txoof/npec-camera-rig/README.md

# NPEC Camera Rig

Plant growth monitoring for an environmental chamber. Runs on a Raspberry Pi 5 with a top-down
Arducam 64MP camera and a Hailo AI accelerator, and serves a web interface directly from the Pi.

## What it does

- Captures the growth table on a schedule (10–60 frames/hour)
- Measures **canopy area** per growth tray
- Tracks **tray identity, position and rotation** via AprilTags
- Reports **how much to trust each measurement**, and refuses to guess when the rig has been moved
- Produces timelapses and CSV exports for experimenters

## Status

**M1 slice 1 (skeleton) done.** See [PLAN.md](PLAN.md) and [TODO.md](TODO.md).

## Setup

Dependencies are managed with [`uv`](https://docs.astral.sh/uv/). The venv must use the system
Python interpreter, not one `uv` downloads itself — `picamera2` is a system package, and
`--system-site-packages` only works if the venv's Python version matches the one it was installed
against.

```bash
uv venv --system-site-packages --python /usr/bin/python3 .venv
uv pip install -e ".[dev]"
```

Use `uv run` for everything after that — no need to activate the venv:

```bash
uv run pytest
uv run uvicorn npec_rig.app:app --reload --reload-dir src --timeout-graceful-shutdown 5 \
    --host 0.0.0.0 --port 8000
```

`--reload-dir src` keeps `WatchFiles` from watching the whole repo tree (it otherwise reloads on
unrelated activity elsewhere in the checkout). `--timeout-graceful-shutdown 5` bounds the
"Waiting for connections to close" reload hang — a browser continuously polling an endpoint (the
live preview, the focus aid) keeps a connection in-flight indefinitely, so the default unbounded
wait never resolves on its own; this caps it at 5 s instead of requiring a manual browser refresh.

Not yet installed as a systemd service — see `deploy/npec-rig.service`.

## Hardware

The rig's printed mounts and OpenSCAD models live in [`hardware/`](hardware/). See
[hardware/README.md](hardware/README.md) for printing the tray tags, the AprilTag corner mounts
(production's outer table edge) and how to export multi-color prints, and [hardware/Installation.md](hardware/Installation.md) for installing the
rig in the chamber.

## The one thing to read before contributing

This project has been attempted three times and collapsed into camera metrology each time — lens
models, distortion coefficients, uncertainty propagation — without ever producing a working
application.

The governing principle is in PLAN.md and it is short:

> **Certainty is measured, never derived.** If a number can't be demonstrated with a ruler, a
> printed target, or a repeated observation, it doesn't ship.

Techniques like intrinsic calibration and orthorectification aren't forbidden because they're
unsound. They're deferred behind **evidence gates** — each has a specific measurement that would
justify picking it up. Read that section before proposing one.

A worked example of why this matters, from the previous attempt's own calibration data:

| Error source | Magnitude in area |
|---|---|
| Believing the old rig's tags were the 30 mm printed on the box (they measured 29.31 mm) | **~4.7%** |
| Tag corner-finding precision | ~0.15% |
| Segmentation edge ambiguity | several % |

The largest geometric error in the system was solved with a pair of callipers. The lesson is
"measure each printed sheet", not "tags are 29.31 mm": the current sheets measure 30.0 mm.

## Testing

The fast tier is the default and the expensive tiers are opt-in, by construction:

```bash
pytest                 # unit only — no hardware, budget <10s
pytest -m hardware     # needs the camera
pytest -m hailo        # needs the accelerator
pytest -m integration  # full pipeline against fixture images
pytest -m slow         # soak
```

**Do not run tests for documentation changes.** The previous attempt spent 223 seconds of every
303-second run decoding 64MP frames. See the test-tier table in PLAN.md for what to run when.
