txoof/npec-camera-rig/docs/figures/16.8/tray6-miss-100253.jpg

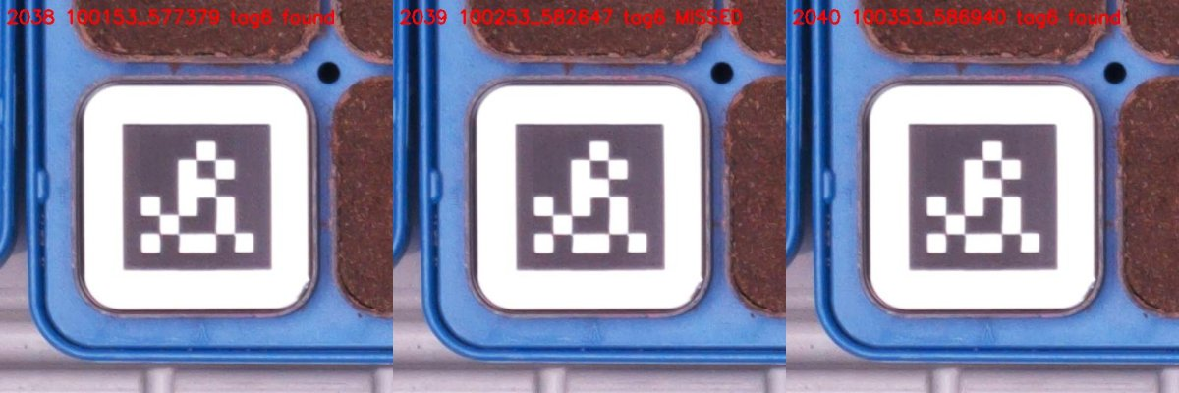
docs/figures/16.8/tray6-miss-100253.jpg
