txoof/npec-camera-rig/docs/figures/17.12/084953-tags.jpg

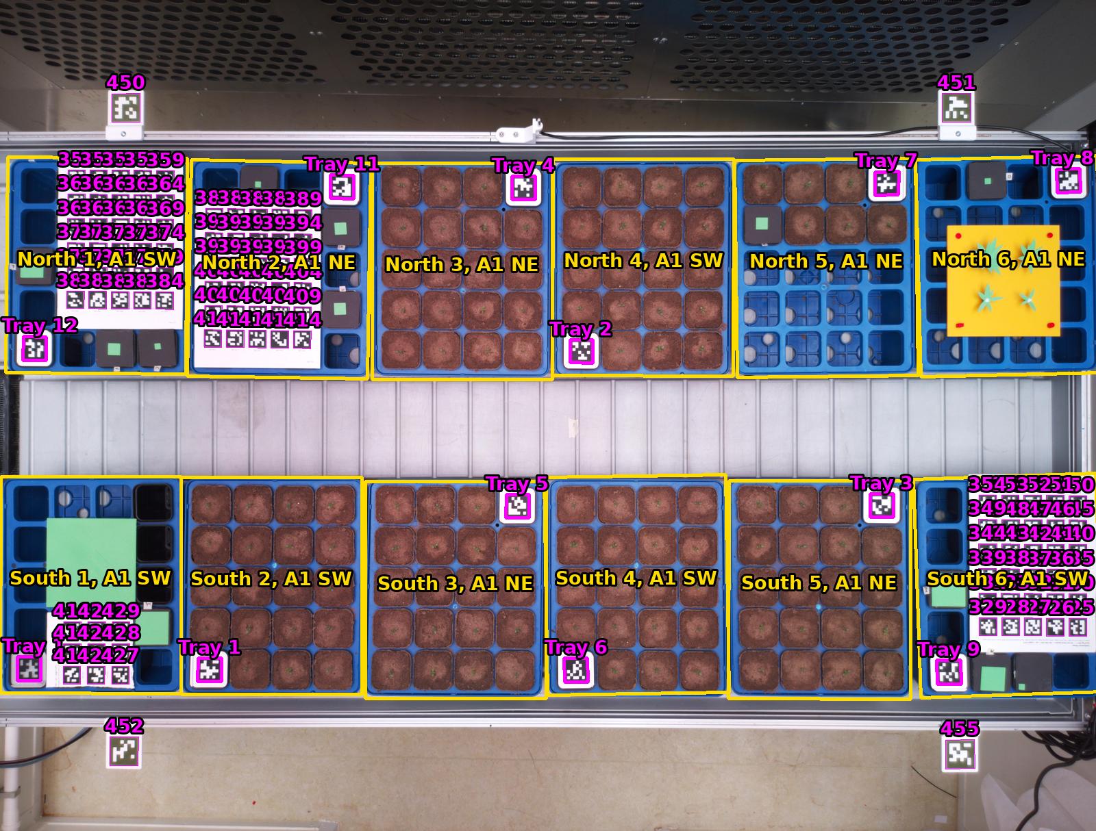
docs/figures/17.12/084953-tags.jpg
