txoof/npec-camera-rig/docs/figures/17.12/095753-tags.jpg

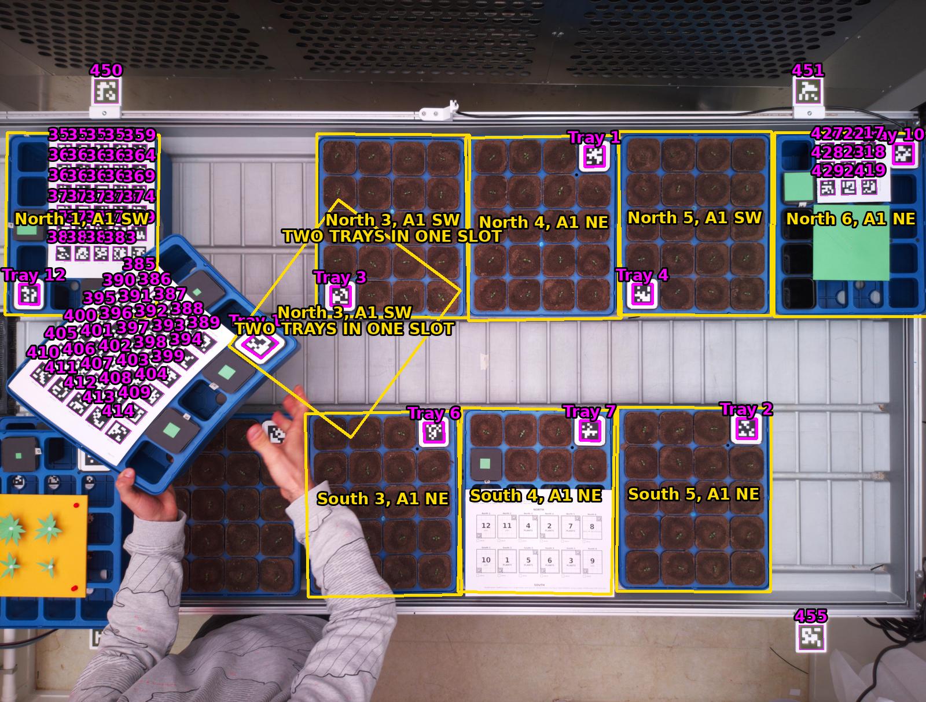
docs/figures/17.12/095753-tags.jpg
