txoof/npec-camera-rig/docs/figures/17.13/142a6558-corners-beads.jpg

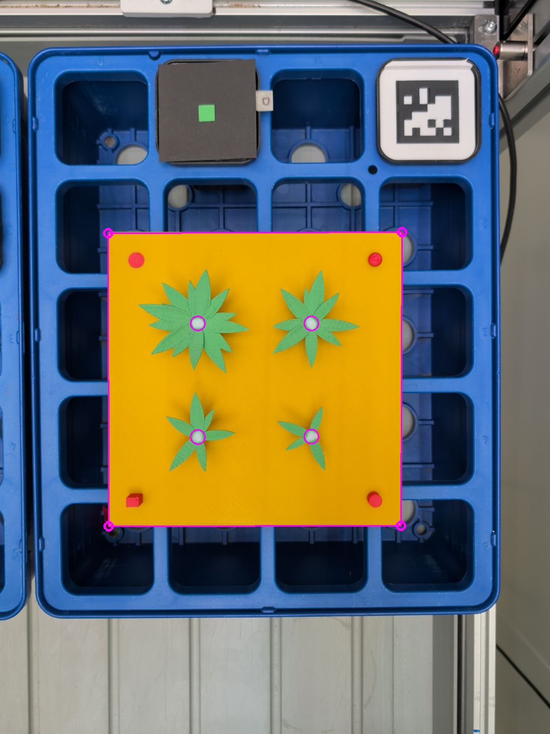
docs/figures/17.13/142a6558-corners-beads.jpg
