txoof/npec-camera-rig/docs/figures/17.13/baee65e4-corners-beads.jpg

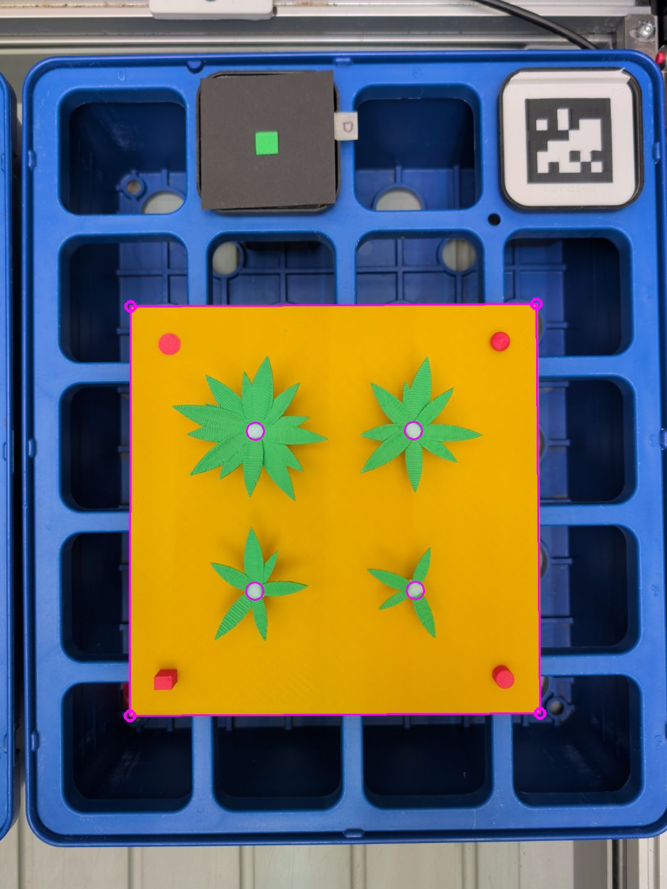
docs/figures/17.13/baee65e4-corners-beads.jpg
