txoof/npec-camera-rig/docs/figures/18/squares-open-crops.jpg

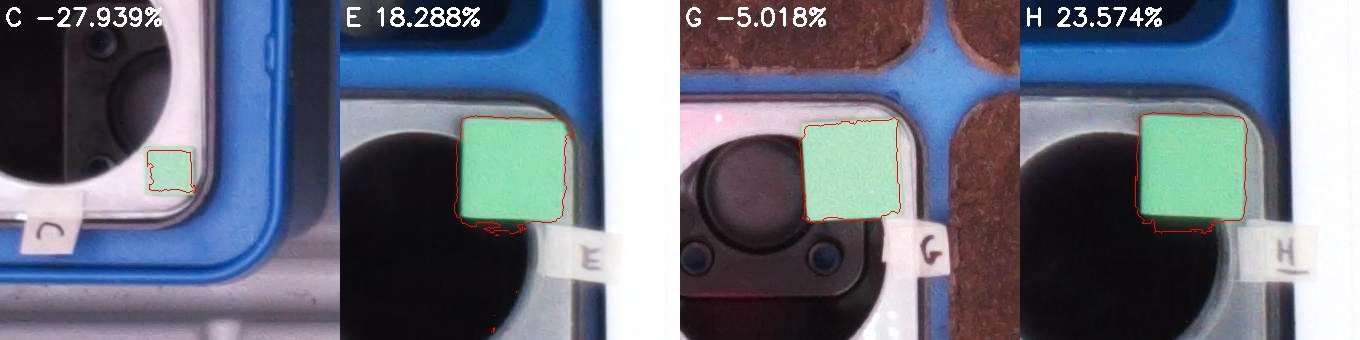
docs/figures/18/squares-open-crops.jpg
