txoof/npec-camera-rig/docs/figures/18/squares-paper-crops.jpg

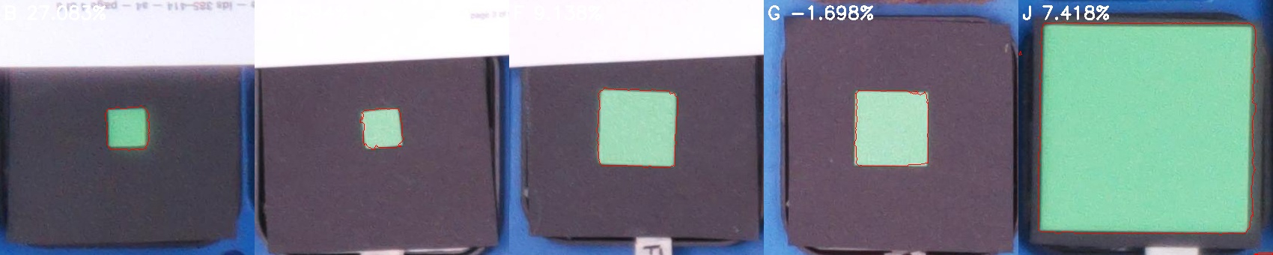
docs/figures/18/squares-paper-crops.jpg
