txoof/npec-camera-rig/docs/figures/18/tag-edges-against-spacing.png

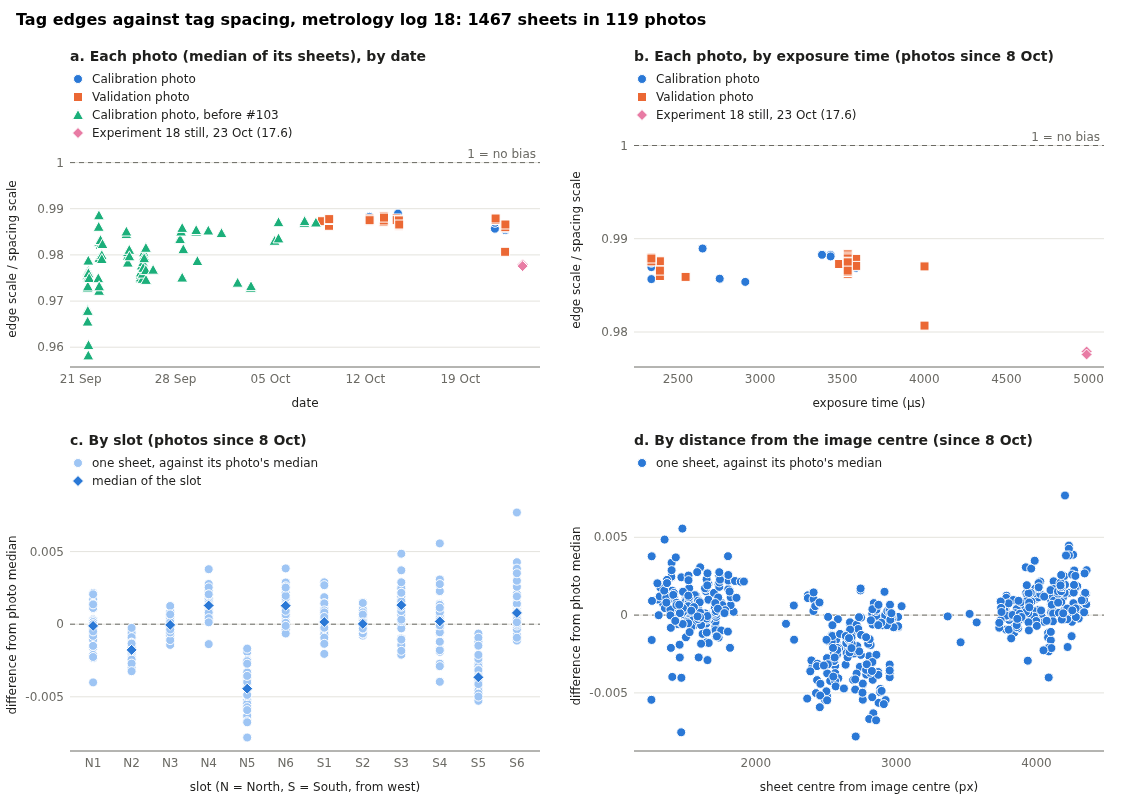
docs/figures/18/tag-edges-against-spacing.png
