txoof/npec-camera-rig/docs/figures/18/target-edges-2026-10-23.png

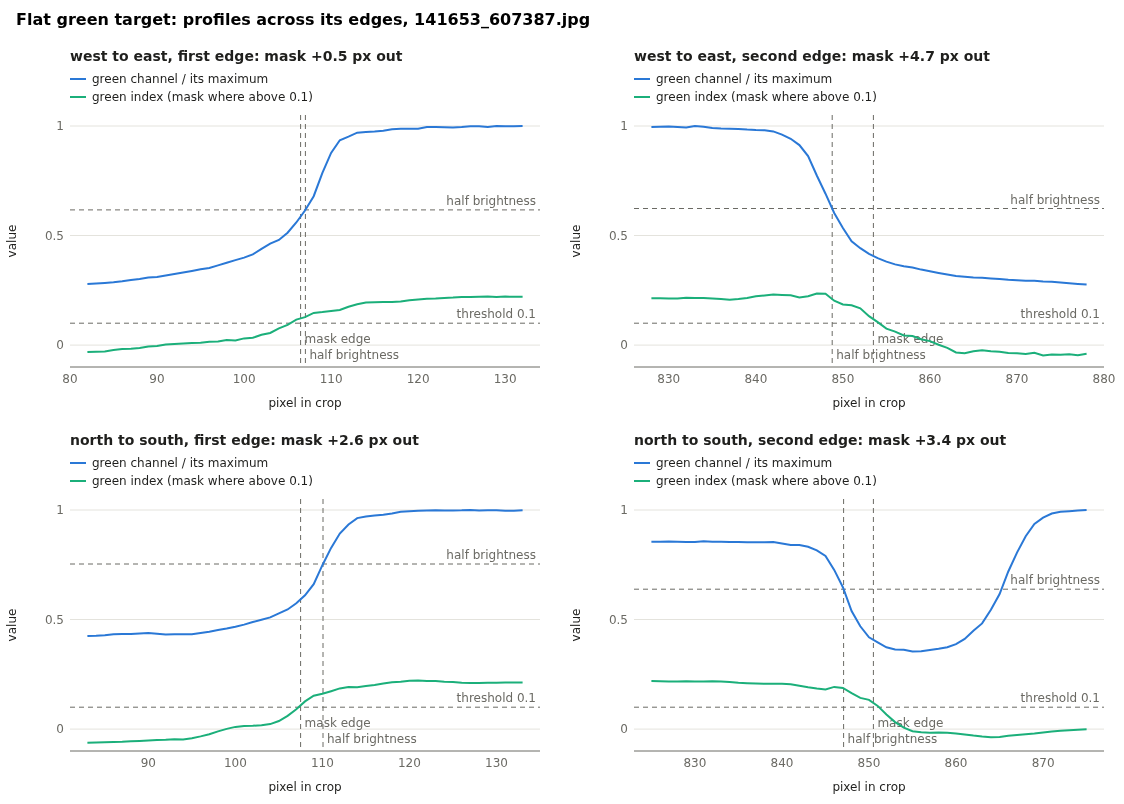
docs/figures/18/target-edges-2026-10-23.png
