txoof/npec-camera-rig/docs/figures/19.1/benchy-sam21.jpg

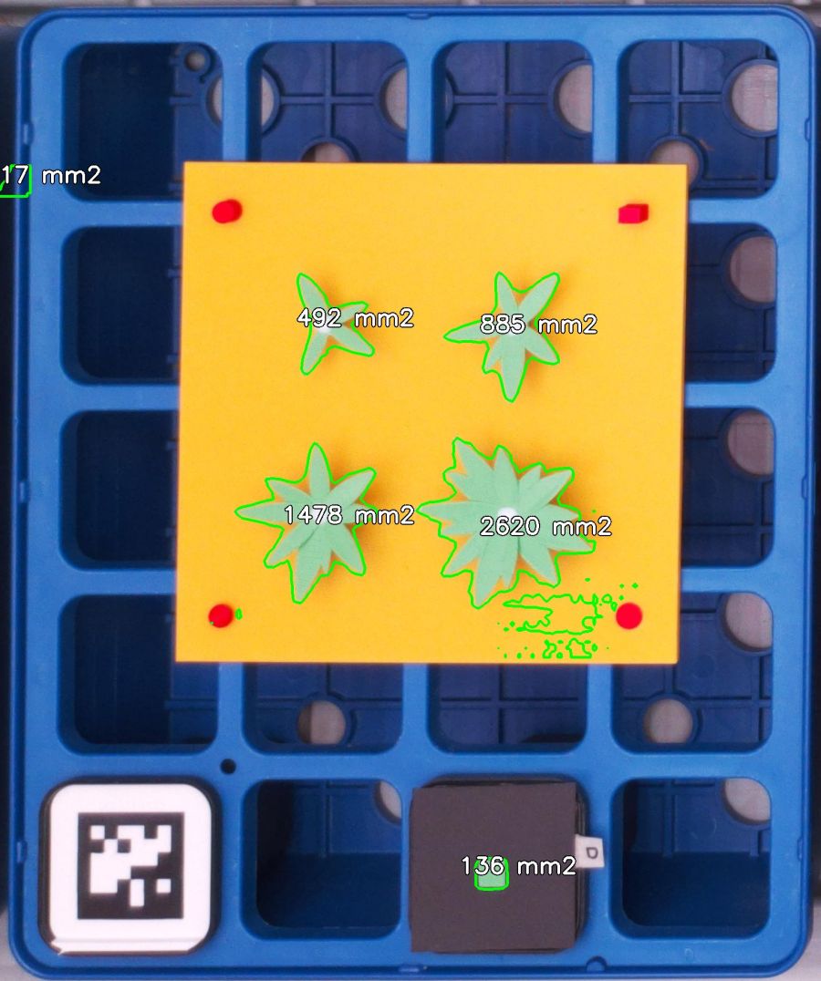
docs/figures/19.1/benchy-sam21.jpg
