txoof/npec-camera-rig/docs/figures/19.1/clip-leaves.jpg

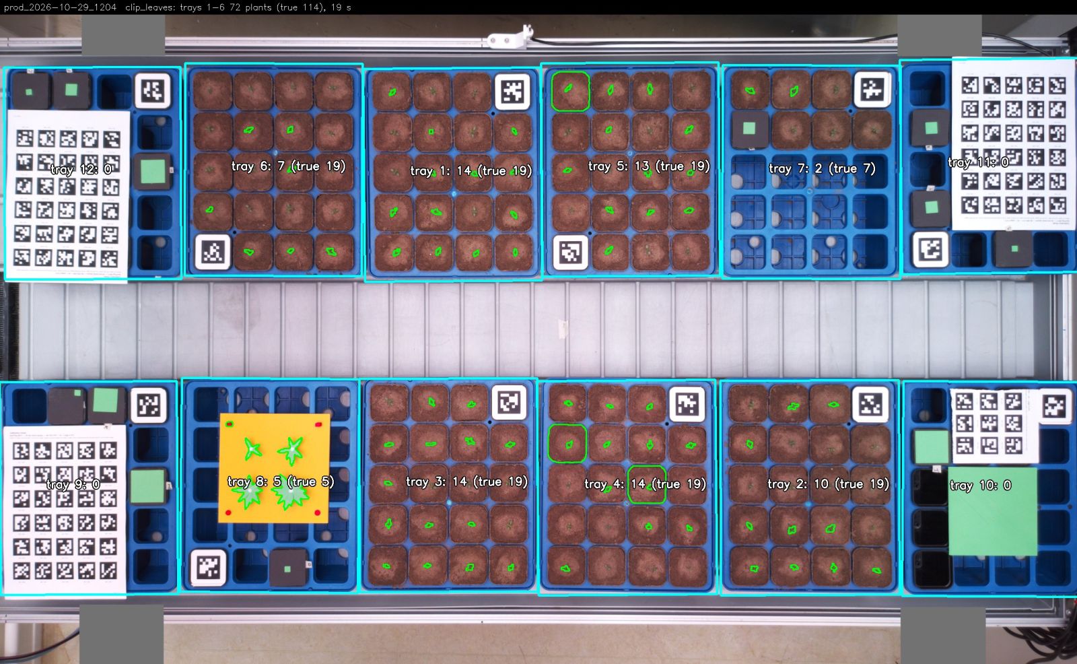
docs/figures/19.1/clip-leaves.jpg
