txoof/npec-camera-rig/docs/figures/19.3/dev-2x2-exg-join10.jpg

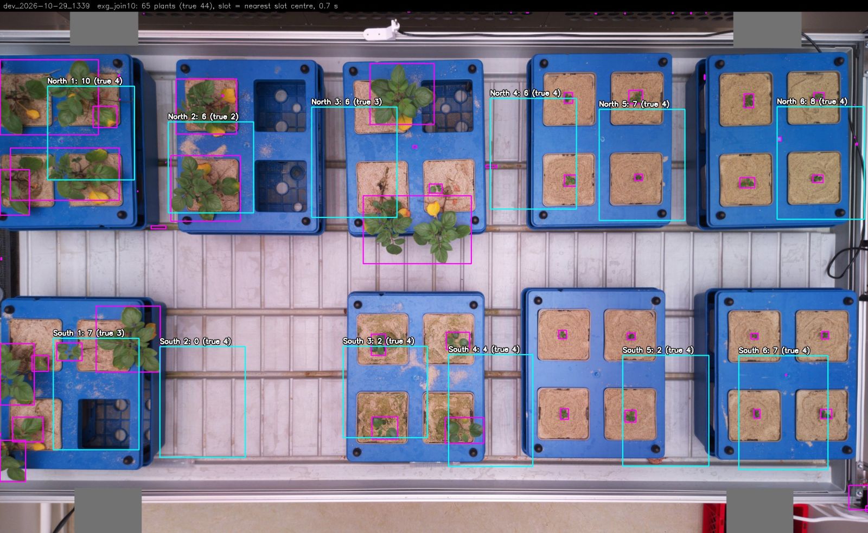
docs/figures/19.3/dev-2x2-exg-join10.jpg
