txoof/npec-camera-rig/docs/figures/20.1/held-09-prod_44a9e96e_20261015_120350_220119.jpg

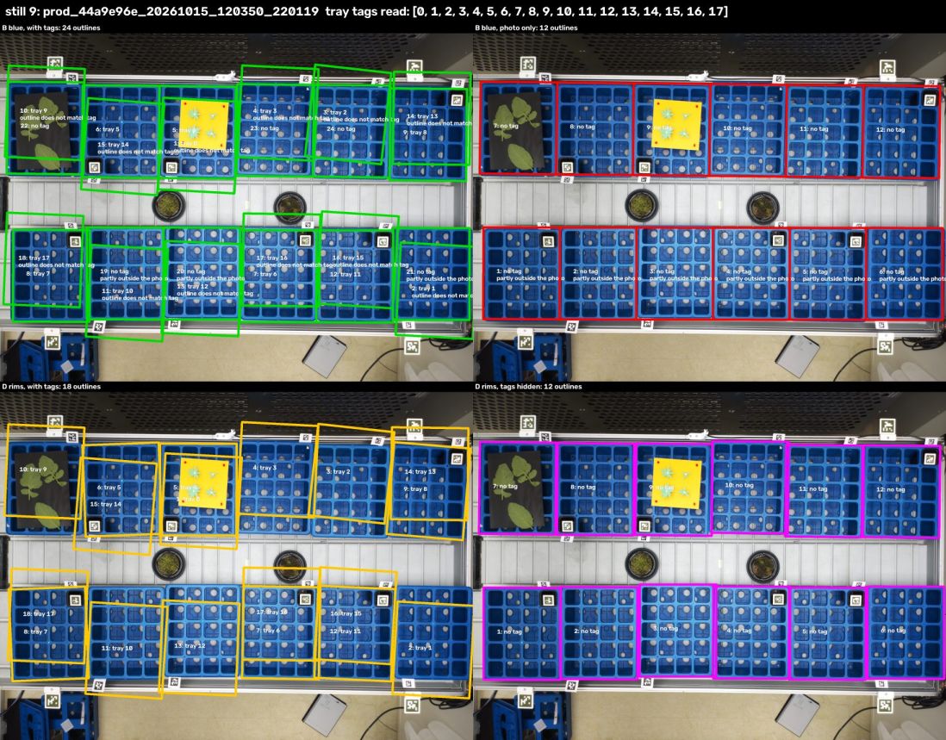
docs/figures/20.1/held-09-prod_44a9e96e_20261015_120350_220119.jpg
