txoof/npec-camera-rig/docs/figures/20.1/held-14-prod_631bb6b5_20261012_133117_986053.jpg

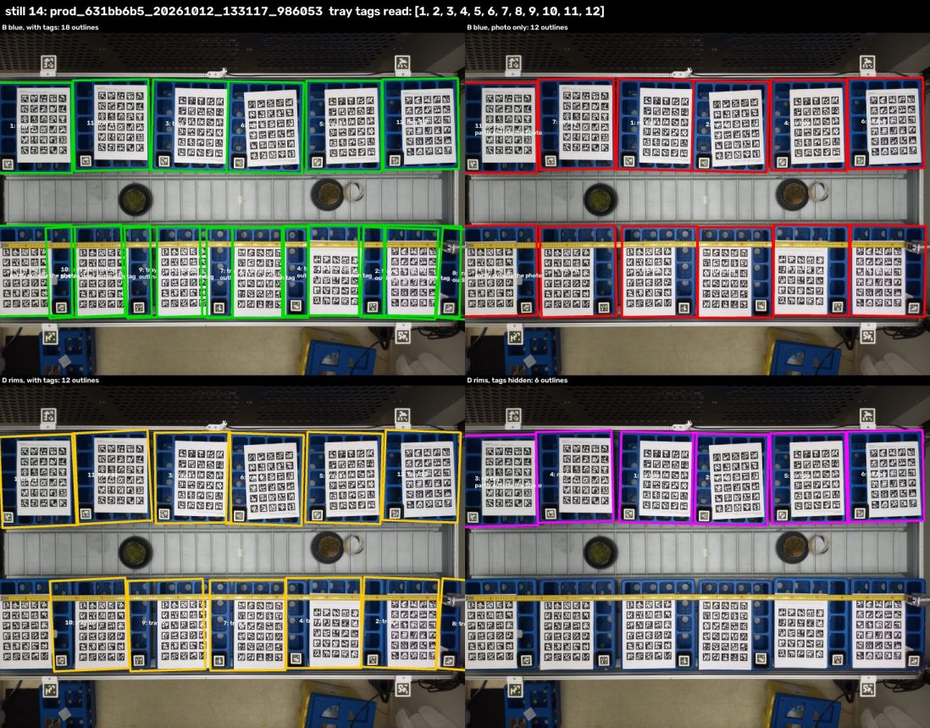
docs/figures/20.1/held-14-prod_631bb6b5_20261012_133117_986053.jpg
