txoof/npec-camera-rig/docs/figures/20/sheet-hard-121231_081714.jpg

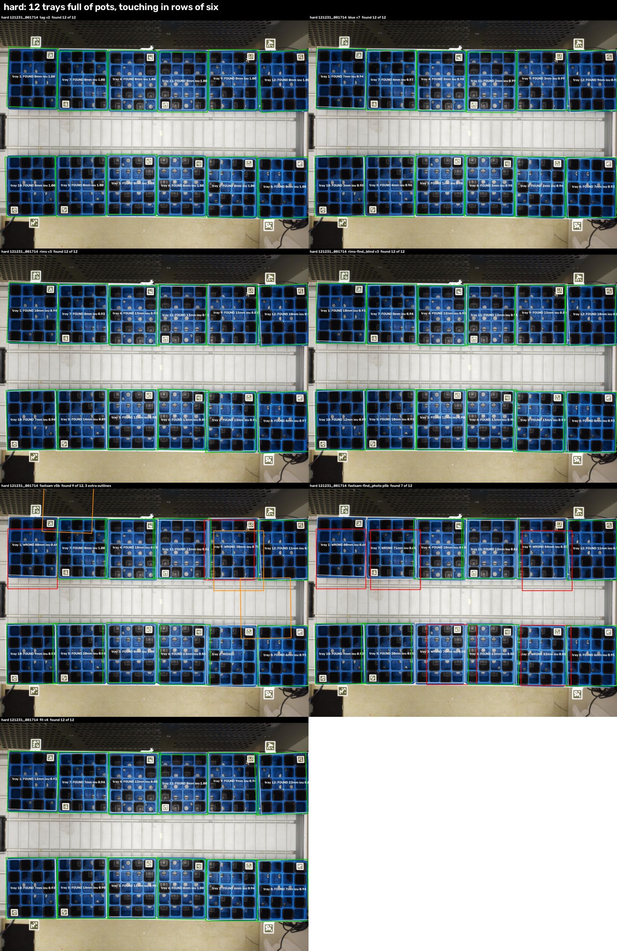
docs/figures/20/sheet-hard-121231_081714.jpg
