txoof/npec-camera-rig/docs/figures/21/dimming-false-outline.jpg

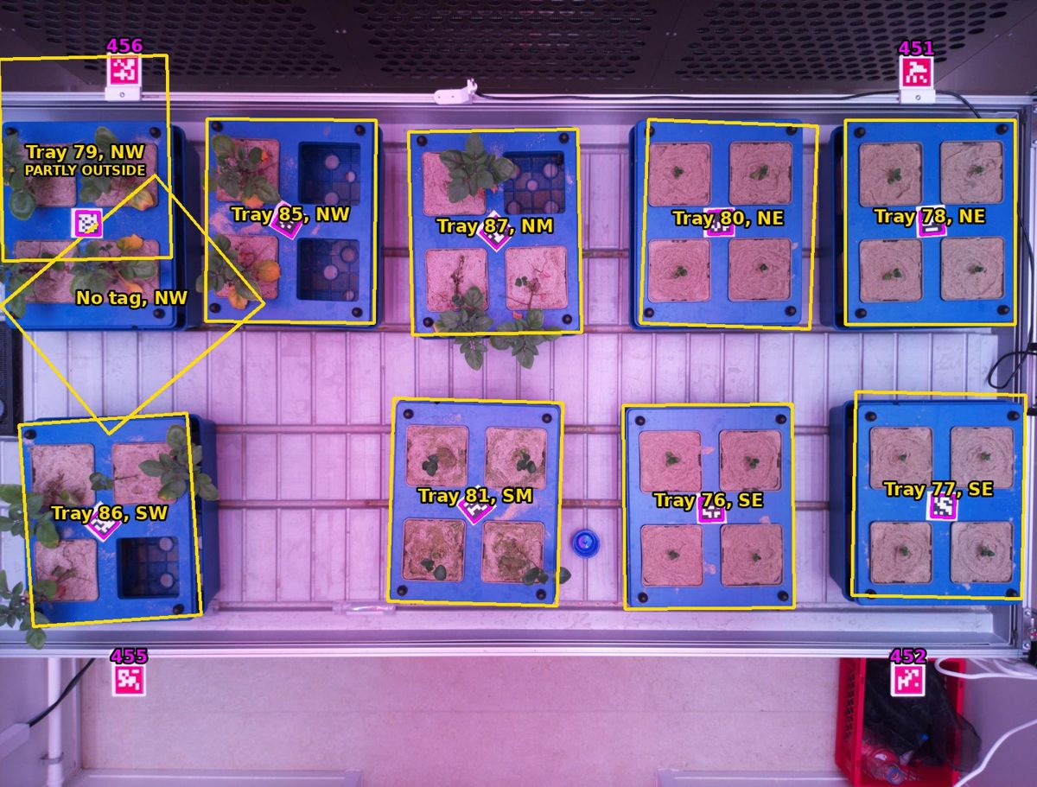
docs/figures/21/dimming-false-outline.jpg
