txoof/npec-camera-rig/docs/figures/21/edge-tags-seen.jpg

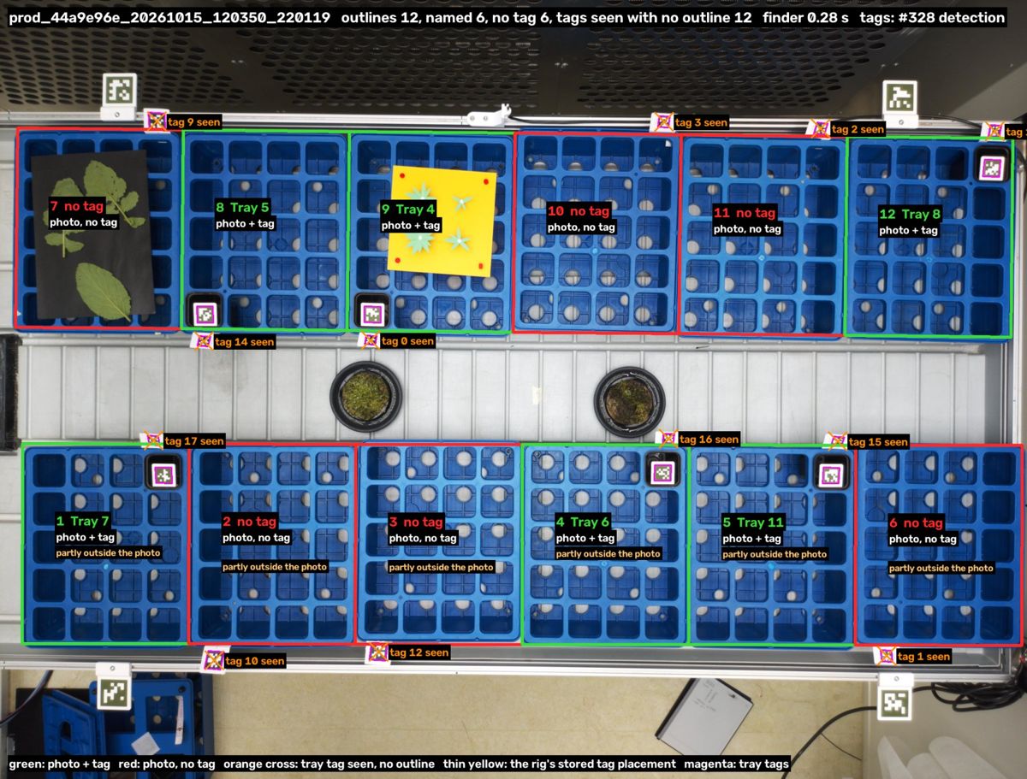
docs/figures/21/edge-tags-seen.jpg
