txoof/npec-camera-rig/docs/figures/21/false-outline-aisle.jpg

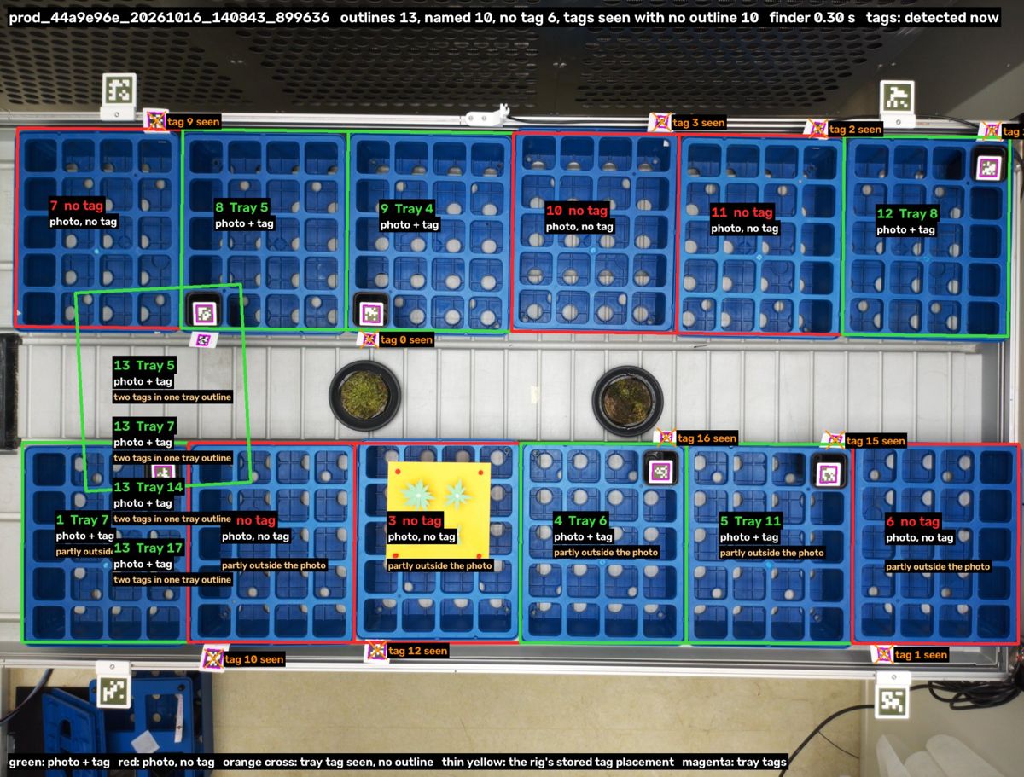
docs/figures/21/false-outline-aisle.jpg
