txoof/npec-camera-rig/docs/figures/21/live-person-over-tray-86.jpg

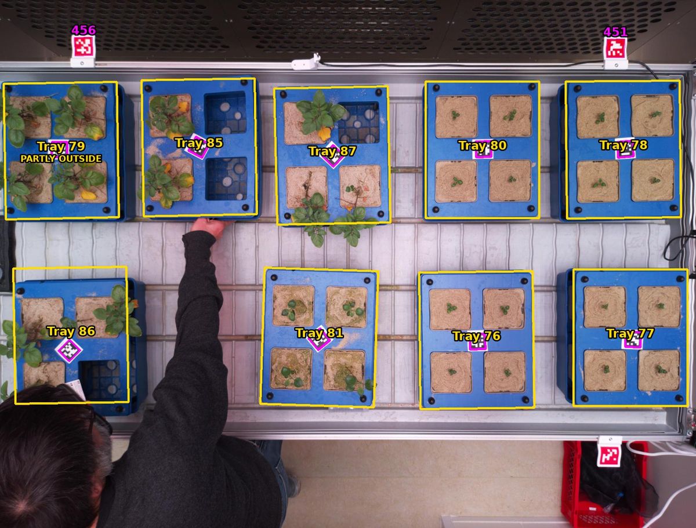
docs/figures/21/live-person-over-tray-86.jpg
