txoof/npec-camera-rig/docs/figures/21/prod-agrees.jpg

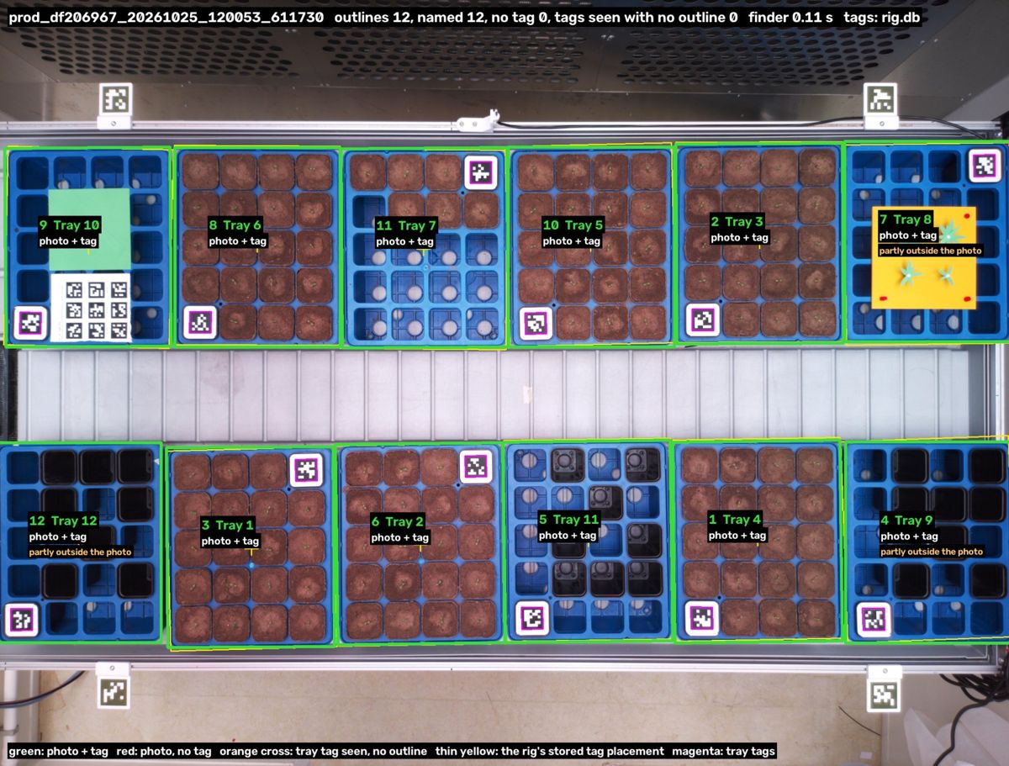
docs/figures/21/prod-agrees.jpg
