txoof/npec-camera-rig/docs/figures/22/areas_on_photo.png

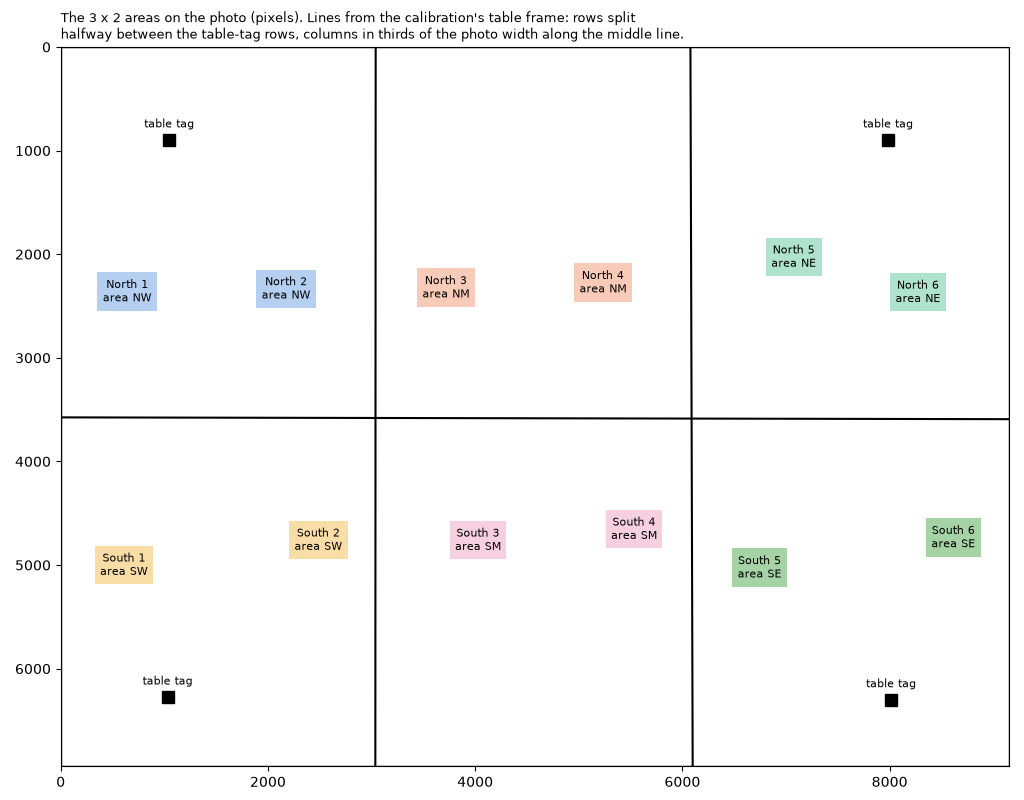
docs/figures/22/areas_on_photo.png
