txoof/npec-camera-rig/docs/figures/22/comparison.png

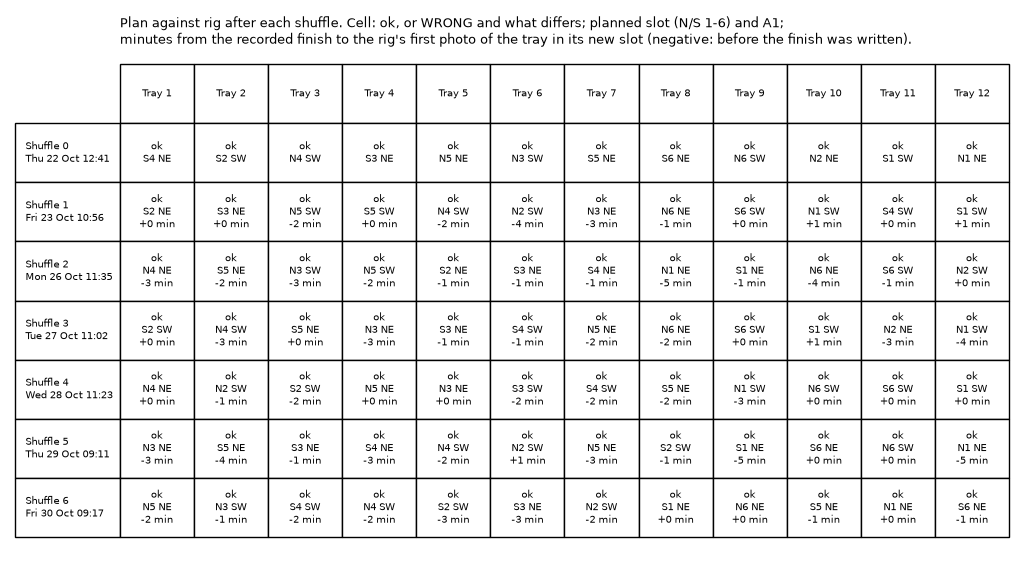
docs/figures/22/comparison.png
