txoof/npec-camera-rig/docs/figures/22/timelines_trays_1-6.png

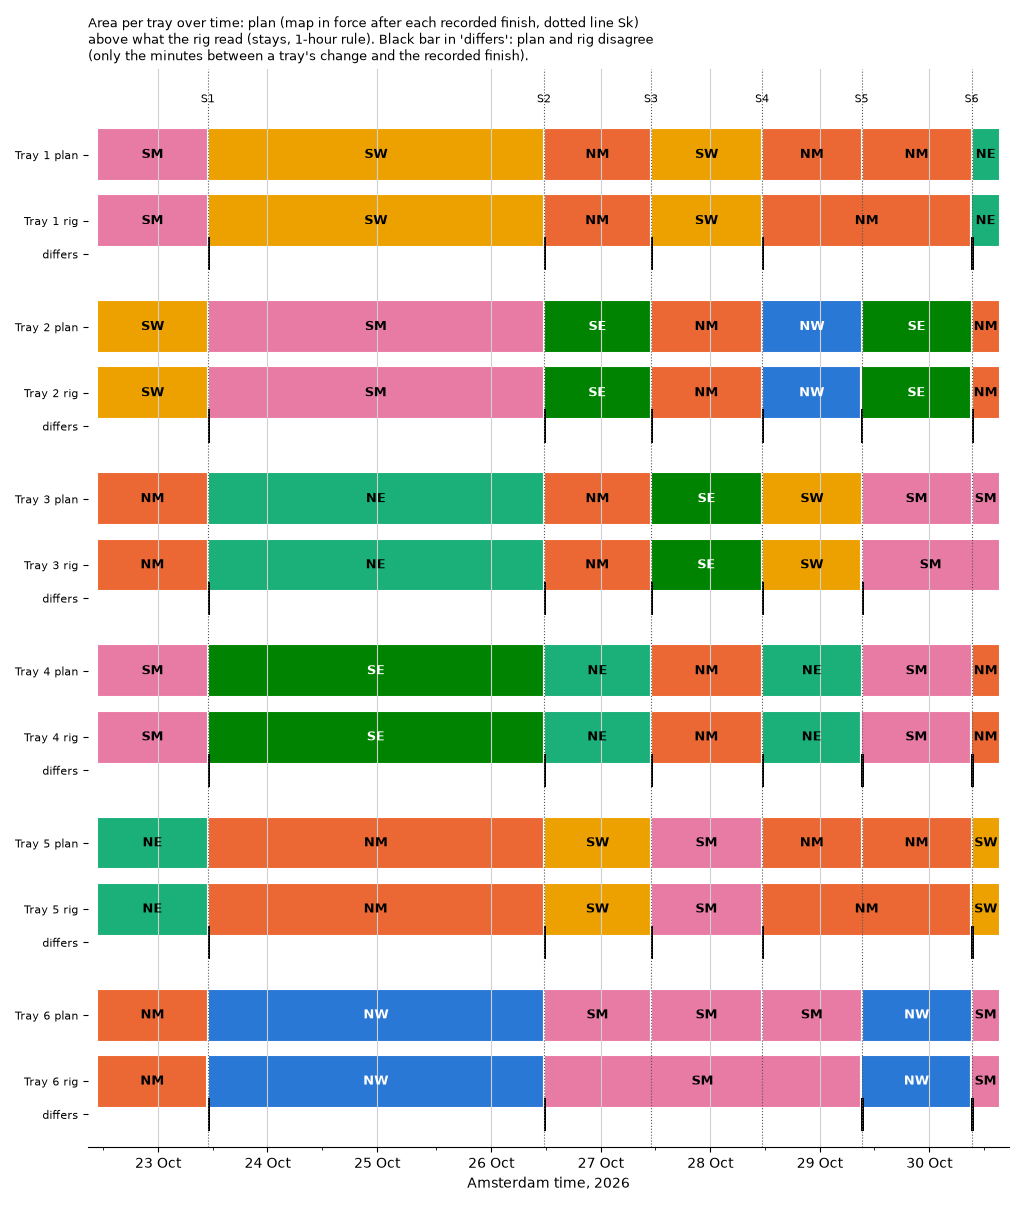
docs/figures/22/timelines_trays_1-6.png
