txoof/npec-camera-rig/docs/figures/22/timelines_trays_7-12.png

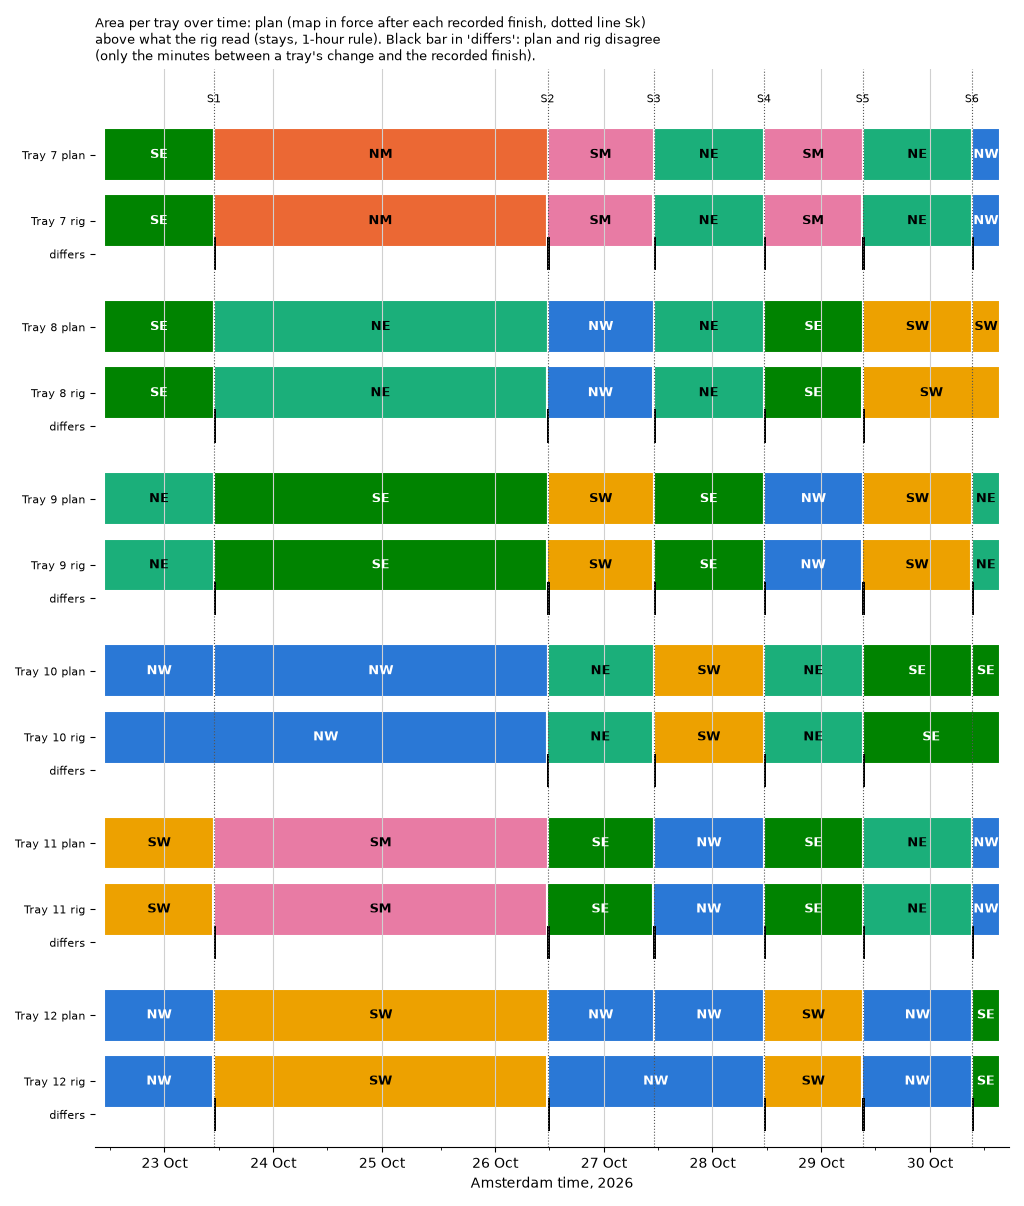
docs/figures/22/timelines_trays_7-12.png
