txoof/npec-camera-rig/docs/figures/24.1/fixed-low-cutoff-tray1.jpg

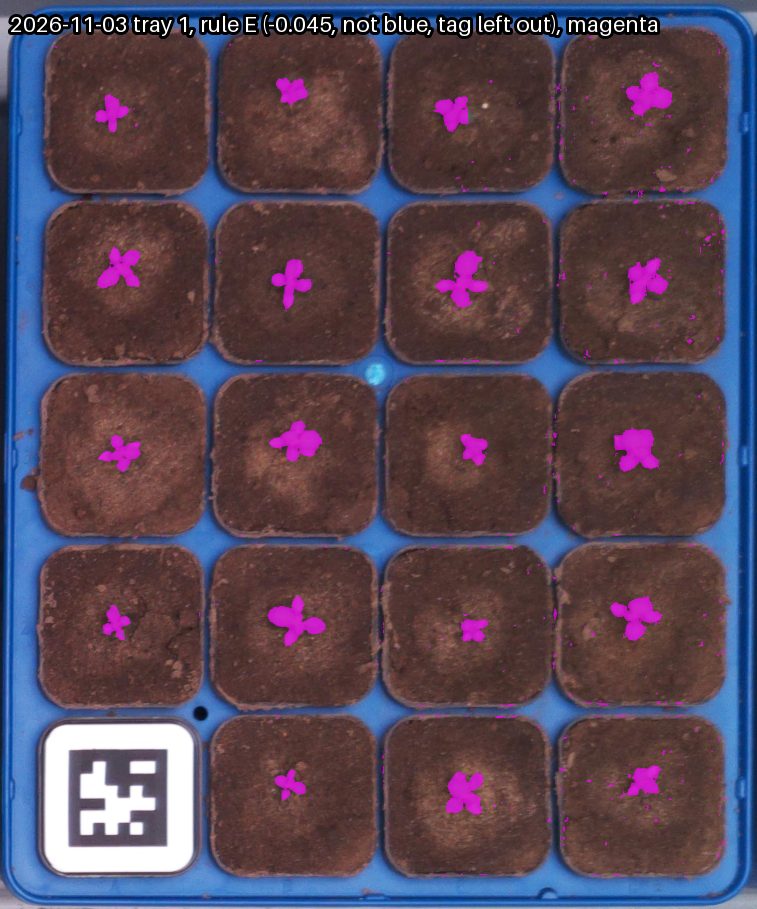
docs/figures/24.1/fixed-low-cutoff-tray1.jpg
