txoof/npec-camera-rig/docs/figures/24.2/grow-from-cores-tray3.jpg

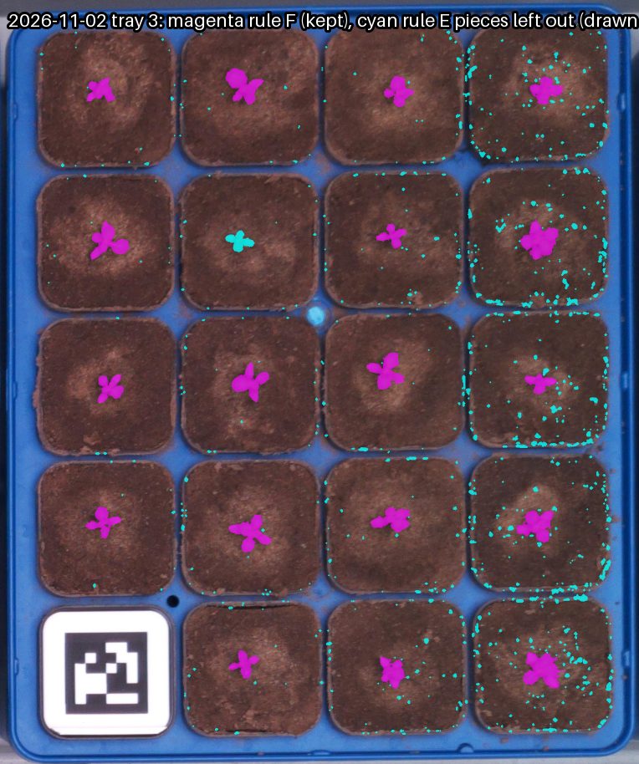
docs/figures/24.2/grow-from-cores-tray3.jpg
