txoof/npec-camera-rig/docs/figures/24.2/tray3-plants-numbered.jpg

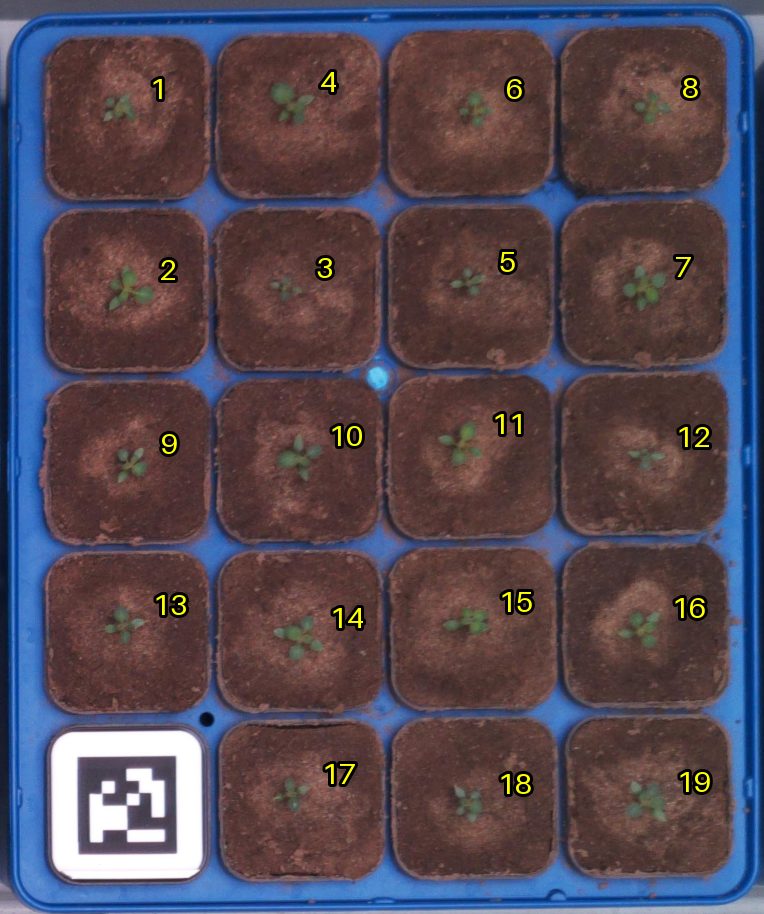
docs/figures/24.2/tray3-plants-numbered.jpg
