txoof/npec-camera-rig/docs/figures/24.3/lost-regions.jpg

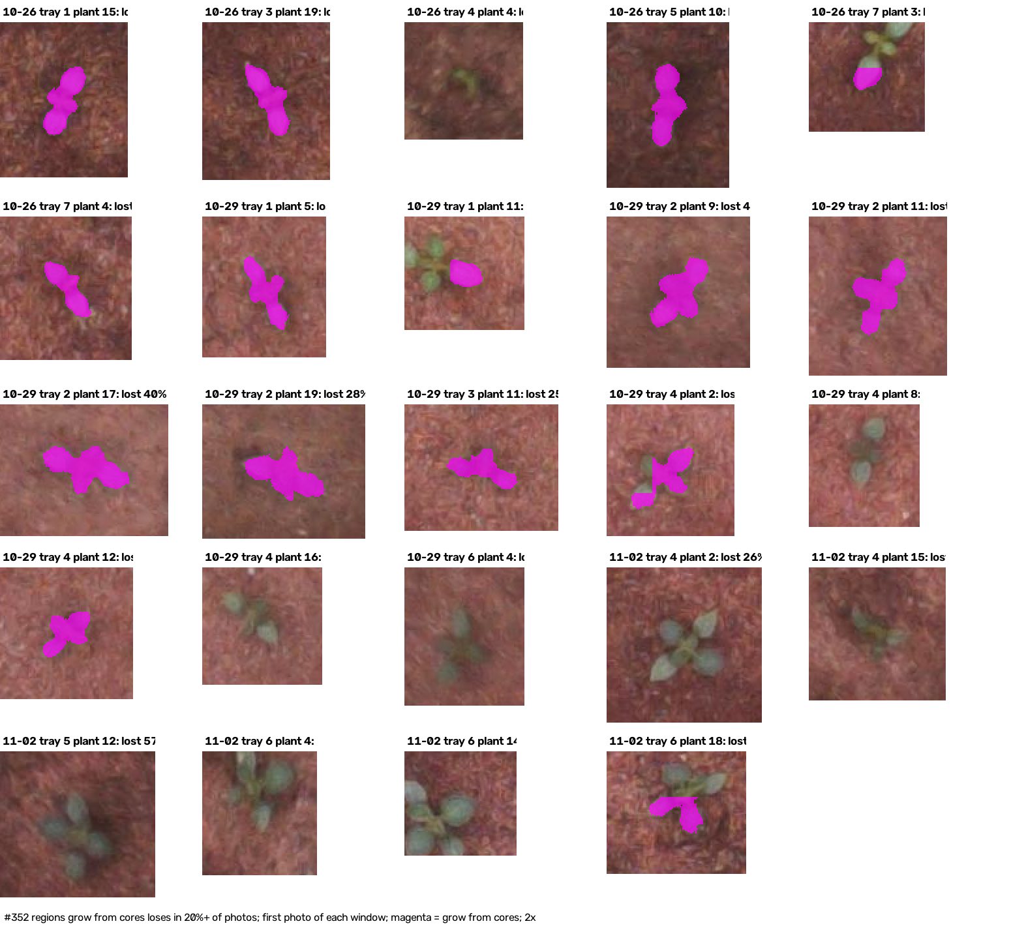
docs/figures/24.3/lost-regions.jpg
