txoof/npec-camera-rig/docs/figures/24.4/tray7-before-after.jpg

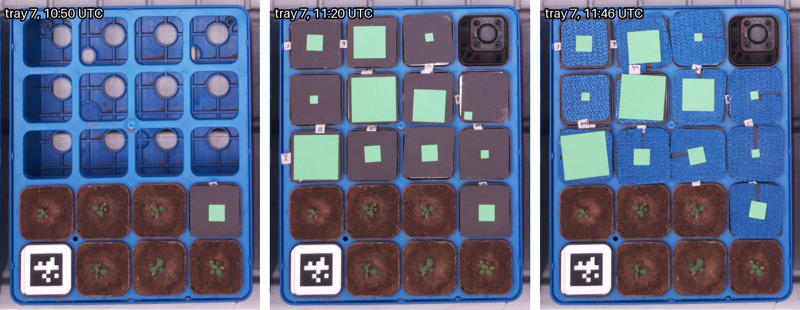
docs/figures/24.4/tray7-before-after.jpg
