txoof/npec-camera-rig/docs/figures/24.5/sam-vs-grow.jpg

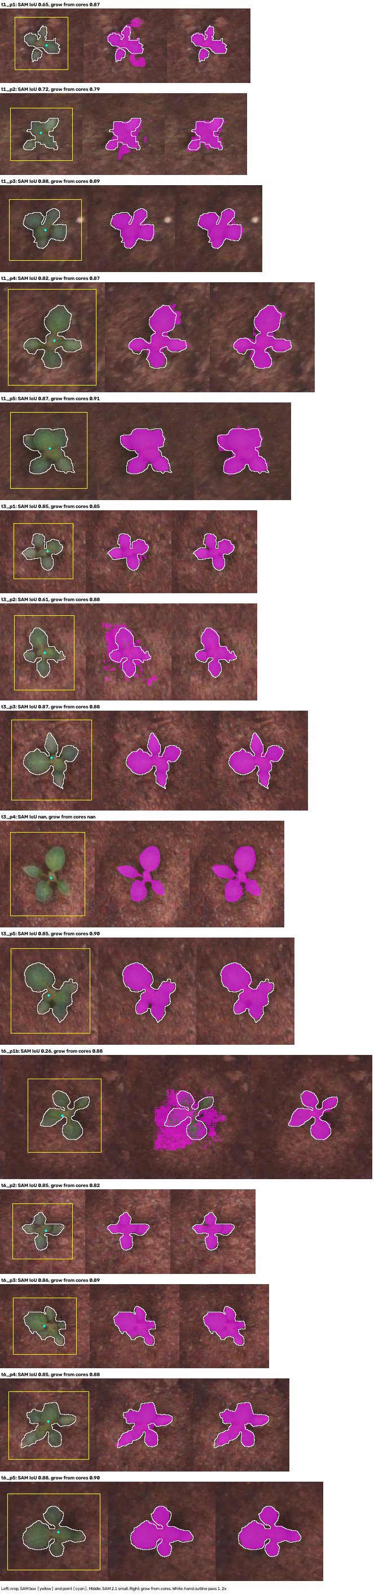
docs/figures/24.5/sam-vs-grow.jpg
