txoof/npec-camera-rig/docs/figures/24.6/tray87-grow-diff.jpg

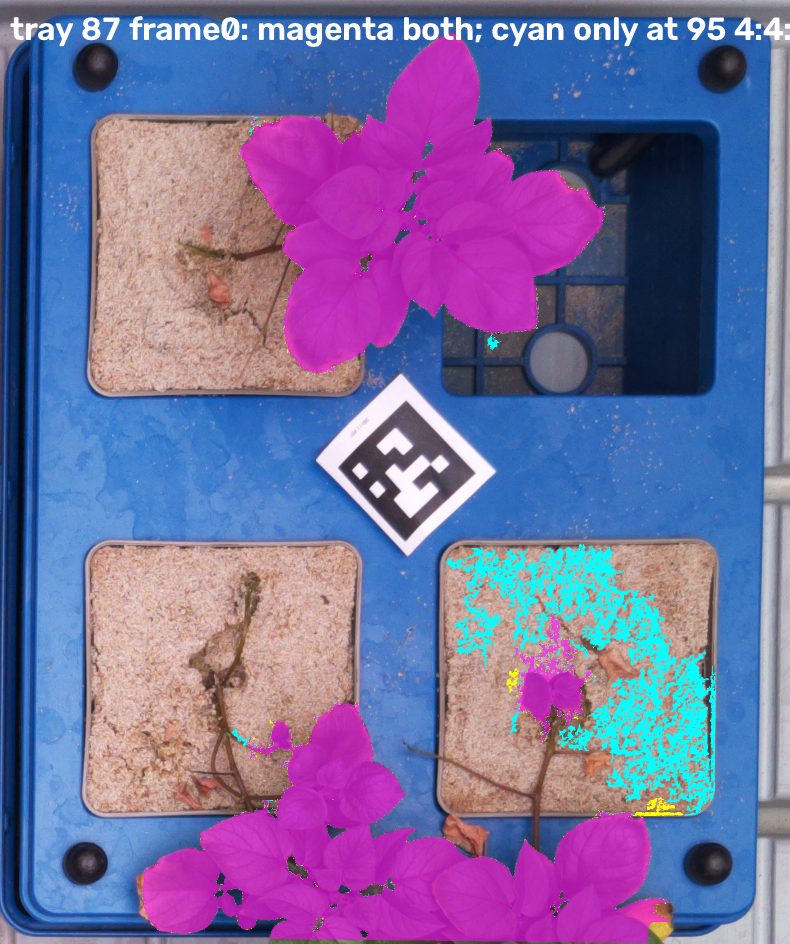
docs/figures/24.6/tray87-grow-diff.jpg
