txoof/npec-camera-rig/docs/figures/24.7/dev-grow-vs-rule-g.jpg

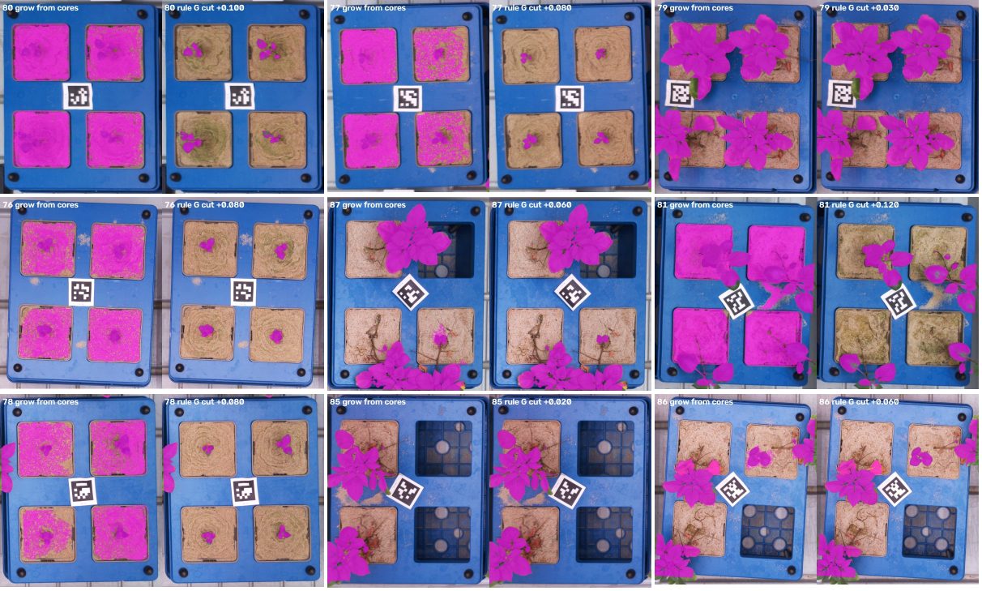
docs/figures/24.7/dev-grow-vs-rule-g.jpg
