txoof/npec-camera-rig/docs/figures/24/rules-sheet-1.jpg

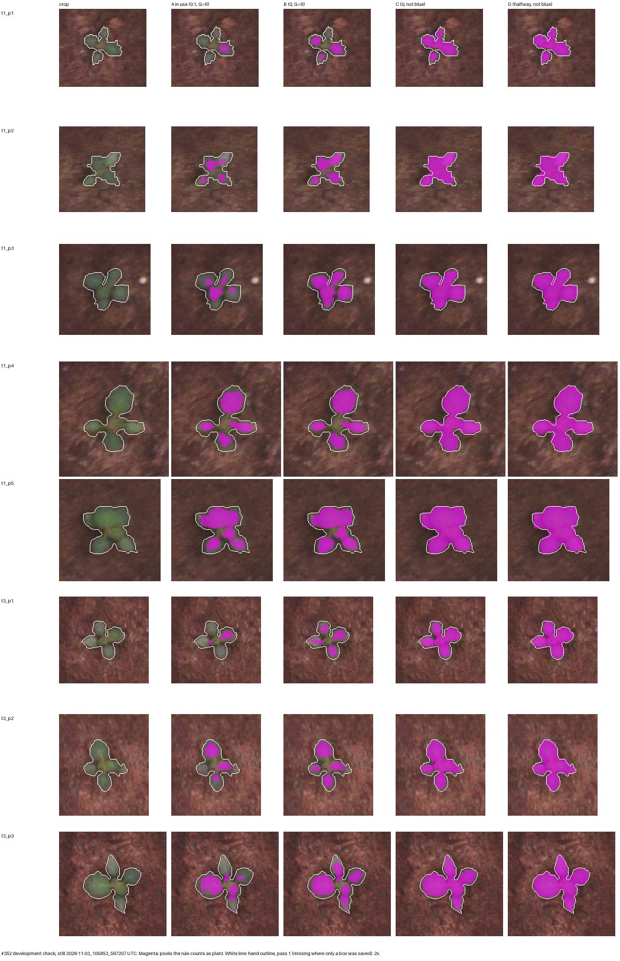
docs/figures/24/rules-sheet-1.jpg
