txoof/npec-camera-rig/docs/figures/24/rules-sheet-2.jpg

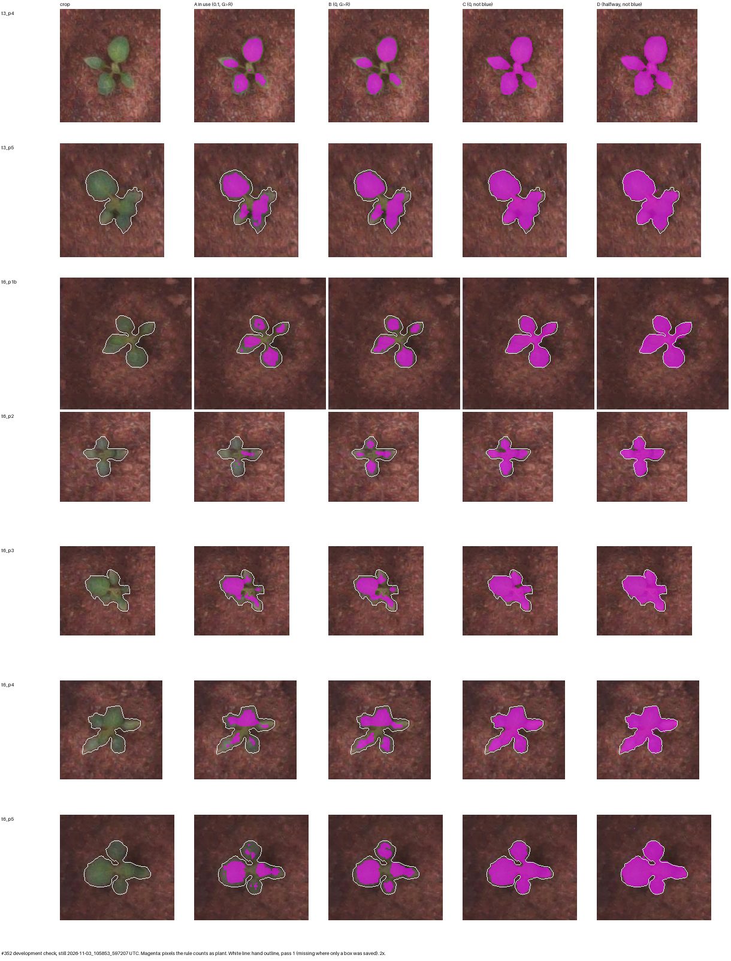
docs/figures/24/rules-sheet-2.jpg
