txoof/npec-camera-rig/docs/figures/26/crop-tray77.png

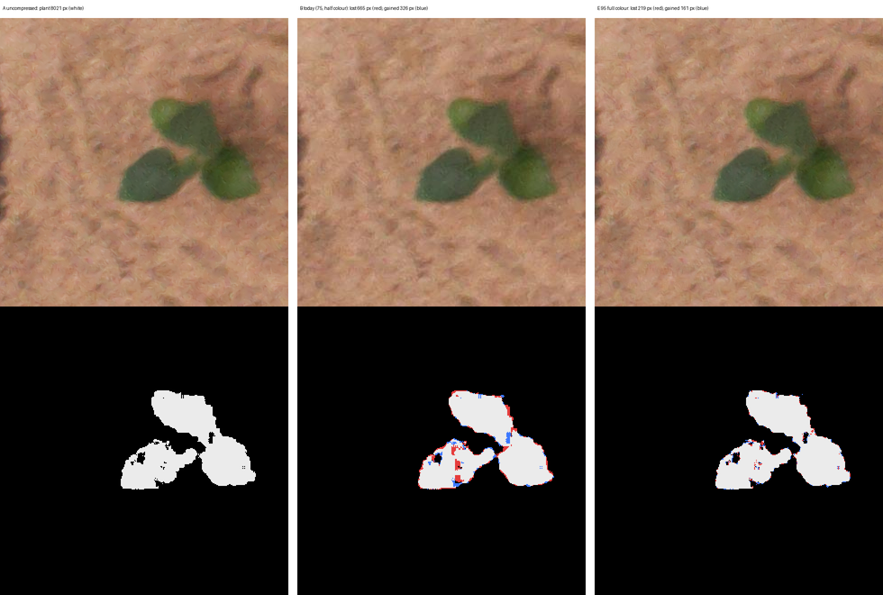
docs/figures/26/crop-tray77.png
