txoof/npec-camera-rig/docs/figures/27.4/dev-cells-placed.jpg

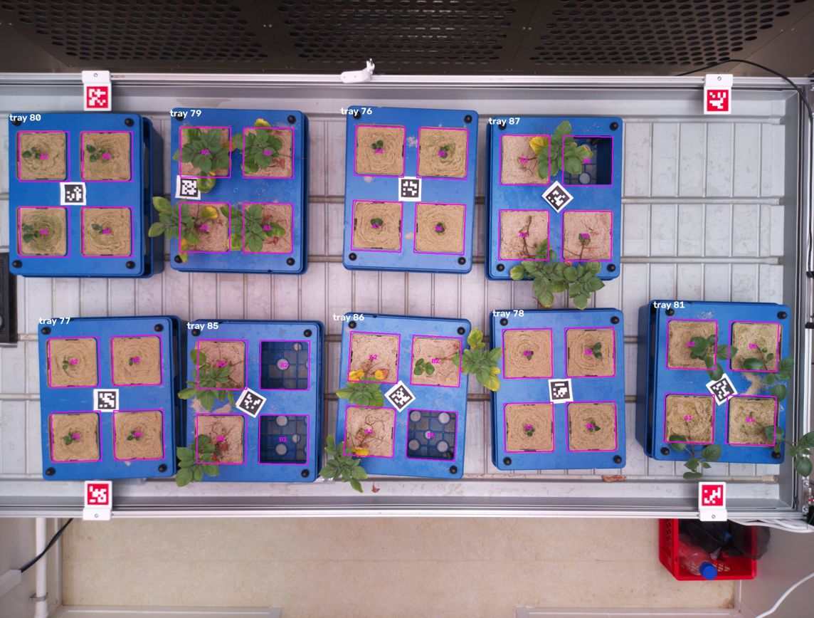
docs/figures/27.4/dev-cells-placed.jpg
