txoof/npec-camera-rig/docs/figures/27.4/prod-cells-placed.jpg

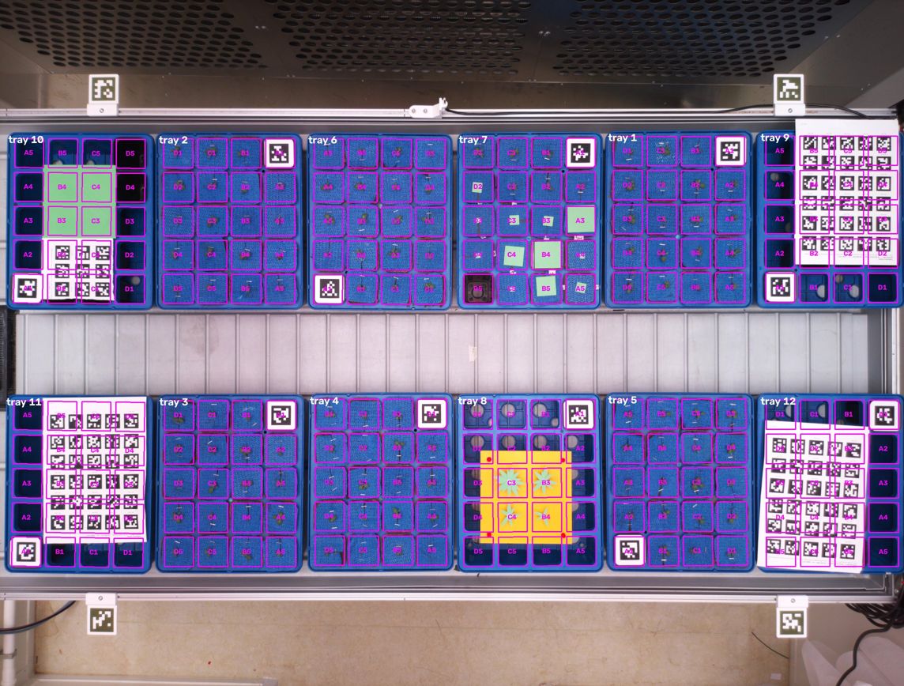
docs/figures/27.4/prod-cells-placed.jpg
