txoof/npec-camera-rig/docs/figures/28/empty-cell-fringe.png

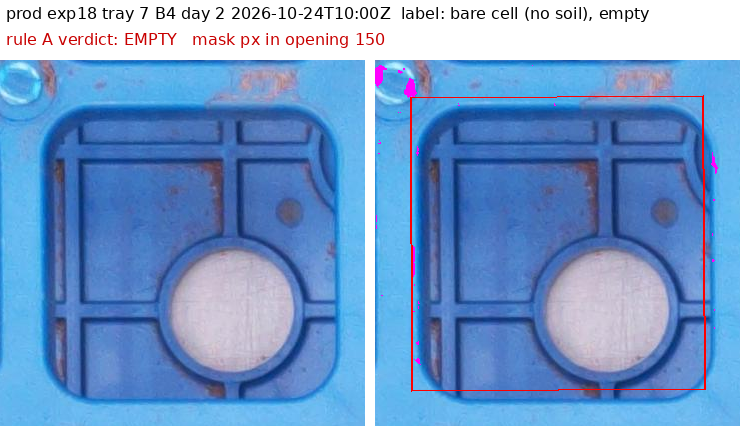
docs/figures/28/empty-cell-fringe.png
