txoof/npec-camera-rig/docs/figures/28/pieces-blue-green.png

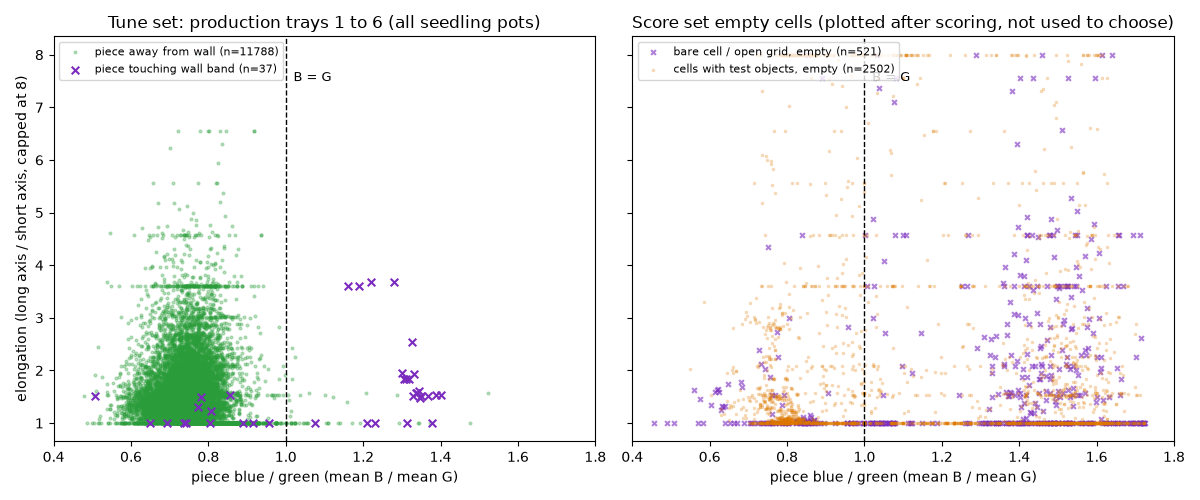
docs/figures/28/pieces-blue-green.png
