txoof/npec-camera-rig/docs/figures/29/29.2-corner-tags.png

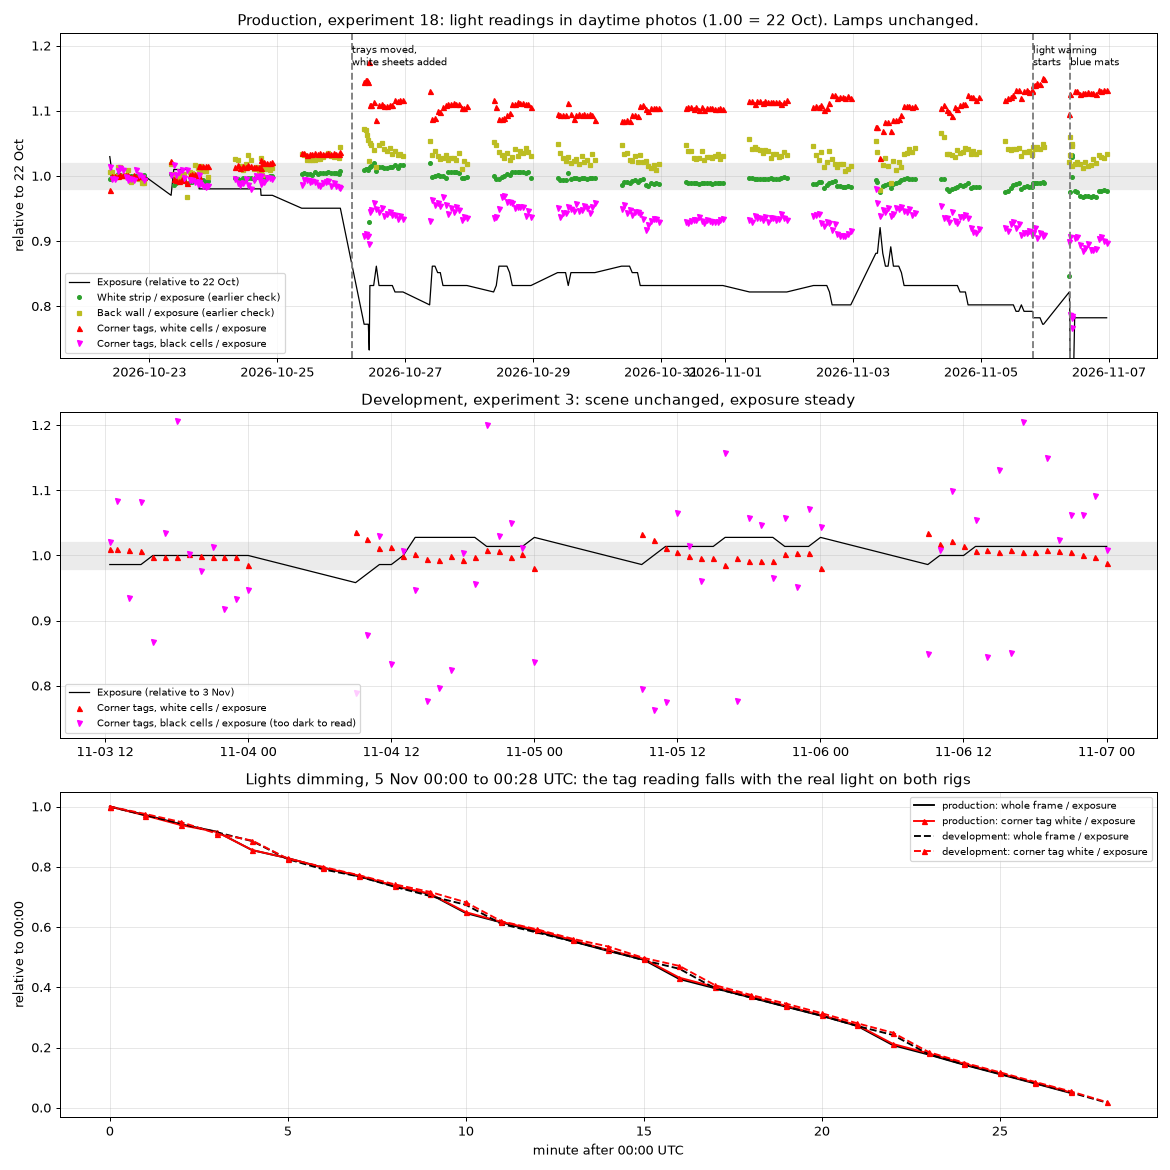
docs/figures/29/29.2-corner-tags.png
