txoof/npec-camera-rig/docs/figures/30/pot-names-trays-81-86.jpg

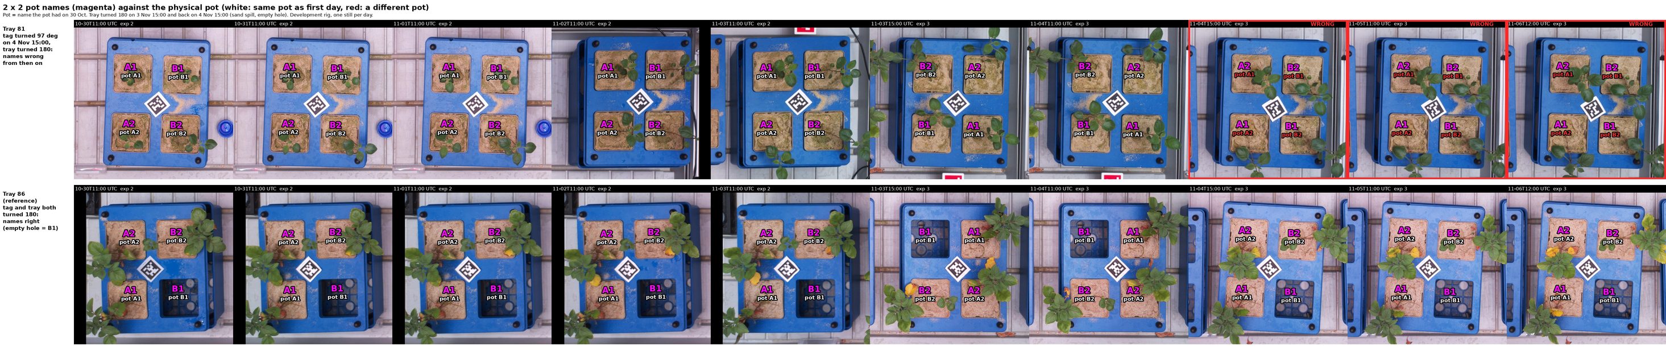
docs/figures/30/pot-names-trays-81-86.jpg
