txoof/npec-camera-rig/docs/figures/32/tray86-before-after.jpg

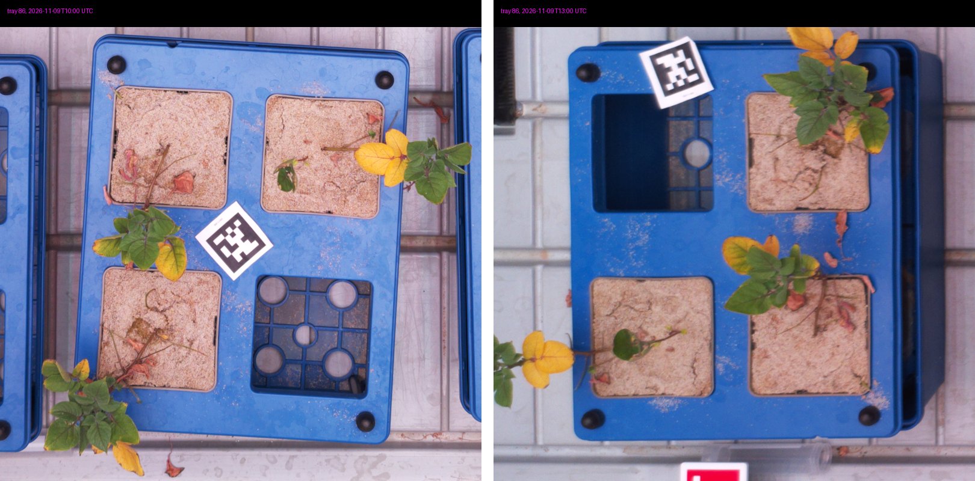
docs/figures/32/tray86-before-after.jpg
