txoof/npec-camera-rig/docs/figures/33.1/algae-and-soil-before-after.jpg

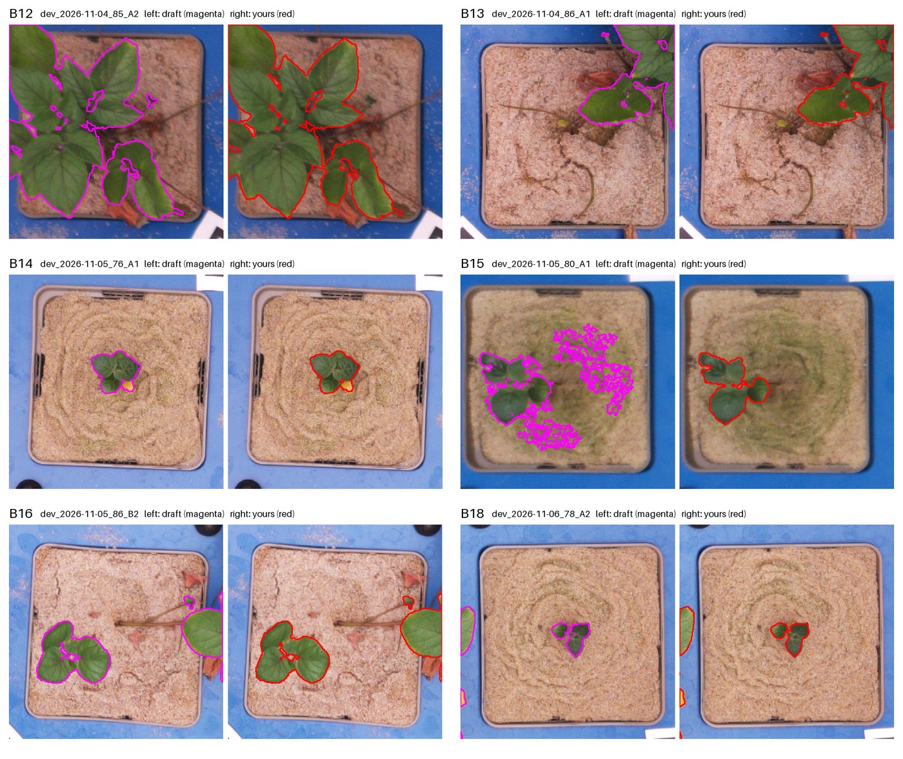
docs/figures/33.1/algae-and-soil-before-after.jpg
