txoof/npec-camera-rig/docs/figures/33.1/mat-cells-before-after.jpg

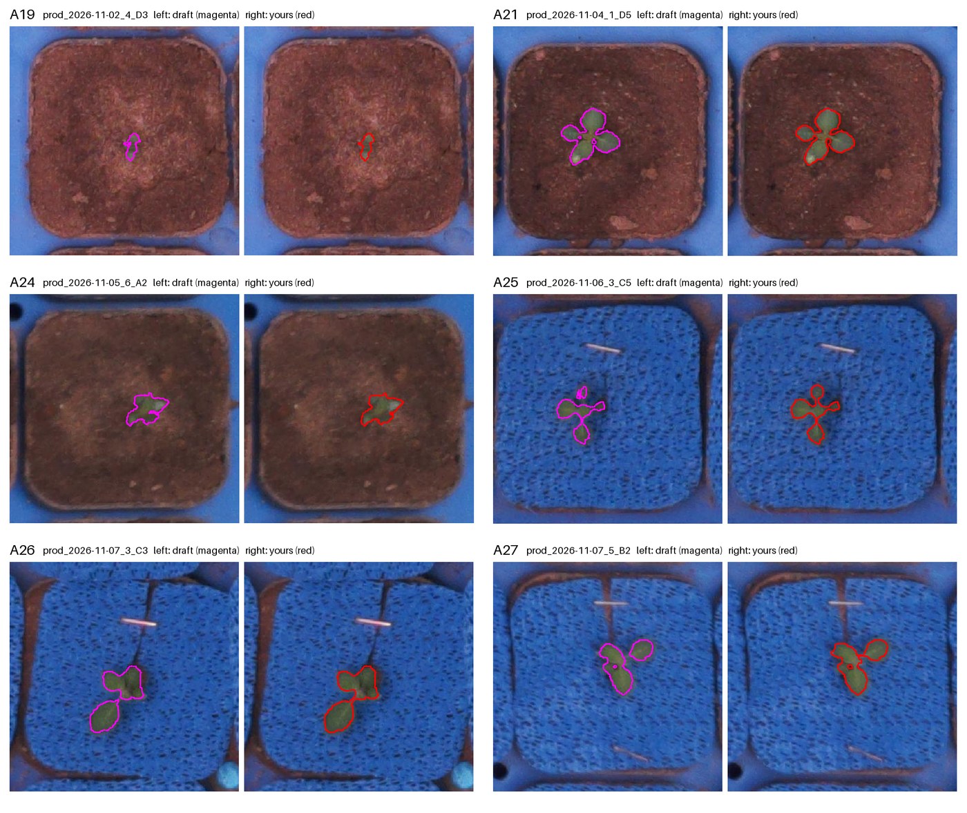
docs/figures/33.1/mat-cells-before-after.jpg
