txoof/npec-camera-rig/hardware/images/apriltag_tray_tag.png

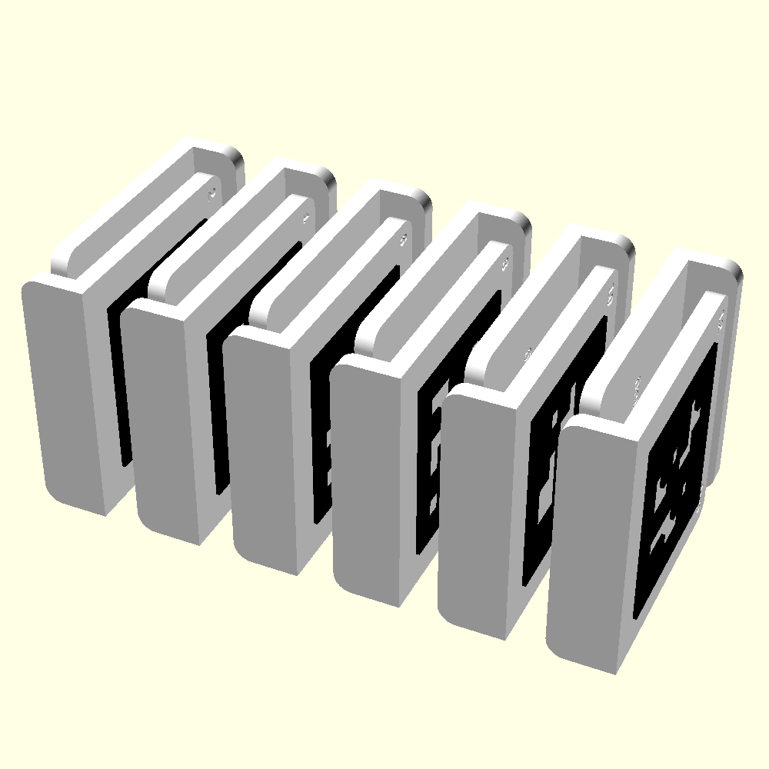
hardware/images/apriltag_tray_tag.png
