txoof/npec-camera-rig/hardware/images/auto-focus_bracket_2020.png

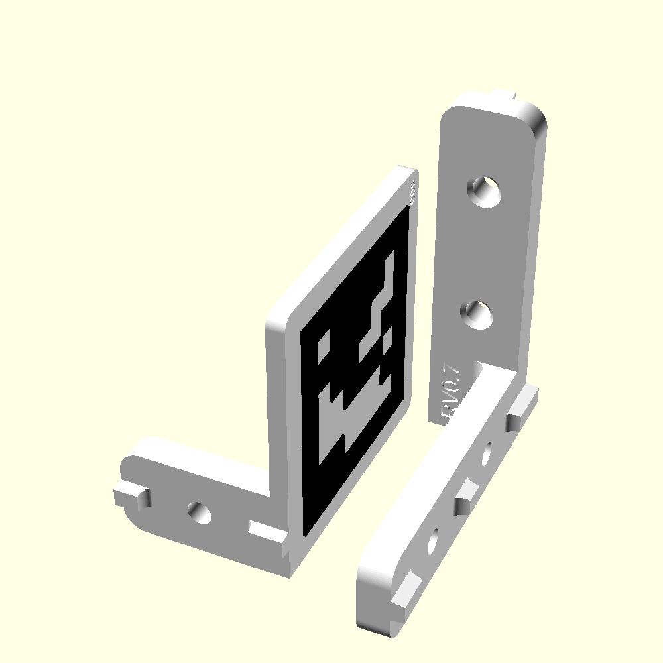
hardware/images/auto-focus_bracket_2020.png
