txoof/npec-camera-rig/hardware/images/cold_shoe_stud.png

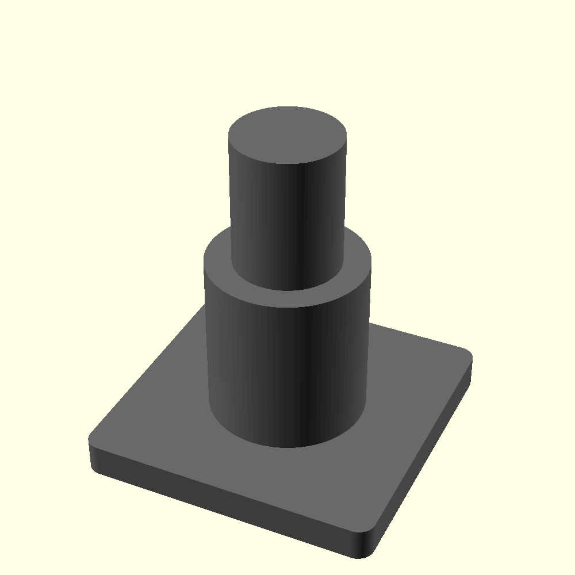
hardware/images/cold_shoe_stud.png
