txoof/npec-camera-rig/hardware/images/mini_ball_head.png

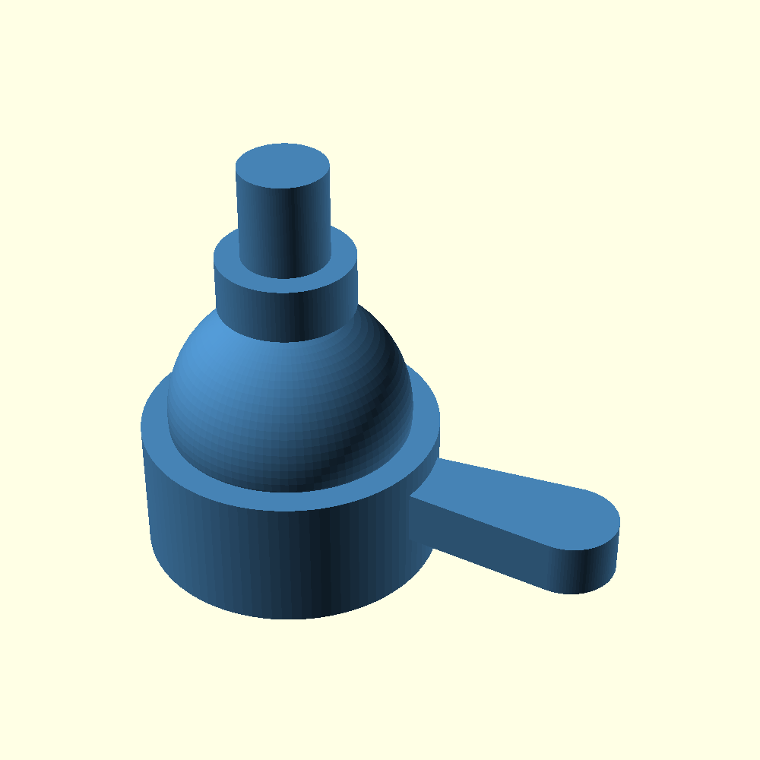
hardware/images/mini_ball_head.png
