txoof/npec-camera-rig/hardware/images/t_slot_20x20.png

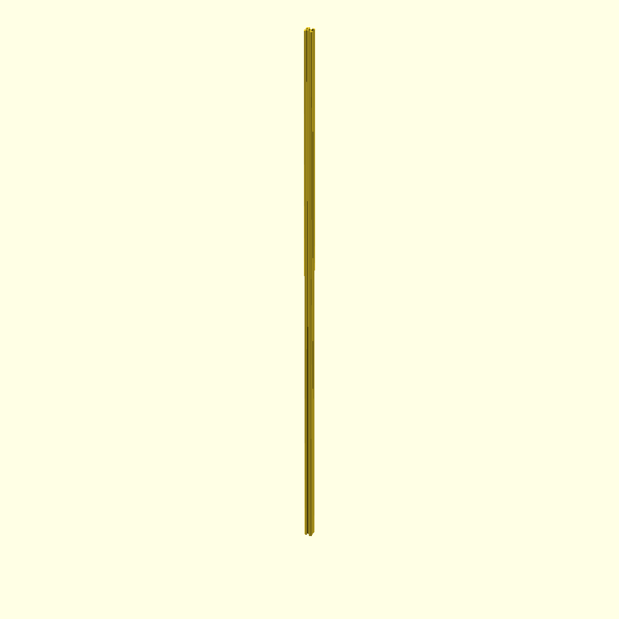
hardware/images/t_slot_20x20.png
