txoof/npec-camera-rig/hardware/images/t_slot_bolt.png

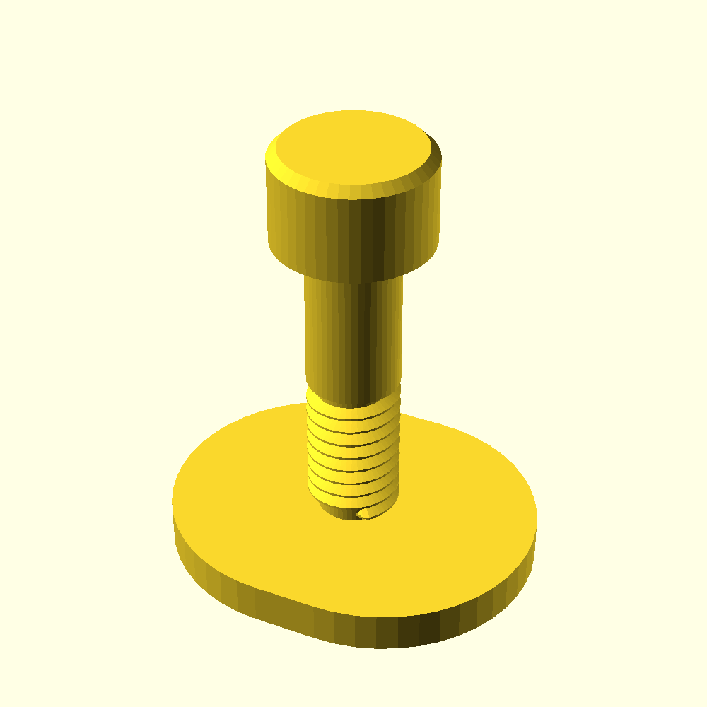
hardware/images/t_slot_bolt.png
