txoof/npec-camera-rig/hardware/Bill-of-Materials.md

# NPEC Daylight Growth Chamber Bill of Materials <!-- omit from toc -->

Required items per daylight growth chamber

## Camera Mount Hardware

| Qty Per Rig | Item | Notes |
| --- | --- | --- |
| 1 | [1.05m 40x40 t-channel profile aluminum](https://nl.rs-online.com/web/p/tubing-and-profile-struts/7613322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) rail | |
| 1 | [.65m 20x20 t-channel profile aluminum rail](https://www.conrad.nl/nl/p/tru-components-2020a-tc-10493168-vakwerkprofiel-aluminium-geeloxeerd-zilver-1000-mm-x-20-mm-x-20-mm-1-stuk-s-2623292.html) | |
| 2 | [40mm 90 degree brackets](https://www.conrad.nl/nl/p/tru-components-bracket-3030-tc-10493208-versteviging-90-aluminium-1-stuk-s-2623302.html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) | |
| 2 | [20x20 brackets](https://www.conrad.nl/nl/p/tru-components-bracket-2020-tc-10493184-versteviging-90-aluminium-1-stuk-s-2623296.html) | Alternative [3D printed Bracket:](./exports/camera_rig/l_bracket_4020.stl) |
| 6 | [M8x16 Bolts](https://www.conrad.nl/nl/p/839605-inbusschroeven-m8-16-mm-binnenzeskant-inbus-staal-verzinkt-100-stuk-s-839605.html) | |
| 4 | [M5x14 Bolts](https://www.conrad.nl/nl/p/toolcraft-1068370-cilinderkopschroeven-m5-14-mm-binnenzeskant-inbus-din-7984-rvs-a2-100-stuk-s-1068370.html) | |
| 9 | [M5x12 Bolts](https://www.conrad.nl/nl/p/toolcraft-116719-cilinderkopschroeven-m5-12-mm-binnenzeskant-inbus-din-912-staal-galvanisch-verzinkt-100-stuk-s-116719.html) | |
| 4 | [T-nut guided I-type slot 5mm  M5](https://www.conrad.nl/nl/p/fath-fa-096215-t-nut-for-profiles-width-of-the-groove-5mm-steel-zinc-t-slot-2-stuks-937497274.html) | |
| 4 | [T-nut guided I-type slot 8mm M8](https://www.conrad.nl/nl/p/fath-fa-096336-t-nut-for-profiles-width-of-the-groove-8mm-steel-zinc-t-slot-10-stuks-937494811.html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) | |
| 1 | [3D Printed Cold Shoe Holder](./exports/camera_rig/m5_slide_pocket.stl) | |
| 1 | [Cold Shoe with 3/4" & 1/4" stem](https://www.cameranu.nl/p2945885/smallrig-1631-cold-shoe-adapter-3-8-naar-1-4-2-stuks) | |
| 1 | [Tripod Ball Head Mount](https://www.kiwi-electronics.com/nl/ball-head-for-tripod-10756) (small) | |
| 1 | [ArduCam64 3d Printed Mount](./exports/camera_rig/arducam64_mount.stl) | Any Arducam Mount with a 1/4" screw boss can be substituted |
| 1 | [1/4 Inch Self Tapping 20 UNC Threaded Insert](https://www.google.com/search?client=firefox-b-d&q=1%2F4+Inch+Self+Tapping+20+UNC+Threaded+Insert) | |
| 4 | [4x Unique 50mm AprilTags](../hardware/exports/camera_rig/apriltag_corner_mount.3mf) | AprilTag IDs 450-499 are reserved for corner mounts. |

## Raspberry Pi & Camera Hardware

| Qty | Item | Notes |
| --- | --- | --- |
| 1 | [Raspberry Pi 5](https://www.conrad.nl/nl/p/raspberry-pi-5-b-8-gb-4-x-2-4-ghz-raspberry-pi-2980040.html) | |
| 1 | [Raspberry Pi 5 Power Supply](https://www.conrad.nl/nl/p/raspberry-pi-rpi-ps45w-stekkernetvoeding-vaste-spanning-geschikt-voor-serie-raspberry-pi-uitgangsstroom-max-5000-3404832.html) | |
| 1 | [128 or 256GB High Endurance SD Card](https://www.conrad.nl/nl/p/raspberry-pi-rpi-ps45w-stekkernetvoeding-vaste-spanning-geschikt-voor-serie-raspberry-pi-uitgangsstroom-max-5000-3404832.html) | High performance for read/write |
| 1 | [AruCam64](https://www.raspberrystore.nl/PrestaShop/nl/camera/460-arducam-64mp-autofocus-camera-module-incl-case.html) | |
| 1 | Halio AI Accelerator | |
| 1 | [Raspberry Pi5 Enclosure with space for Halio AI board](https://makerworld.com/en/models/2348762-raspberry-pi-ai-hat-case#profileId-2568477) | |
| 1 | [3 Gang Power Strip w/ 3 meter Cable](https://www.conrad.nl/nl/p/sygonix-sy-4890982-stekkerdoos-3-voudig-wit-randaarde-stekker-1-stuk-s-2445491.html) | |
| 1 | [Adafruit CSI/DSI Cable Adapter Thingy for Raspberry Pi](https://www.kiwi-electronics.com/nl/adafruit-csi-dsi-cable-adapter-thingy-voor-raspberry-pi-11498) | This is necessary to extend the ArduCam stock ribbon cable |
| 1 | [Raspberry Pi Camera Cable - Standaard-Mini - 200mm](https://www.kiwi-electronics.com/nl/raspberry-pi-camera-kabel-standaard-mini-200mm-11588) | Use with Adafruit CSI/DSI Thingy to extend the length of hte ArduCam ribbon cable adapter |
| | | |

Note: All 3D Printable files can be found in the [`hardware`](../hardware/) directory. Exported STL and 3MF files can be found in [`hardware/exports`](../hardware/exports) directory. Full instructions for re-generating the STL and 3MF files from the OpenSCAD files can be found in the [hardware README.md](../hardware/README.md).
