txoof/npec-camera-rig/experiments/round1-leaves/scan_areas.csv

scan | leaf_px | px_per_mm_x | px_per_mm_y | tags | tag_scale_spread_pct | leaf_mm2
L001 | 1007002 | 11.663 | 11.777 | 5 | 0.46 | 7331.3
L002 | 1023356 | 11.653 | 11.790 | 5 | 0.58 | 7448.4
L003 | 1085526 | 11.660 | 11.787 | 5 | 0.55 | 7898.5
L001_after | 930451 | 11.643 | 11.787 | 5 | 0.61 | 6779.9
L002_after | 972889 | 11.653 | 11.790 | 5 | 0.58 | 7081.0
L003_after | 1034372 | 11.650 | 11.787 | 5 | 0.55 | 7532.8
