txoof/npec-camera-rig/experiments/round1/session-2026-10-15.csv

step | title | experiment_uuid | experiment_dir | still
1 | Nothing moved | 44a9e96e-b8a0-440e-9f90-510d086baa67 | 2026-10-15_44a9e96e | 075756_789328
1 | Nothing moved | 44a9e96e-b8a0-440e-9f90-510d086baa67 | 2026-10-15_44a9e96e | 075800_817852
1 | Nothing moved | 44a9e96e-b8a0-440e-9f90-510d086baa67 | 2026-10-15_44a9e96e | 075804_644388
1 | Nothing moved | 44a9e96e-b8a0-440e-9f90-510d086baa67 | 2026-10-15_44a9e96e | 075810_273073
1 | Nothing moved | 44a9e96e-b8a0-440e-9f90-510d086baa67 | 2026-10-15_44a9e96e | 075814_073060
1 | Nothing moved | 44a9e96e-b8a0-440e-9f90-510d086baa67 | 2026-10-15_44a9e96e | 075819_398738
1 | Nothing moved | 44a9e96e-b8a0-440e-9f90-510d086baa67 | 2026-10-15_44a9e96e | 075823_658093
1 | Nothing moved | 44a9e96e-b8a0-440e-9f90-510d086baa67 | 2026-10-15_44a9e96e | 075827_613997
1 | Nothing moved | 44a9e96e-b8a0-440e-9f90-510d086baa67 | 2026-10-15_44a9e96e | 075833_527888
1 | Nothing moved | 44a9e96e-b8a0-440e-9f90-510d086baa67 | 2026-10-15_44a9e96e | 075838_992288
2 | Trays turned 180 degrees | 44a9e96e-b8a0-440e-9f90-510d086baa67 | 2026-10-15_44a9e96e | 080538_555279
2 | Trays turned 180 degrees | 44a9e96e-b8a0-440e-9f90-510d086baa67 | 2026-10-15_44a9e96e | 080544_566961
2 | Trays turned 180 degrees | 44a9e96e-b8a0-440e-9f90-510d086baa67 | 2026-10-15_44a9e96e | 080550_290539
2 | Trays turned 180 degrees | 44a9e96e-b8a0-440e-9f90-510d086baa67 | 2026-10-15_44a9e96e | 080555_122974
3 | North and South rows swapped | 44a9e96e-b8a0-440e-9f90-510d086baa67 | 2026-10-15_44a9e96e | 081000_488160
3 | North and South rows swapped | 44a9e96e-b8a0-440e-9f90-510d086baa67 | 2026-10-15_44a9e96e | 081038_314363
3 | North and South rows swapped | 44a9e96e-b8a0-440e-9f90-510d086baa67 | 2026-10-15_44a9e96e | 081043_612615
5 | Trays pushed together | 44a9e96e-b8a0-440e-9f90-510d086baa67 | 2026-10-15_44a9e96e | 081433_159359
5 | Trays pushed together | 44a9e96e-b8a0-440e-9f90-510d086baa67 | 2026-10-15_44a9e96e | 081449_740389
4 | Trays swapped within rows | 44a9e96e-b8a0-440e-9f90-510d086baa67 | 2026-10-15_44a9e96e | 082210_013542
4 | Trays swapped within rows | 44a9e96e-b8a0-440e-9f90-510d086baa67 | 2026-10-15_44a9e96e | 082222_791442
4 | Trays swapped within rows | 44a9e96e-b8a0-440e-9f90-510d086baa67 | 2026-10-15_44a9e96e | 082235_601435
6 | Benchmark on North 1 | 44a9e96e-b8a0-440e-9f90-510d086baa67 | 2026-10-15_44a9e96e | 082328_270773
6 | Benchmark on North 2 | 44a9e96e-b8a0-440e-9f90-510d086baa67 | 2026-10-15_44a9e96e | 082341_146344
6 | Benchmark on North 3 | 44a9e96e-b8a0-440e-9f90-510d086baa67 | 2026-10-15_44a9e96e | 082353_270788
6 | Benchmark on North 4 | 44a9e96e-b8a0-440e-9f90-510d086baa67 | 2026-10-15_44a9e96e | 082407_696532
6 | Benchmark on North 5 | 44a9e96e-b8a0-440e-9f90-510d086baa67 | 2026-10-15_44a9e96e | 082421_221058
6 | Benchmark on North 6 | 44a9e96e-b8a0-440e-9f90-510d086baa67 | 2026-10-15_44a9e96e | 082433_545889
6 | Benchmark on South 1 | 44a9e96e-b8a0-440e-9f90-510d086baa67 | 2026-10-15_44a9e96e | 082446_183501
6 | Benchmark on South 2 | 44a9e96e-b8a0-440e-9f90-510d086baa67 | 2026-10-15_44a9e96e | 082457_964839
6 | Benchmark on South 3 | 44a9e96e-b8a0-440e-9f90-510d086baa67 | 2026-10-15_44a9e96e | 082509_691980
6 | Benchmark on South 4 | 44a9e96e-b8a0-440e-9f90-510d086baa67 | 2026-10-15_44a9e96e | 082521_802329
6 | Benchmark on South 5 | 44a9e96e-b8a0-440e-9f90-510d086baa67 | 2026-10-15_44a9e96e | 082532_509438
6 | Benchmark on South 6 | 44a9e96e-b8a0-440e-9f90-510d086baa67 | 2026-10-15_44a9e96e | 082544_262355
R2-1 | Round 2: nothing moved | 44a9e96e-b8a0-440e-9f90-510d086baa67 | 2026-10-15_44a9e96e | 090602_165882
R2-1 | Round 2: nothing moved | 44a9e96e-b8a0-440e-9f90-510d086baa67 | 2026-10-15_44a9e96e | 090614_999637
R2-1 | Round 2: nothing moved | 44a9e96e-b8a0-440e-9f90-510d086baa67 | 2026-10-15_44a9e96e | 090627_815644
R2-1 | Round 2: nothing moved | 44a9e96e-b8a0-440e-9f90-510d086baa67 | 2026-10-15_44a9e96e | 090640_702608
R2-1 | Round 2: nothing moved | 44a9e96e-b8a0-440e-9f90-510d086baa67 | 2026-10-15_44a9e96e | 090653_544178
R2-1 | Round 2: nothing moved | 44a9e96e-b8a0-440e-9f90-510d086baa67 | 2026-10-15_44a9e96e | 090706_390271
R2-1 | Round 2: nothing moved | 44a9e96e-b8a0-440e-9f90-510d086baa67 | 2026-10-15_44a9e96e | 090719_232328
R2-1 | Round 2: nothing moved | 44a9e96e-b8a0-440e-9f90-510d086baa67 | 2026-10-15_44a9e96e | 090732_059616
R2-1 | Round 2: nothing moved | 44a9e96e-b8a0-440e-9f90-510d086baa67 | 2026-10-15_44a9e96e | 090744_872033
R2-1 | Round 2: nothing moved | 44a9e96e-b8a0-440e-9f90-510d086baa67 | 2026-10-15_44a9e96e | 090757_686309
R2-2 | Round 2: North and South rows swapped | 44a9e96e-b8a0-440e-9f90-510d086baa67 | 2026-10-15_44a9e96e | 091302_368814
R2-2 | Round 2: North and South rows swapped | 44a9e96e-b8a0-440e-9f90-510d086baa67 | 2026-10-15_44a9e96e | 091315_154632
R2-2 | Round 2: North and South rows swapped | 44a9e96e-b8a0-440e-9f90-510d086baa67 | 2026-10-15_44a9e96e | 091327_942019
R2-3 | Round 2: trays swapped within rows | 44a9e96e-b8a0-440e-9f90-510d086baa67 | 2026-10-15_44a9e96e | 091859_263710
R2-3 | Round 2: trays swapped within rows | 44a9e96e-b8a0-440e-9f90-510d086baa67 | 2026-10-15_44a9e96e | 091912_068172
R2-3 | Round 2: trays swapped within rows | 44a9e96e-b8a0-440e-9f90-510d086baa67 | 2026-10-15_44a9e96e | 091924_901812
R2-4 | Round 2: trays pushed together | 44a9e96e-b8a0-440e-9f90-510d086baa67 | 2026-10-15_44a9e96e | 092731_168752
R2-4 | Round 2: trays pushed together | 44a9e96e-b8a0-440e-9f90-510d086baa67 | 2026-10-15_44a9e96e | 092744_013230
R2-4 | Round 2: trays pushed together | 44a9e96e-b8a0-440e-9f90-510d086baa67 | 2026-10-15_44a9e96e | 092756_803315
R3 | One-hour run nothing moved | 44a9e96e-b8a0-440e-9f90-510d086baa67 | 2026-10-15_44a9e96e | 100149_752438
R3 | One-hour run nothing moved | 44a9e96e-b8a0-440e-9f90-510d086baa67 | 2026-10-15_44a9e96e | 100204_695134
R3 | One-hour run nothing moved | 44a9e96e-b8a0-440e-9f90-510d086baa67 | 2026-10-15_44a9e96e | 100219_739626
R3 | One-hour run nothing moved | 44a9e96e-b8a0-440e-9f90-510d086baa67 | 2026-10-15_44a9e96e | 100234_728748
R3 | One-hour run nothing moved | 44a9e96e-b8a0-440e-9f90-510d086baa67 | 2026-10-15_44a9e96e | 100249_740499
R3 | One-hour run nothing moved | 44a9e96e-b8a0-440e-9f90-510d086baa67 | 2026-10-15_44a9e96e | 100304_719978
R3 | One-hour run nothing moved | 44a9e96e-b8a0-440e-9f90-510d086baa67 | 2026-10-15_44a9e96e | 100319_743507
R3 | One-hour run nothing moved | 44a9e96e-b8a0-440e-9f90-510d086baa67 | 2026-10-15_44a9e96e | 100334_776445
R3 | One-hour run nothing moved | 44a9e96e-b8a0-440e-9f90-510d086baa67 | 2026-10-15_44a9e96e | 100349_729569
R3 | One-hour run nothing moved | 44a9e96e-b8a0-440e-9f90-510d086baa67 | 2026-10-15_44a9e96e | 100404_735871
R3 | One-hour run nothing moved | 44a9e96e-b8a0-440e-9f90-510d086baa67 | 2026-10-15_44a9e96e | 100419_723826
R3 | One-hour run nothing moved | 44a9e96e-b8a0-440e-9f90-510d086baa67 | 2026-10-15_44a9e96e | 100434_726893
R3 | One-hour run nothing moved | 44a9e96e-b8a0-440e-9f90-510d086baa67 | 2026-10-15_44a9e96e | 100449_733668
R3 | One-hour run nothing moved | 44a9e96e-b8a0-440e-9f90-510d086baa67 | 2026-10-15_44a9e96e | 100504_724168
R3 | One-hour run nothing moved | 44a9e96e-b8a0-440e-9f90-510d086baa67 | 2026-10-15_44a9e96e | 100519_739147
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
R3 | One-hour run nothing moved | 44a9e96e-b8a0-440e-9f90-510d086baa67 | 2026-10-15_44a9e96e | 102849_741632
R3 | One-hour run nothing moved | 44a9e96e-b8a0-440e-9f90-510d086baa67 | 2026-10-15_44a9e96e | 102904_742544
R3 | One-hour run nothing moved | 44a9e96e-b8a0-440e-9f90-510d086baa67 | 2026-10-15_44a9e96e | 102919_734818
R3 | One-hour run nothing moved | 44a9e96e-b8a0-440e-9f90-510d086baa67 | 2026-10-15_44a9e96e | 102934_735356
R3 | One-hour run nothing moved | 44a9e96e-b8a0-440e-9f90-510d086baa67 | 2026-10-15_44a9e96e | 102949_744924
R3 | One-hour run nothing moved | 44a9e96e-b8a0-440e-9f90-510d086baa67 | 2026-10-15_44a9e96e | 103004_768897
R3 | One-hour run nothing moved | 44a9e96e-b8a0-440e-9f90-510d086baa67 | 2026-10-15_44a9e96e | 103019_773728
R3 | One-hour run nothing moved | 44a9e96e-b8a0-440e-9f90-510d086baa67 | 2026-10-15_44a9e96e | 103034_748592
R3 | One-hour run nothing moved | 44a9e96e-b8a0-440e-9f90-510d086baa67 | 2026-10-15_44a9e96e | 103049_755235
R3 | One-hour run nothing moved | 44a9e96e-b8a0-440e-9f90-510d086baa67 | 2026-10-15_44a9e96e | 103104_730066
R3 | One-hour run nothing moved | 44a9e96e-b8a0-440e-9f90-510d086baa67 | 2026-10-15_44a9e96e | 103119_733796
R3 | One-hour run nothing moved | 44a9e96e-b8a0-440e-9f90-510d086baa67 | 2026-10-15_44a9e96e | 103134_760861
R3 | One-hour run nothing moved | 44a9e96e-b8a0-440e-9f90-510d086baa67 | 2026-10-15_44a9e96e | 103149_734160
R3 | One-hour run nothing moved | 44a9e96e-b8a0-440e-9f90-510d086baa67 | 2026-10-15_44a9e96e | 103204_770199
R3 | One-hour run nothing moved | 44a9e96e-b8a0-440e-9f90-510d086baa67 | 2026-10-15_44a9e96e | 103219_748846
