txoof/npec-camera-rig/hardware/exports/calibration_targets/calibration_squares.stl

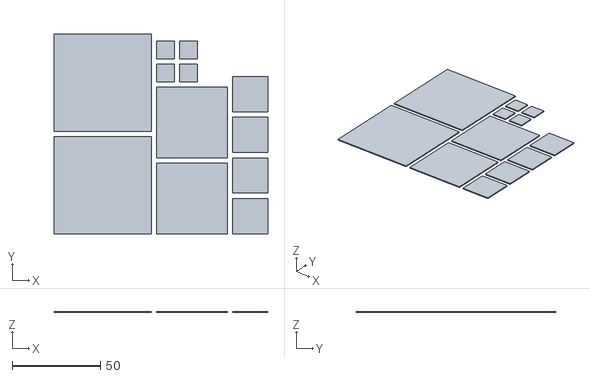
[picture p90: CAD file, 2026-10-26]
hardware/exports/calibration_targets/calibration_squares.stl
121.0 x 113.0 x 0.568
