txoof/npec-camera-rig/hardware/exports/camera_rig/pi5_case_calibration.stl

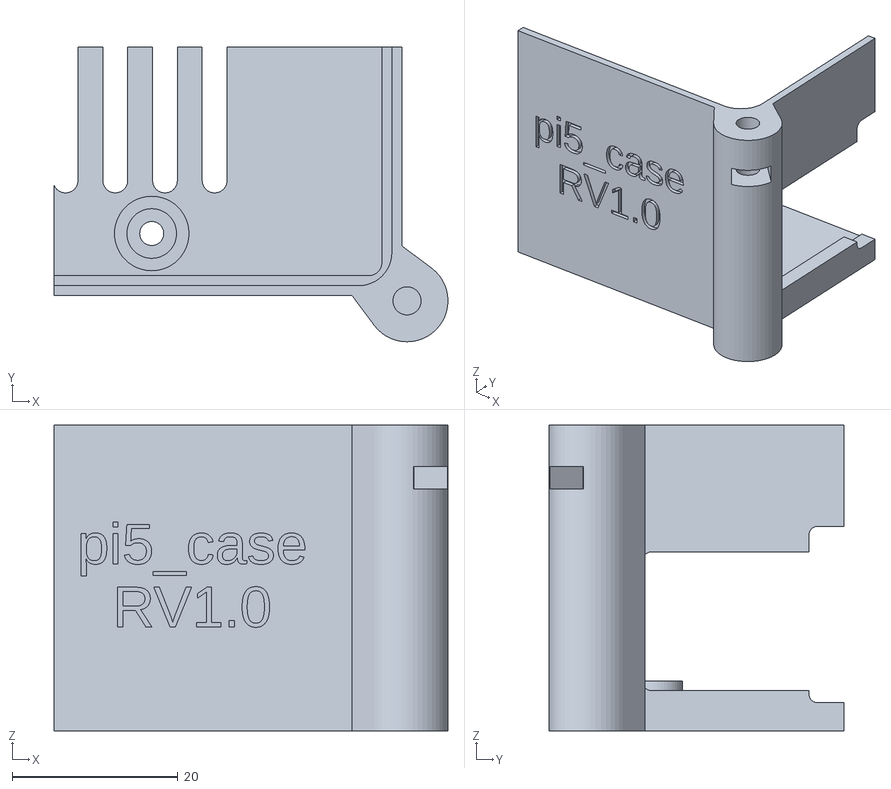
[picture p91: CAD file, 2026-11-03]
hardware/exports/camera_rig/pi5_case_calibration.stl
47.6 x 35.6 x 36.9
