txoof/npec-camera-rig/hardware/exports/tray_tags/2x2/apriltag_tray_tag_2x2_112-123_lip.3mf

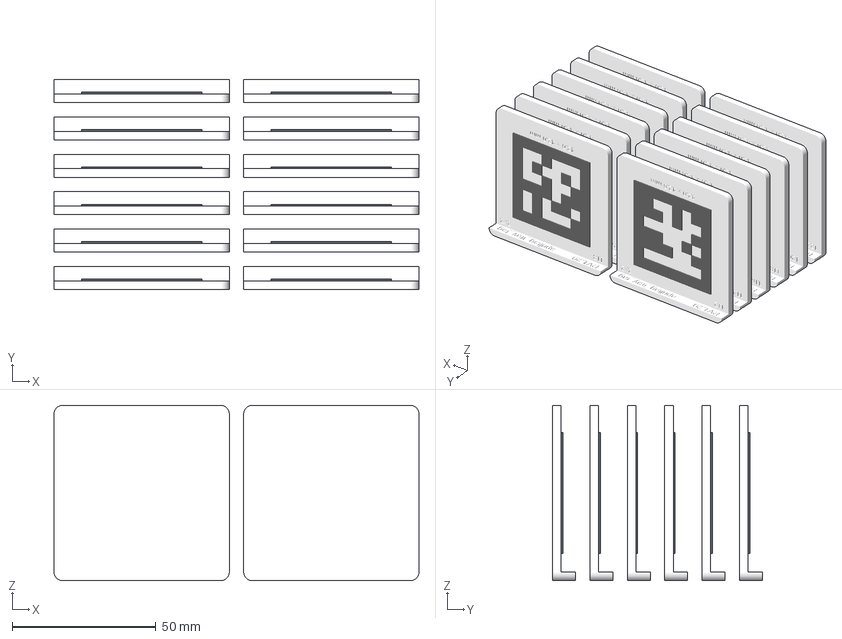
[picture p92: CAD file, 2026-11-02]
hardware/exports/tray_tags/2x2/apriltag_tray_tag_2x2_112-123_lip.3mf
127.0 x 73.0 x 61.0 mm
apriltag_tray_tag_2x2_112-123_lip 1
apriltag_tray_tag_2x2_112-123_lip 2
apriltag_tray_tag_2x2_112-123_lip 3
apriltag_tray_tag_2x2_112-123_lip 4
apriltag_tray_tag_2x2_112-123_lip 5
apriltag_tray_tag_2x2_112-123_lip 6
apriltag_tray_tag_2x2_112-123_lip 7
apriltag_tray_tag_2x2_112-123_lip 8
apriltag_tray_tag_2x2_112-123_lip 9
apriltag_tray_tag_2x2_112-123_lip 10
apriltag_tray_tag_2x2_112-123_lip 11
apriltag_tray_tag_2x2_112-123_lip 12
