txoof/npec-camera-rig/hardware/exports/tray_tags/black_tray/apriltag_tray_tag_black_tray_250_disc.3mf

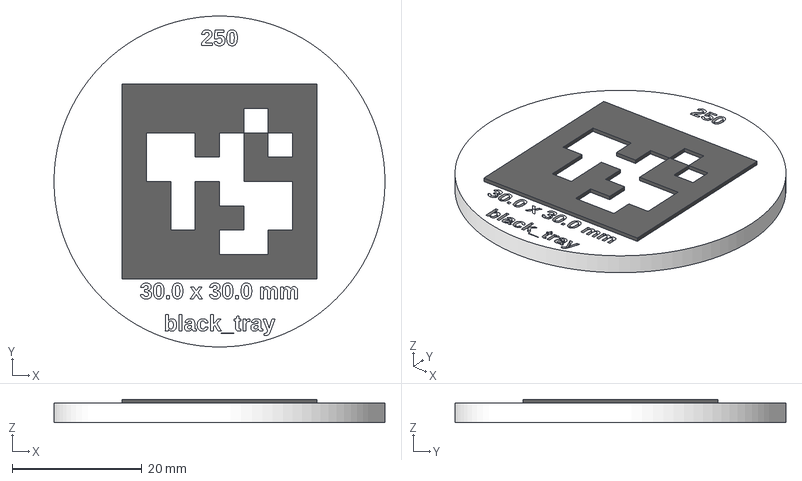
[picture p94: CAD file, 2026-10-16]
hardware/exports/tray_tags/black_tray/apriltag_tray_tag_black_tray_250_disc.3mf
51.0 x 51.0 x 3.60 mm
