txoof/npec-camera-rig/hardware/reference/40x40_profile/54.01.0100(00-00-0)(000)_right.dxf

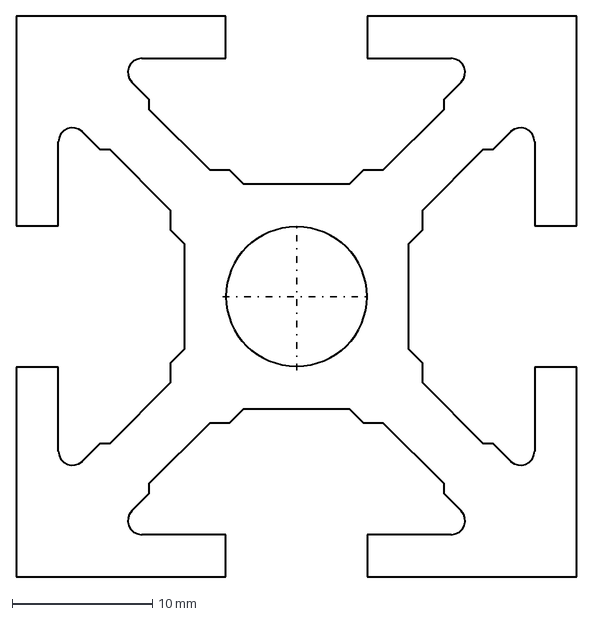
[picture p95: CAD file, 2026-09-25]
hardware/reference/40x40_profile/54.01.0100(00-00-0)(000)_right.dxf
40.0 x 40.0 mm
