txoof/npec-camera-rig/hardware/exports/camera_rig/pi5_case_tub.stl

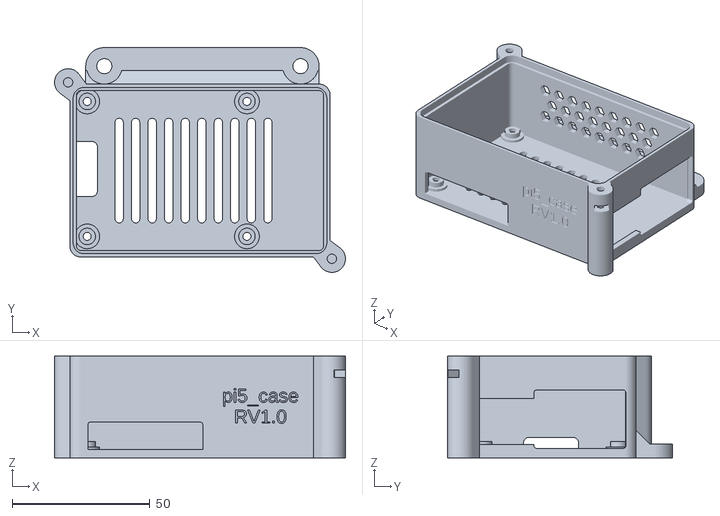
[picture p96: CAD file, 2026-11-03]
hardware/exports/camera_rig/pi5_case_tub.stl
105.7 x 81.6 x 36.9
