txoof/npec-camera-rig/hardware/exports/tray_tags/2x2/apriltag_tray_tag_2x2_148-150_lip.3mf

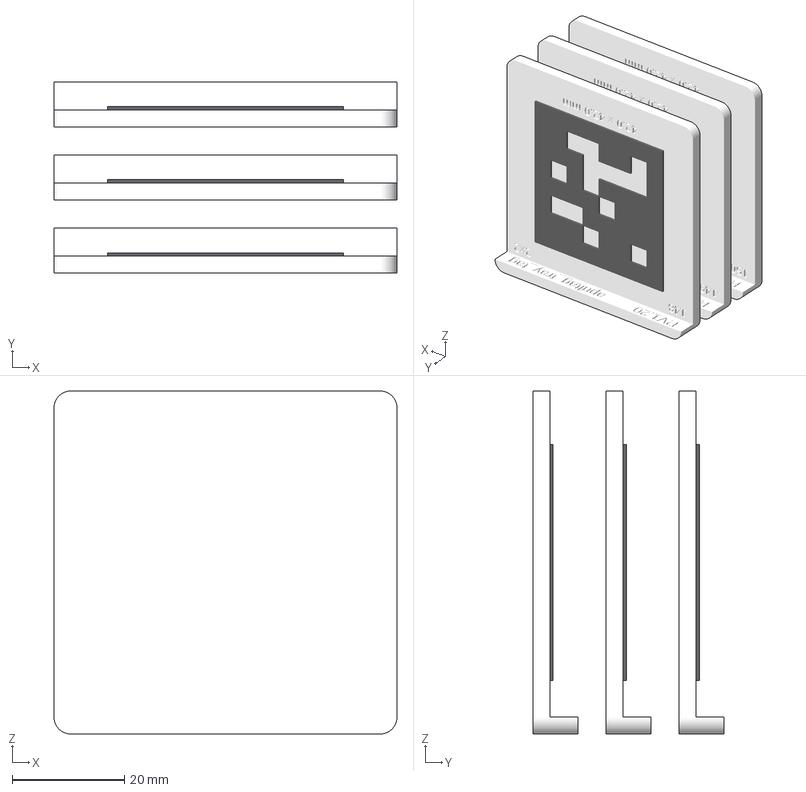
[picture p97: CAD file, 2026-11-02]
hardware/exports/tray_tags/2x2/apriltag_tray_tag_2x2_148-150_lip.3mf
61.0 x 34.0 x 61.0 mm
apriltag_tray_tag_2x2_148-150_lip 1
apriltag_tray_tag_2x2_148-150_lip 2
apriltag_tray_tag_2x2_148-150_lip 3
