txoof/npec-camera-rig/hardware/exports/tray_tags/4x5/apriltag_tray_tag_4x5_73-75_lip_round.3mf

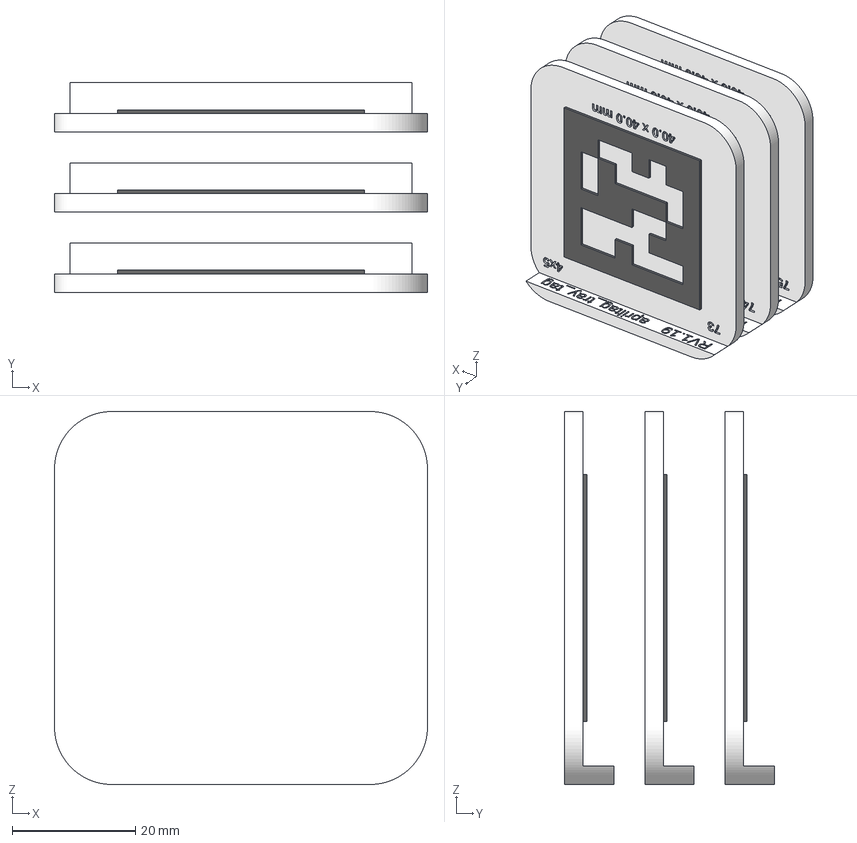
[picture p98: CAD file, 2026-10-21]
hardware/exports/tray_tags/4x5/apriltag_tray_tag_4x5_73-75_lip_round.3mf
60.5 x 34.0 x 60.5 mm
apriltag_tray_tag_4x5_73-75_lip_round 1
apriltag_tray_tag_4x5_73-75_lip_round 2
apriltag_tray_tag_4x5_73-75_lip_round 3
