txoof/npec-camera-rig/hardware/exports/camera_rig/pi5_case_tub_and_lid.stl

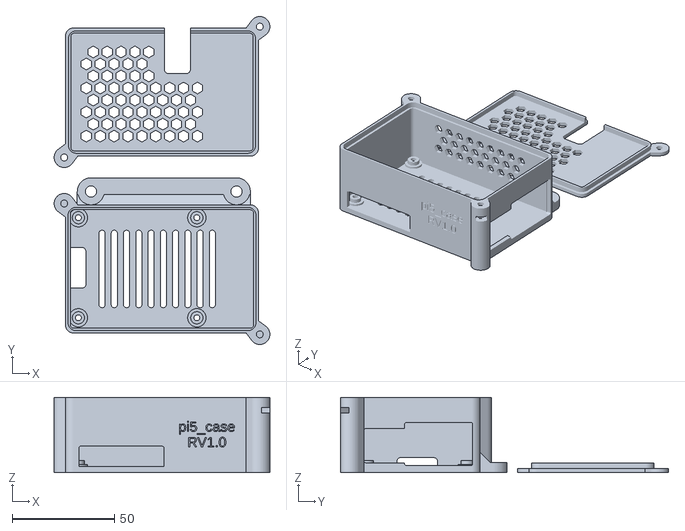
[picture p101: CAD file, 2026-11-03]
hardware/exports/camera_rig/pi5_case_tub_and_lid.stl
105.7 x 160.6 x 36.9
