txoof/npec-camera-rig/hardware/exports/tray_tags/4x5/apriltag_tray_tag_4x5_37-48_lip_round.3mf

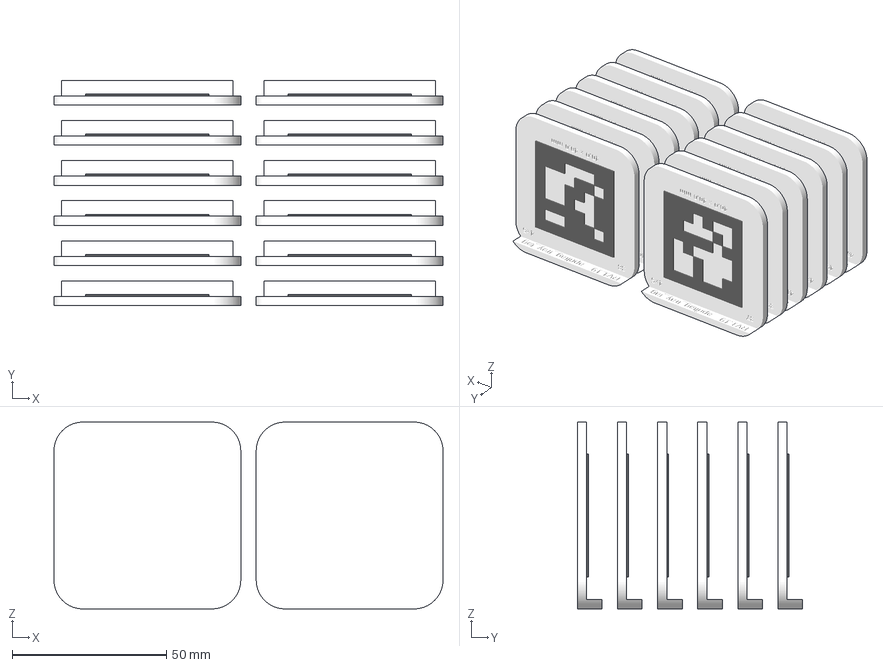
[picture p102: CAD file, 2026-10-21]
hardware/exports/tray_tags/4x5/apriltag_tray_tag_4x5_37-48_lip_round.3mf
126.0 x 73.0 x 60.5 mm
apriltag_tray_tag_4x5_37-48_lip_round 1
apriltag_tray_tag_4x5_37-48_lip_round 2
apriltag_tray_tag_4x5_37-48_lip_round 3
apriltag_tray_tag_4x5_37-48_lip_round 4
apriltag_tray_tag_4x5_37-48_lip_round 5
apriltag_tray_tag_4x5_37-48_lip_round 6
apriltag_tray_tag_4x5_37-48_lip_round 7
apriltag_tray_tag_4x5_37-48_lip_round 8
apriltag_tray_tag_4x5_37-48_lip_round 9
apriltag_tray_tag_4x5_37-48_lip_round 10
apriltag_tray_tag_4x5_37-48_lip_round 11
apriltag_tray_tag_4x5_37-48_lip_round 12
