txoof/npec-camera-rig/hardware/exports/tray_tags/black_tray/apriltag_tray_tag_black_tray_238-249_disc.3mf

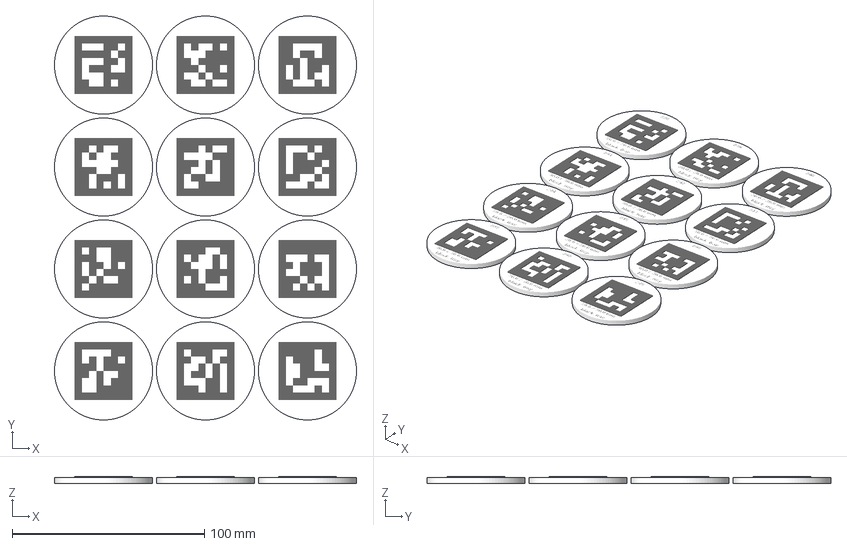
[picture p103: CAD file, 2026-10-16]
hardware/exports/tray_tags/black_tray/apriltag_tray_tag_black_tray_238-249_disc.3mf
157.0 x 210.0 x 3.60 mm
apriltag_tray_tag_black_tray_238-249_disc 1
apriltag_tray_tag_black_tray_238-249_disc 2
apriltag_tray_tag_black_tray_238-249_disc 3
apriltag_tray_tag_black_tray_238-249_disc 4
apriltag_tray_tag_black_tray_238-249_disc 5
apriltag_tray_tag_black_tray_238-249_disc 6
apriltag_tray_tag_black_tray_238-249_disc 7
apriltag_tray_tag_black_tray_238-249_disc 8
apriltag_tray_tag_black_tray_238-249_disc 9
apriltag_tray_tag_black_tray_238-249_disc 10
apriltag_tray_tag_black_tray_238-249_disc 11
apriltag_tray_tag_black_tray_238-249_disc 12
