txoof/npec-camera-rig/hardware/reference/40x40_profile/54.01.0100(00-00-0)(000)_top.dxf

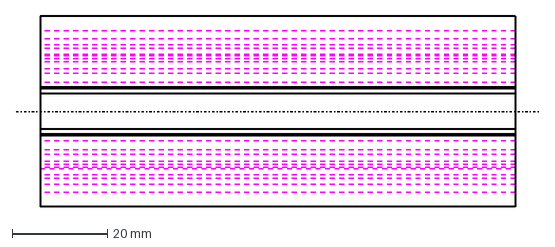
[picture p104: CAD file, 2026-09-25]
hardware/reference/40x40_profile/54.01.0100(00-00-0)(000)_top.dxf
109.9 x 40.0 mm
