txoof/npec-camera-rig/hardware/exports/camera_rig/pi5_case_lid.stl

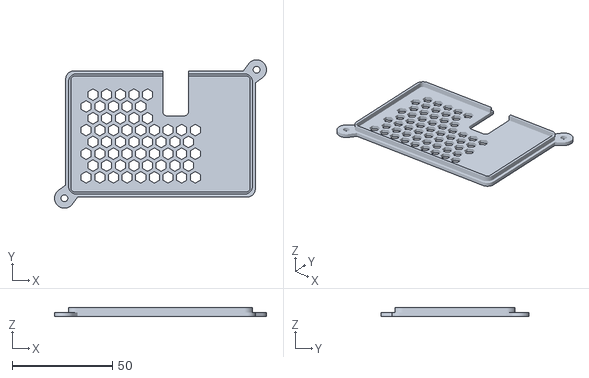
[picture p105: CAD file, 2026-10-23]
hardware/exports/camera_rig/pi5_case_lid.stl
105.7 x 74.0 x 4.70
