txoof/npec-camera-rig/hardware/exports/camera_rig/auto-focus_bracket_2020.3mf

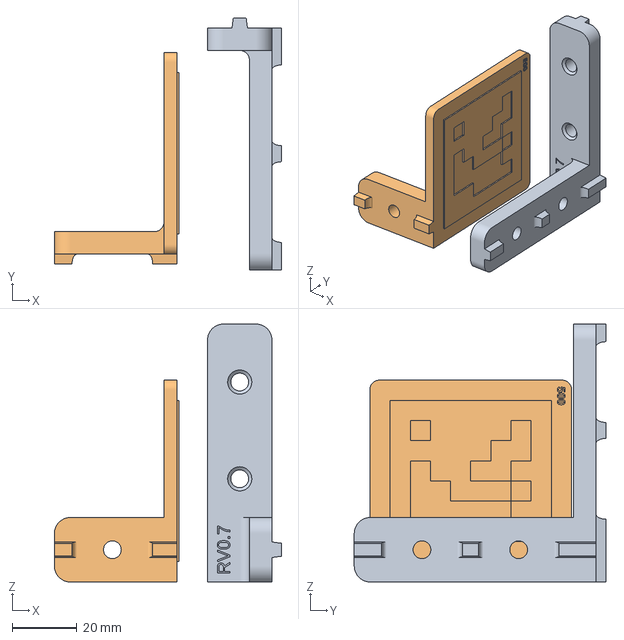
[picture p106: CAD file, 2026-10-06]
hardware/exports/camera_rig/auto-focus_bracket_2020.3mf
70.5 x 78.0 x 80.0 mm
auto-focus_bracket_2020 1
auto-focus_bracket_2020 2
