txoof/npec-camera-rig/hardware/exports/camera_rig/apriltag_corner_mount.3mf

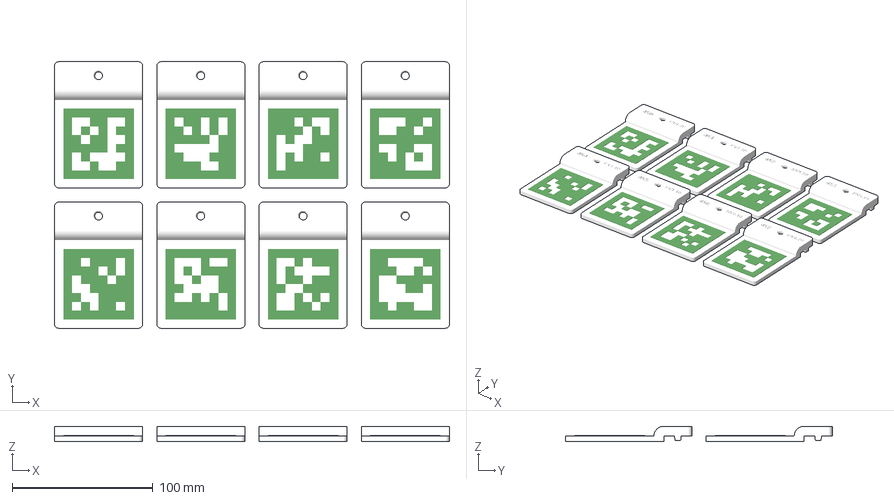
[picture p107: CAD file, 2026-09-30]
hardware/exports/camera_rig/apriltag_corner_mount.3mf
280.4 x 189.2 x 11.0 mm
apriltag_corner_mount 1
apriltag_corner_mount 2
apriltag_corner_mount 3
apriltag_corner_mount 4
apriltag_corner_mount 5
apriltag_corner_mount 6
apriltag_corner_mount 7
apriltag_corner_mount 8
