txoof/npec-camera-rig/hardware/exports/camera_rig/arducam64_mount.stl

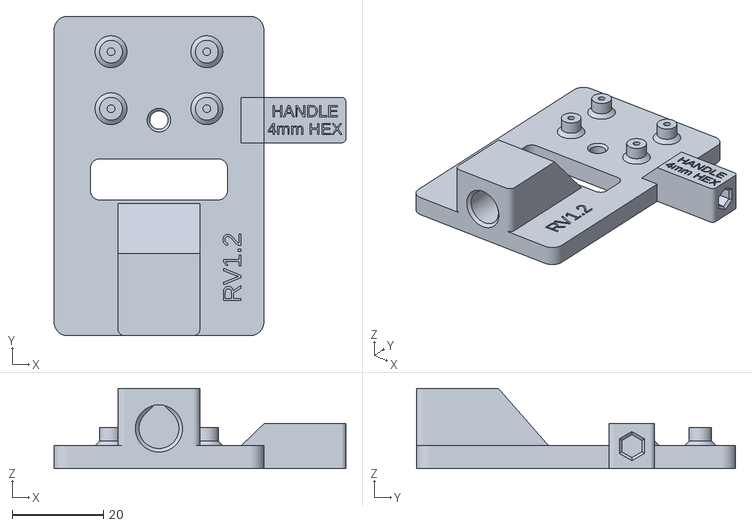
[picture p108: CAD file, 2026-09-29]
hardware/exports/camera_rig/arducam64_mount.stl
64.0 x 70.0 x 17.6
