txoof/npec-camera-rig/hardware/exports/camera_rig/l_bracket_4020.stl

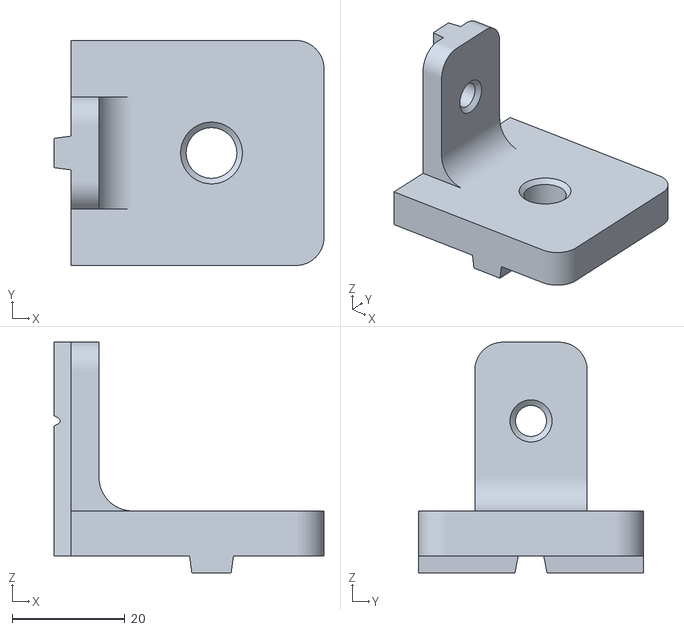
[picture p109: CAD file, 2026-09-25]
hardware/exports/camera_rig/l_bracket_4020.stl
48.0 x 40.0 x 41.0
