txoof/npec-camera-rig/hardware/exports/camera_rig/m5_slide_pocket.stl

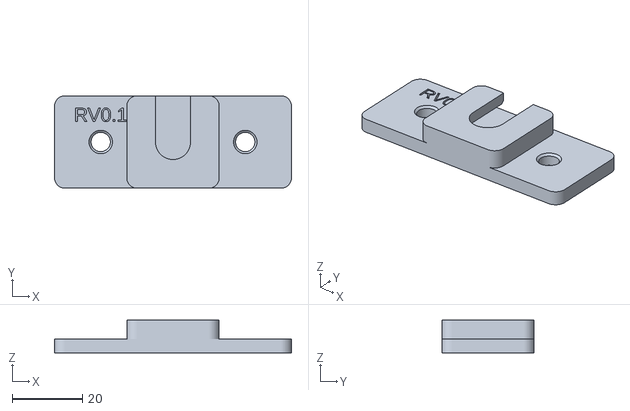
[picture p110: CAD file, 2026-09-25]
hardware/exports/camera_rig/m5_slide_pocket.stl
67.7 x 26.4 x 9.30
