txoof/npec-camera-rig/docs/figures/21/live-step4-two-tags.jpg

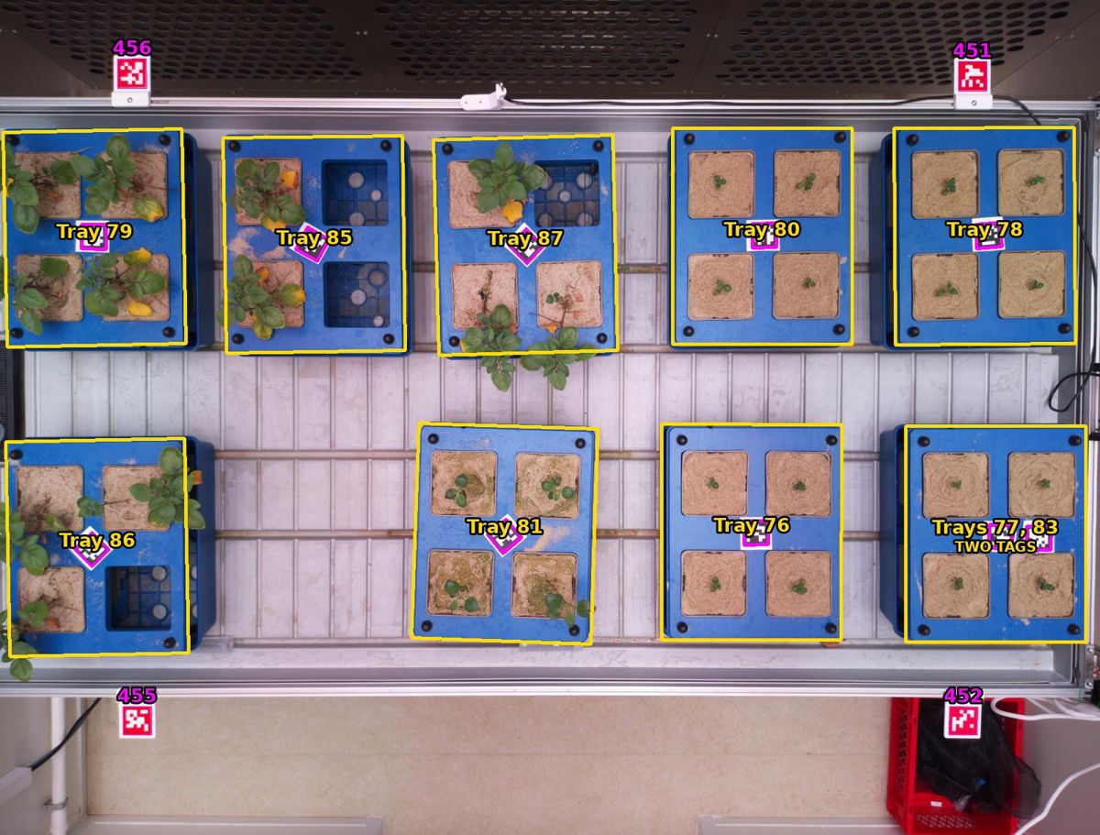
docs/figures/21/live-step4-two-tags.jpg
