txoof/npec-camera-rig/docs/figures/21/live-step8b-skewed.jpg

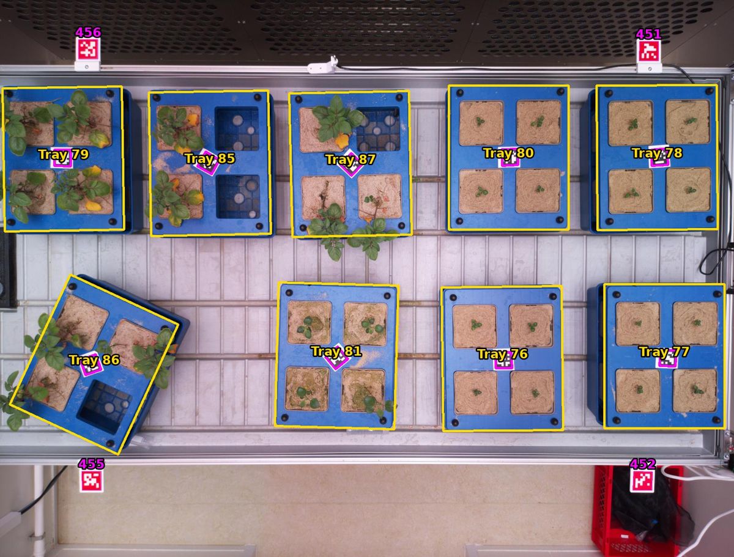
docs/figures/21/live-step8b-skewed.jpg
