txoof/npec-camera-rig/docs/figures/21/live-step8d-touching.jpg

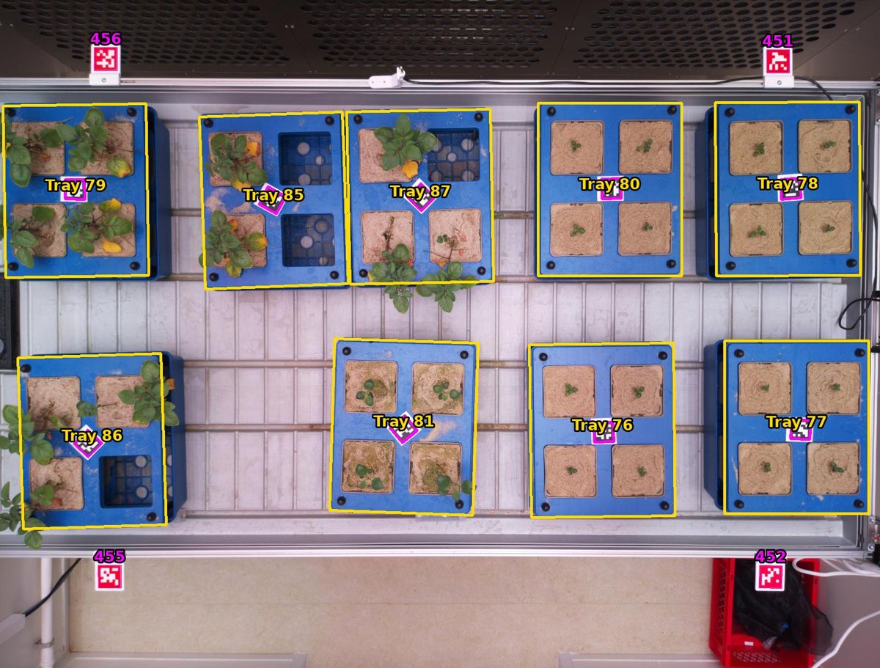
docs/figures/21/live-step8d-touching.jpg
