txoof/npec-camera-rig/experiments/round1-trays/NOTES.md

# Round 1: tray splitting and tray ID (issue #164)

Method, decision rule and results: `docs/metrology-log.md` section 15.5c. This file says how to run it.

## What was run

    PYTHONPATH=src python3 experiments/round1-trays/trays.py --set gaps        # 33 stills
    PYTHONPATH=src python3 experiments/round1-trays/trays.py --set touching    # 143 stills (not yet run)
    PYTHONPATH=src python3 experiments/round1-trays/trays.py --set gaps --limit 1   # quick check

Stills and `rig.db` are read only. Nothing is written into the experiment folder. Tag detections are
cached in `~/scratch/round1-trays/tags/` (delete to detect again); overlays go to
`~/scratch/round1-trays/<set>/<step>_<still>.jpg`. About 6 s per still the first time (full
resolution tag detection), under 1 s with the cache.

FastSAM on the Hailo-8 (needs the accelerator; the HEF in `~/scratch/round1-trays/hailo/`, from
`https://hailo-model-zoo.s3.eu-west-2.amazonaws.com/ModelZoo/Compiled/v2.17.0/hailo8/fast_sam_s.hef`):

    PYTHONPATH=src python3 experiments/round1-trays/fastsam.py --name NAME --margin 1.15 STILL [STILL ...]
    PYTHONPATH=src python3 experiments/round1-trays/fastsam.py --name NAME --tiles grid STILL [STILL ...]
    PYTHONPATH=src python3 experiments/round1-trays/diagnose.py fastsam-NAME.csv

- `--tiles tags` (default): 2-tray tiles placed from the A1 tags, reaching `--margin` trays past the
  outer tags. Use 1.15: at the old 0.75 the tiles cut trays off (27 of 54 missing trays).
- `--tiles grid`: 3000 px tiles every 1000 px over the table rows, no tag positions used.
- The fallback runs by default after the first pass (`--no-fallback` turns it off): around each
  tag whose tray was not found, 8 windows of 2600 px with the found trays painted grey.
- `summarise.py fastsam-NAME.csv` counts a run against the decision rule (15.5c) and writes
  `summary-NAME.csv`; rule 3 uses the provisional row and order slot reference.
- `diagnose.py` follows every tray without a mask through the stages (cut by the tile, low score,
  duplicate, never proposed, mask test) and writes `diagnose-NAME.csv`.

About 1.3 s per still with tag tiles and cached tags, 3.6 s with the grid; add about 4.5 s for the
first tag detection of a still. HailoRT writes `hailort.log` in the working directory (not tracked).

Overlays: `~/scratch/round1-trays/fastsam-stills-m<margin>[-fb]/` or `fastsam-stills-grid[-fb]/`, one per
still at 1/8 size (green OK, orange NO TAG, red MERGED; magenta line from each tag to its tray);
per tile `~/scratch/round1-trays/fastsam/<still>/<tile>.jpg` from the first version.

## Files

- `results-<set>.csv`: one row per still: calibration, validation, lens, tags found, method A and B
  counts, and `b_pass` (the decision rule in 15.5c).
- `fastsam-masks.csv`: first 2-still FastSAM test, one row per mask.
- `fastsam-NAME.csv`: one row per still: trays right, masks, no tag, merged, trays without mask,
  ambiguous tags, time per stage. `fastsam-NAME-masks.csv`: one row per tray mask kept.
- `diagnose-NAME.csv`: per tray without a mask, the furthest stage a candidate reached.
- `shapes-<set>.csv`: one row per blue shape: verdict (one tray, several trays, no tray), trays and
  tag IDs inside, slot by method A and B, fitted size east-west and north-south in mm, area in trays.

## Overlay key

Outline green: one tray. Red: several trays (MERGED). Orange: no tray tag (NO TAG). White: the
fitted rectangle. Magenta dot and number: a tray tag's centre and ID. Text: tray, slot by method B,
fitted size.

## Resume here (state on 2026-10-20)

20 October shuffles done and written up in 15.5l (issue #236): 40 mm tags in cell A1, offset
learned once from layout 1 (`learn_offset.py`, tray type `4x5 40 mm tag in A1` in `shuffle.py`),
then 19 counted layouts with scheduled stills every minute: 3181 of 3184 uncovered positions in the
slot and corner as laid out, 0 wrong after Aaron's check of layouts 3, 11 and 12. Script
`shuffle_day.py` (layouts found from the stills, matched to Aaron's leave times in
`shuffle-times-2026-10-20.csv`); pictures and missing-tag crops in `~/scratch/round2-shuffles/`.

Overnight (15.5l): layout 20b to the stop at 07:04 UTC on 21 October, `overnight.py` by window;
lights off 23:28 to 07:01 UTC, no tag found in the dark, every tag found in every lit still,
trays back within 0.65 mm in the morning.

    PYTHONPATH=<worktree>/src <venv python> shuffle_day.py --experiment "tray tracking 26.10.20" --until 2026-10-21T07:05:00
    PYTHONPATH=<worktree>/src <venv python> overnight.py shuffle-day-2026-10-20_57f74959.csv

## State on 2026-10-19

19 October sessions done and written up: 15.5f (pots, edge tags), 15.5g (footprint from the
tag), 15.5h (cell A1 tags), 15.5i (shuffling proof of concept). Result: trays placed from the
A1 cell tag with one common offset (`footprint.py --common`, `shuffle.py`, `TRAY_TYPES`) placed
264 of 264 in 15.5h and tracked 11 of 12 trays through five random shuffles (197 of 198
positions); tray 6 failed in every still because its tag lay turned 180 in its cell. FastSAM tray
splitting fails on touching trays with pots. Agreed with Aaron (2026-10-19): this is the proof of
concept; every cell tag must lie the same way round (arrow on each tag). Follow-ups in #224, among
them a tag anywhere inside the tray (long term) and detecting a tag lying the wrong way.

    PYTHONPATH=<worktree>/src <venv python> shuffle.py --experiment "simple segmentation test" --rounds 1 2 3 4 5 2

## Earlier state (2026-10-17)

Splitting: issue #164, merged (#172). Tracking: issue #171, merged (#212). **Next: the photo
session with pots in the wells on Monday 19 October, issue #213, branch `213-pots-session`.**
Method: `docs/metrology-log.md` 15.5f. The session checklist is a comment on #213. Splitting:
15.5c, tracking: 15.5d. Tray facts: `reference/trays.md`.

Sessions: each photo day has a file in `sessions/` (stills folder, record of still IDs per step,
step sets, steps where nothing moved, and each tray's tags, the first tag placing and naming the
tray). Every script takes `--session NAME`; the default is `2026-10-15`, which reproduces 15.5c
and 15.5d (checked 2026-10-18: tracking and summary outputs byte for byte, FastSAM masks of 2
stills). For 19 October, write `sessions/2026-10-19.json` from the confirmed tag table once the new
experiment's folder exists. `fastsam.py --fill-holes` is the second run of 15.5f.
Stills for 19 October: `capture_session.py --experiment pots-2026-10-19 --step N --title T --count C
[--every 15]`, under the `hardware` label only; it adds each still to `session-2026-10-19.csv` here.
Every step of a session must be in one of its sets (gaps, touching): `track.py` stops on a step
in neither. `track.py` writes its evidence pictures to `track/evidence-<run name>/`, drawn on the
overlays of `--overlays` (default `fastsam-stills-m1.15-fb`; pass `fastsam-stills-m1.15-fb-holes`
for a `--fill-holes` run).

Where the data is:
- HEF: `~/scratch/round1-trays/hailo/fast_sam_s.hef` (SHA-256 in 15.5c). Tag detections for all 176
  stills cached in `~/scratch/round1-trays/tags/`. Overlays in `~/scratch/round1-trays/`.
- Full run: `fastsam-full176.csv`, `fastsam-full176-masks.csv`, `summary-full176.csv` here.
- Tracking: `track-full176.csv`, `track-full176-moves.csv` here; timeline in
  `~/scratch/round1-trays/track/`, evidence overlays in `track/evidence/` (15 October, made before the per-run folders).

Commands (run from the worktree root, `<worktree>` being its full path; tests by explicit path,
pytest's default is `tests/` only):

    PYTHONPATH="$(pwd)/src" /home/pi/npec_camera_rig/.venv/bin/python3 -m pytest -q experiments/round1-trays -p no:xdist
    cd experiments/round1-trays
    PYTHONPATH=<worktree>/src /home/pi/npec_camera_rig/.venv/bin/python3 track.py fastsam-full176.csv
    PYTHONPATH=<worktree>/src /home/pi/npec_camera_rig/.venv/bin/python3 fastsam.py --session 2026-10-19 --name NAME --margin 1.15 STILL ...
    PYTHONPATH=<worktree>/src /usr/bin/python3 summarise.py fastsam-full176.csv

Done: raw tracking and patches 1 to 3 (15.5d), 2078 measured + 31 patched of 2112 trays, 173 of
176 stills. Evidence overlays in `~/scratch/round1-trays/track/evidence/`.

Open for Aaron:
- Success rate that is good enough: deferred until the tracking result (15.5d).
- Slot reference for rule 3: row and order is provisional.
- Later: the 2 x 2 and 1 x 1
  tray configurations (`reference/trays.md`, "Not yet known").
