txoof/npec-camera-rig/experiments/round1-benchy-mesh/results.txt

STL header: iPhonotype geometry only; source coordinates preserved; STL has no units
STL: 12500 vertices, 25000 triangles, surface 84672 mm2, watertight True, mean triangle 3.39 mm2
USDZ: metersPerUnit 1, upAxis Y, creator 'RealityKit Object Capture <11.3.2.> <3.9.4>'
USDZ config: 'detail level: .mobile, geometry: {nil}, isObjectMaskingEnabled: true, sampleOrdering: .sequential, featureSensitivity: .high, ignoreBoundingBox: true, isQuadmeshModelRequest: false'
USDZ mesh identical to STL: True
board seen from above: 35127 mm2, rectangle 188.3 x 188.3 mm
board plane: tilt -9.9 and 5.1 mm per m, spread of board cells about it 0.36 mm (SD)

objects more than 1.0 mm above the board plane:
  centre x     0.6 z  -107.1 mm: area    59.6 mm2, top  5.71 mm above board, widest span 11.81 mm, rectangle  7.20 x 11.41 mm
  centre x    -0.2 z   -50.5 mm: area  1343.7 mm2, top 23.62 mm above board, widest span 58.32 mm, rectangle 49.68 x 53.33 mm
  centre x   -49.2 z     0.5 mm: area  2009.9 mm2, top 28.57 mm above board, widest span 67.02 mm, rectangle 60.30 x 61.92 mm
  centre x    55.6 z   -19.1 mm: area    28.0 mm2, top  1.34 mm above board, widest span  6.51 mm, rectangle  5.20 x  6.40 mm
  centre x    48.0 z     1.7 mm: area   413.7 mm2, top 18.80 mm above board, widest span 41.00 mm, rectangle 28.24 x 37.67 mm
  centre x   107.6 z     0.3 mm: area    50.3 mm2, top  7.80 mm above board, widest span  8.35 mm, rectangle  7.80 x  8.00 mm
  centre x    -1.8 z    48.3 mm: area   753.4 mm2, top 20.80 mm above board, widest span 50.62 mm, rectangle 40.10 x 45.50 mm
  centre x    -0.2 z   107.3 mm: area    55.1 mm2, top 11.23 mm above board, widest span  9.56 mm, rectangle  6.65 x  9.33 mm

objects more than 2.0 mm above the board plane:
  centre x     0.6 z  -107.1 mm: area    45.4 mm2, top  5.71 mm above board, widest span  8.94 mm, rectangle  6.64 x  8.10 mm
  centre x    -0.2 z   -50.5 mm: area  1343.7 mm2, top 23.62 mm above board, widest span 58.32 mm, rectangle 49.68 x 53.33 mm
  centre x   -49.2 z     0.5 mm: area  2009.9 mm2, top 28.57 mm above board, widest span 67.02 mm, rectangle 60.30 x 61.92 mm
  centre x    48.0 z     1.7 mm: area   413.7 mm2, top 18.80 mm above board, widest span 41.00 mm, rectangle 28.24 x 37.67 mm
  centre x   107.6 z     0.3 mm: area    49.8 mm2, top  7.79 mm above board, widest span  8.34 mm, rectangle  7.80 x  7.80 mm
  centre x    -1.8 z    48.3 mm: area   753.4 mm2, top 20.80 mm above board, widest span 50.62 mm, rectangle 40.10 x 45.50 mm
  centre x    -0.2 z   107.3 mm: area    55.1 mm2, top 11.23 mm above board, widest span  9.56 mm, rectangle  6.65 x  9.33 mm

objects more than 3.0 mm above the board plane:
  centre x     0.4 z  -107.1 mm: area    38.6 mm2, top  5.69 mm above board, widest span  8.16 mm, rectangle  6.02 x  7.77 mm
  centre x    -0.2 z   -50.5 mm: area  1343.7 mm2, top 23.62 mm above board, widest span 58.32 mm, rectangle 49.68 x 53.33 mm
  centre x   -49.2 z     0.5 mm: area  2009.9 mm2, top 28.57 mm above board, widest span 67.02 mm, rectangle 60.30 x 61.92 mm
  centre x    48.0 z     1.7 mm: area   413.7 mm2, top 18.80 mm above board, widest span 41.00 mm, rectangle 28.24 x 37.67 mm
  centre x   107.6 z     0.3 mm: area    49.8 mm2, top  7.79 mm above board, widest span  8.34 mm, rectangle  7.80 x  7.80 mm
  centre x    -1.8 z    48.3 mm: area   753.4 mm2, top 20.80 mm above board, widest span 50.62 mm, rectangle 40.10 x 45.50 mm
  centre x    -0.2 z   107.3 mm: area    55.1 mm2, top 11.23 mm above board, widest span  9.56 mm, rectangle  6.65 x  9.33 mm

objects more than 5.0 mm above the board plane:
  centre x    -0.2 z   -50.5 mm: area  1343.7 mm2, top 23.62 mm above board, widest span 58.32 mm, rectangle 49.68 x 53.33 mm
  centre x   -49.2 z     0.5 mm: area  2009.9 mm2, top 28.57 mm above board, widest span 67.02 mm, rectangle 60.30 x 61.92 mm
  centre x    48.0 z     1.7 mm: area   413.7 mm2, top 18.80 mm above board, widest span 41.00 mm, rectangle 28.24 x 37.67 mm
  centre x   107.6 z     0.3 mm: area    49.6 mm2, top  7.79 mm above board, widest span  8.32 mm, rectangle  7.60 x  7.80 mm
  centre x    -1.8 z    48.3 mm: area   753.4 mm2, top 20.80 mm above board, widest span 50.62 mm, rectangle 40.10 x 45.50 mm
  centre x    -0.2 z   107.3 mm: area    55.1 mm2, top 11.23 mm above board, widest span  9.56 mm, rectangle  6.65 x  9.33 mm
