txoof/npec-camera-rig/experiments/round2-run/sessions/shuffle-maps-2026-10-22.pdf

# Shuffle map 0 of 12

Map 0 is the layout at the start, read by the rig at 11:11 on 22 October (09:11 UTC). Nothing to move.

Date ____________ Started ________ Finished ________

Put each tray in the slot shown. Its tag (the black square in the striped cell A1) goes in the corner
shown: lower left, or upper right (tray turned around). Tick each tray when it is in place.

## NORTH

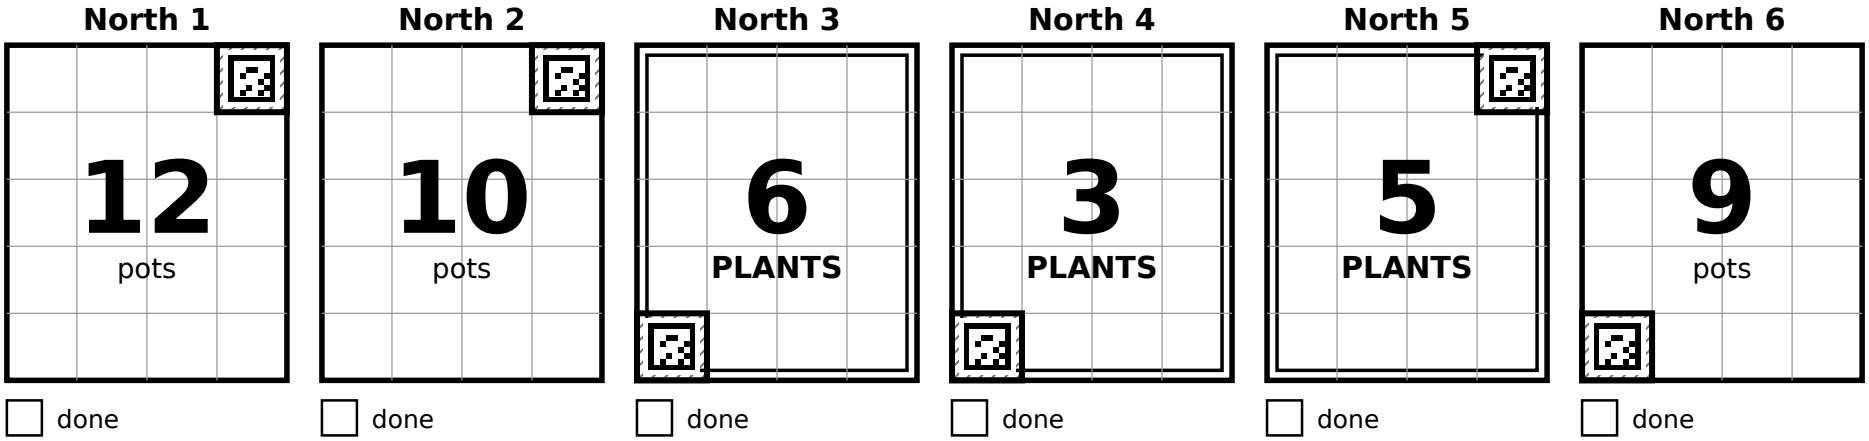
[picture p120: figure]
pots; North 1; done; North 2; PLANTS; North 3; North 4; North 5; North 6
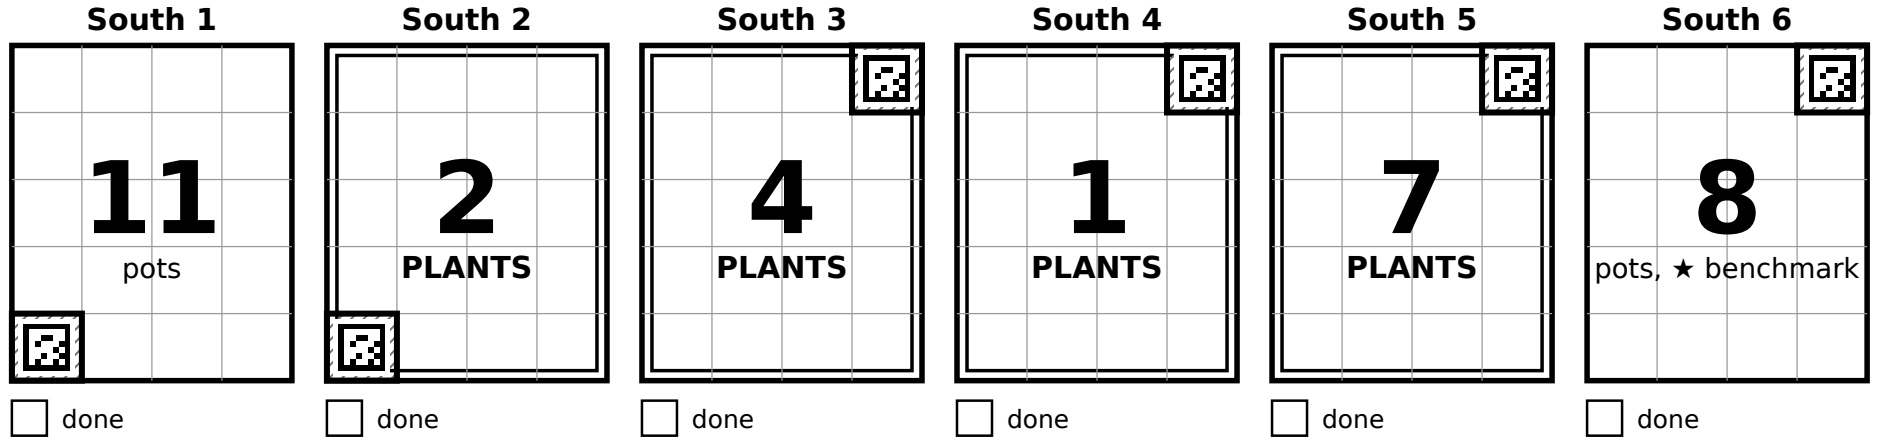
[picture p121: figure]
pots; South 1; done; PLANTS; South 2; South 3; South 4; South 5; pots, ★ benchmark; South 6

## SOUTH

Double border: PLANTS (trays 1 to 7). Single border: pots (8 to 12); the benchmark is on tray 8. Seed 20261022. Known answer: shuffle-maps-2026-10-22.json

Shuffle map 1 of 12 Date ____________ Started ________ Finished ________

Put each tray in the slot shown. Its tag (the black square in the striped cell A1) goes in the corner shown: lower left, or upper right (tray turned around). Tick each tray when it is in place.

## NORTH

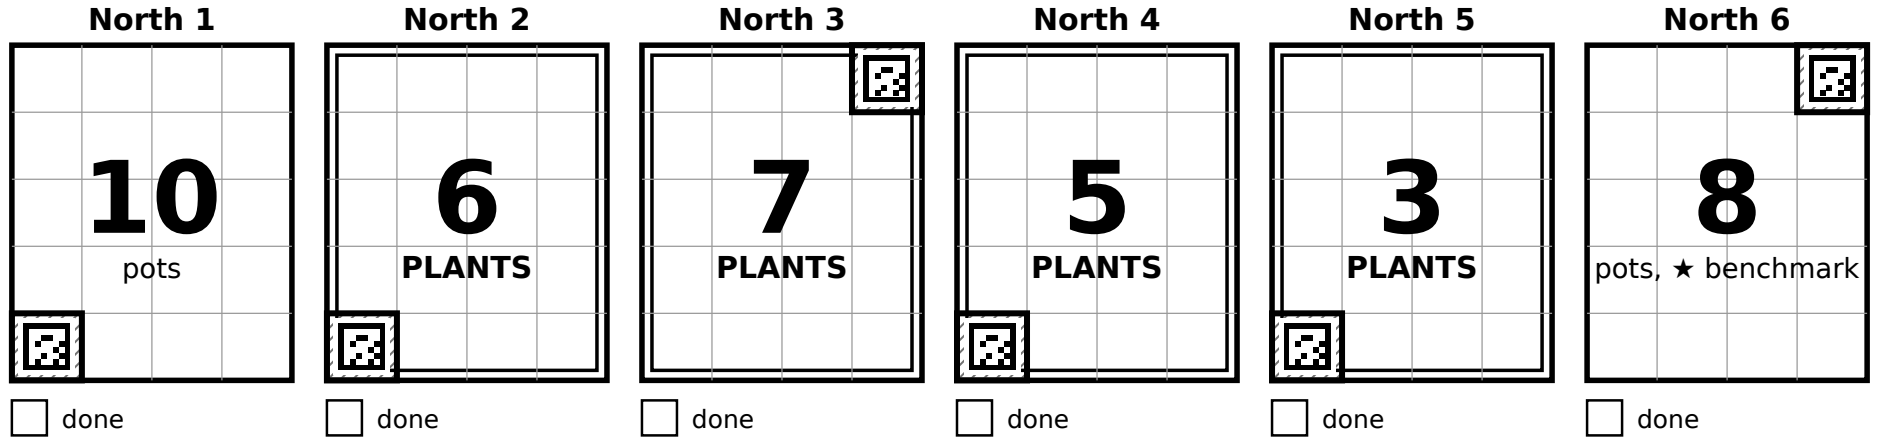
[picture p122: figure]
pots; North 1; done; PLANTS; North 2; North 3; North 4; North 5; pots, ★ benchmark; North 6
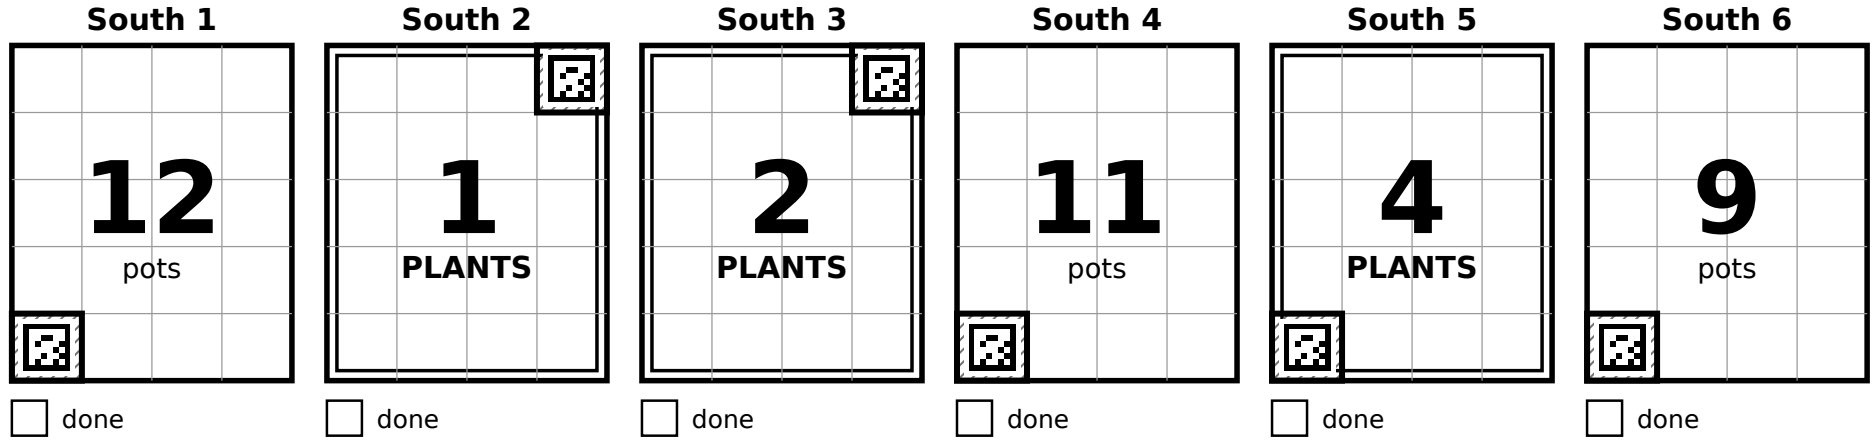
[picture p123: figure]
pots; South 1; done; PLANTS; South 2; South 3; South 4; South 5; South 6

## SOUTH

Shuffle map 2 of 12 Date ____________ Started ________ Finished ________

Put each tray in the slot shown. Its tag (the black square in the striped cell A1) goes in the corner shown: lower left, or upper right (tray turned around). Tick each tray when it is in place.

## NORTH

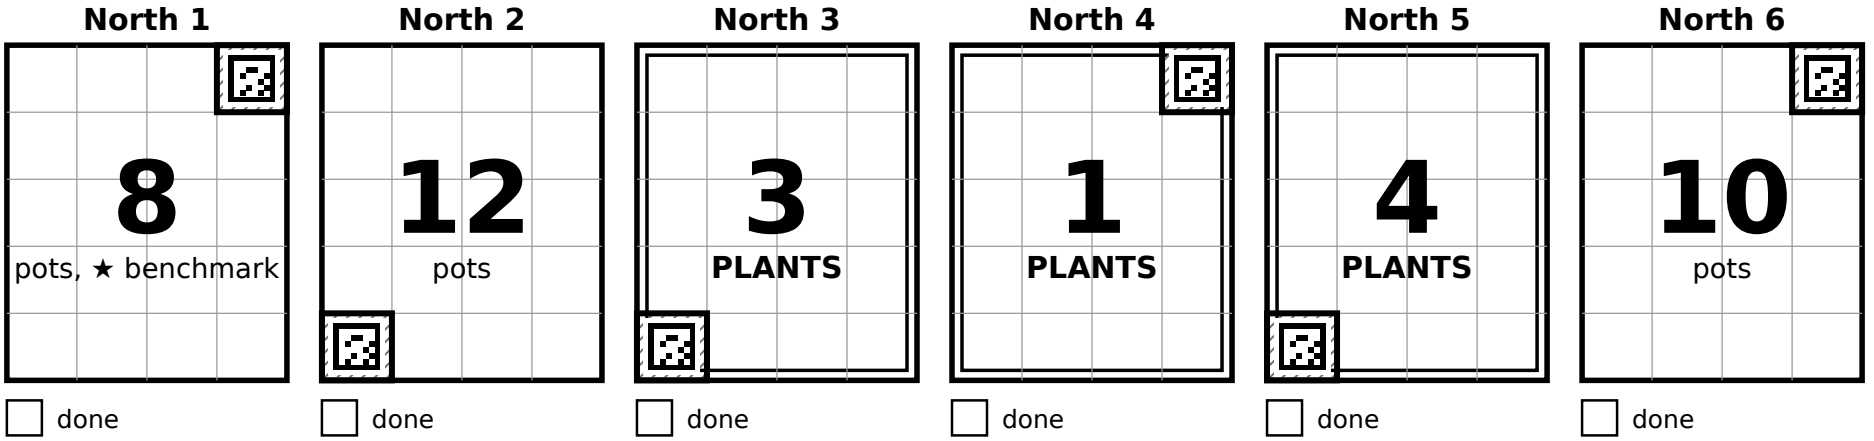
[picture p124: figure]
pots, ★ benchmark; North 1; done; pots; North 2; PLANTS; North 3; North 4; North 5; North 6
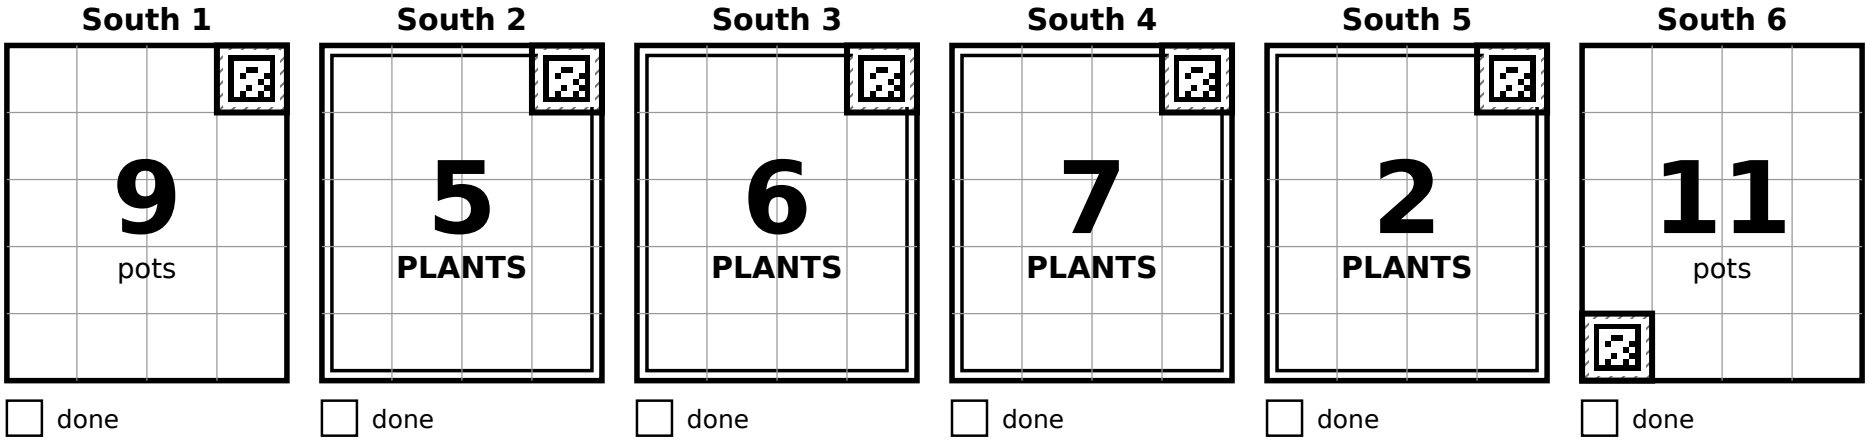
[picture p125: figure]
pots; South 1; done; PLANTS; South 2; South 3; South 4; South 5; South 6

## SOUTH

Shuffle map 3 of 12 Date ____________ Started ________ Finished ________

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

## NORTH

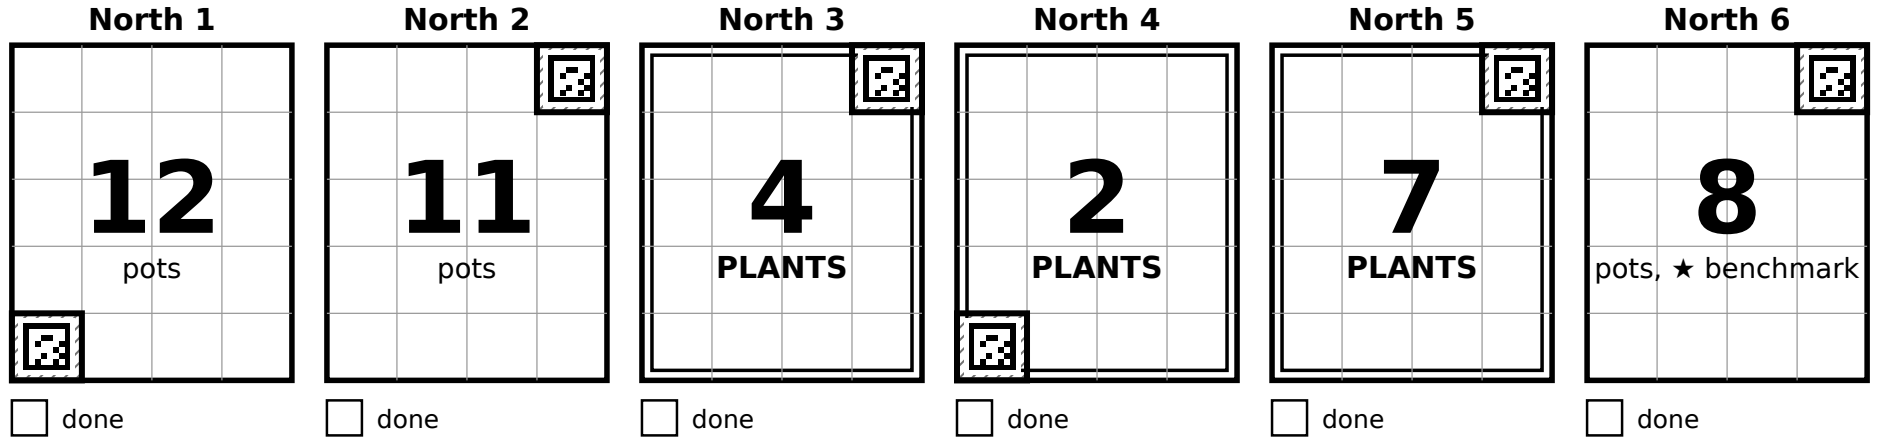
[picture p126: figure]
pots; North 1; done; North 2; PLANTS; North 3; North 4; North 5; pots, ★ benchmark; North 6
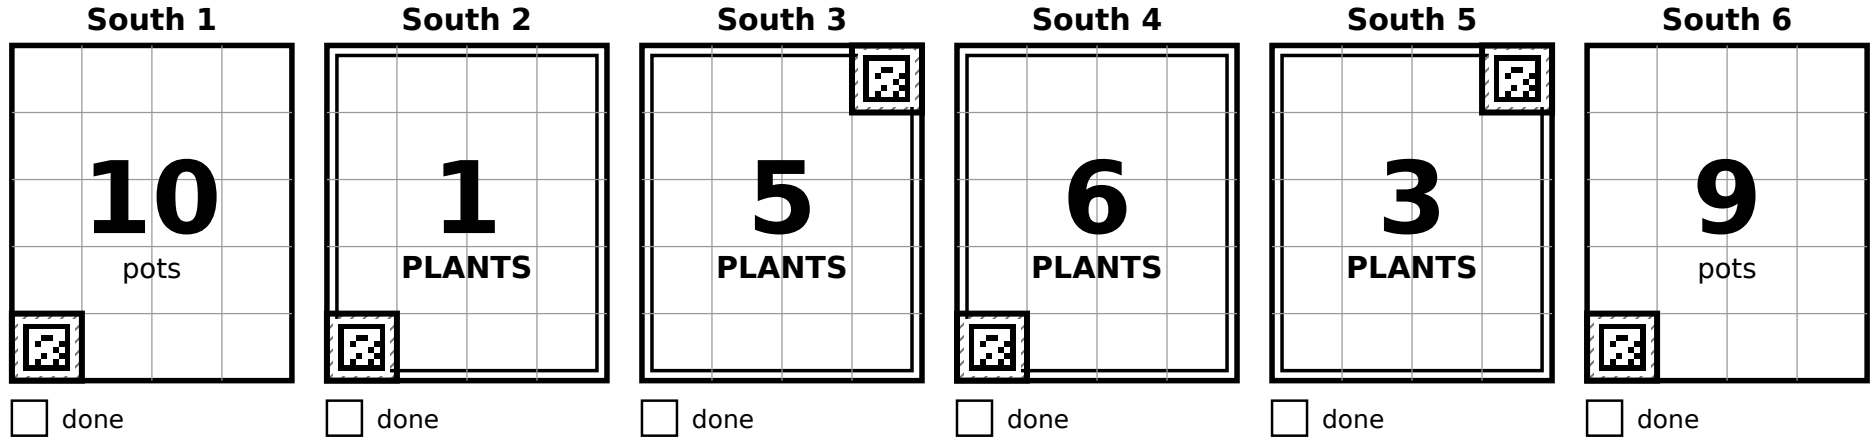
[picture p127: figure]
pots; South 1; done; PLANTS; South 2; South 3; South 4; South 5; South 6

## SOUTH

Shuffle map 4 of 12 Date ____________ Started ________ Finished ________

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

## NORTH

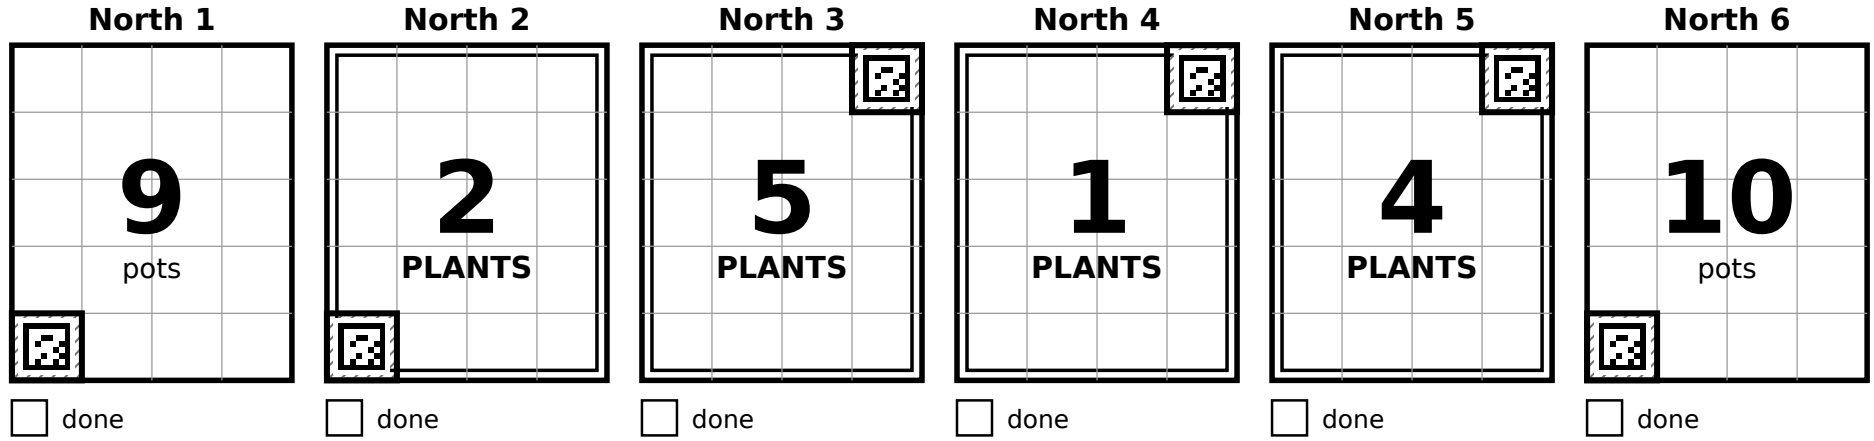
[picture p128: figure]
pots; North 1; done; PLANTS; North 2; North 3; North 4; North 5; North 6
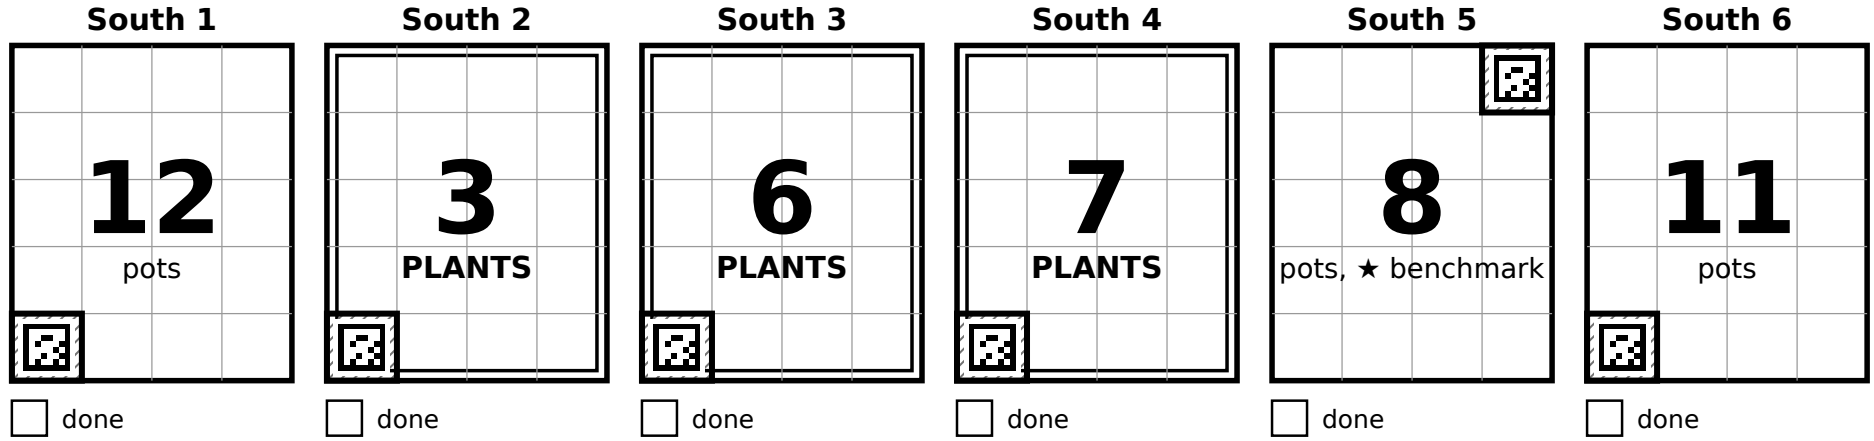
[picture p129: figure]
pots; South 1; done; PLANTS; South 2; South 3; South 4; pots, ★ benchmark; South 5; South 6

## SOUTH

Shuffle map 5 of 12 Date ____________ Started ________ Finished ________

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

## NORTH

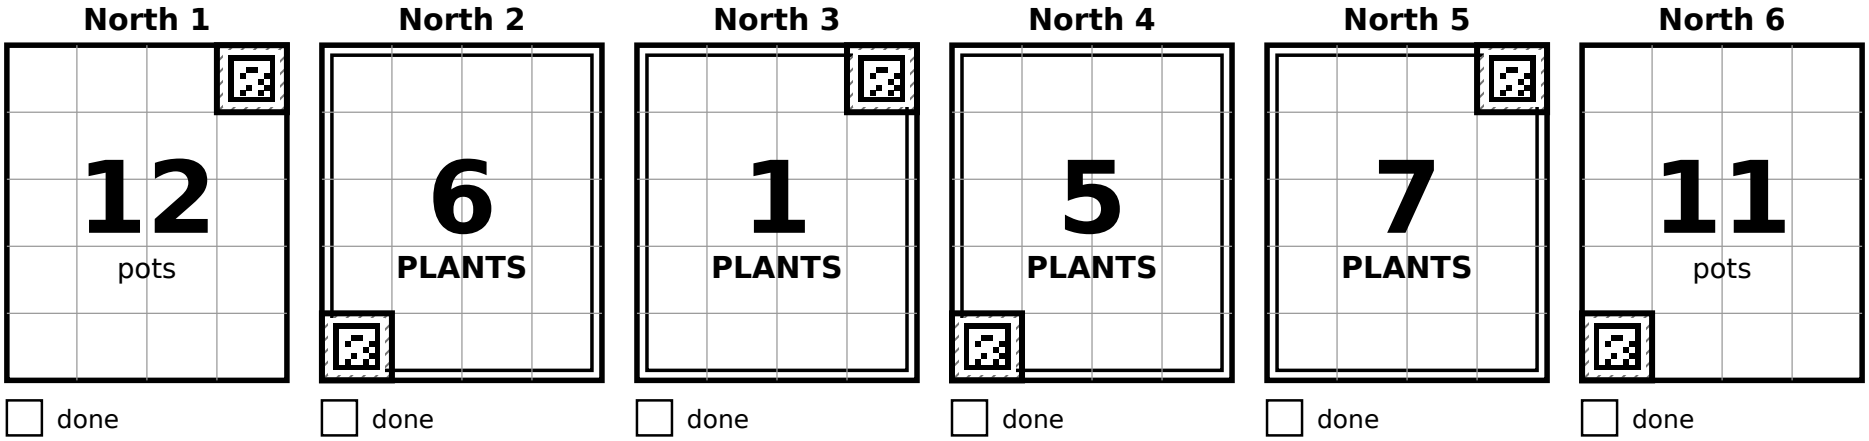
[picture p130: figure]
pots; North 1; done; PLANTS; North 2; North 3; North 4; North 5; North 6
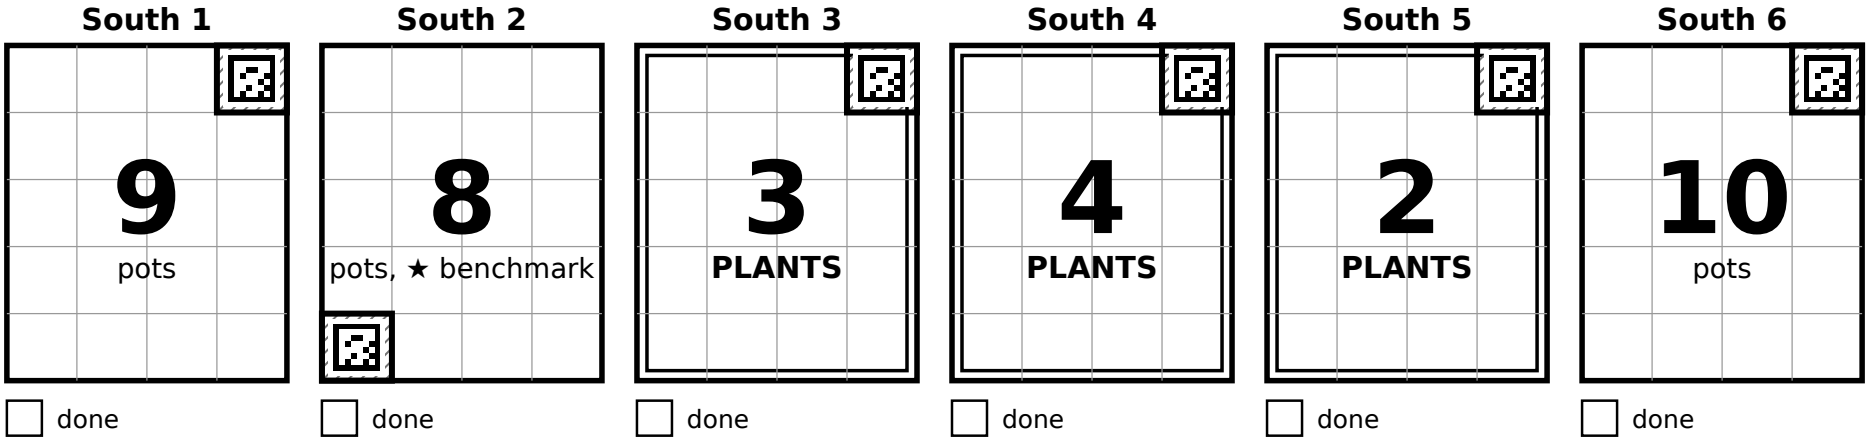
[picture p131: figure]
pots; South 1; done; pots, ★ benchmark; South 2; PLANTS; South 3; South 4; South 5; South 6

## SOUTH

Shuffle map 6 of 12 Date ____________ Started ________ Finished ________

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

## NORTH

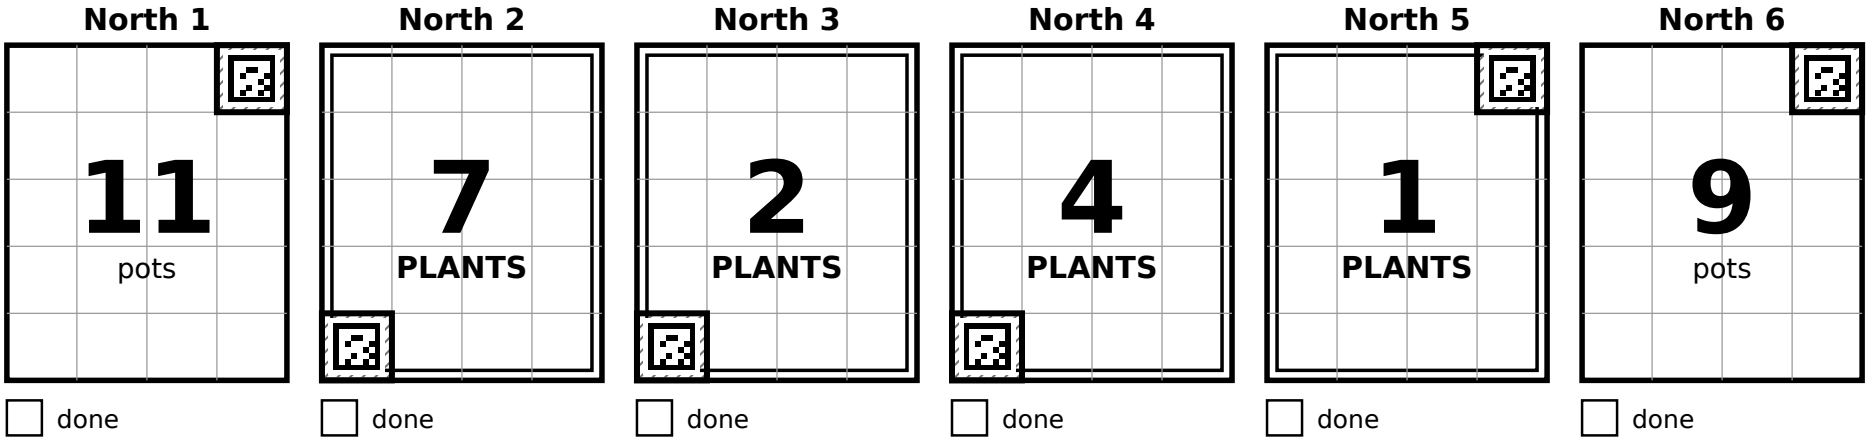
[picture p132: figure]
pots; North 1; done; PLANTS; North 2; North 3; North 4; North 5; North 6
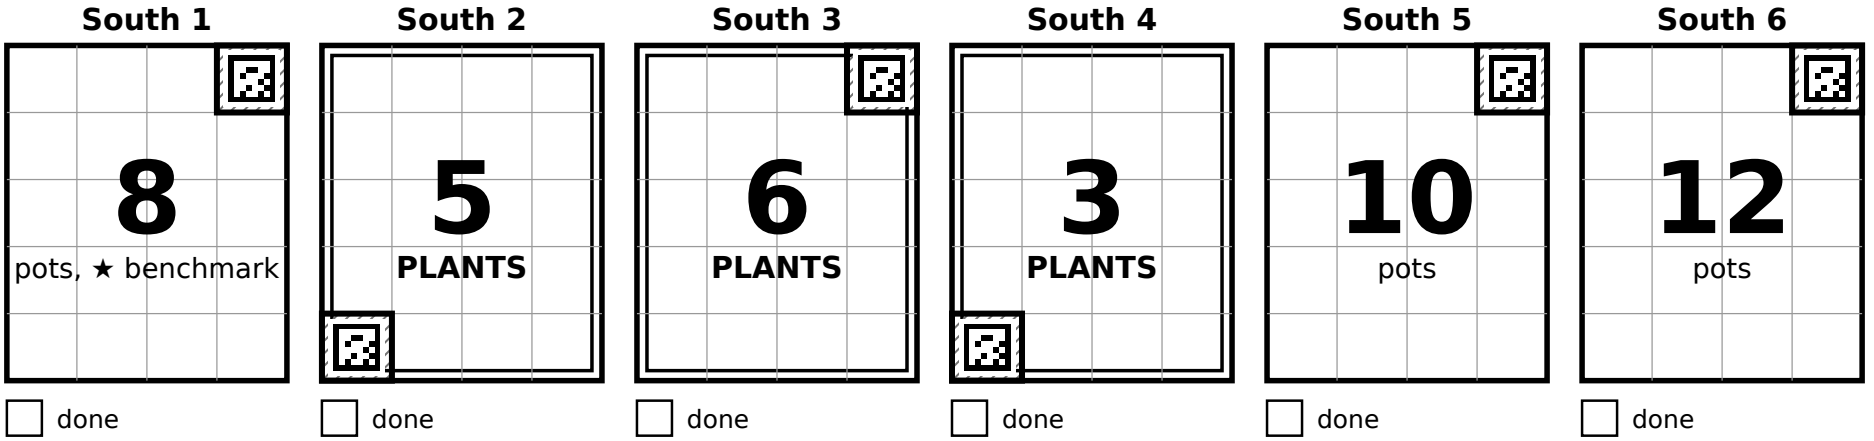
[picture p133: figure]
pots, ★ benchmark; South 1; done; PLANTS; South 2; South 3; South 4; pots; South 5; South 6

## SOUTH

Shuffle map 7 of 12 Date ____________ Started ________ Finished ________

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

## NORTH

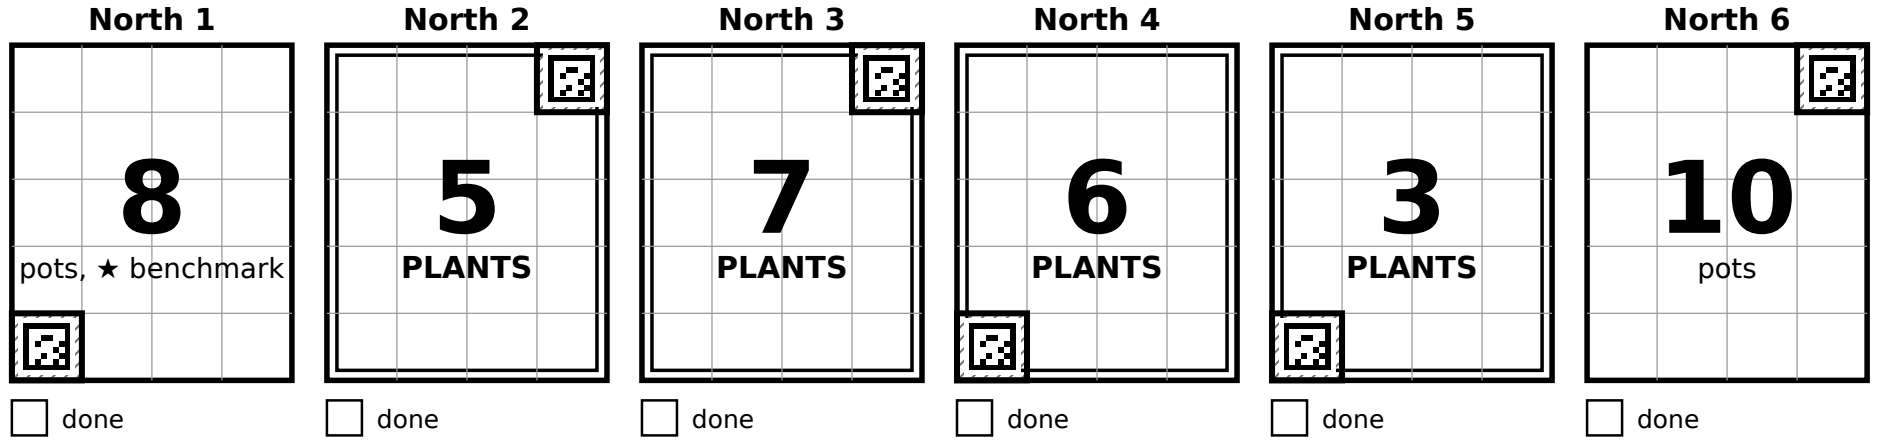
[picture p134: figure]
pots, ★ benchmark; North 1; done; PLANTS; North 2; North 3; North 4; North 5; pots; North 6
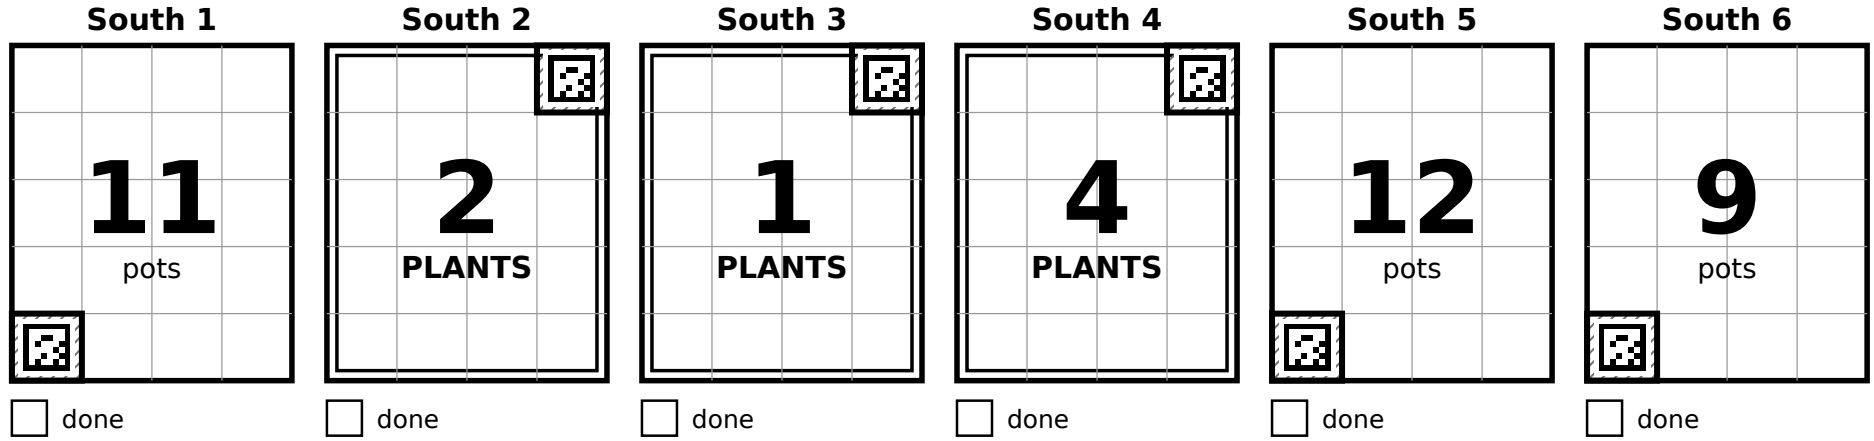
[picture p135: figure]
pots; South 1; done; PLANTS; South 2; South 3; South 4; South 5; South 6

## SOUTH

Shuffle map 8 of 12 Date ____________ Started ________ Finished ________

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

## NORTH

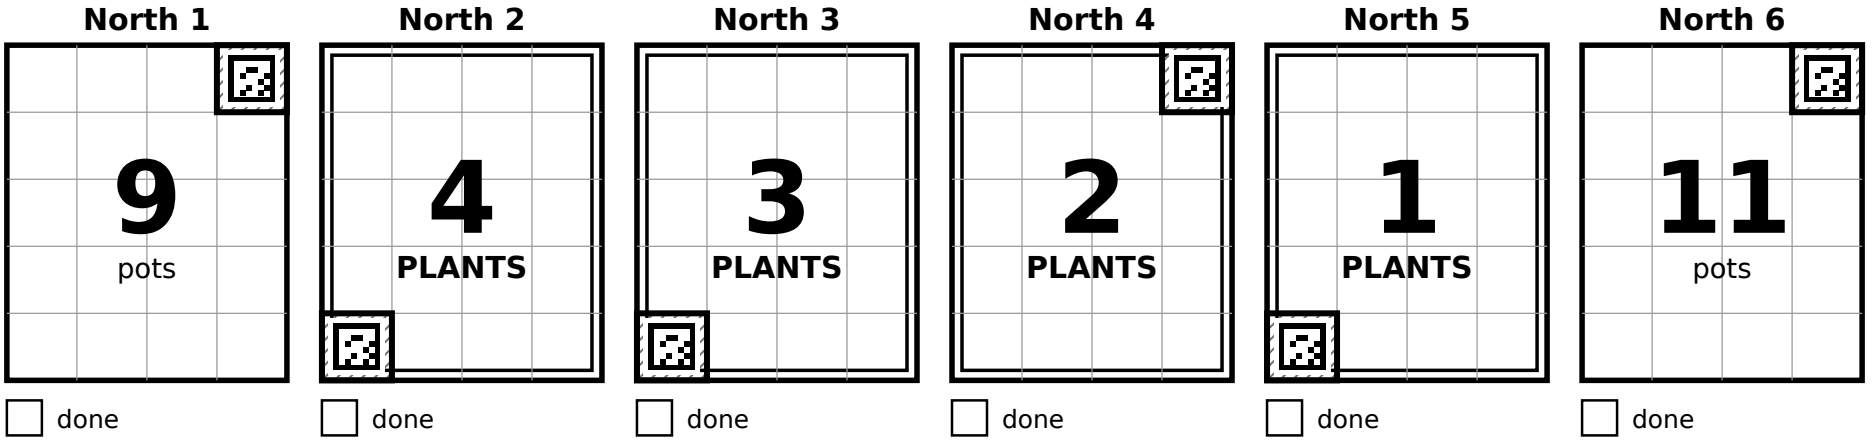
[picture p136: figure]
pots; North 1; done; PLANTS; North 2; North 3; North 4; North 5; North 6
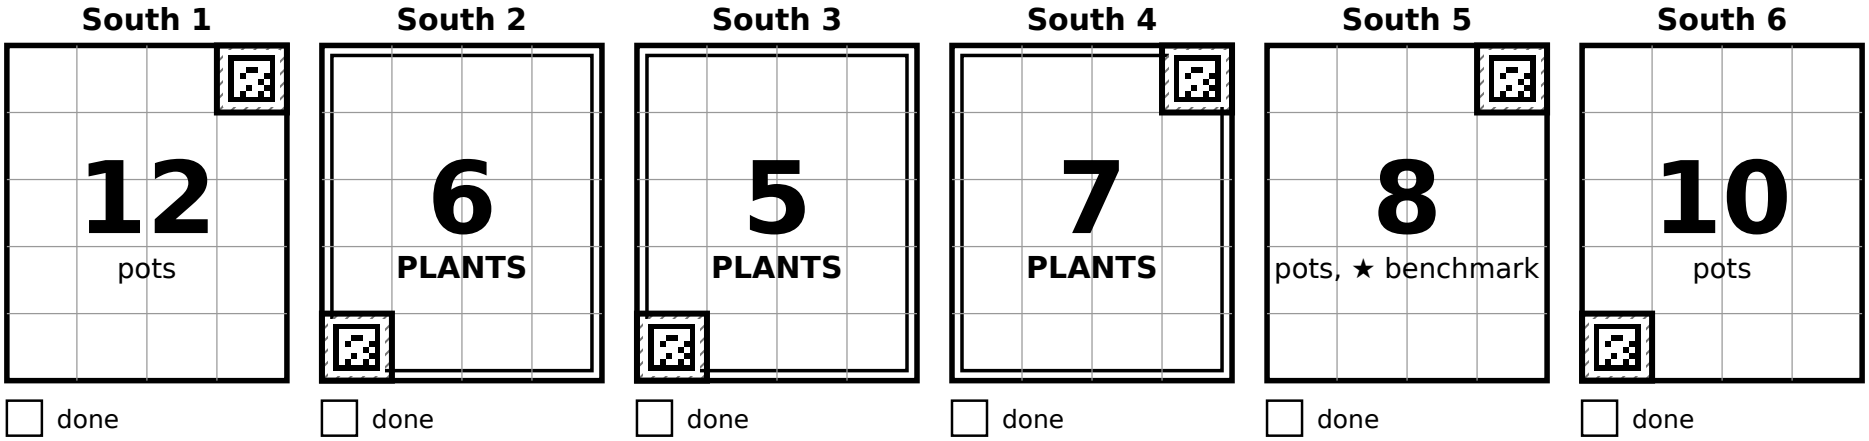
[picture p137: figure]
pots; South 1; done; PLANTS; South 2; South 3; South 4; pots, ★ benchmark; South 5; South 6

## SOUTH

Shuffle map 9 of 12 Date ____________ Started ________ Finished ________

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

## NORTH

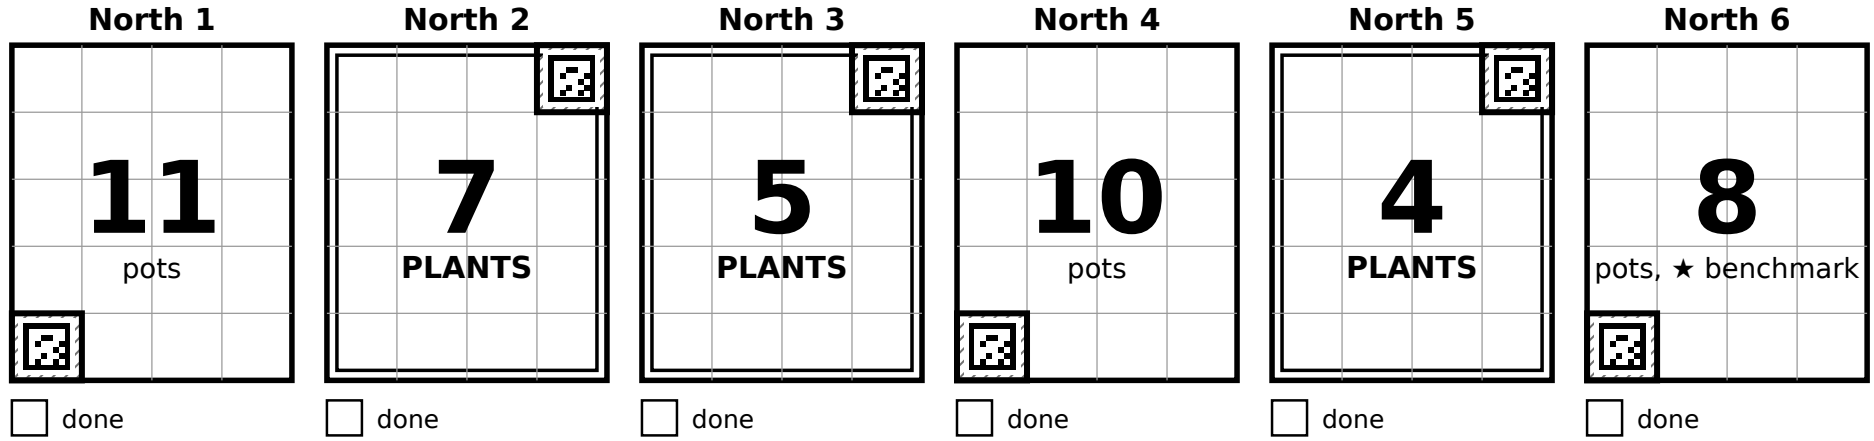
[picture p138: figure]
pots; North 1; done; PLANTS; North 2; North 3; North 4; North 5; pots, ★ benchmark; North 6
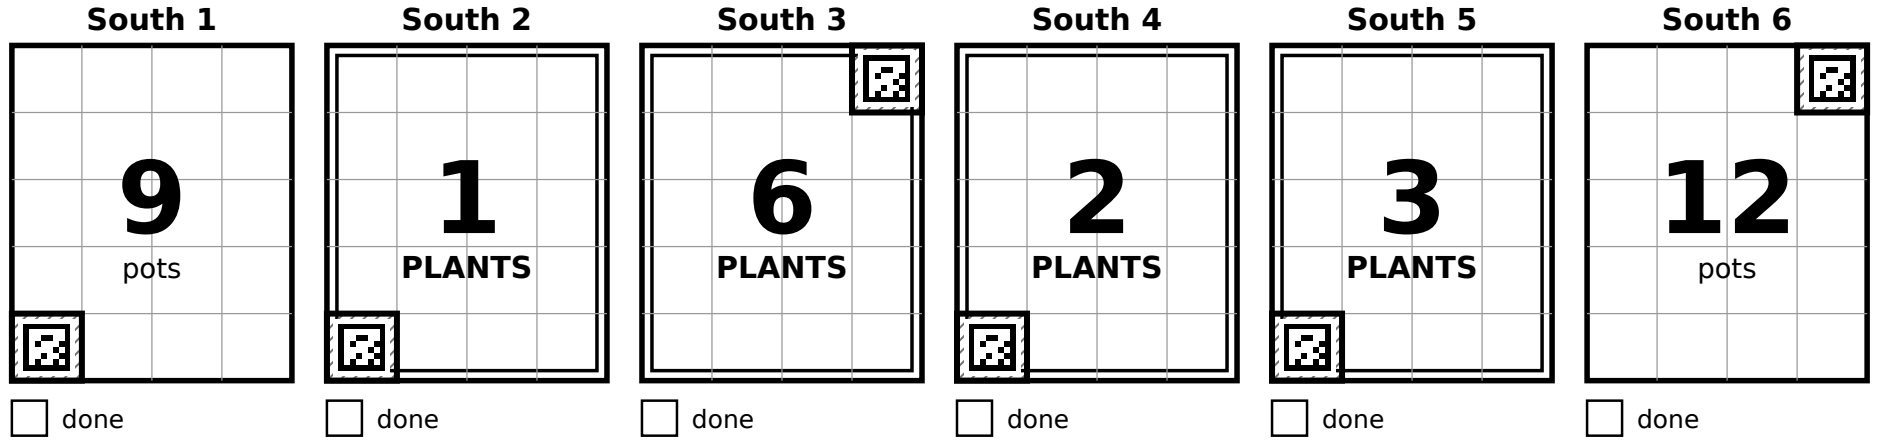
[picture p139: figure]
pots; South 1; done; PLANTS; South 2; South 3; South 4; South 5; South 6

## SOUTH

Shuffle map 10 of 12 Date ____________ Started ________ Finished ________

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

## NORTH

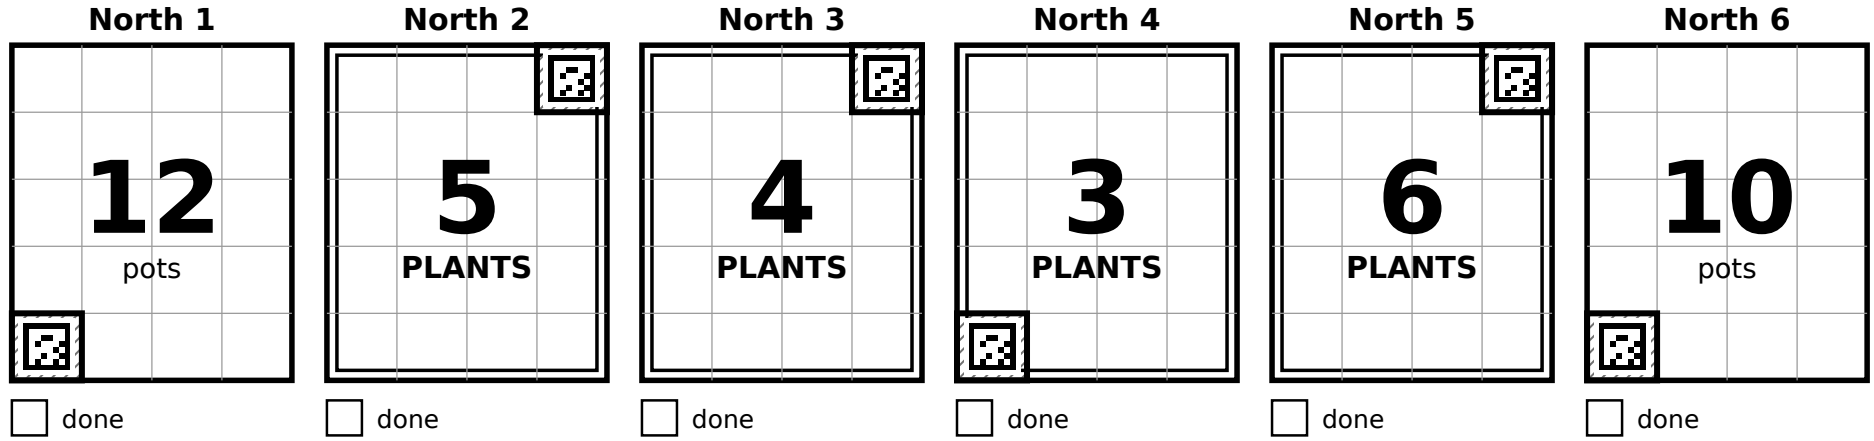
[picture p140: figure]
pots; North 1; done; PLANTS; North 2; North 3; North 4; North 5; North 6
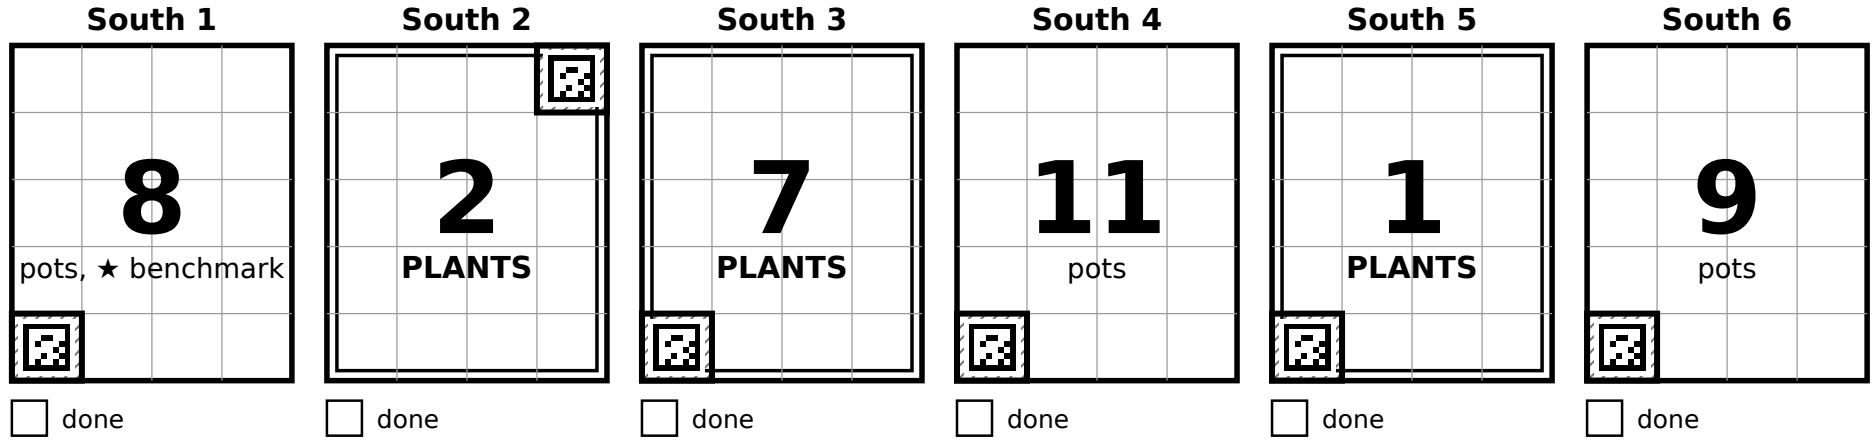
[picture p141: figure]
pots, ★ benchmark; South 1; done; PLANTS; South 2; South 3; pots; South 4; South 5; South 6

## SOUTH

Shuffle map 11 of 12 Date ____________ Started ________ Finished ________

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

## NORTH

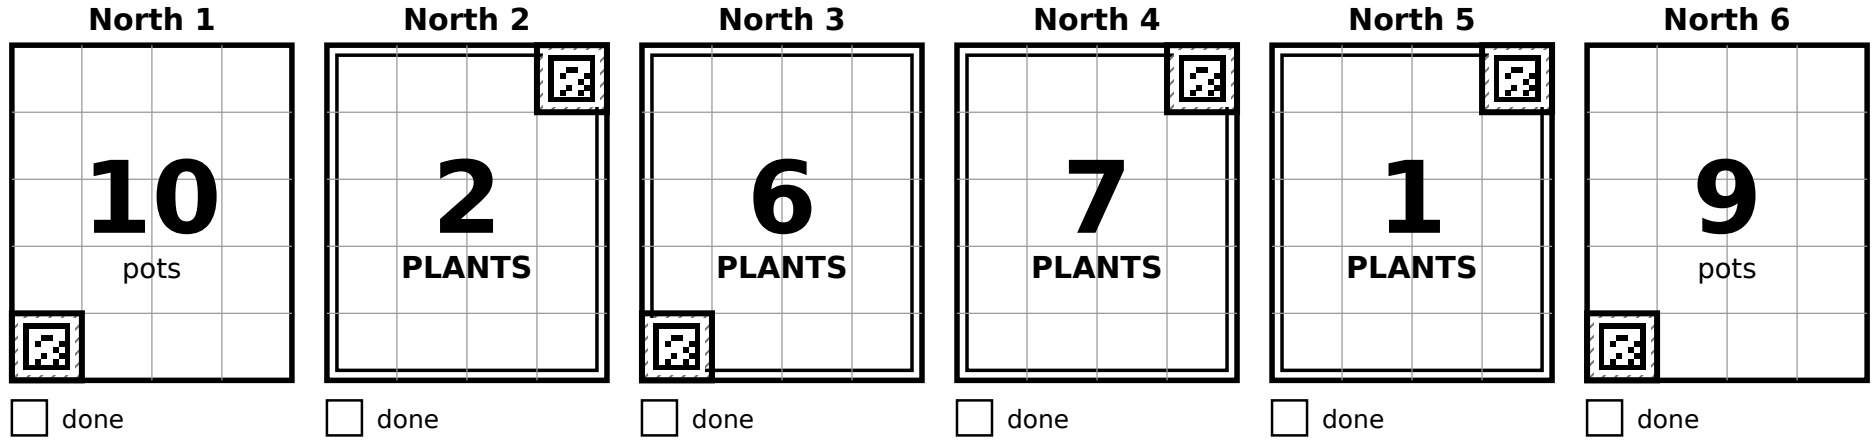
[picture p142: figure]
pots; North 1; done; PLANTS; North 2; North 3; North 4; North 5; North 6
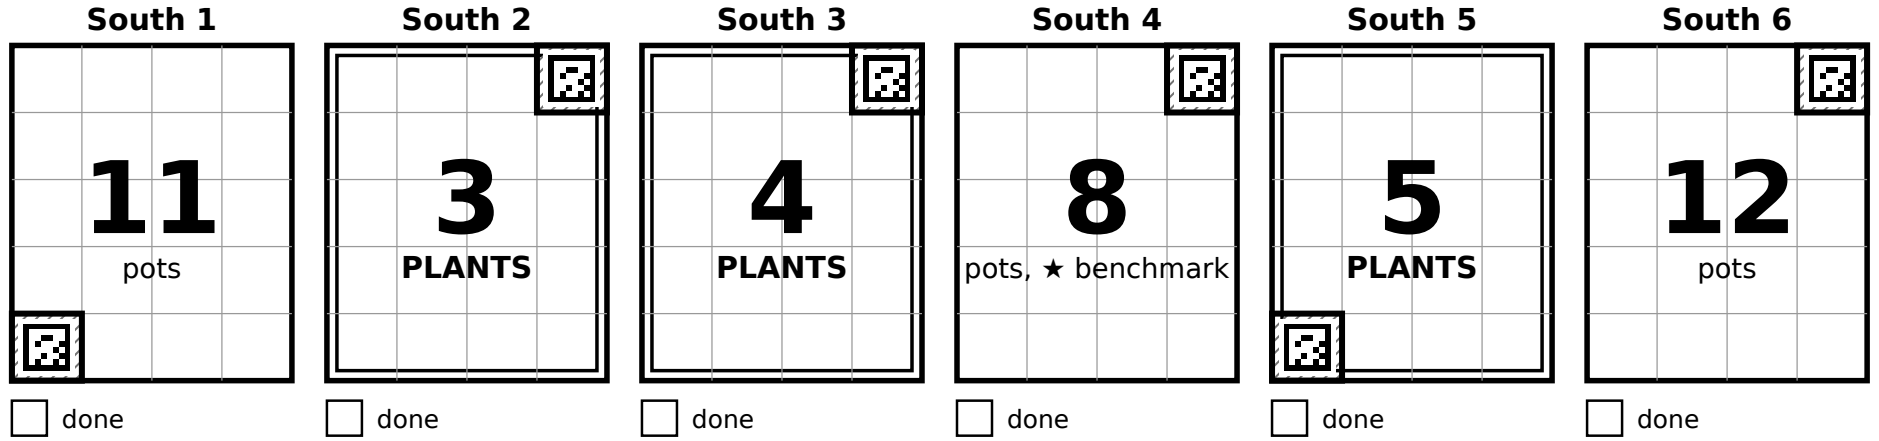
[picture p143: figure]
pots; South 1; done; PLANTS; South 2; South 3; pots, ★ benchmark; South 4; South 5; South 6

## SOUTH

Shuffle map 12 of 12 Date ____________ Started ________ Finished ________

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

## NORTH

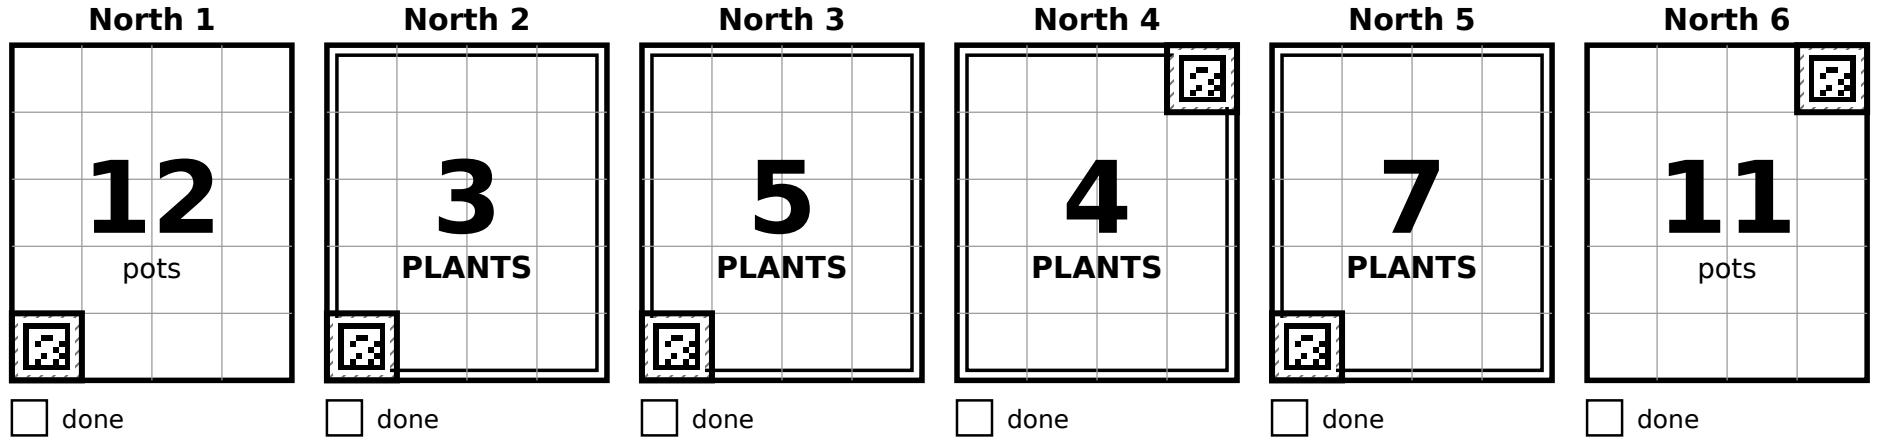
[picture p144: figure]
pots; North 1; done; PLANTS; North 2; North 3; North 4; North 5; North 6
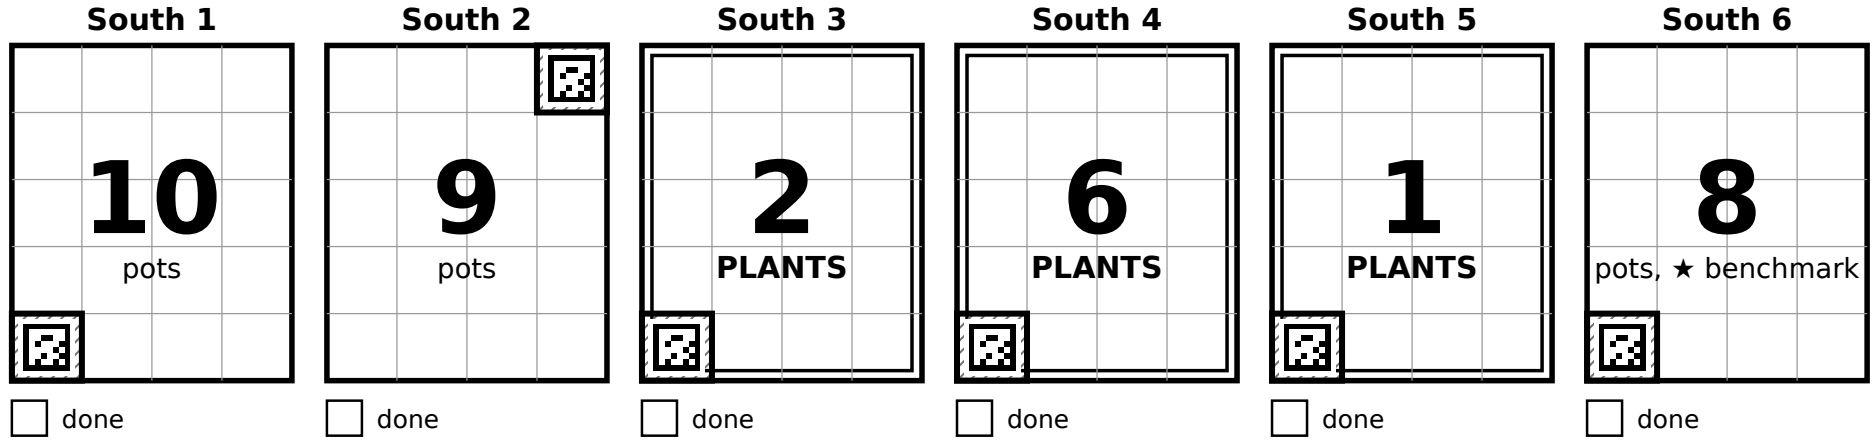
[picture p145: figure]
pots; South 1; done; South 2; PLANTS; South 3; South 4; South 5; pots, ★ benchmark; South 6

## SOUTH
