txoof/npec-camera-rig/experiments/round1/tag-detector-stills.csv

group | step | still | found_A | found_C | secs_A1 | secs_C1 | secs_A2 | secs_C2 | secs_A3 | secs_C3 | loadavg_1min
session1 | 1 | 075756_789328 | 1 2 3 4 6 7 8 9 10 11 12 450 451 452 455 | 1 2 3 4 6 7 8 9 10 11 12 450 451 452 455 | 4.4334 | 4.7038 |  |  |  |  | 3.24
session1 | 1 | 075800_817852 | 1 2 3 4 5 6 7 8 9 10 11 12 450 451 452 455 | 1 2 3 4 5 6 7 8 9 10 11 12 450 451 452 455 | 4.263 | 4.2201 |  |  |  |  | 3.5
session1 | 1 | 075804_644388 | 1 2 3 4 5 6 7 8 9 10 11 12 450 451 452 455 | 1 2 3 4 5 6 7 8 9 10 11 12 450 451 452 455 | 4.2038 | 4.0922 |  |  |  |  | 3.88
session1 | 1 | 075810_273073 | 1 2 3 4 5 6 7 8 9 10 11 12 450 451 452 455 | 1 2 3 4 5 6 7 8 9 10 11 12 450 451 452 455 | 4.4511 | 4.4462 |  |  |  |  | 4.35
session1 | 1 | 075814_073060 | 1 2 3 4 5 6 7 8 9 10 11 12 450 451 452 455 | 1 2 3 4 5 6 7 8 9 10 11 12 450 451 452 455 | 4.3002 | 4.1298 |  |  |  |  | 4.23
session1 | 1 | 075819_398738 | 1 2 3 4 5 6 7 8 9 10 11 12 450 451 452 455 | 1 2 3 4 5 6 7 8 9 10 11 12 450 451 452 455 | 4.271 | 4.2857 |  |  |  |  | 4.14
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
