txoof/npec-camera-rig/experiments/round1-leaves/results.csv

still_n | still | taken_at_utc | calibration | setup | side | leaf | leaf_by_shape | slot | x_px | y_px | rig_mm2 | scan_before_mm2 | scan_after_mm2 | known_at_photo_mm2 | err_pct | err_pct_vs_before | err_pct_vs_after | tags_in_crop | touches_benchmark | validation | band_p95_pct | band_median_pct | within_band | band_overlaps_scans
1 | 115420_747871 | 2026-10-15T11:54:20.747871+00:00 | 20261014T111147292361 | blue | top | L003 | L003 | South 3 | 3950 | 4820 | 7653.8 | 7898.5 | 7532.8 | 7826.8 | -2.21 | -3.1 | 1.61 |  | False | 20261014T111253582634 | 2.14 | -0.09 | False | True
1 | 115420_747871 | 2026-10-15T11:54:20.747871+00:00 | 20261014T111147292361 | blue | top | L001 | L001 | South 1 | 1058 | 4886 | 7084.2 | 7331.3 | 6779.9 | 7158.6 | -1.04 | -3.37 | 4.49 |  | False | 20261014T111253582634 | 1.81 | 0.42 | True | True
1 | 115420_747871 | 2026-10-15T11:54:20.747871+00:00 | 20261014T111147292361 | blue | top | L002 | L002 | South 2 | 2463 | 4859 | 7296.2 | 7448.4 | 7081.0 | 7367.2 | -0.96 | -2.04 | 3.04 |  | False | 20261014T111253582634 | 1.54 | 0.13 | True | True
2 | 115454_171003 | 2026-10-15T11:54:54.171003+00:00 | 20261014T111147292361 | blue | top | L003 | L003 | South 4 | 5486 | 4982 | 7514.3 | 7898.5 | 7532.8 | 7813.0 | -3.82 | -4.86 | -0.25 |  | False | 20261014T111253582634 | 2.55 | -0.55 | False | True
2 | 115454_171003 | 2026-10-15T11:54:54.171003+00:00 | 20261014T111147292361 | blue | top | L001 | L001 | South 2 | 2378 | 4827 | 6637.3 | 7331.3 | 6779.9 | 7139.3 | -7.03 | -9.47 | -2.1 |  | False | 20261014T111253582634 | 1.54 | 0.13 | False | False
2 | 115454_171003 | 2026-10-15T11:54:54.171003+00:00 | 20261014T111147292361 | blue | top | L002 | L002 | South 3 | 3922 | 4861 | 7129.6 | 7448.4 | 7081.0 | 7354.8 | -3.06 | -4.28 | 0.69 |  | False | 20261014T111253582634 | 2.14 | -0.09 | False | True
3 | 115512_039600 | 2026-10-15T11:55:12.039600+00:00 | 20261014T111147292361 | blue | top | L003 | L003 | South 5 | 6841 | 4945 | 7778.6 | 7898.5 | 7532.8 | 7805.6 | -0.35 | -1.52 | 3.26 |  | False | 20261014T111253582634 | 1.46 | -0.51 | True | True
3 | 115512_039600 | 2026-10-15T11:55:12.039600+00:00 | 20261014T111147292361 | blue | top | L001 | L001 | South 3 | 3954 | 4752 | 6784.2 | 7331.3 | 6779.9 | 7129.0 | -4.84 | -7.46 | 0.06 |  | False | 20261014T111253582634 | 2.14 | -0.09 | False | True
3 | 115512_039600 | 2026-10-15T11:55:12.039600+00:00 | 20261014T111147292361 | blue | top | L002 | L002 | South 4 | 5392 | 4827 | 7104.7 | 7448.4 | 7081.0 | 7348.2 | -3.31 | -4.61 | 0.33 |  | False | 20261014T111253582634 | 2.55 | -0.55 | False | True
4 | 115531_236461 | 2026-10-15T11:55:31.236461+00:00 | 20261014T111147292361 | blue | top | L003 | L003 | South 6 | 8316 | 4917 | 8064.9 | 7898.5 | 7532.8 | 7797.7 | 3.43 | 2.11 | 7.06 |  | False | 20261014T111253582634 | 2.23 | 0.9 | False | True
4 | 115531_236461 | 2026-10-15T11:55:31.236461+00:00 | 20261014T111147292361 | blue | top | L001 | L001 | South 4 | 5310 | 4827 | 6904.1 | 7331.3 | 6779.9 | 7118.0 | -3.0 | -5.83 | 1.83 |  | False | 20261014T111253582634 | 2.55 | -0.55 | False | True
4 | 115531_236461 | 2026-10-15T11:55:31.236461+00:00 | 20261014T111147292361 | blue | top | L002 | L002 | South 5 | 6876 | 4854 | 6917.4 | 7448.4 | 7081.0 | 7341.1 | -5.77 | -7.13 | -2.31 |  | False | 20261014T111253582634 | 1.46 | -0.51 | False | False
5 | 115551_522883 | 2026-10-15T11:55:51.522883+00:00 | 20261014T111147292361 | blue | top | L003 | L003 | North 6 | 8227 | 2151 | 8052.1 | 7898.5 | 7532.8 | 7789.3 | 3.37 | 1.95 | 6.89 |  | False | 20261014T111253582634 | 1.93 | 0.4 | False | False
5 | 115551_522883 | 2026-10-15T11:55:51.522883+00:00 | 20261014T111147292361 | blue | top | L001 | L001 | South 5 | 6896 | 4855 | 6961.1 | 7331.3 | 6779.9 | 7106.3 | -2.04 | -5.05 | 2.67 |  | False | 20261014T111253582634 | 1.46 | -0.51 | False | True
5 | 115551_522883 | 2026-10-15T11:55:51.522883+00:00 | 20261014T111147292361 | blue | top | L002 | L002 | South 6 | 8341 | 4888 | 7108.1 | 7448.4 | 7081.0 | 7333.5 | -3.07 | -4.57 | 0.38 |  | False | 20261014T111253582634 | 2.23 | 0.9 | False | True
6 | 115613_541308 | 2026-10-15T11:56:13.541308+00:00 | 20261014T111147292361 | blue | top | L003 | L003 | North 5 | 6785 | 2108 | 7826.5 | 7898.5 | 7532.8 | 7780.2 | 0.6 | -0.91 | 3.9 |  | False | 20261014T111253582634 | 1.26 | -0.04 | True | True
6 | 115613_541308 | 2026-10-15T11:56:13.541308+00:00 | 20261014T111147292361 | blue | top | L001 | L001 | South 6 | 8410 | 4811 | 6940.8 | 7331.3 | 6779.9 | 7093.6 | -2.15 | -5.33 | 2.37 |  | False | 20261014T111253582634 | 2.23 | 0.9 | True | True
6 | 115613_541308 | 2026-10-15T11:56:13.541308+00:00 | 20261014T111147292361 | blue | top | L002 | L002 | North 6 | 8369 | 2199 | 7084.8 | 7448.4 | 7081.0 | 7325.4 | -3.28 | -4.88 | 0.05 |  | False | 20261014T111253582634 | 1.93 | 0.4 | False | True
7 | 115632_446864 | 2026-10-15T11:56:32.446864+00:00 | 20261014T111147292361 | blue | top | L003 | L002 | North 4 | 5345 | 2034 | 7683.6 | 7898.5 | 7532.8 | 7772.4 | -1.14 | -2.72 | 2.0 |  | False | 20261014T111253582634 | 2.55 | -0.62 | True | True
7 | 115632_446864 | 2026-10-15T11:56:32.446864+00:00 | 20261014T111147292361 | blue | top | L001 | L001 | North 6 | 8273 | 2057 | 7124.4 | 7331.3 | 6779.9 | 7082.7 | 0.59 | -2.82 | 5.08 |  | False | 20261014T111253582634 | 1.93 | 0.4 | True | True
7 | 115632_446864 | 2026-10-15T11:56:32.446864+00:00 | 20261014T111147292361 | blue | top | L002 | L003 | North 5 | 6784 | 1985 | 7003.0 | 7448.4 | 7081.0 | 7318.3 | -4.31 | -5.98 | -1.1 |  | False | 20261014T111253582634 | 1.26 | -0.04 | False | True
8 | 115650_374775 | 2026-10-15T11:56:50.374775+00:00 | 20261014T111147292361 | blue | top | L001 | L003 | North 5 | 6753 | 2008 | 6856.5 | 7331.3 | 6779.9 | 7072.4 | -3.05 | -6.48 | 1.13 |  | False | 20261014T111253582634 | 1.26 | -0.04 | False | True
8 | 115650_374775 | 2026-10-15T11:56:50.374775+00:00 | 20261014T111147292361 | blue | top | L003 | L001 | North 3 | 3912 | 2637 | 7344.3 | 7898.5 | 7532.8 | 7765.0 | -5.42 | -7.02 | -2.5 | 4 | True | 20261014T111253582634 | 2.03 | -0.22 | False | False
8 | 115650_374775 | 2026-10-15T11:56:50.374775+00:00 | 20261014T111147292361 | blue | top | L002 | L002 | North 4 | 5266 | 2020 | 6703.2 | 7448.4 | 7081.0 | 7311.7 | -8.32 | -10.0 | -5.34 |  | False | 20261014T111253582634 | 2.55 | -0.62 | False | False
9 | 115707_801539 | 2026-10-15T11:57:07.801539+00:00 | 20261014T111147292361 | blue | top | L003 | L003 | North 2 | 2368 | 2036 | 7671.0 | 7898.5 | 7532.8 | 7757.8 | -1.12 | -2.88 | 1.84 |  | False | 20261014T111253582634 | 1.59 | 0.56 | True | True
9 | 115707_801539 | 2026-10-15T11:57:07.801539+00:00 | 20261014T111147292361 | blue | top | L001 | L001 | North 4 | 5328 | 2100 | 6707.1 | 7331.3 | 6779.9 | 7062.3 | -5.03 | -8.51 | -1.07 |  | False | 20261014T111253582634 | 2.55 | -0.62 | False | True
9 | 115707_801539 | 2026-10-15T11:57:07.801539+00:00 | 20261014T111147292361 | blue | top | L002 | L002 | North 3 | 3869 | 2631 | 6545.3 | 7448.4 | 7081.0 | 7305.2 | -10.4 | -12.12 | -7.57 | 4 | True | 20261014T111253582634 | 2.03 | -0.22 | False | False
10 | 115726_793130 | 2026-10-15T11:57:26.793130+00:00 | 20261014T111147292361 | blue | top | L003 | L003 | North 1 | 973 | 2054 | 7961.8 | 7898.5 | 7532.8 | 7750.0 | 2.73 | 0.8 | 5.7 |  | False | 20261014T111253582634 | 2.47 | 0.05 | False | True
10 | 115726_793130 | 2026-10-15T11:57:26.793130+00:00 | 20261014T111147292361 | blue | top | L002 | L002 | North 2 | 2360 | 2039 | 6634.2 | 7448.4 | 7081.0 | 7298.2 | -9.1 | -10.93 | -6.31 |  | False | 20261014T111253582634 | 1.59 | 0.56 | False | False
10 | 115726_793130 | 2026-10-15T11:57:26.793130+00:00 | 20261014T111147292361 | blue | top | L001 | L001 | North 3 | 3887 | 2619 | 5931.3 | 7331.3 | 6779.9 | 7051.4 | -15.88 | -19.1 | -12.52 | 4 | True | 20261014T111253582634 | 2.03 | -0.22 | False | False
11 | 115848_008605 | 2026-10-15T11:58:48.008605+00:00 | 20261014T111147292361 | black | top | all 3 | all 3 | South 1 | 749 | 5016 | 22342.4 | 22678.2 | 21393.7 | 21989.1 | 1.61 | -1.48 | 4.43 | 7 | False | 20261014T111253582634 | 1.81 | 0.42 | True | True
12 | 115902_068838 | 2026-10-15T11:59:02.068838+00:00 | 20261014T111147292361 | black | top | all 3 | all 3 | South 2 | 2421 | 4864 | 22226.9 | 22678.2 | 21393.7 | 21970.0 | 1.17 | -1.99 | 3.89 |  | False | 20261014T111253582634 | 1.54 | 0.13 | True | True
13 | 115913_634989 | 2026-10-15T11:59:13.634989+00:00 | 20261014T111147292361 | black | top | all 3 | all 3 | South 3 | 3844 | 4854 | 21949.1 | 22678.2 | 21393.7 | 21954.3 | -0.02 | -3.21 | 2.6 |  | False | 20261014T111253582634 | 2.14 | -0.09 | True | True
14 | 115925_456242 | 2026-10-15T11:59:25.456242+00:00 | 20261014T111147292361 | black | top | all 3 | all 3 | South 4 | 5198 | 4988 | 22337.9 | 22678.2 | 21393.7 | 21938.2 | 1.82 | -1.5 | 4.41 | 6 | False | 20261014T111253582634 | 2.55 | -0.55 | True | True
15 | 115939_745853 | 2026-10-15T11:59:39.745853+00:00 | 20261014T111147292361 | black | top | all 3 | all 3 | South 5 | 6735 | 4893 | 22930.0 | 22678.2 | 21393.7 | 21918.7 | 4.61 | 1.11 | 7.18 | 11 | False | 20261014T111253582634 | 1.46 | -0.51 | False | True
16 | 115953_428209 | 2026-10-15T11:59:53.428209+00:00 | 20261014T111147292361 | black | top | all 3 | all 3 | South 6 | 8411 | 4803 | 23394.2 | 22678.2 | 21393.7 | 21900.1 | 6.82 | 3.16 | 9.35 |  | False | 20261014T111253582634 | 2.23 | 0.9 | False | False
17 | 120008_229438 | 2026-10-15T12:00:08.229438+00:00 | 20261014T111147292361 | black | top | all 3 | all 3 | North 6 | 8153 | 2064 | 23388.6 | 22678.2 | 21393.7 | 21880.0 | 6.9 | 3.13 | 9.32 |  | False | 20261014T111253582634 | 1.93 | 0.4 | False | False
18 | 120019_983528 | 2026-10-15T12:00:19.983528+00:00 | 20261014T111147292361 | black | top | all 3 | all 3 | North 5 | 6799 | 2082 | 22590.5 | 22678.2 | 21393.7 | 21864.0 | 3.32 | -0.39 | 5.59 |  | False | 20261014T111253582634 | 1.26 | -0.04 | False | True
19 | 120031_779059 | 2026-10-15T12:00:31.779059+00:00 | 20261014T111147292361 | black | top | all 3 | all 3 | North 4 | 5323 | 2058 | 22225.2 | 22678.2 | 21393.7 | 21848.0 | 1.73 | -2.0 | 3.89 |  | False | 20261014T111253582634 | 2.55 | -0.62 | True | True
20 | 120045_900780 | 2026-10-15T12:00:45.900780+00:00 | 20261014T111147292361 | black | top | all 3 | all 3 | North 2 | 2573 | 2030 | 22237.8 | 22678.2 | 21393.7 | 21828.8 | 1.87 | -1.94 | 3.95 | 5 | False | 20261014T111253582634 | 1.59 | 0.56 | False | True
21 | 120058_387397 | 2026-10-15T12:00:58.387397+00:00 | 20261014T111147292361 | black | top | all 3 | all 3 | North 1 | 865 | 2020 | 22488.6 | 22678.2 | 21393.7 | 21811.8 | 3.1 | -0.84 | 5.12 |  | False | 20261014T111253582634 | 2.47 | 0.05 | False | True
22 | 120138_743631 | 2026-10-15T12:01:38.743631+00:00 | 20261014T111147292361 | black | under | all 3 | all 3 | South 1 | 860 | 4938 | 21847.6 | 22678.2 | 21393.7 | 21756.9 | 0.42 | -3.66 | 2.12 | 7 | False | 20261014T111253582634 | 1.81 | 0.42 | True | True
23 | 120151_661362 | 2026-10-15T12:01:51.661362+00:00 | 20261014T111147292361 | black | under | all 3 | all 3 | South 2 | 2423 | 4760 | 21481.4 | 22678.2 | 21393.7 | 21739.3 | -1.19 | -5.28 | 0.41 |  | False | 20261014T111253582634 | 1.54 | 0.13 | True | True
24 | 120203_069058 | 2026-10-15T12:02:03.069058+00:00 | 20261014T111147292361 | black | under | all 3 | all 3 | South 3 | 3924 | 4796 | 21649.7 | 22678.2 | 21393.7 | 21723.8 | -0.34 | -4.54 | 1.2 |  | False | 20261014T111253582634 | 2.14 | -0.09 | True | True
25 | 120214_232737 | 2026-10-15T12:02:14.232737+00:00 | 20261014T111147292361 | black | under | all 3 | all 3 | South 4 | 5276 | 4867 | 22036.5 | 22678.2 | 21393.7 | 21708.6 | 1.51 | -2.83 | 3.0 | 6 | False | 20261014T111253582634 | 2.55 | -0.55 | True | True
26 | 120227_457517 | 2026-10-15T12:02:27.457517+00:00 | 20261014T111147292361 | black | under | all 3 | all 3 | South 5 | 6766 | 4822 | 22375.9 | 22678.2 | 21393.7 | 21690.7 | 3.16 | -1.33 | 4.59 | 11 | False | 20261014T111253582634 | 1.46 | -0.51 | False | True
27 | 120240_955148 | 2026-10-15T12:02:40.955148+00:00 | 20261014T111147292361 | black | under | all 3 | all 3 | South 6 | 8401 | 4750 | 22793.6 | 22678.2 | 21393.7 | 21672.3 | 5.17 | 0.51 | 6.54 |  | False | 20261014T111253582634 | 2.23 | 0.9 | False | True
28 | 120255_340986 | 2026-10-15T12:02:55.340986+00:00 | 20261014T111147292361 | black | under | all 3 | all 3 | North 6 | 8155 | 2077 | 23178.9 | 22678.2 | 21393.7 | 21652.7 | 7.05 | 2.21 | 8.34 |  | False | 20261014T111253582634 | 1.93 | 0.4 | False | False
29 | 120307_402312 | 2026-10-15T12:03:07.402312+00:00 | 20261014T111147292361 | black | under | all 3 | all 3 | North 5 | 6785 | 2102 | 22198.3 | 22678.2 | 21393.7 | 21636.3 | 2.6 | -2.12 | 3.76 |  | False | 20261014T111253582634 | 1.26 | -0.04 | False | True
30 | 120319_214662 | 2026-10-15T12:03:19.214662+00:00 | 20261014T111147292361 | black | under | all 3 | all 3 | North 4 | 5292 | 2044 | 21894.5 | 22678.2 | 21393.7 | 21620.3 | 1.27 | -3.46 | 2.34 |  | False | 20261014T111253582634 | 2.55 | -0.62 | True | True
31 | 120337_756163 | 2026-10-15T12:03:37.756163+00:00 | 20261014T111147292361 | black | under | all 3 | all 3 | North 2 | 2512 | 2037 | 22200.3 | 22678.2 | 21393.7 | 21595.0 | 2.8 | -2.11 | 3.77 |  | False | 20261014T111253582634 | 1.59 | 0.56 | False | True
32 | 120350_220119 | 2026-10-15T12:03:50.220119+00:00 | 20261014T111147292361 | black | under | all 3 | all 3 | North 1 | 825 | 2088 | 22549.7 | 22678.2 | 21393.7 | 21578.1 | 4.5 | -0.57 | 5.4 |  | False | 20261014T111253582634 | 2.47 | 0.05 | False | True
