txoof/npec-camera-rig/experiments/round1/run-2026-10-15-tags.csv

still | exposure_us | gain | red_gain | blue_gain | lens | found_A | found_C | secs_A | secs_C
100149_752438 | 6651 | 1.0 | 1.9992 | 1.6293 | 6.05 | 0 1 2 3 4 5 6 7 8 9 10 11 12 13 14 15 16 17 450 451 452 455 | 0 1 2 3 4 5 6 7 8 9 10 11 12 13 14 15 16 17 450 451 452 455 | 4.42 | 4.08
100204_695134 | 6651 | 1.0 | 2.001 | 1.628 | 6.05 | 0 1 2 3 4 5 6 7 8 9 10 11 12 13 14 15 16 17 450 451 452 455 | 0 1 2 3 4 5 6 7 8 9 10 11 12 13 14 15 16 17 450 451 452 455 | 4.29 | 4.26
100219_739626 | 6651 | 1.0 | 1.9991 | 1.6293 | 6.05 | 0 1 2 3 4 5 6 7 8 9 10 11 12 13 15 16 17 450 451 452 455 | 0 1 2 3 4 5 6 7 8 9 10 11 12 13 14 15 16 17 450 451 452 455 | 4.27 | 4.03
100234_728748 | 6651 | 1.0 | 2.0018 | 1.6274 | 6.05 | 0 1 2 3 4 5 6 7 8 9 10 11 12 13 16 17 450 451 452 455 | 0 1 2 3 4 5 6 7 8 9 10 11 12 13 14 15 16 17 450 451 452 455 | 4.22 | 4.25
100249_740499 | 6651 | 1.0 | 2.0004 | 1.6284 | 6.05 | 0 1 2 3 4 5 6 7 8 9 10 11 12 13 15 16 17 450 451 452 455 | 0 1 2 3 4 5 6 7 8 9 10 11 12 13 14 15 16 17 450 451 452 455 | 4.14 | 4.06
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
