txoof/npec-camera-rig/experiments/round1-benchy/results.csv

still | experiment | step | taken_at_utc | calibration | calibration_lens | validation | lens_position | capture_flags | red_pieces | status | base_x_px | base_y_px | base_side_mm | turn_deg | slot | tags_in_crop | tag_px_masked | least_round_red_at | prism_pieces | prism_mm2 | prism_err_pct | prism_circularity | circle_pieces | circle_mm2 | circle_err_pct | circle_circularity | sphere_pieces | sphere_mm2 | sphere_err_pct | sphere_circularity | cylinder_pieces | cylinder_mm2 | cylinder_err_pct | cylinder_circularity | rosette_NW_pieces | rosette_NW_mm2 | rosette_NW_diam_mm | rosette_NW_limit_mm2 | rosette_NW_below_limit | rosette_NE_pieces | rosette_NE_mm2 | rosette_NE_diam_mm | rosette_NE_limit_mm2 | rosette_NE_below_limit | rosette_SE_pieces | rosette_SE_mm2 | rosette_SE_diam_mm | rosette_SE_limit_mm2 | rosette_SE_below_limit | rosette_SW_pieces | rosette_SW_mm2 | rosette_SW_diam_mm | rosette_SW_limit_mm2 | rosette_SW_below_limit | green_px_dropped_small | static_group
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
