txoof/npec-camera-rig/experiments/352-green-threshold/data/imagej/manifest.csv

file | capture_id | tray | plant | x0 | y0 | width | height | mm2_per_px | mm_per_px
2026-11-03_105853_597207_t1_p1.tif | 19380 | 1 | 1 | 6637 | 2824 | 148 | 132 | 0.04069295478309975 | 0.20172494834080326
2026-11-03_105853_597207_t1_p2.tif | 19380 | 1 | 2 | 7345 | 2804 | 146 | 145 | 0.04069295478309975 | 0.20172494834080326
2026-11-03_105853_597207_t1_p3.tif | 19380 | 1 | 3 | 6958 | 1466 | 155 | 154 | 0.04069295478309975 | 0.20172494834080326
2026-11-03_105853_597207_t1_p4.tif | 19380 | 1 | 4 | 6961 | 1777 | 186 | 195 | 0.04069295478309975 | 0.20172494834080326
2026-11-03_105853_597207_t1_p5.tif | 19380 | 1 | 5 | 7316 | 2130 | 172 | 173 | 0.04069295478309975 | 0.20172494834080326
2026-11-03_105853_597207_t3_p1.tif | 19380 | 3 | 1 | 3937 | 1830 | 152 | 147 | 0.041009665395267986 | 0.20250843289914616
2026-11-03_105853_597207_t3_p2.tif | 19380 | 3 | 2 | 3940 | 1469 | 152 | 172 | 0.041009665395267986 | 0.20250843289914616
2026-11-03_105853_597207_t3_p3.tif | 19380 | 3 | 3 | 3581 | 2159 | 182 | 177 | 0.041009665395267986 | 0.20250843289914616
2026-11-03_105853_597207_t3_p4.tif | 19380 | 3 | 4 | 3910 | 2129 | 168 | 189 | 0.041009665395267986 | 0.20250843289914616
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
