txoof/npec-camera-rig/experiments/352-green-threshold/data/imagej/pass_1_2026.11.04_Results.csv

 | Label | Area | Mean | Perim. | BX | BY | Width | Height | Circ. | Feret | FeretX | FeretY | FeretAngle | MinFeret | AR | Round | Solidity
1 | 2026-11-03_105853_597207_t1_p1.tif | 1942 | 84.480 | 319.223 | 42 | 30 | 66 | 66 | 0.239 | 68.437 | 43.797 | 48.514 | 153.723 | 56.043 | 1.190 | 0.840 | 0.709
2 | 2026-11-03_105853_597207_t1_p2.tif | 2186 | 88.368 | 292.002 | 40 | 43 | 65 | 59 | 0.322 | 82.335 | 40.822 | 97.767 | 40.513 | 57.758 | 1.287 | 0.777 | 0.692
3 | 2026-11-03_105853_597207_t1_p3.tif:0076-0079 | 3341 | 76.939 | 322.024 | 40 | 40 | 79 | 73 | 0.405 | 81.989 | 44.419 | 54.387 | 148.711 | 66.957 | 1.187 | 0.842 | 0.826
4 | 2026-11-03_105853_597207_t1_p4.tif | 5118 | 82.876 | 478.777 | 41 | 40 | 105 | 113 | 0.281 | 114.803 | 86.836 | 152.994 | 76.375 | 85.179 | 1.433 | 0.698 | 0.699
5 | 2026-11-03_105853_597207_t1_p5.tif | 5082 | 79.923 | 375.860 | 40 | 45 | 94 | 83 | 0.452 | 112.641 | 41.442 | 58.953 | 143.729 | 79.351 | 1.165 | 0.858 | 0.811
6 | 2026-11-03_105853_597207_t3_p1.tif | 2482 | 89.064 | 279.093 | 38 | 40 | 74 | 67 | 0.400 | 74.261 | 38.375 | 76.750 | 10.572 | 57.487 | 1.110 | 0.901 | 0.787
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
