txoof/npec-camera-rig/experiments/352-green-threshold/data/imagej/pass_2_2026.11.05_Results.csv

 | Label | Area | Mean | Perim. | BX | BY | Width | Height | Circ. | Feret | FeretX | FeretY | FeretAngle | MinFeret | AR | Round | Solidity
1 | 2026-11-03_105853_597207_t1_p1.tif:0061-0074 | 2185 | 82.797 | 270.428 | 41 | 28 | 67 | 67 | 0.375 | 70.241 | 41.794 | 49.917 | 156.591 | 57.565 | 1.197 | 0.835 | 0.771
2 | 2026-11-03_105853_597207_t1_p2.tif | 2474 | 86.201 | 283.275 | 40 | 42 | 66 | 62 | 0.387 | 83.276 | 41.363 | 100.240 | 42.340 | 54.517 | 1.479 | 0.676 | 0.773
3 | 2026-11-03_105853_597207_t1_p3.tif | 3574 | 75.904 | 293.434 | 39 | 40 | 81 | 74 | 0.522 | 82.720 | 41.613 | 61.000 | 157.435 | 67.653 | 1.163 | 0.860 | 0.855
4 | 2026-11-03_105853_597207_t1_p4.tif | 5213 | 82.348 | 464.894 | 43 | 39 | 103 | 113 | 0.303 | 115.260 | 85.355 | 151.516 | 75.808 | 85.496 | 1.440 | 0.695 | 0.718
5 | 2026-11-03_105853_597207_t1_p5.tif | 5294 | 78.869 | 361.469 | 39 | 45 | 94 | 84 | 0.509 | 109.377 | 41.826 | 57.535 | 144.135 | 81.298 | 1.147 | 0.872 | 0.822
6 | 2026-11-03_105853_597207_t3_p1.tif | 2564 | 88.434 | 281.417 | 37 | 40 | 76 | 68 | 0.407 | 75.767 | 37.250 | 75.625 | 9.400 | 58.909 | 1.108 | 0.903 | 0.797
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
