txoof/npec-camera-rig/experiments/352-green-threshold/data/results/24-iou_per_plant.csv

plant | self | A1 | A2 | B1 | B2 | C1 | C2 | D1 | D2
t1_p1 | 0.8699592206615315 | 0.08753861997940268 | 0.07780320366132723 | 0.26210092687950565 | 0.23295194508009154 | 0.6490507952796306 | 0.5821510297482837 | 0.7798678190137265 | 0.7135011441647597
t1_p2 | 0.8389897395422258 | 0.2561756633119854 | 0.22635408245755861 | 0.4807868252516011 | 0.4248181083265966 | 0.8642634623943035 | 0.8001608363490149 | 0.8545603944124898 | 0.8447944679216289
t1_p3 | 0.9213670464017782 | 0.20729883338318875 | 0.1944599888080582 | 0.5613825983313468 | 0.5313374370453273 | 0.790863245327796 | 0.7538461538461538 | 0.8513238289205702 | 0.8256296706338223
t1_p4 | 0.9064403026388632 | 0.4280969128565846 | 0.4202954153078841 | 0.5 | 0.4908881642048724 | 0.8253418062776815 | 0.8225775747192081 | 0.8665162624553487 | 0.8661329361385217
t1_p5 | 0.9325758986775936 | 0.5285320739866194 | 0.5073668303740083 | 0.6316410861865407 | 0.6063468077068379 | 0.8843603744149766 | 0.858298833270606 | 0.9167307692307692 | 0.8955307262569833
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
