txoof/npec-camera-rig/experiments/352-green-threshold/data/results/24-per_plant.csv

file | tray | half_cut | hand1_px | hand2_px | pass2_over_pass1 | A_px | A_ratio1 | A_missed1 | A_extra1 | A_ratio2 | A_missed2 | A_extra2 | B_px | B_ratio1 | B_missed1 | B_extra1 | B_ratio2 | B_missed2 | B_extra2 | C_px | C_ratio1 | C_missed1 | C_extra1 | C_ratio2 | C_missed2 | C_extra2 | D_px | D_ratio1 | D_missed1 | D_extra1 | D_ratio2 | D_missed2 | D_extra2
2026-11-03_105853_597207_t1_p1.tif | 1 | -0.02 | 1942 | 2185 | 1.1251 | 170 | 0.0875 | 0.9125 | 0.0 | 0.0778 | 0.9222 | 0.0 | 509 | 0.2621 | 0.7379 | 0.0 | 0.233 | 0.767 | 0.0 | 1272 | 0.655 | 0.3486 | 0.0036 | 0.5822 | 0.4178 | 0.0 | 1559 | 0.8028 | 0.2101 | 0.0129 | 0.7135 | 0.2865 | 0.0
2026-11-03_105853_597207_t1_p2.tif | 1 | -0.02 | 2186 | 2474 | 1.1317 | 560 | 0.2562 | 0.7438 | 0.0 | 0.2264 | 0.7736 | 0.0 | 1051 | 0.4808 | 0.5192 | 0.0 | 0.4248 | 0.5752 | 0.0 | 2003 | 0.9163 | 0.1116 | 0.0279 | 0.8096 | 0.1956 | 0.0053 | 2328 | 1.065 | 0.0485 | 0.1134 | 0.941 | 0.1112 | 0.0521
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
