txoof/npec-camera-rig/experiments/352-green-threshold/data/results/24.1-per_tray_day.csv

stem | tray | app_mm2 | C_mm2 | E_mm2 | E_over_C | E_specks | C_specks
2026-10-23_105853_603395 | 1 | 45.1 | 274.5 | 383.9 | 1.399 | 0.0402 | 0.0088
2026-10-23_105853_603395 | 2 | 97.7 | 189.4 | 257.8 | 1.361 | 0.0589 | 0.0015
2026-10-23_105853_603395 | 3 | 98.8 | 324.9 | 666.8 | 2.052 | 0.236 | 0.0094
2026-10-23_105853_603395 | 4 | 48.9 | 277.7 | 447.9 | 1.613 | 0.1078 | 0.0055
2026-10-23_105853_603395 | 5 | 37.3 | 224.3 | 299.6 | 1.336 | 0.0427 | 0.0
2026-10-23_105853_603395 | 6 | 15.1 | 226.5 | 329.1 | 1.453 | 0.077 | 0.0142
2026-10-23_105853_603395 | 7 | 35.2 | 96.5 | 126.3 | 1.309 | 0.027 | 0.0
2026-10-26_105853_826298 | 1 | 158.9 | 508.7 | 688.7 | 1.354 | 0.0606 | 0.0032
2026-10-26_105853_826298 | 2 | 225.5 | 724.5 | 1228.3 | 1.695 | 0.1419 | 0.0067
2026-10-26_105853_826298 | 3 | 167.6 | 527.9 | 683.4 | 1.295 | 0.0438 | 0.0043
2026-10-26_105853_826298 | 4 | 144.7 | 617.3 | 1155.4 | 1.872 | 0.1434 | 0.0109
2026-10-26_105853_826298 | 5 | 107.1 | 645.7 | 983.7 | 1.523 | 0.0893 | 0.0123
2026-10-26_105853_826298 | 6 | 156.6 | 486.1 | 643.2 | 1.323 | 0.0596 | 0.0011
2026-10-26_105853_826298 | 7 | 437.5 | 154.7 | 192.7 | 1.246 | 0.0221 | 0.0115
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
