txoof/npec-camera-rig/experiments/352-green-threshold/data/imagej/2026-11-03_105853_597207_t1_p4.tif

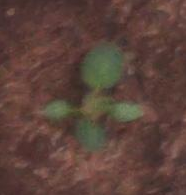
experiments/352-green-threshold/data/imagej/2026-11-03_105853_597207_t1_p4.tif
