txoof/npec-camera-rig/experiments/round1-leaves/scans/L001.jpg

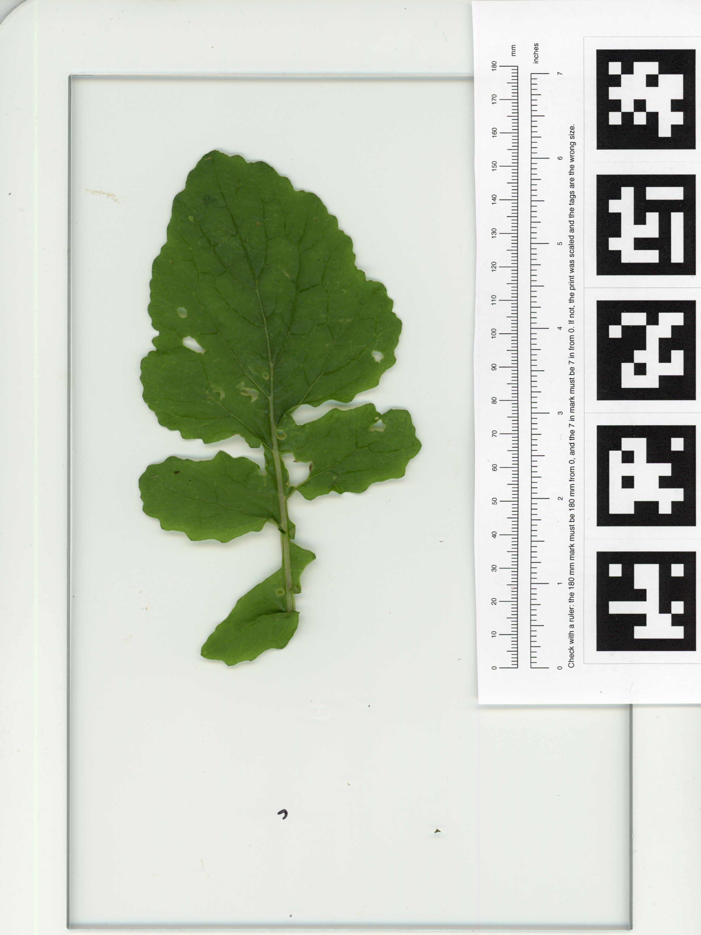
experiments/round1-leaves/scans/L001.jpg
