txoof/npec-camera-rig/experiments/round1-leaves/scans/L001_after.jpg

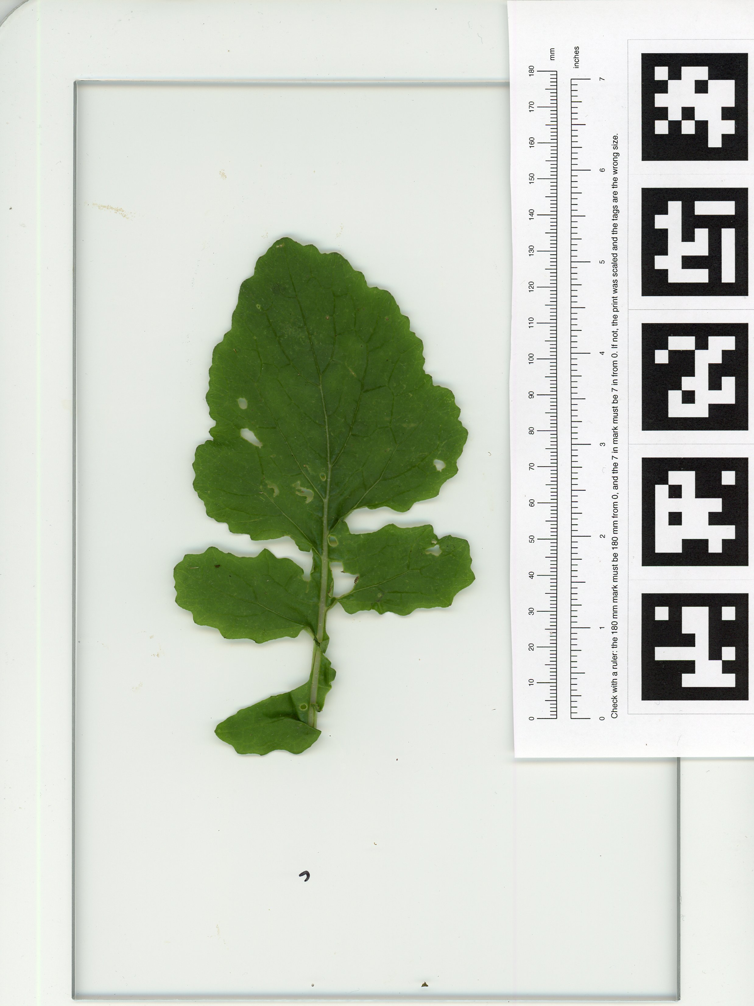
experiments/round1-leaves/scans/L001_after.jpg
