txoof/npec-camera-rig/experiments/round1-leaves/scans/L002.jpg

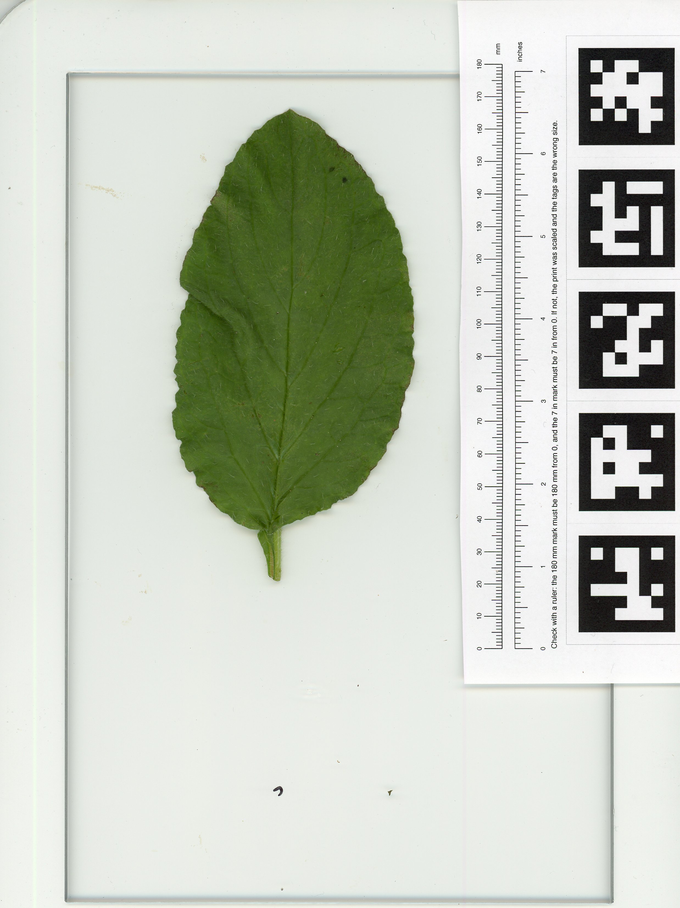
experiments/round1-leaves/scans/L002.jpg
