txoof/npec-camera-rig/experiments/round1-leaves/scans/L002_after.jpg

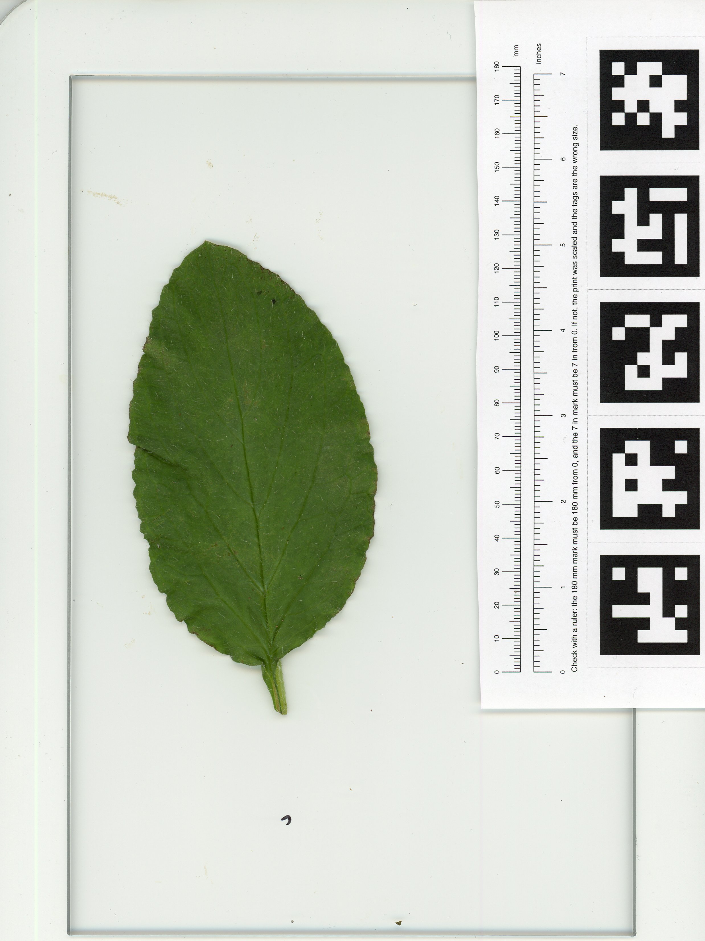
experiments/round1-leaves/scans/L002_after.jpg
