txoof/npec-camera-rig/experiments/round1-leaves/scans/L003.jpg

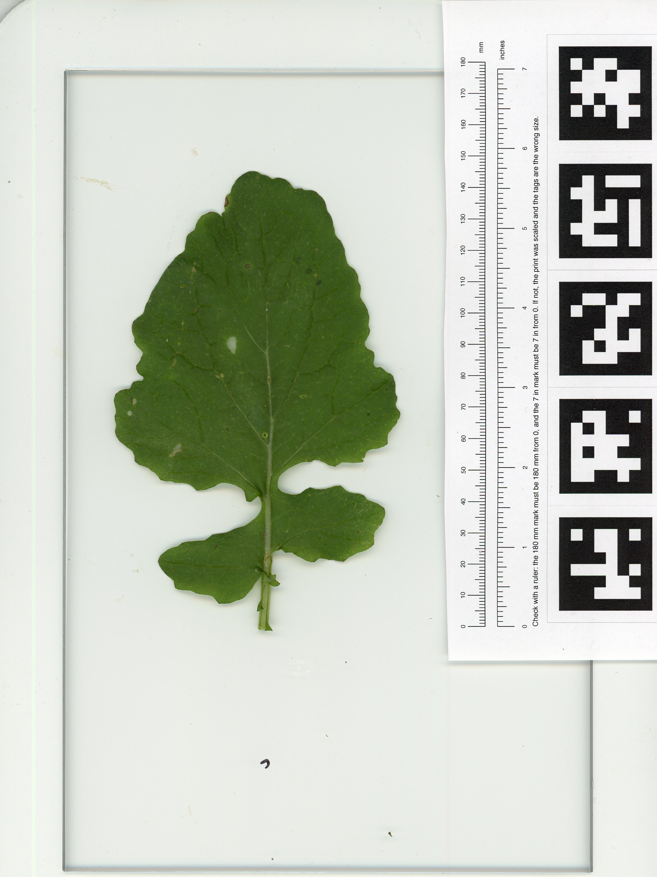
experiments/round1-leaves/scans/L003.jpg
