txoof/npec-camera-rig/experiments/round1-leaves/scans/L003_after.jpg

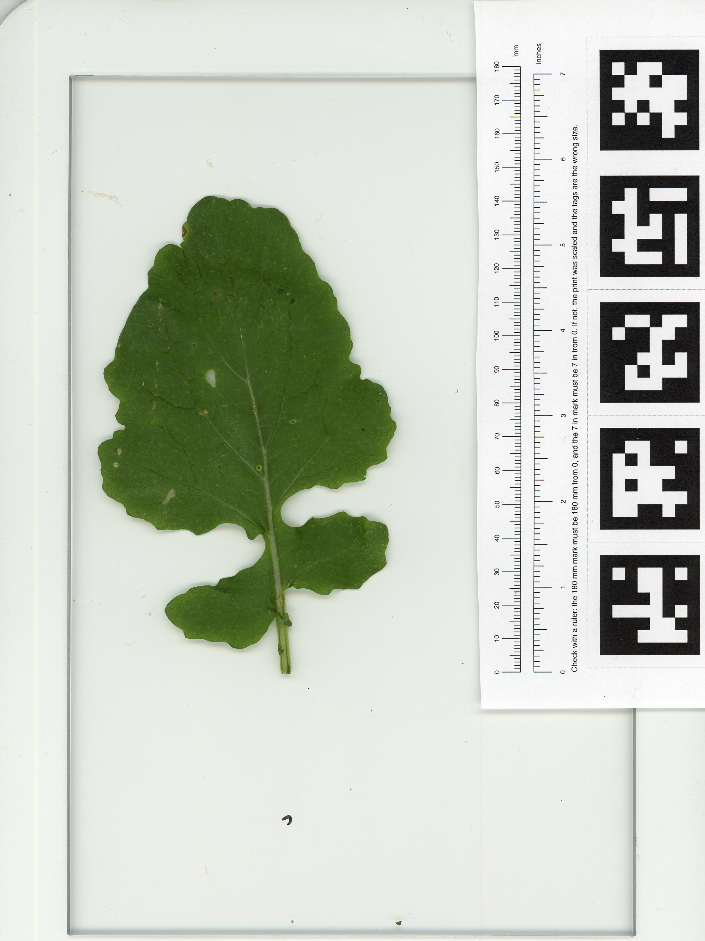
experiments/round1-leaves/scans/L003_after.jpg
