txoof/npec-camera-rig/tests/fixtures/tags/real_tag_crop.jpg

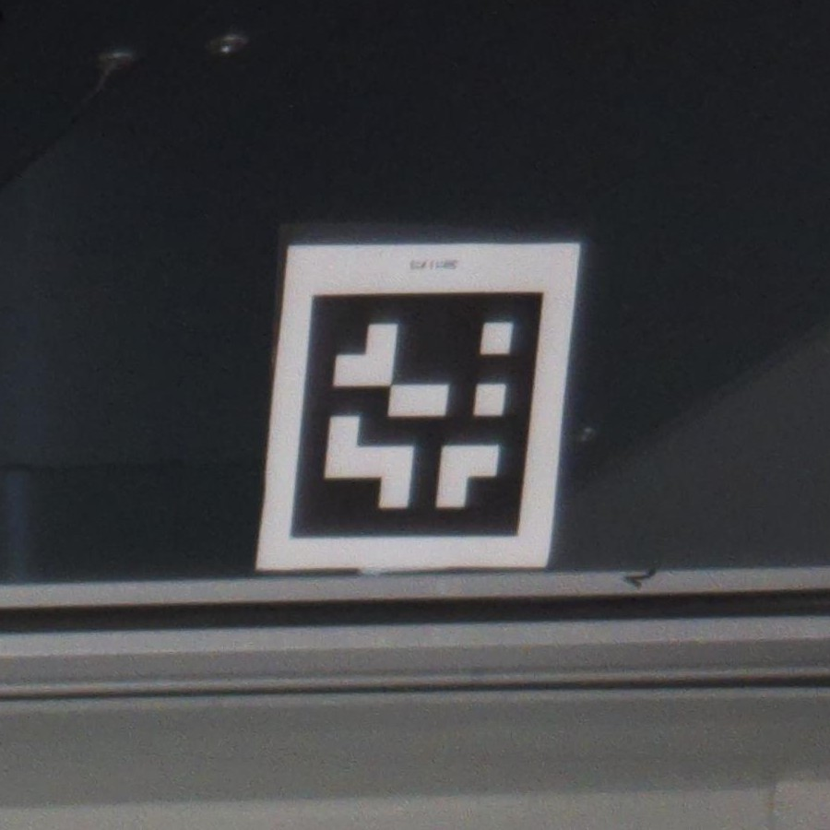
tests/fixtures/tags/real_tag_crop.jpg
