txoof/npec-camera-rig/tests/fixtures/trays/blue-finder/a1-tags-sheet-on-tray.jpg

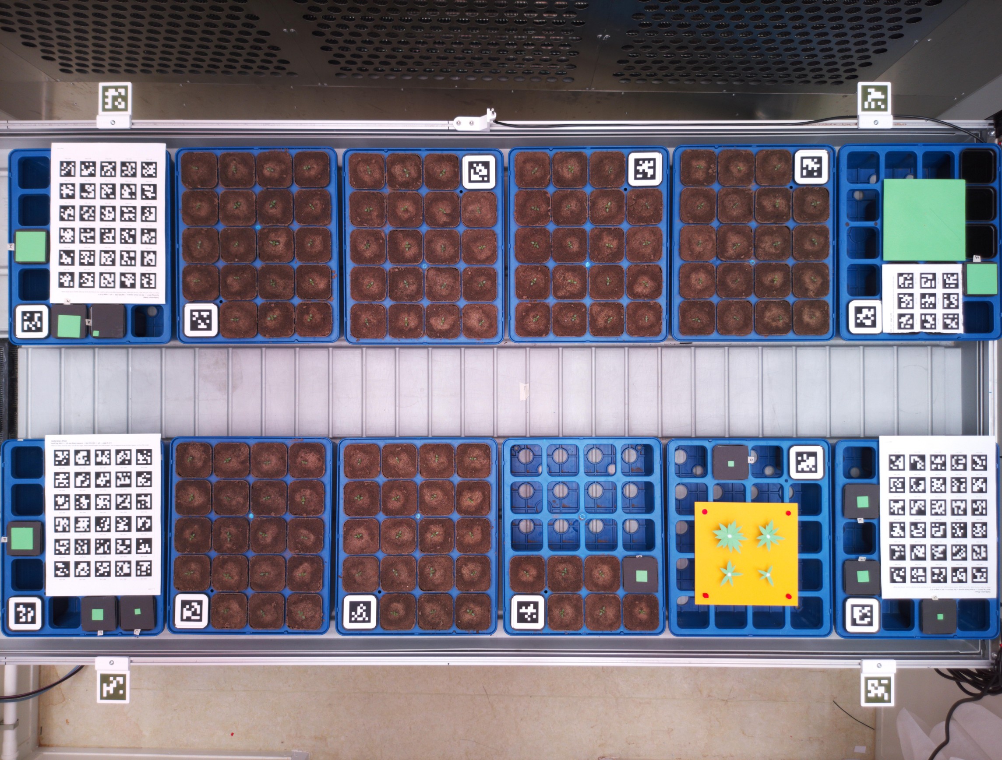
tests/fixtures/trays/blue-finder/a1-tags-sheet-on-tray.jpg
