txoof/npec-camera-rig/tests/fixtures/trays/blue-finder/dev-2x2-untagged.jpg

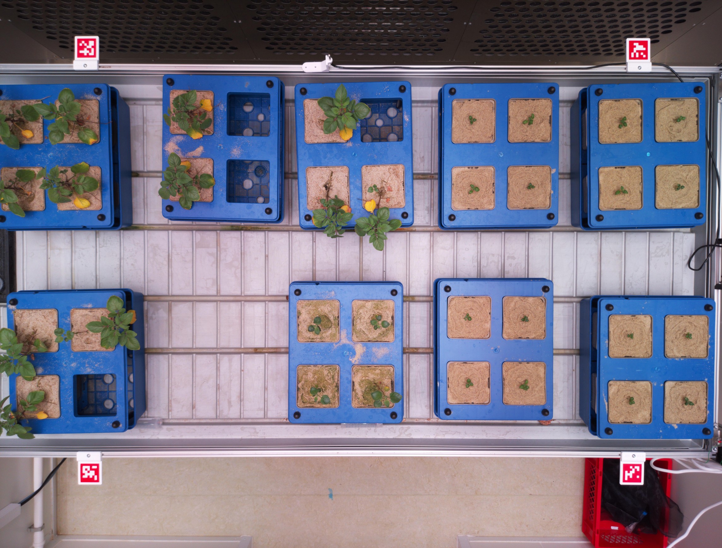
tests/fixtures/trays/blue-finder/dev-2x2-untagged.jpg
