txoof/npec-camera-rig/tests/fixtures/trays/blue-finder/pots-touching.jpg

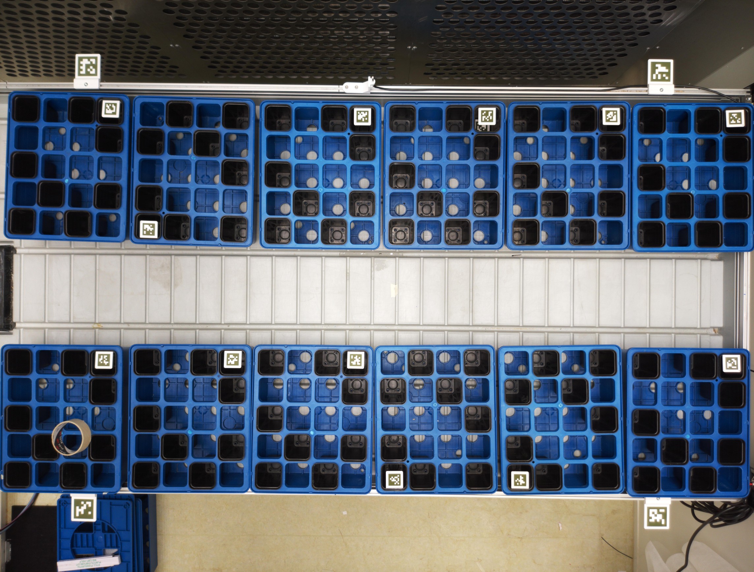
tests/fixtures/trays/blue-finder/pots-touching.jpg
