txoof/npec-camera-rig/tests/fixtures/trays/blue-finder/sheets-every-tray.jpg

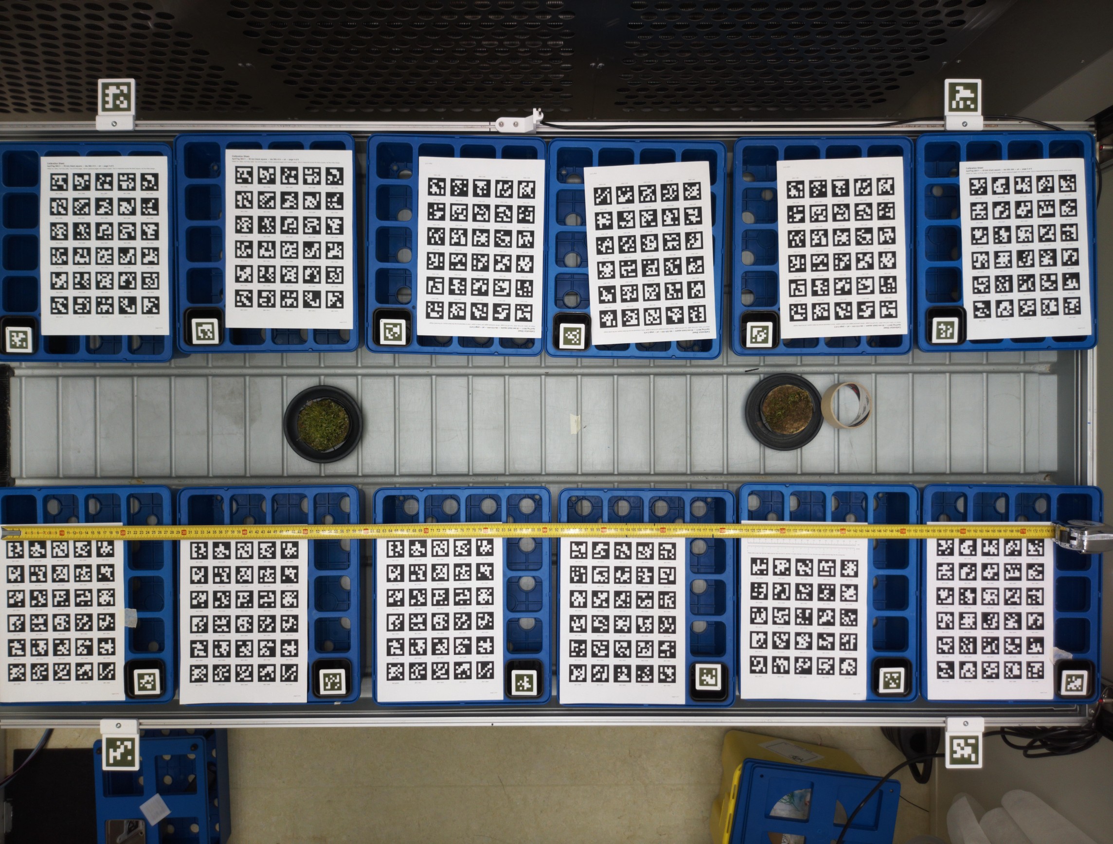
tests/fixtures/trays/blue-finder/sheets-every-tray.jpg
