txoof/npec-camera-rig/hardware/tray_tags_alternative/tag_outline_61.pdf

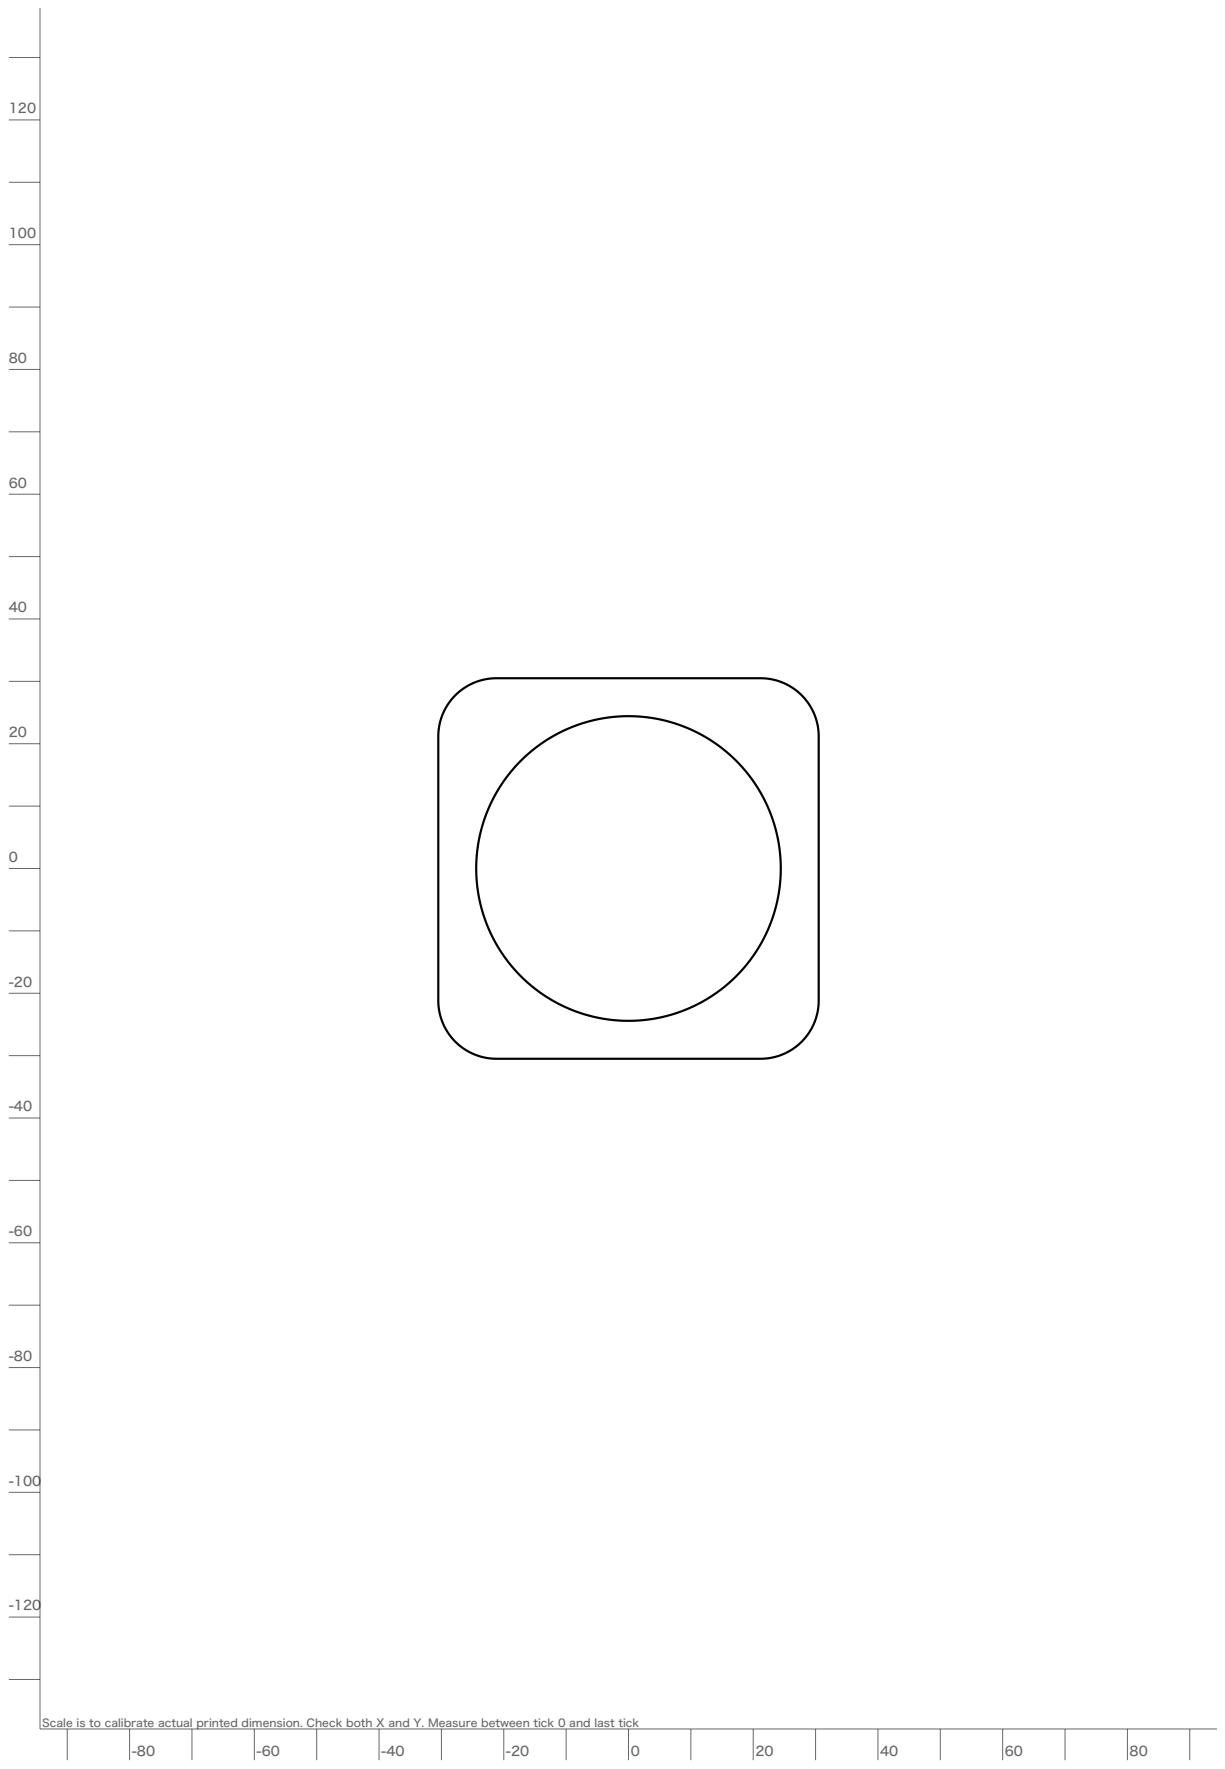
[picture p172: page 1]

Scale is to calibrate actual printed dimension. Check both X and Y. Measure between tick 0 and last tick
