txoof/npec-camera-rig/src/npec_rig/calibration_viz.py

"""Visual renderings of calibration data: the radial residual plot (the evidence gate for lens
distortion modelling, CLAUDE.md), the tag map with its histogram (where tags read far from the
run's norm, a setup aid), and the corner level overlay. Pure
rendering: every number drawn here already exists in `calibration.py`; nothing here measures or
derives anything new.
"""

from __future__ import annotations

import cv2
import numpy as np

from npec_rig.calibration import TableFrame
from npec_rig.text_render import draw_text, text_layer, text_width
from npec_rig.tripwire import CornerLevelReading

# A diagnostic image is for a human to glance at in a browser, not a measurement -- there is
# no reason to carry a real 64MP frame (and its ~190MB-plus of uint8 copies) through a resize,
# colour-map and blend just to shrink it back down for display. Capped well below the display's
# own resolution.
HEATMAP_MAX_WIDTH = 1600


# RGB. Amber (not a pure yellow) reads clearly against both a light table and a dark tray in
# the "drift" band.
LEVEL_OK_COLOUR = (0, 150, 0)
LEVEL_DRIFT_COLOUR = (210, 150, 0)
LEVEL_FAIL_COLOUR = (210, 30, 30)
_LEVEL_STATUS_COLOUR = {"ok": LEVEL_OK_COLOUR, "drift": LEVEL_DRIFT_COLOUR, "fail": LEVEL_FAIL_COLOUR}


def render_level_overlay(
    frame: np.ndarray,
    readings: list[CornerLevelReading],
    *,
    max_width: int = HEATMAP_MAX_WIDTH,
) -> np.ndarray:
    """`frame` (RGB) with each corner tag ringed green/amber/red by `CornerLevelReading.status`
    (see `tripwire.corner_level_readings`) -- for an installer levelling the rig by hand, reading
    the real photo rather than a rotation-in-degrees number. Downscaled first, then drawn on.

    `readings` may be empty (fewer than 2 corner tags currently detected) -- drawn as a plain
    frame with a caption saying so, not an error, since "can't judge yet" is itself useful
    feedback while an installer is still getting tags into frame.
    """
    full_height, full_width = frame.shape[0], frame.shape[1]
    scale = min(1.0, max_width / full_width)
    if scale < 1.0:
        img = cv2.resize(
            np.ascontiguousarray(frame[..., :3]),
            (int(round(full_width * scale)), int(round(full_height * scale))),
            interpolation=cv2.INTER_AREA,
        )
    else:
        img = np.ascontiguousarray(frame[..., :3]).copy()

    # Sized to the image, so the marks stay readable where the page shows it about a third of
    # its width (Aaron, 2026-10-13: "nearly invisible at 1024 scale").
    width = img.shape[1]
    radius = max(16, int(round(0.04 * width)))
    thickness = max(4, int(round(0.008 * width)))
    font = max(0.8, 0.0014 * width)
    if not readings:
        draw_text(
            img, "need at least 2 corner tags in frame to judge levelling",
            (20, int(45 * font)), font, (0, 0, 0), stroke_width=2,
        )
        return img

    labels = []
    for reading in readings:
        colour = _LEVEL_STATUS_COLOUR[reading.status]
        cx, cy = int(round(reading.centre[0] * scale)), int(round(reading.centre[1] * scale))
        _draw_level_mark(img, (cx, cy), radius, colour, thickness, reading.status)
        # The label goes on the side of the mark facing the image's middle, so it stays on it.
        text = f"{reading.deviation_pct:+.1f}%"
        gap = radius + thickness + 8
        x = cx + gap if cx < width / 2 else cx - gap - text_width(text, font)
        labels.append((text, (x, cy + int(12 * font)), colour))

    worst = max(readings, key=lambda r: abs(r.deviation_pct))
    if worst.status == "ok":
        caption = "co-planar within tolerance"
    else:
        direction = "closer" if worst.deviation_pct > 0 else "farther"
        caption = f"tag {worst.tag_id} reads {abs(worst.deviation_pct):.0f}% {direction} than the others"

    with text_layer(img) as t:
        for text, org, colour in labels:
            t.text(text, org, font, colour, stroke_width=3)
        # The caption in the middle at the top, between the two upper marks, and smaller than them.
        caption_font = 0.75 * font
        t.text(caption, ((width - text_width(caption, caption_font)) // 2, int(45 * caption_font)),
               caption_font, (0, 0, 0), stroke_width=2)

    return img


def _draw_level_mark(img, centre, radius, colour, thickness, status) -> None:
    """A shape as well as a color for each status, as the page's legend shows them (never color
    alone): a circle for ok, a triangle for drift, a circle with a cross for fail."""
    cx, cy = centre
    if status == "drift":
        points = np.array([
            (cx, cy - radius), (cx + int(radius * 0.87), cy + radius // 2), (cx - int(radius * 0.87), cy + radius // 2),
        ], dtype=np.int32)
        cv2.polylines(img, [points], True, colour, thickness, cv2.LINE_AA)
        return
    cv2.circle(img, (cx, cy), radius, colour, thickness, cv2.LINE_AA)
    if status == "fail":
        d = int(radius * 0.7)
        cv2.line(img, (cx - d, cy - d), (cx + d, cy + d), colour, thickness, cv2.LINE_AA)
        cv2.line(img, (cx - d, cy + d), (cx + d, cy - d), colour, thickness, cv2.LINE_AA)


RADIAL_PLOT_SIZE = 900
RADIAL_PLOT_MARGIN = 90
RADIAL_PLOT_TOP_MARGIN = 110


def radial_fit(points: list[tuple[float, float, int]]) -> tuple[float, float, float]:
    """The radial plot's straight line: `(slope, intercept, r_squared)` of an unweighted
    least-squares fit of each point's signed value (%) to its radius (px), `points` as for
    `render_radial_residual_plot`. The plot and the diagnostics readout both use it, so the two
    always show the same numbers. R**2 is 0 when every value is the same."""
    if len(points) < 2:
        raise ValueError(f"need at least 2 points for a radial fit, got {len(points)}")
    radii = np.array([p[0] for p in points])
    values = np.array([p[1] for p in points])
    slope, intercept = np.polyfit(radii, values, 1)
    ss_res = float(np.sum((values - (slope * radii + intercept)) ** 2))
    ss_tot = float(np.sum((values - values.mean()) ** 2))
    r_squared = 1.0 - ss_res / ss_tot if ss_tot > 0 else 0.0
    return float(slope), float(intercept), r_squared
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
