txoof/npec-camera-rig/src/npec_rig/calibration.py

"""Scale field across the measurement plane, built from tag spacing on the tag sheets.

PLAN.md's M2 section A: the scale field is the local scale (px/mm) as a function of position in
the frame. It is fitted to tag spacing: the distance between the centres of two tags of one tag
sheet over their distance as printed (the print layout files in `reference/calibration-sheets/`),
scaled by the calliper-measured tag size. Not to tag edges: in the rig's photos they read 1 to
2.5% short of tag spacing, by an amount that changes between photos, so areas read 1 to 5% high
(metrology log 18, #286).

The fit is a single tilted plane (relative depth linear in image x, y) -- validated on a real
capture where a plane explained the observed scale ramp to ~1.8% residual against a ~12% signal.
`residual_std_pct` is a *global* figure: how much scatter is left after removing that plane, as a
percentage of the mean scale. How far a measurement can be trusted at a position is not claimed
here: validation measures it per slot (issue #52).

`holdout_coverage_test` is PLAN.md's coverage check: fit on half the tags, predict the other
half, measure the error -- turns "is there enough coverage" into a number instead of a guess.
`regional_coverage_test` answers *where*: fit on three quadrants, predict the fourth, so a report
can say "add coverage in the top-left" instead of just a single global percentage.
"""

from __future__ import annotations

import json
from dataclasses import dataclass
from functools import cache
from itertools import combinations
from pathlib import Path

import numpy as np

from npec_rig.tags import ASSUMED_CALIBRATION_TAG_SIZE_MM, TagDetection, tag_area_px, tag_side_px
from npec_rig.tripwire import CornerBaseline
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
