txoof/npec-camera-rig/(commit log)

2026-09-19 Initial plan for NPEC camera rig
    Plant growth monitoring application for a Raspberry Pi 5 with an Arducam
    64MP camera and Hailo accelerator, serving a web UI from the Pi.
    Three previous attempts collapsed into camera metrology without shipping a
    working application. This plan is structured to prevent that:
    - The measurement plane is the in-focus slab at tray-top height, not the
    table. Since one experiment uses one tray height, this removes camera
    height estimation, parallax correction and the canopy height bias
    entirely rather than modelling them.
    - Calibration runs at two speeds: rare paper AprilTag sheets establish
    distortion and edge coverage; 12 fixed 30mm tray tags re-solve sc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
2026-09-19 Rescue measured calibration records from /var/lib before cleanup
    The only surviving record of the 2026-09-15/16 bench measurements lived
    outside version control in /var/lib/npec-camera and was about to be
    deleted. Copied byte-identical, with the measured values extracted into a
    README.
    The important ones: AprilTag size measures 29.3106 mm against a 30 mm
    nominal (~4.7% in area, the largest geometric error in the system), camera
    distance 1526.40 mm +/- 1.93, table tilt 2.76 deg, lens position 6.3
    dioptres.
    The records also carry an unresolved 2.1% area bias between table markers
    and tray-rim markers, recorded as a known defect that did not shrink with
    more frames. That bias exists because t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
2026-09-19 Mark old project frozen; separate stale rig geometry from valid constants
    The rig has been physically rebuilt into a new setup, which splits the
    rescued calibration values in two. Tag size (29.3106 mm) and tray height
    are properties of objects and survive the move; camera distance, table
    tilt, lens position and intrinsics describe a rig that no longer exists
    and must be re-measured. Only the former become pre-filled defaults.
    The 362 MB of bench frames stay where they are. They are from the previous
    rig iteration, so their geometry no longer matches the chamber. Recorded
    as available at their path for detector tuning or regression fixtures, but
    not copied in. New fixtures get captured from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
2026-09-19 Build M1 skeleton through slice 5 focus aid, with autofocus
    Slice 1: FastAPI+uvicorn skeleton, pytest marker infrastructure
    (addopts = -m unit), systemd unit (not installed/enabled yet, manual
    start only). uv used for venv/deps (pinned to system Python so
    --system-site-packages sees picamera2).
    Slice 2: CameraManager singleton, synthetic backend, snapshot endpoint.
    Slice 3: dual-stream live preview (MJPEG), lens-position control.
    Slice 5 (built ahead of slice 4 at Aaron's request): ROI selection,
    Laplacian-variance sharpness score, magnified 1:1 focus crop stream,
    lock/unlock, full-res capture-to-disk with JSON sidecar, recent-captures
    gallery. Added one-shot hardware autofocus (AfMode=Au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
2026-09-19 Fix black-and-white preview with garbled bottom third
    The lores stream was left format-unspecified and negotiated YUV420
    planar (a leftover encode="lores" hint implied a hardware-encoder
    pipeline we never actually use — we PIL-encode arrays ourselves).
    Treating that planar Y+U+V buffer as interleaved RGB produced a
    grayscale image with the packed chroma planes showing up as a
    garbled band in the bottom third of the frame (a YUV420 buffer's
    total height is 1.5x nominal, and that extra half is exactly a third
    of the whole).
    Fix: drop the unused encode hint and pin format: "RGB888" explicitly
    on both `main` and `lores` (video config) and `main` (still config),
    instead of trusting picamera2's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
    [camera.py]
2026-09-19 Revert wrong BGR888 change; add focus peaking
    Investigated Aaron's report of a known-yellow object rendering blue.
    Checked directly against picamera2 instead of assuming: a channel-swap
    test confirms "RGB888" genuinely returns R,G,B order (the "picamera2
    swaps RGB888" claim in the previous commit was wrong, not verified
    before writing it down — reverting the BGR888 change that followed
    from it, which would have made this worse). A neutral white reference
    in the same frame also reads back neutral, ruling out a white-balance
    cast. Conclusion recorded in TODO.md: most likely the chamber's grow
    lighting spectrum, not a software bug — flagged as a M5 concern
    (ExGSegmenter needs roughly correc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
    [app.py, camera.py]
2026-09-19 Note lighting-cycle hypothesis for the color discrepancy
    Aaron confirms earlier captures this session showed correct color and
    later ones didn't, with no relevant code change in between — points
    at the chamber's lighting changing (schedule/cycle/spectrum), not a
    software regression. Added a concrete TODO to check the lighting
    conditions directly.
2026-09-19 M1 slice 4: camera controls generated from probed ranges, SQLite persistence
    Control list (ExposureTime, AnalogueGain, AwbEnable, AeEnable, plus
    LensPosition's range) is probed from picamera2's camera_controls at
    runtime, not hardcoded. Justified by what the probes actually showed:
    LensPosition's max read 15.0, then 32.0, then 15.0 again; ExposureTime's
    max varied by two orders of magnitude; AnalogueGain's max read both 16
    and 64 — all across the same session, no code changes in between.
    These ranges are config/mode-dependent facts, not fixed hardware specs.
    Frontend renders whatever /controls reports generically (checkbox for
    booleans, slider for numerics), so a different camera or firmw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
    [app.py, camera.py, settings.py]
2026-09-19 Camera settings UI polish: collapse, reorder, pair AWB/AE, format exposure
    Moved the Camera settings section below Focus aid and wrapped it in a
    native <details>/<summary> (collapsed by default) rather than a custom
    toggle widget. AWB and AE checkboxes now render on one line together
    since they're both "auto X" toggles. Exposure time displays as a
    fraction of a second (e.g. "1/147 s") instead of raw microseconds —
    display-only, the API and slider still operate in microseconds.
    Reset the live rig to the stated default policy: auto exposure on,
    auto white balance on, analogue gain 1.0. Logged the "minimal gain at
    all times" requirement as a Needs Aaron item — default already
    satisfies it,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
2026-09-19 M1 slice 5 wrap-up: hardware autofocus, focus peaking, capture storage
    Persists the remaining M1 slice 5 changes: one-shot hardware autofocus via
    AfMode/AfTrigger (always returns to manual afterward), focus peaking overlay
    reusing the existing Laplacian machinery, coarse/fine lens position controls,
    and capture-storage/test additions. Also folds in small accuracy fixes to
    CLAUDE.md/reference/hardware-probe.md noting that LensPosition's range is
    sensor-mode-dependent, not a fixed hardware fact.
    See TODO.md's M1 slice 5 section for the itemized, already-verified detail.
    [app.py, camera.py, captures.py, settings.py]
2026-09-24 M2: Calibration and rig health (#1)
    * M2 slice 1: AprilTag detection with tuned cv2.aruco parameters
    Adds src/npec_rig/tags.py: DICT_APRILTAG_36h11 detection using the previous
    rig's tuned DetectorParameters (CORNER_REFINE_SUBPIX, minMarkerPerimeterRate,
    adaptive threshold window), reused rather than re-derived per PLAN.md.
    detect_tags() returns sorted TagDetection records; draw_overlay() marks them
    for a visual check.
    Unit tests use cv2.aruco.generateImageMarker for known-ID, multi-tag, and
    rotation cases -- deterministic and hardware-free, testing our wrapper code
    rather than the detector's own algorithm -- plus one narrow real-photo smoke
    test against a small crop containing exactly one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
2026-09-25 Fix auto exposure/AWB getting stuck until untick/retick (#3)
    * Fix auto exposure/AWB getting stuck until untick/retick
    Two independently confirmed causes: capture_full_res()'s reconfigure
    cycle silently drops AeEnable/AwbEnable state without updating the
    app's own cache (explains AE and AWB sticking together), and a stale
    persisted manual ExposureTime/AnalogueGain gets replayed on top of
    AeEnable=True on every restart, re-arming picamera2's manual-exposure
    latch (ExposureTimeMode/AnalogueGainMode) that AeEnable alone doesn't
    clear. Also disables the exposure/gain sliders while AE is ticked so a
    live slider nudge can't re-arm the same latch.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
    [camera.py]
2026-09-25 Move 3D-model CAD files into hardware/ (#5)
    Brings in the parametric OpenSCAD models for printed mounting hardware
    (brackets, camera mount, cold shoe, slide pocket) and T-slot extrusion/bolt
    standins, previously developed standalone in ../3d-models. Includes vendored
    BOSL2 (screw geometry), STL exports, rendered preview images, and vendor DXF/DWG
    reference profiles for the 40x40 extrusion.
    Not tied to a PLAN.md milestone number, so this is a standalone PR rather than
    an m<N>-branch per CONTRIBUTING.md's milestone convention.
    [54.01.0100(00-00-0)(000)_front.dwg, 54.01.0100(00-00-0)(000)_front.dxf, 54.01.0100(00-00-0)(000)_right.dwg, 54.01.0100(00-00-0)(000)_right.dxf, 54.01.0100(00-00-0)(000)_top.dwg, 54.01.0100(00-00-0)(000)_top.dxf, BOSL2logo.scad, affine.scad]
2026-09-25 Fix live reorientation aid: read main stream, not lores, for corner-tag detection (#8)
    The lores preview stream (320x240) was too low-resolution for detect_tags to
    find the 50mm corner tags at all, so /calibration/orientation/zero always
    refused with "no corner tags detected." Confirmed on real hardware before
    changing anything: main stream (1536x1152) finds all 4 corner tags reliably.
    Switched both orientation endpoints to CameraManager.capture_array() (mirrors
    the existing capture_preview_array()); no pipeline reconfigure, so no full-res
    capture-then-autofocus hang risk. Verified end-to-end against real hardware
    after the fix.
    Also logs the two-baseline acceptance test (run remotely today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
    [app.py, camera.py]
2026-09-25 Add mini ball head model, clean up rig_assembly, add BOM/install docs (#9)
    * add images
    * update drawings
    * remove old stl
    * add stl
    * update BOM and instructions
    [cold_shoe_stud.scad, l_bracket_4020.stl, l_bracket_4020_bin.stl, mini_ball_head.scad, rig_assembly.scad]
2026-09-26 M2: leveling/certainty diagnostics, Setup-page redesign, calibration wizard rework (#10)
    * Add live leveling overlay; make DejaVu Sans Bold the default annotation font
    New tool for physically leveling the rig: tripwire.corner_level_readings()
    compares the currently-detected corner tags' apparent sizes to each other
    (no zero/baseline step, valid regardless of how each tag is mounted, since
    apparent size under a pinhole projection depends only on distance from the
    camera). calibration_viz.render_level_overlay() draws green/amber/red rings
    directly on the live camera image at each tag's real position, and
    GET /calibration/orientation/level.jpg serves it. Verified against real
    hardware.
    Also r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
    [app.py, calibration_store.py, calibration_viz.py, tags.py, text_render.py]
2026-09-26 M2: calibration history browser (#11)
    * Calibration history: cheap per-entry stats, promote, and delete endpoints
    Slice 1 of the calibration-history browser (reference/plans/calibration-history-browser.md):
    /calibration/list now carries stem, created_at, residual_std_pct, calibration_tag_size_mm,
    corner_tag_count, and is_current for each saved run -- all already on the artifact, no
    re-detection. Coplanarity/holdout/area-scale error need re-detecting tags from the saved frame
    and are deliberately left for a later per-entry drill-down slice, per the plan doc's "real gaps"
    section and Aaron's answer to skip the unmeasured-timing question for now.
    New POST /calibration/{stem}/promote and DELET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
    [app.py, calibration_store.py]
2026-09-26 TODO.md: log three wizard UX items from live review (2026-09-26)
    Honesty plot purpose (user-facing vs. metrology-only), Step 3 Back/Next button style mismatch,
    and the wizard's overall wordiness -- all raised by Aaron looking at the live wizard, not yet
    actioned.
2026-09-27 M2: view diagnostics for a past calibration, not just whatever's active (#12)
    * Add stem-scoped diagnostics endpoints for the calibration-history drill-down
    Slice 1 of the past-run diagnostics view (TODO.md's "let the two heatmaps and
    the best-vs-worst-tag rank plots be viewed for a past calibration"): new
    /calibration/{stem}/rank-plot, best-worst-photo, radial-plot, and
    certainty-dome-plot routes, alongside the existing /calibration/current/*
    ones. Each pair now shares one implementation function that takes an
    artifact directly, so the "current" routes are thin wrappers rather than
    duplicated logic. No frontend yet.
    * Add per-stem d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
2026-09-28 M2: calibration wizard step order, Lock-focus gate, and UI fixes (#14)
    * M2: reorder calibration wizard steps for focus-target and lock validity
    New order: place sheets, confirm focus, check squareness, confirm
    coplanarity, run calibration, read report, remove sheets. Focus needs a
    real tray and tag at working height in frame, and the squareness/
    coplanarity visual checks need a sharp image to judge by eye, so both
    constraints put sheet placement first and focus right after it.
    _focus_controls.html's live-stream/score gating took a hardcoded step
    number (1); parameterized to a `step` argument so the shared partial
    still works correctly now that focus is wizard step 2, and unchanged on
    setu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
    [app.py, camera.py]
2026-09-29 M2: MJPEG streams notice disconnect, bound the camera lock wait (#15)
    * M2: MJPEG streams notice disconnect, bound the camera lock wait
    _mjpeg_frames was a sync generator, so Starlette ran it through anyio's
    threadpool with cancellation shielded per frame: a client disconnect could
    only stop the loop between frames, never mid-call, and if the frame call
    blocked on CameraManager._call_lock (contended by a slow autofocus or
    reconfigure), it never got to "between frames" at all, pinning a worker
    thread forever. Confirmed by reading the installed Starlette/anyio source
    directly. Each reload added another pinned thread; once anyio's 40-thread
    pool was exhausted, every other route hung too, match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
2026-09-29 Hardware: AprilTag corner mounts and multi-color 3MF export (#16)
    * Add AprilTag corner mount and 36h11 tag geometry (450-499)
    OpenSCAD design for mounting a 36h11 AprilTag to a table's 20x20
    T-slot rail with M4 hardware, plus the corresponding tag geometry
    range for the physical print.
    * Add april_tag() render module and full-family 36h11 bits data
    apriltag_36h11.scad exposes april_tag_base()/april_tag_pattern() as two
    separate, never-unioned solids (base plate, raised black layer) so a
    multi-material print can carry real per-object color through to 3MF export.
    apriltags-36h11-1-499.scad replaces the old per-id-named-variable forma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
    [3mf_test.scad, apriltag_36h11.scad, apriltag_corner_mount.scad, apriltag_corner_mount_450-453.3mf, apriltags-36h11-1-499.scad, apriltags-36h11-450-499.scad]
2026-09-29 Hardware: hex-key wrench handle on the Arducam mount (#17)
    Adds a hex-key wrench handle to the Arducam 64MP mount so the camera can be aimed from outside the frame. The key's long arm slides into the handle and works as a lever, which also makes small adjustments easier.
    ## Changes (`hardware/arducam64_mount.scad`, REV 1.1 and 1.2, stamp RV1.2)
    - **Handle** on the +X edge, centered on the plumb hole's Y (47.25), so it lines up with the optical axis. The block is 10 wide x 9.8 tall and sticks out 18 mm.
    - **Hex socket**, blind, for a 4 mm key: 16 mm deep (the key goes in at least 15 mm), 4.35 mm across flats (0.35 mm clearance), with a 0.6 mm lead-in chamfer. A vertex points up, so it print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
    [arducam64_mount.scad, arducam64_mount.stl]
2026-09-29 M2: default calibration tag size to the measured 30.0 mm (#18)
    ASSUMED_CALIBRATION_TAG_SIZE_MM was 29.3106, the previous rig's printed
    tags. Current sheets measure 30.0 +/- 0.1 mm (callipers, 2026-09-29), so
    any run without a calliper entry was reading areas ~4.7% wrong. Docs,
    help page and the calibration template now describe 29.31 mm as the old
    rig's print and keep the lesson: measure every print.
    [tags.py]
2026-09-30 M2: per-tray-slot area certainty map (#19)
    * M2: per-tray-slot area certainty map (engine and routes)
    certainty_map.py turns calibration tags into the supervisor's per-zone
    answer: each tag's area error vs the calliper-measured size, sheets
    grouped by proximity, 12 tray slots (North 1-6, South 1-6) fixed by the
    calibration frame, and per-slot p95 |error| pooled over validation
    captures taken after sheets and trays were moved. Touching sheets and a
    calibration frame without 12 sheets are refused with a clear message.
    GET /calibration/{current,<stem>}/certainty-map?captures=... renders it.
    Validation captures cache detections plus a 2000 px preview only, not
    full 64MP frames. Slot layout is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
    [app.py, certainty_map.py]
2026-09-30 CLAUDE.md: current tags measure 30.0 mm; uv.lock: add jinja2 (#20)
    CLAUDE.md: the 29.3106 mm figure belongs to the previous rig's printed
    tags. Current sheets measure 30.0 +/- 0.1 mm (callipers, 2026-09-29);
    the lesson is to measure each print.
    uv.lock: pyproject.toml has required jinja2 since #13, but the lock
    never listed it (or markupsafe).
2026-09-30 M2: validation page with sessions, rounds and history (#21)
    * M2: validation page with sessions, rounds and history
    /setup/validation runs a validation of the active calibration on demand,
    independent of the wizard: move each sheet on its tray, shuffle the
    trays, capture a round, repeat. 3 counted rounds complete it and stamp
    the date; more rounds only add tags. The per-slot certainty map refreshes
    after each round, drawn on the latest counted capture.
    A round is held back, with its reason, when focus isn't locked at the
    calibration's lens position or fewer than half its tags moved more than
    5 mm from the calibration frame and every earlier counted round; both
    can be counted anyway. A roun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
2026-09-30 M2: validation readout: per-round table, visible map (#23)
    * M2: validation readout: per-round table, visible map, clear selected session
    The page's map never displayed: .diagnostic-image is display:none by
    default and the page toggled the hidden attribute instead, so the only
    image visible was the history thumbnail, whose unchanging URL the browser
    cached. Now shown via style.display, thumbnails cache-bust per round.
    Under the map, a table gives every slot's +/-% and median for each
    counted round, the pooled figure, and how far the median moved across
    rounds, highlighting slots whose median moved more than 1.5 points: the
    question validation answers is whether a slot reads the same after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
2026-09-30 M2: validation page fits 1024x768, Start/End validation; focus and layout TODO items (#24)
    * TODO.md: locked focus lost on restart; validation round should check focus first
    * TODO.md: focus lock wording and a visible focus status line
    * TODO.md: validation page layout needs too much scrolling at 1024x768
    * M2: validation page fits 1024x768; Start/End validation
    Start validation and Capture round at the top; the button becomes End
    validation while a validation is open. Map and per-round table side by
    side, status and da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
    [app.py, validation_store.py]
2026-09-30 M2: validation controls on one line; Capture only while a validation is open (#26)
    Capture round sits beside Start/End validation and is greyed out until
    a validation has been started; it always captures into the open
    validation. Sessions saved before End validation existed read as ended,
    so the page no longer loads in the End validation state.
    [validation_store.py]
2026-09-30 Hardware: AprilTag mount quiet zone clears the chamfer, ridge clearance (RV1.10) (#22)
    * Hardware: AprilTag mount quiet zone clears the transition chamfer (RV1.10)
    The chamfer rises off the tag plate over Y in [-tr,0], so the rail-side
    quiet zone was tag_border - tr (negative at 6.3 vs 7 mm: the chamfer
    overlapped the tag). The plate is now tr deeper and the tag sits tr further
    out, giving tag_border of flat surface on all four sides.
    Also carries Aaron's RV1.10 tuning: tag_border 6.3, bolt_dia 5.5,
    ridge_w 5.1, ridge_relief 22.
    * Hardware: AprilTag mount ridge_clearance, 0.15 mm per side
    ridge_w is now the measured 5.10 mm slot mo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
    [apriltag_corner_mount.scad]
2026-09-30 Hardware: remove unused 3mf_test.scad and apriltags-36h11-450-499.scad (#25)
    Neither file is included by any design. apriltag_36h11.scad takes its bit
    data from apriltags-36h11-1-499.scad, which stays. Stale references in
    hardware/README.md and the corner mount header removed.
    [3mf_test.scad, apriltag_corner_mount.scad, apriltags-36h11-450-499.scad]
2026-09-30 M2 validation wording (#28)
    * M2: validation page wording: what validation shows; no contractions
    Help text now explains why calibration alone cannot show per-slot
    accuracy (Aaron's wording, 2026-09-30). No contractions on the page or
    in the server messages it and the history page show. TODO for the
    remaining pages.
    * TODO.md: next slice, validation drift and suspect-sheet flags with a fault test
    ---------
    [app.py]
2026-09-30 Hardware: AprilTag mount RV1.10 export, black tag layer (#27)
    Tag layer color DarkGreen -> Black. Adds the RV1.10 export under the name
    scad_to_3mf.py and hardware/README.md use (exports/apriltag_corner_mount.3mf),
    the file the passing test print came from, and removes the pre-RV1.10
    apriltag_corner_mount_450-453.3mf it supersedes.
    [apriltag_corner_mount.3mf, apriltag_corner_mount.scad, apriltag_corner_mount_450-453.3mf]
2026-10-01 Hardware: AprilTag tray tag (clip and bolt styles), 3MF grouping fix (#30)
    - apriltag_tray_tag.scad (RV1.10): 30 mm 36h11 tray tag, two-color
    multi-material print. Clip style (90 deg tab over the tray edge) or bolt
    style (in-plane 25 mm tab, M8 clearance hole, optional flush with +X).
    Flat or on-side layout; clip tags on the side nest in flipped, raised
    pairs.
    - scad_to_3mf.py: group each tag layer with the nearest overlapping body
    in build order; same-color bodies are never merged, so nested parts
    stay separate objects.
    - .gitignore: hardware/*.json (Customizer presets).
    - exports: tray tag 3MFs, ids 1-12 clip and 13-24 bolt.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
    [apriltag_tray_tag.scad, apriltag_tray_tag_1-12-tab.3mf, apriltag_tray_tag_13-24-bolt.3mf]
2026-10-02 Hardware: tray type labels, tab/bolt per tray type, batch tag exports (#31)
    * Hardware: tray type label on tray tags, batch 3MF export
    apriltag_tray_tag.scad REV 1.11: engraves the tray type (4x5, 4x4,
    1x1, OTHER) in the quiet zone's top-right corner, chosen from the id
    (1-100, 101-200, 201-300, 301-399). Ids are limited to 1-399.
    scad_to_3mf.py: -n/--name sets the output file name.
    tray_tags.py: exports id groups (e.g. 1-12 13-24 101-113), one 3MF per
    group, refusing groups that cross a tray type boundary.
    * Hardware: tag style "clip" renamed "tab", per-type default styles, tray tag exports
    apriltag_tray_tag.scad REV 1.12: tag_st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
    [apriltag_corner_mount.scad, apriltag_tray_tag.scad, apriltag_tray_tag_1-12-tab.3mf, apriltag_tray_tag_13-24-bolt.3mf, apriltag_tray_tag_1x1_151-162_bolt.3mf, apriltag_tray_tag_1x1_163-174_bolt.3mf, apriltag_tray_tag_1x1_175-186_bolt.3mf, apriltag_tray_tag_1x1_187-198_bolt.3mf]
2026-10-02 M2: validation drift and problem flags, consistent lens drive, image system, central-error docs (#29)
    * M2: validation status: Not consistent when a slot median moves more than 2.5 points
    Validated only while complete and no slot's median moved more than
    MEDIAN_DISAGREEMENT_PCT across counted rounds, judged live so a later
    drifting round takes the status away. Threshold 1.5 -> 2.5: a real
    no-fault validation moved North 4 by 1.96 points.
    * M2: map caption: all slots when every slot drifts; Ended before completion
    * M2: validation names the round and slot behind each inconsiste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
    [app.py, camera.py, certainty_map.py, images.py]
2026-10-02 Hardware: reorganise into camera_rig/, tray_tags/, libraries/ (#32)
    * Hardware: reorganise into camera_rig/, tray_tags/, libraries/
    Folders:
    - camera_rig/: printable rig parts, the AprilTag corner mount, rig_assembly mockup
    - tray_tags/: apriltag_tray_tag.scad
    - libraries/: BOSL2, T-slot and bolt stand-ins, purchased-part stand-ins
    (cold_shoe_stud, mini_ball_head), AprilTag geometry and bit data
    - exports/camera_rig/: the four loose rig exports
    - cold_shoe.scad removed (created in error, nothing used it)
    use/include paths are relative (../libraries/...); OpenSCAD resolves them
    from the including file, nested includes too. Scripts resolve their .scad
    files and default output folders from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
    [apriltag_corner_mount.3mf, apriltag_corner_mount.scad, apriltag_tray_tag.scad, arducam64_mount.scad, arducam64_mount.stl, cold_shoe.scad, l_bracket_4020.scad, l_bracket_4020.stl]
2026-10-02 M2: validation status on Setup and Calibration, wizard leads on to validation (#33)
    * Validation status on the Setup and Calibration pages; not-counted message matches the page
    One status for the active calibration at the current focus lock (GET /validation/status),
    shared by the map caption. Status only, nothing is blocked by it.
    * Calibration wizard ends by leading on to validation, with a way back to Setup
    Step 6 was Remove sheets, but validation needs the sheets on the trays: they now come off after
    validation.
    * TODO: validation status slice built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
2026-10-02 M2: no contractions on the Setup calibration, focus, history and health check pages (#34)
    * No contractions on the Setup calibration, focus, history and health check pages
    Expands every contraction in setup_calibration.html, _focus_controls.html,
    setup_calibration_history_diagnostics.html and setup_health_check.html
    (code comments included, one verbatim quote kept), and the page-facing
    focus-gate message in app.py. Text only. TODO updated, plus a new low
    priority Step 2 preview item.
    * No em or en dashes on the Setup calibration, focus, history and health check pages
    Replaces all 85 (83 characters, 2 &ndash; entities) with commas, c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
    [app.py]
2026-10-03 M2: focus status shows the active calibration's lens position (#35)
    * TODO: validation focus-before-sheets was built in #29
    * Focus status shows the active calibration's lens position, red when it differs
    * Focus status refreshes after a calibration run
    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
2026-10-05 TODO: Lock focus gate is built; close two checked items (#36)
    * TODO: Lock focus gate is built, sits before Run calibration
    * TODO: close no-contractions and focus status items, checked by Aaron
    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
2026-10-05 Reference: lens-return test, run 1 (autofocus moved, re-locked at 6.15) (#38)
    * Reference: lens-return test run 1, measurement comes back after re-locking
    Autofocus moved the lens 4 times, re-locked at 6.15: 355 tags matched
    the baseline within noise (median -0.03, SD 0.28 points); over 60 min the
    largest slot median moved +0.35 points, under a fifth of the narrowest
    validation band. Restart and power-cut runs planned.
    * TODO: high priority formal write-up of the rig's metrology and confidence numbers
    * Lens-return report: the size of the autofocus moves is not known
    Co-Autho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
2026-10-05 M2: autofocus waits at most 60 s instead of hanging the camera (#37)
    * TODO: track the focus-drift check, note the background-dependent sharpness score
    * Autofocus waits at most 60 s, then cancels and leaves the lens in manual
    picamera2's autofocus_cycle(wait=True) has no limit; when the scan never
    starts after a pipeline reconfigure it held _call_lock and every camera
    call hung until a restart. Bound the cycle and the metadata read, cancel
    the stuck job on timeout, restore manual focus at the previous position,
    clear the lock and report timed_out to the page. Cycle duration logged.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
    [app.py, camera.py]
2026-10-05 Metrology: why the measurements can be trusted, the log, and run 2 (app restart) (#39)
    * docs/metrology.md: the repeat-photograph stability test, its procedure and runs; method written before a test runs
    * Lens-return run 2: an app restart adds nothing detectable; restore the Limits heading
    Two attempts (first disturbed after +0): right after the restart median
    +0.09 and +0.08 points; over 60 min inside the control range, largest
    slot -0.29 points. Report and docs/metrology.md updated.
    * docs: measurement-trust.md makes the case for trusting the measurements; metrology.md rena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
2026-10-05 Docs: M2 chamber acceptance results (2026-10-05) (#40)
    * docs: measurement-trust.md makes the case for trusting the measurements; metrology.md renamed metrology-log.md
    The trust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
2026-10-06 Hardware: auto-focus bracket and AprilTag 500, full 36h11 tag data (#41)
    New camera_rig/auto-focus_bracket_2020.scad, two parts printed together
    under one revision (RV0.7):
    - 90-degree 20x20-to-20x20 bracket: 80 mm flat leg, 75 mm upright on
    its -Y edge at the X=0 end, two bolts per leg, keyed ridges with bolt
    reliefs (corner-mount ridge values), configurable bolt size.
    - 50 mm 36h11 tag, id 500, quiet zone only, with a one-bolt leg at the
    +X/-Y corner. Id engraved in the quiet zone like the tray tags.
    - on_side print orientation: both parts stand on an edge.
    AprilTag libraries: apriltags-36h11-1-499.scad replaced by
    apriltags-36h11-0-586.scad (full 36h11 family, regenerated with
    apri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
    [auto-focus_bracket_2020.3mf, auto-focus_bracket_2020.scad]
2026-10-06 Hardware: part names on every printed part; tag id 500 provisional (#42)
    * Docs: tag id 500 provisionally the auto-focus target
    PLAN.md's tag id table gets a provisional row for 500 (auto-focus
    target, plan not fully implemented). The id-0 note now points at the
    full 0-586 bit data. tags.py's RESERVED_ID_RANGE comment and the
    hardware README's range sentence mention 500; the README file table
    names apriltags-36h11-0-586.scad. Comments and docs only.
    * Hardware: part names engraved on every printed part
    Each printed part now carries its file name (without .scad) beside its
    revision, on an XY face where one fits ([Label] group, `part_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
    [apriltag_corner_mount.scad, apriltag_tray_tag.scad, arducam64_mount.scad, l_bracket_4020.scad, l_bracket_4040.scad, m5_slide_pocket.scad]
2026-10-07 M2: lens follows commands or says so; photos never move the lens; focus lock enforced (#43)
    ## What shipped
    - **Stuck lens after a photo, handled.** Measured 2026-10-06: after any full-res photo the camera accepts lens writes and moves on none, but the lens stays where it was. Photos now leave the lens alone (no reopen, no drive back, 2.7 s instead of 4.3 s); the camera is reopened only before the first lens command after a photo (`Picamera2Backend.prepare_lens`).
    - **Every lens command is confirmed.** Manual moves, Lock focus and the drive at start-up wait up to 5 s for the camera to report the new position. Lock focus must see the approach position (target - 0.3) reported first, so a stal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
    [app.py, camera.py, validation_store.py]
2026-10-08 M2: camera swap comparison, recalibration after packing foam, chamber cycle evidence (#44)
    * metrology-log: camera swap comparison method (8.2), before it runs; 2026-10-07 validation as baseline
    * metrology-log: run 3j against the chamber record, method before the comparison
    * metrology-log: the 19-minute cycle follows the chamber's temperature and humidity cycle
    Run 3j against the chamber's 1-minute log: air temperature 19.8 to 20.3 C and
    humidity 57 to 62% both repeat every 19 minutes; temperature correlates +0.84
    with the all-tag median (chamber 1 min ahead), humidity -0.76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
2026-10-08 TODO: M2 triage, 2026-10-08 (#45)
    * TODO: M2 triage, 2026-10-08 (close, defer or must-fix every open M2 item)
    Every open M2 item now carries a "Triage 2026-10-08" note with its decision
    and reason, agreed row by row with Aaron.
    - New "M2 close-out: must fix before M3" list at the top of M2: test camera
    frames, lens plan slices 2 and 4, manual exposure restore, camera-call
    time limits (compare watchdog vs separate camera process first), exposure
    slider, one copy of the camera settings panel, remove the claimed
    uncertainty, and the formal write-up gaps.
    - 22 items closed in place, with commit or metrology-log evidence.
    - Deferred items moved, full text kept: M3 (plot review first, pr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
2026-10-08 Parallel agent work: board, claiming, areas, worktrees (#46)
    Adds the rules for several agent sessions working at once, taken from
    the PaperPi setup: issues with an in-progress claim label, an area map,
    board 5, worktrees in ~/wt, and a hardware label as the lock on the
    camera and the port 8000 server. CONTRIBUTING.md moves from one PR per
    milestone to one PR per task. Adds the Task issue template and
    CODEOWNERS.
2026-10-08 TODO.md frozen: open items moved to issues #47 to #97 (#98)
    Every open TODO.md item (88 not started, 6 needs Aaron, 1 open
    follow-up inside a done item) is now a GitHub issue on board 5, grouped
    into 51 task-sized issues. Each open item is replaced by its first line
    and its issue number. Done items stay as they were, because about 50
    code comments and documents point to them. CLAUDE.md now calls TODO.md
    a frozen record and says agents work only on issues in the milestone
    Aaron names.
2026-10-08 CLAUDE.md: pick issues by board Priority and milestone order (#99)
    Agents read the milestone description (the triage and Aaron's order)
    and take the highest Priority unclaimed issue whose Area does not
    overlap a claimed one. Adds the Priority field and option ids.
2026-10-08 Formal write-up: raw-data sources, repeat counts, SN001 coverage (#47) (#101)
    * docs: raw-data sources, repeat counts and SN001 coverage (#47)
    metrology-log: calliper readings with dates and method (2026-09-21, not 09-29;
    scale bars are 3 readings per sheet), NEIKO callipers, camera height source,
    the height test written up (0.145%/mm is the model slope; the test gives 0.149
    to 0.160), calibration residual spread per camera, validation file paths,
    central-error rings and raw data, the old noise figure's real statistic,
    lens-run raw paths, section 11 items 2, 3 and 5 resolved, new section 13
    listing which results cover SN001.
    measurement-trust: status, validation evidence and central-error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
2026-10-08 docs: tray heights by callipers, camera height a tape-measure estimate (#47 follow-up) (#102)
2026-10-08 M2: synthetic 4-channel frames; photos record lens check and cold-start window (#48, #49) (#104)
    * Synthetic camera: 4-channel video frames, 3-channel still, like the real camera
    Part of #48.
    * Photos record a lens check against the focus lock; gallery shows the flag
    Each sidecar gets lens_check: the photo's own reported LensPosition, the lock, and a flag
    with a reason when focus is not locked, no position was reported, or the two differ by more
    than 0.005. Both photo paths (Capture, validation rounds) share one sidecar helper.
    Part of #49.
    * Photos record Pi and app uptime;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
2026-10-08 M2: exposure and gain in DSLR 1/3-stop steps, typed values, help panel (#50) (#105)
    * Camera settings: exposure and gain in DSLR 1/3-stop steps, typed box with units, help panel
    Exposure slider steps through 1/6400 s to 1 s as a DSLR shows them, each label set exactly
    (1/125 s is 8000 us); a box takes any value in ms. Gain steps 1, 1.25, 1.6 ... 64, box in x.
    The last slider position is always sent. A 'How to use the camera settings' panel explains
    each control.
    Part of #50.
    * Camera settings: with auto exposure on, show what the camera uses, marked (auto)
    The greyed-out exposure and gain re-read the camera every 2 s while auto exp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
2026-10-09 M2: one function takes every still and saves it in rig/ (#103, PR 1) (#107)
    captures.take_photo(purpose) takes the still, builds the sidecar (purpose,
    focus, lens check, uptime, flags) and writes JPEG plus sidecar atomically
    under /var/lib/npec-rig/rig/<day>/. Capture and validation rounds use it.
    Calibration and tripwire move to it in PR 2. Photos are served at /photos;
    the old captures/ folder is no longer read. Env var NPEC_RIG_PHOTOS_DIR
    replaces NPEC_RIG_CAPTURES_DIR.
    [app.py, calibration_store.py, captures.py]
2026-10-09 Hardware: park version 2 tray tags in tray_tags_alternative (#109)
    Version 2 of the tray tag (RV2.1), developed 2026-10-08: four designs
    chosen from the tag id (4x5 lip, 4x4 lip, 1x1 lip with bolt tab,
    black_tray 51 mm disc), with the 61 mm outline used for the paper check.
    Not in use: tray_tags/apriltag_tray_tag.scad (version 1) and
    tray_tags.py are unchanged. README.md describes how version 2 works and
    what adopting it would take.
    [apriltag_tray_tag.scad, tag_outline_61.scad]
2026-10-09 M2: calibration and tripwire photos through take_photo (#103, PR 2 of 2) (#108)
    * M2: one function takes every still and saves it in rig/ (#103, PR 1)
    * M2: calibration and tripwire photos through take_photo (#103, PR 2)
    Calibration and t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
    [app.py, calibration_store.py, camera.py, captures.py]
2026-10-09 M2: camera in its own program, time limit on every call, camera-fault flag (#51, #49) (#110)
    * M2: camera in its own program, time limit on every call, camera-fault flag (#51, #49)
    The camera code runs in a separate process (camera_process.py). ProcessBackend
    stands in for it with the same CameraBackend interface. Every call has a time
    limit. When one runs out, the program is ended, a new one opens the camera, and
    CameraManager restores the settings and the lock the way an app start does.
    A camera that does not open is reported (failed_to_reopen, reboot_needed), never
    replaced by synthetic frames; only missing camera software falls back.
    health.py holds the camera state for the status line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
    [app.py, camera.py, camera_process.py, captures.py, health.py]
2026-10-09 M2: remove the calibration's claimed uncertainty from the operator's view (#52) (#112)
    The claim (UncertaintyField) was smaller than the measured validation error
    in 7 of 12 slots. Only validation's per-slot band is reported now.
    Removed from the pages: confidence heatmap, accuracy-shape heatmap,
    scale-residual table view, Dome of certainty, and the Honesty plot panel on
    Health check. Removed routes: /calibration/current/uncertainty,
    /calibration/honesty-plot, the certainty-dome-plot routes. New runs no longer
    build the field, render its images or save it in the calibration JSON. The
    URL fields and has_uncertainty_field are gone from /calibration/current,
    /calibration/list and the run resul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
    [app.py, calibration.py, calibration_viz.py]
2026-10-09 M3: capture table in rig.db, one row per photo, with its calibration and validation (#54) (#113)
    * M3: capture table in rig.db, one row per photo (#54, slice 1)
    database.py holds the experiment's tables as numbered migrations, applied
    in order on first use and tracked by the file's user_version, each in one
    transaction. Migration 1 creates capture. take_photo adds a row for every
    photo: time, path, purpose, active calibration, lens, focus lock, exposure,
    gain, flags. A database failure is logged; the photo and sidecar are kept.
    The rig's housekeeping tables are not touched.
    * M3: each Capture photo records the validation whose bands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
    [app.py, captures.py, database.py]
2026-10-09 Replace the honesty plot in PLAN.md and the evidence gate (#114) (#115)
    The calibration's claimed uncertainty was removed (#52), so the honesty plot
    (claimed against actual error) has nothing to plot. Decided with Aaron,
    2026-10-09:
    - M2 acceptance: validation in every slot, plus a repeat validation on
    another day checked against the first session's bands.
    - M5 acceptance and Verification strategy: known-area targets in all 12
    slots through the canopy-area pipeline, 2 or 3 runs, at least 11 of 12
    inside their band per run, no slot outside in 2 runs.
    - Intrinsic-calibration evidence gate (PLAN.md, CLAUDE.md): the radial plot
    shows error growing toward the frame corners, beyond the kn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
2026-10-09 M2 acceptance on camera SN001: method (#116) (#117)
    * Metrology log: M2 acceptance method for camera SN001, draft (#116)
    Section 14 written before any test runs: repeat validation, tape measure,
    two calibrations in a row, two heights, roll and knock, closing
    calibration. Section 9 methods unchanged so results compare with SN000.
    Three decisions pending Aaron: the repeat validation's first session and
    pass rule, and the substitute for PLAN.md's power cycle.
    * Metrology log: section 14 decisions from Aaron (#116)
    First session for the repeat validation, its pass rule, and a cold start
    between the two calibrations with settling-hour ph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
2026-10-10 M3: export an experiment as one zip with a checksum manifest (#119, first version) (#122)
    * M3: export a stopped experiment as one zip with a checksum manifest (#119)
    First version, agreed with Aaron 2026-10-09. The Export button on the
    experiments page builds, in the background, a zip with the photos and
    sidecars, experiment.json, captures.csv, copies of the calibration and
    validation records used, a README and MANIFEST.sha256 (sha256sum -c).
    Kept in the experiment's exports/ folder and recorded in a new export
    table (migration 3) with the manifest's own checksum, for purge to check.
    An export cut off by a restart is marked failed at the next start.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
    [app.py, database.py, exports.py]
2026-10-12 update bom (#123)
2026-10-12 CLAUDE.md: web page rules for the chamber touch screens (#125) (#126)
    Adds a Web pages section: large targets and wide gaps, no hover, drag
    or sliders, a control-free scroll gutter, finishing controls on screen
    at 1024x600, never color alone, the hidden attribute, minimal typing,
    and no restyling outside the redesign issues. Size numbers are starting
    points, not limits. style.css and base.html become shared files.
2026-10-12 UI shell: tokens, rail, work area, components, /ui page and page smoke test (#128) (#130)
    * reference: approved UI mockup 3, the spec for the UI shell (#128)
    The redesign mockup approved by Aaron on 2026-10-12: shell, Setup,
    calibration wizard, Validation and Experiments, with the on-page
    keypad, keyboard, dropdown and confirmation panels. Example data only.
    Standalone HTML; open it in a browser.
    * UI shell: tokens, rail, work area, components, /ui page and page smoke test (#128)
    Every page now opens inside the shell from the approved mockup: a section rail (a bottom bar
    under 700px wide), a work-area head, one scrolling area with a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
    [app.py]
2026-10-12 CLAUDE.md: allow large drag handles where moving is the task (#131)
    The squareness guides need dragging: nudge buttons did not do the job
    (Aaron, 2026-10-12). The rule now allows drag with large handles where
    moving something is the task itself, always with a keyboard
    alternative. Hover-only controls and range sliders stay out.
2026-10-12 reference: UI mockup 7, the spec for the page redesigns (#125) (#133)
    Replaces mockup 3. Adds what Aaron approved after the UI shell spec:
    - calibration wizard: Back, steps and Next in one bar at the top; an
    About this step button in the header
    - focus step on one screen: live view with Autofocus, Lock, Exposure
    and Gain under it; magnified view with Coarse, Fine and Peaking
    under it; exposure changes show at once
    - squareness step: large drag handles on the guides, keyboard
    alternative (1 2 3, W A S D or arrows, Shift)
    - calibration diagnostics page with four tabs
    - Validation round controls at the top; condensed experiment cards;
    dropdown list; physical keyboard alongside the on-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
2026-10-12 M3: calibration plots through images.py; tag map replaces the best/worst photo (#57) (#127)
    * M3: calibration plots through images.py; tag map replaces best/worst photo (#57)
    Applies the plot review decisions (#53):
    - Removed: scale-residual and area-shape heatmaps, table view, rank plot, best-and-worst
    tag photo, certainty dome, and the area-shape copy of the radial plot, with their
    drawing code, UncertaintyField and AreaScaleField.
    - Kept: the scale-residual radial plot, now an images.py recipe.
    - New: the tag map. The table straightened on the corner tags, each calibration tag
    filled by how far it reads from the run's median, tags past 1.5% outlined, with a
    histogram in the same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
    [app.py, calibration.py, calibration_store.py, calibration_viz.py, images.py, tags.py]
2026-10-12 CLAUDE.md: look a board card up before adding it (#137)
    The board now adds new issues on its own, and item-add on a card that
    is already there fails with "Content already exists" (seen on the
    calibration wizard issue, #136). The old text said it returns the id.
    Look the card up by its URL first and add it only when missing. The
    look-up was checked on an issue, a PR and a card not on the board.
2026-10-12 reference: mockup defers calibration plots to the built panel (#125) (#135)
    The calibration plots PR (#127) replaced the four diagnostics views
    and the table-size fields with one shared two-plot panel,
    _calibration_diagnostics.html, already built on the shell components
    and checked by Aaron. The mockup no longer designs diagnostics: step 5
    shows a note pointing to that panel, the old four-tab page is unlinked
    and says it is superseded, and the step 5 help text names Load the
    plots. Nothing else changes.
2026-10-13 Focus controls on the new shell: steppers, About page, Camera settings (#136) (#138)
    * Focus controls on the new shell: steppers, keypad, About page, Camera settings panel (#136)
    The live view with Autofocus, Lock focus, Exposure and Gain under it; the
    magnified view with Coarse, Fine and Peaking under it. Lock status and
    sharpness sit on the images. Shared: tight stepper, stepping through stops,
    setDisabled, toggle button, infoPanel, About page and button, shown on /ui.
    * Focus controls: fixes from Aaron's browser check
    Larger views (300px), readable lock label in the sharpness label's style,
    Auto exposure on its own row hiding Exp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
2026-10-13 Calibration wizard frame to main: steps bar, About pages, steps 1, 4, 5, 6 (#136) (#142)
    Auto exposure on its own row hiding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
2026-10-13 Squareness panel for Step 3 and Square mode: numbered handles, keys, readable corner rings (#136) (#143)
    * Squareness panel: one copy for Step 3 and Square mode, large handles, keyboard, ring legend (#136)
    _squareness.html and squareness-guides.js hold the live image, the three
    magenta lines, four large handles just outside the image, keyboard moves
    (1 2 3 pick a line, W A S D or arrows, Shift further), the Corner rings
    switch (off by default) and the ring legend in words and shapes. Wizard
    Step 3 and the Focus and Square page include it. The Focus page's mode
    switch sits in its head; Square mode shows only the squareness panel and
    Focus mode only the focus controls (#89). One copy of the A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
2026-10-13 update bom (#144)
2026-10-13 Server restart does not wait for open browser tabs (#139) (#145)
    * Server restart does not wait for open browser tabs (#139)
    Launch with --timeout-graceful-shutdown 5. The app's shutdown closes the camera
    only after any in-flight camera call ends, so a stream cut off mid frame grab is
    not read as a camera fault. Live view images ask again every 2 s after an error,
    so open tabs pick the server up again.
    * Live views restart after the server comes back (#139)
    Chrome fires no error event on an MJPEG image when the server drops the stream,
    so the error retry never ran. The focus score poll, and a small HEAD request in
    the squareness pan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
    [app.py]
2026-10-13 Metrology: p95 band against a normal (2 x RMS) estimate on 7 validation sessions (#146) (#147)
    * Metrology log 6.1: method for comparing the p95 band with 2 x RMS (#146)
    Written before any number was computed.
    * Metrology log 6.1: results of p95 band against 2 x RMS on 7 sessions (#146)
    * Metrology log 6.1 sources, measurement-trust: why a percentile band (#146)
    * Metrology log 6.1: per-session central distances corrected; trust case gives both directions (#146)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
2026-10-13 Calibration diagnostics page from mockup 7: Tag map and Lens check (#134, part 1) (#148)
    * Calibration diagnostics page from mockup 7: Tag map and Lens check tabs (#134)
    One page for a saved run (from the history) and the active calibration (Step 5's
    new Open diagnostics button), each plot with its numbers beside it, from a new
    /calibration/{stem|current}/diagnostics readout that uses the plots' own tags
    and fit. New shared components ui.tabs, ui.figure and ui.readout on /ui. The
    old plots panel and drill-down page are removed. The radial plot caption gives
    the slope in % per 1000 px, as the readout does (recipe version 2).
    * Diagnos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
2026-10-14 M2 acceptance on camera SN001: results (#116) (#152)
    * Metrology log: M2 acceptance first validation on SN001 (#116)
    * Metrology log: tape-measure procedure as run, written before the run (#116)
    * Metrology log: M2 tape-measure result on SN001, pass (#116)
    * Metrology log: M2 repeat validation on SN001, pass with a deviation (#116)
    * Metrology log: correct the restart list in 14.1 (#116)
    * Metrology log: ch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
2026-10-15 Round 1: green and red area on the Benchy benchmark stills (#154) (#155)
    * Round 1: red and green area on the Benchy benchmark stills (#154)
    Fixed thresholds (red in HSV, excess green), areas through the calibration
    scale field, one overlay per still, results.csv and NOTES.md for 92 stills.
    * NOTES: turn definition, base angle, threshold cause marked as likely (#154)
    * Round 1 benchy: overlays out of the repo, Aaron's visual check recorded (#154)
    ---------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
    [results.csv]
2026-10-15 Round 1: tray tag tests and Benchy results in the metrology log (#153) (#159)
    * Metrology log: CRISP-DM round 1 method, benchmark dimensions (#153)
    Method for round 1 written before the 15 October photo session: the
    Benchy Yellow-4 benchmark dimensions (calliper), the photo session
    steps, and what is measured.
    * Metrology log: round 1 step b at 180 degrees, step a as taken (#153)
    * Round 1: record of the 15 October photo session, steps 1 to 6 (#153)
    One row per still: step, title, experiment UUID, folder and still name.
    Step 6 slots follow the capture order (North 1 to 6, the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
    [run-2026-10-15-tags.csv, session-2026-10-15.csv]
2026-10-15 Round 1: real leaves of known area on the trays (#162) (#163)
    * Round 1: real leaves of known area on the trays (#162)
    Scan areas from flatbed scans scaled by their tags, rig areas from 32 stills
    with the round 1 green test, results in NOTES.md and metrology log 15.5b.
    * Round 1 leaves: scans kept in the repo and the rig data folder, scan times in a CSV (#162)
    * Round 1 leaves: each reading against its slot's validation band (#162)
    * Metrology log 15.5b: black sheet lift, method decisions, per slot results, identity che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
    [results.csv, scan_areas.csv, scan_times.csv]
2026-10-15 Unit tests in about 12 s: parallel on 4 cores, shorter camera waits, faster tag geometry (#169) (#170)
    * Faster unit tests: shorter camera time limits in tests, tag side and area in plain arithmetic (#169)
    * Bare pytest runs the unit tier on 4 cores; budget 15 s; a fresh camera manager per test (#169)
    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
    [tags.py]
2026-10-16 Round 1: tray splitting and tray ID, FastSAM on the Hailo-8, 98.7% of trays on 176 stills (#164) (#172)
    * Metrology log 15.5c: tray splitting and tray ID method, tray measurements (#164)
    Method and proposed decision rule written before the analysis: methods A to E,
    gap set (33 stills) then touching set (143 stills), tray size by tape measure
    and grid by callipers.
    * Round 1 trays: methods A and B on the 33 gap stills (#164)
    Tag-only nearest slot (A) is ambiguous: each tray on its own slot in 6 of 33
    stills. Blue threshold (B) passes 0 of 33: 84 of 396 trays are their own
    shape, since trays touch in places even in the gap set. Single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
    [diagnose-fastsam-small20.csv, fastsam-full176-masks.csv, fastsam-full176.csv, fastsam-masks.csv, fastsam-small20-grid-masks.csv, fastsam-small20-grid.csv, fastsam-small20-m1.15-fb-masks.csv, fastsam-small20-m1.15-fb.csv]
2026-10-16 Metrology log: label every result, add the ImageJ area check (#176, #179) (#180)
    * Metrology log: label every result, add the ImageJ area check (#176, #179)
    Each result now carries one label: validation, reference comparison or
    development check, with the key in section 12. Every label was proposed
    to Aaron and confirmed on 2026-10-16. Calliper and tape readings, decisions,
    method text and summary tables carry no label.
    New section 5.1 writes up Aaron's ImageJ area check of 2026-09-29 (old
    camera SN000) from the #179 handoff, with the sw1 perimeter correction.
    Section 13 gains its row.
    * Review fixes; measurement-trust: validation i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
2026-10-16 Split app.py into one route file per feature (#181) (#189)
    * Split app.py into one route file per feature (#181)
    app.py (1795 lines) held every route, so every page task edited it and
    tests/test_app.py. Each feature's routes now live in their own file under
    src/npec_rig/routes/: shell, focus, experiments, gallery, calibration and
    validation, plus shared.py for the page templates and the derived-image
    response. app.py keeps the data folders, startup and shutdown, the camera
    fault handler and the static mounts, and includes the six routers.
    A pure move. Every line comes unchanged from app.py except the imports, a
    docstring per file, and the templates path (one folder deeper). Each image
    reci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
2026-10-16 CLAUDE.md: pick issues from the current round on board 5 (#175) (#178)
    Board 5 has a Round iteration field (rounds 1 to 4). Agents work on the
    round Aaron names, else the current one; milestones group by feature.
    Adds the current-round gh command and the Round field and iteration ids.
2026-10-16 Metrology log 15.3e: 20 mm tray tags with finer bit sampling, timing and calibration check (#156) (#191)
    * Metrology log 15.3e: method for the tray tag detector check, before the analysis (#156)
    * Metrology log 15.3e: results of the tray tag detector check (#156)
    * Tray tags read with their own detector settings, calibration keeps the frozen pass (#156)
    * Corner raw data one line per still (#156)
    * Metrology log 15.3e: name the commit the script ran from (#156)
    C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
    [tag-detector-stills.csv]
2026-10-16 CLAUDE.md: one web area per route file (#181) (#193)
    * CLAUDE.md: one web area per route file (#181)
    After the app.py split (#189), page work no longer has to share one web
    area. The area map now gives each route file its own area with its pages
    and scripts: web (shell, shared, menu, /ui and the shared components),
    web-focus, web-gallery, web-experiments, web-calibration and
    web-validation. The focus and squareness panels belong to web-focus,
    including where the Calibration page uses them.
    Also points the calibration history plan at routes/calibration.py.
    * Review: shared scripts in web, full paths, overlaps written down (#181)
    squ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
2026-10-16 Tray tags read with their own detector settings; 20 mm edge tag check in the log (#192) (#195)
    * Tray tags read with their own detector settings; older stored tags kept when the photo is gone (#192)
    Two detector passes: the frozen settings for calibration and corner tags, finer bit
    sampling (metrology log 15.3e) for tray tags 0 to 299. TAG_DETECTOR_VERSION 2, and
    stored tags of an older version are used when the photograph is no longer in the
    photos folder (776 of 804 stored searches on 2026-10-16).
    * Metrology log: 20 mm edge tags against their 30 mm partner, and the detector change done (#192)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
    [edge-tags.csv]
2026-10-16 Validation rules in their own module; one rule for which validation applies (#182, #183) (#198)
    * Photo tag lookup and saved calibrations out of the route files (#182, part 1)
    routes/validation.py imported five private helpers from
    routes/calibration.py, so each had two bindings and a test patch could
    miss silently. They now have one home each, outside the route files:
    - photo_tags.py: a capture's path, tags and reduced preview, and a
    calibration photo's tags. Every tag search web code starts goes through
    photo_tags.detect_tags, so tests replace the detector in one place.
    - calibration_store.py: saved_calibration_path and load_saved_calibration.
    They raise their own errors instead of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
    [app.py, calibration.py, calibration_store.py, captures.py, database.py, photo_tags.py]
2026-10-16 Calibration run rules in their own module (#182) (#202)
    * Calibration run rules in their own module (#182)
    The readiness gate, the run, and the comparison with the previous
    calibration move from routes/calibration.py into calibration_run.py.
    The two routes now only call it. Responses are unchanged: a refused
    run or a failed fit still answers 200 with an `error` field.
    Tests patch calibration_run.readiness, the one binding run() calls.
    New unit tests cover the gate's answer and the comparison.
    * Review fixes: run() arguments by name; drop stale CLAUDE.md overlap note
    routes/validation.py no longer imports from routes/calibration.py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
    [calibration.py, calibration_run.py]
2026-10-16 Tray tags: 20 mm 4x5 tags in 26 mm depth; 4x4, 1x1 and black_tray designs from version 2 (#209)
    * Tray tags: 20 mm tag size, RV1.15; re-export 4x5 ids 1-75
    * Tray tags: black_tray disc style (ids 226-250), 26 mm plate depth, RV1.17
    Disc style from tray_tags_alternative; OTHER is now 251-299. Plate depth
    set by plate_depth (26 mm, tray side clearance 27.39 mm), labels moved to
    the side borders. Re-export 4x5 1-75 and black_tray 226-250.
    * Tray tags: lip (4x4), lip_bolt (1x1) and 30 mm disc from version 2, RV1.18
    Each style has its own tag size. Re-export ids 1-250; old 4x4 and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
    [apriltag_tray_tag.scad, apriltag_tray_tag_1x1_151-162_bolt.3mf, apriltag_tray_tag_1x1_151-162_lip_bolt.3mf, apriltag_tray_tag_1x1_163-174_bolt.3mf, apriltag_tray_tag_1x1_163-174_lip_bolt.3mf, apriltag_tray_tag_1x1_175-186_bolt.3mf, apriltag_tray_tag_1x1_175-186_lip_bolt.3mf, apriltag_tray_tag_1x1_187-198_bolt.3mf]
2026-10-16 Round 1 record brought up to date; experiments kept out of the app (#158) (#211)
    * Metrology log 15: status lines after the session, still counts, taken steps beside the plan (#158)
    * Metrology log 15.1: reading count of the Benchy calliper figures (#158)
    * experiments/ in the area map; guards keep it out of the app and of release archives (#158)
    * Metrology log 15.3a: calibration, validation and lens of every tag still (#158)
    * experiments/round1: scripts find sr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
2026-10-16 Round 1: tray tracking on the 15 October stills, 2078 measured + 31 patched of 2112 trays (#171) (#212)
    * Tray tracking, first slice: raw positions, patches 1 and 2, moves against the tags (#171)
    track.py follows each tray through the 176 stills of 15 October in time order from the saved
    FastSAM results and the tag cache. Method amendments, written before the run, and results in
    metrology-log 15.5d. Patch 3 is not in this slice.
    * Tray tracking: off positions at the local scale, patch 2 cross-check, 15.5c pointer (#171)
    * Tray tracking: patch 3 (filled from neighbours), eviden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
    [track-full176-moves.csv, track-full176-stills.csv, track-full176.csv]
2026-10-19 Pots session 19 October: method and checklist (#213) (#219)
    * Metrology log 15.5f: method for the pots session on 19 October (#213)
    Pot cells proposed (A2, A4, B1, B5, C4, D1, D3, D5), new 20 mm tags IDs 40 to 51,
    steps and known moves, the mask area and fill risk from pots declared before the
    session, and the limits. NOTES.md points to it and lists the code still to do.
    * 15.5f: all tags on the edge, IDs 13 to 24, pot cells confirmed (#213)
    * trays.md: 4 x 5 tags outside the tray, never in a cell; others inside (#213)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
2026-10-19 Pots session 19 October: results 15.5f to 15.5i, tray placement from the cell tag (#213) (#225)
    Session record and stills record; both FastSAM runs, tracking and the trace (15.5f); footprint
    from the tag (15.5g); cell A1 tags against edge tags (15.5h); shuffling proof of concept with
    shuffle.py (15.5i). track.py evidence pictures per run. Rebuilt on main after #219 was merged.
    [diagnose-fastsam-pots19.csv, fastsam-cell19-masks.csv, fastsam-cell19.csv, fastsam-pots19-holes-masks.csv, fastsam-pots19-holes.csv, fastsam-pots19-masks.csv, fastsam-pots19.csv, footprint-cell19-common.csv]
2026-10-19 Scheduled capture: a photo every interval while an experiment runs (#60) (#227)
    * Scheduled capture: a photo every interval while an experiment runs (#60)
    Interval stored per experiment period in seconds; photo slots counted from the
    period start in UTC, so any interval works and a restart resumes. Every slot is
    recorded taken or missed in scheduled_photo. Experiments page: minutes stepper
    (0 to 6) on Start and Resume, schedule line in the running banner.
    * Scheduler: stop check before each photo, minimum interval, steadier slow-photo test (#60)
    * Scheduled photos: interval se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
    [app.py, captures.py, database.py, scheduler.py]
2026-10-19 Round 1 review: trays, tags and tracking, Limits of the evidence, Round 2 plan (#217) (#231)
    * Metrology log 15.6b: round 1 review, trays, tags and tracking (#217)
    * Metrology log 15.5j: method, trays placed from the cell tag in any rotation (#217)
    * Metrology log 15.5j: trays placed from the cell tag in any rotation, 215 of 216 on the 15.5i stills (#217)
    * Metrology log 15.5j results and 15.6b updated (#217)
    * Metrology log 15.5k: method, tags in four rotations (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
    [shuffle-2026-10-19_ad4876e5-any.csv, shuffle-2026-10-19_ad4876e5-rotations.csv]
2026-10-19 Gallery: show one experiment's photos (#230) (#234)
    * Gallery: show one experiment's photos, from the gallery or the Experiments page (#230)
    * Experiments: action buttons in three lines, Photos in the middle (#230)
    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
2026-10-21 Shuffles 20 October: trays placed from 40 mm cell tags, results in 15.5l (#236) (#240)
    * 15.5l: decisions of 20 October before the shuffles (#236)
    * 15.5l: 40 mm offset learned from layout 1 (#236)
    * 15.5l: wording (#236)
    * 15.5l: shuffle times 1 to 14 from Aaron (#236)
    * 15.5l: calliper reading of the 40 mm tags, shuffle record (#236)
    * 15.5l: settled rule and layout boundaries as run (#236)
    Co-Authored-B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
    [fastsam-oct20-learn-masks.csv, fastsam-oct20-learn.csv, overnight-2026-10-20_57f74959.csv, session-2026-10-20.csv, shuffle-day-2026-10-20_57f74959.csv, shuffle-times-2026-10-20.csv, track-oct20-learn-moves.csv, track-oct20-learn-stills.csv]
2026-10-21 Gallery: Show tags, every tag in a photo marked with its ID (#194) (#238)
    * Gallery: Show tags, every tag in a photo marked with its ID (#194)
    Each gallery photo gets a Show tags button. It lists the tags found in the
    full-size photo by role (tray, calibration, corner) and opens the photo full
    screen with every tag outlined and labelled. The search runs once per photo
    and is stored by images.py; rig photos share their search with the
    calibration and validation pages. Slice 1 of #194: no tray outlines, nothing
    stored about trays.
    * Gallery Show tags: review fixes (#194)
    The marked image's key holds the tags it draws, so it is drawn a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
2026-10-21 Tray tags: version 2's 4x5 design (lip_round) as the 4x5 default, RV1.19 (#243)
    Each style has its own tag size. Re-export ids 1-250; old 4x4 and 1x1
    bolt export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
    [apriltag_tray_tag.scad, apriltag_tray_tag_4x5_1-12_lip_round.3mf, apriltag_tray_tag_4x5_1-12_tab.3mf, apriltag_tray_tag_4x5_13-24_lip_round.3mf, apriltag_tray_tag_4x5_13-24_tab.3mf, apriltag_tray_tag_4x5_25-36_lip_round.3mf, apriltag_tray_tag_4x5_25-36_tab.3mf, apriltag_tray_tag_4x5_37-48_lip_round.3mf]
2026-10-21 Tray placement: trays placed from the cell A1 tag, drawn in the gallery (#220, #194) (#247)
    * Tray placement: trays placed from the cell A1 tag, drawn in the gallery (#220, #194)
    New module tray_placement.py places each tray tag in a slot of the photo's
    calibration slot layout, with its A1 corner, tilt and outline, by the method of
    metrology log 15.5h to 15.5l and the 40 mm offset learned on 20 October.
    Statuses: placed, close call (candidates within 50 mm, a decision), two trays
    in one slot. Tested against the real tags of four 20 October stills and the
    layouts Aaron recorded.
    The gallery's tag lookup for any photo moves from routes/gallery.py into
    photo_tags.photo_tags_for, so placement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
2026-10-21 Tests: no thread left from a test reaches the live rig.db, derived folder or camera (#253) (#254)
    conftest set NPEC_RIG_DB_PATH, NPEC_RIG_DERIVED_DIR and NPEC_RIG_SYNTHETIC_CAMERA per test only;
    monkeypatch removes them when the test ends, so an app thread stopped without waiting (scheduler,
    tray reader) fell back to /var/lib/npec-rig and the real camera. On 2026-10-21 one migrated the
    live rig.db to version 7 (reverted). They are now set for the whole run at module load, like the
    photo folders; a hardware test removes the synthetic camera for itself only.
2026-10-22 Tray readings per photo: tray, slot, tag found, read in the background (#222) (#256)
    * Tray readings per photo: tray, slot, tag found, read in the background (#222)
    Every photo taken as a capture is read for its trays after it is saved, by a background thread
    (tray_readings.TrayReader), and saved in two new tables (migration 7): tray_read, one row per photo
    read with its status, and tray_reading, one row per tray found. A tray not found is worked out when
    shown: found earlier in the experiment, missing since a time, for how many photos. Photos with no
    tag at all (lights off, metrology log 15.5l) are not counted as trays missing. The gallery shows
    each photo's trays found, not found and move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
    [app.py, database.py, tray_readings.py]
2026-10-22 Hardware README: tray tag printing step by step, part pictures and print settings (#246) (#260)
    * Hardware README: step-by-step tray tag printing and print settings (#246)
    Instructions a newcomer or a new agent can follow to print a complete,
    checked set of tray tags: OpenSCAD nightly and other tools, ready-made
    exports, Orca, filament colours, and checks on every printed tag.
    Pictures of every tag style and the 4x5 build plate in
    hardware/images/tray_tags/. A print settings table gives infill,
    supports and L bracket orientation. reference/trays.md records where
    the tag sits on each tray type.
    * Hardware README: tray tags need no sup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
2026-10-22 Round 2 run: method for the potato experiment, printable shuffle maps (#221) (#261)
    * Round 2 multi-day run: method draft, parts A and B (#221)
    * Round 2 run: printable shuffle maps and their known answer, plants weighted to the middle slots (#221)
    * Round 2 shuffle maps: drawn for a black and white printer; benchmark on tray 8 (#221)
    Same seed and layouts; the known answer gains the benchmark's tray.
    * Round 2 run method: the potato experiment, still scene on the pot trays, shuffles from printed maps (#221)
    Replaces t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
2026-10-22 Metrology log: cause of the capture record with no image (#241) (#262)
    A leaked test thread wrote it into the live rig.db (#253, fixed by #254).
    Six such records are bogus and left in place, to be ignored.
2026-10-22 Experiments: New experiment form closed behind a button while an experiment runs (#267) (#269)
2026-10-22 Gallery Show tags: calibration tags as a count and ID range (#258) (#270)
    * Gallery Show tags: calibration tags as a count and ID range (#258)
    * Gallery Show tags: one line of trays found on the card, the rest under Tag details (#258)
    * Gallery: Tags and Info side by side on each card (#258)
    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
2026-10-23 Round 2 run analysis: steadiness, tag detection and tray tracking from the rig's own readings, checked on 20 October (#223) (#265)
    * Round 2 run analysis: undisturbed pairs, steadiness, detection, tracking; check on 20 October (#223)
    * Metrology log 16.7: say what the early check covered (#223)
    * Metrology log 16.8: tray tags missed with nothing in the way (#223)
    * Metrology log 16.8: state only what was printed (#223)
    * Metrology log 16.8: why the missed tray tag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
    [chamber-times-2026-10-22.csv, events-2026-10-22.csv, shuffles-2026-10-22.csv]
2026-10-23 Pi 5 + AI HAT case: bolted board, screwed lid, T-slot mount, print-ready (#276)
    * Hardware: Pi 5 ghost from the official STEP, fit check against the raspberry.tips tub
    fetch_pi5_model.py downloads the official Pi 5 STEP and writes an STL mesh
    plus box sets (all 2678 parts, and a 136-box simple set) into
    reference/pi5_step/, which is gitignored: the model belongs to Raspberry Pi
    Ltd. libraries/pi5_ghost.scad places them in the case frame (board corner
    at the origin, PCB top at z = 0, USB-C on y = 0). pi5_case_fit_check.scad
    shows the board in the raspberry.tips v2.0 tub (CC BY 4.0) and draws the
    overlaps in red. The simple board previews in about 0.3 s.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
    [pi5_case.scad, pi5_case_calibration.stl, pi5_case_fit_check.scad, pi5_case_lid.stl, pi5_case_tub.stl, pi5_case_tub_and_lid.stl, rpi5_case.scad]
2026-10-23 Validation: name an off-slot sheet by slot, distance and tray, not pixel position (#257) (#278)
    * Validation: name an off-slot sheet by its nearest slot and distance in mm (#257)
    * Validation: an off-slot sheet names the nearest tray when tray tags are in the photo (#257)
    * Validation: two sheets on one slot are named by their tag ranges (#257)
    * Review: place trays only when a sheet is off its slot, group sheets once per round (#257)
    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
2026-10-23 Segmentation: green threshold behind a Segmenter interface, Green button in the gallery (#74) (#280)
    * Segmentation: Segmenter interface, green threshold, Hailo stub, Green overlay in the gallery (#74)
    * Gallery: 24 px gap above Green (#74)
    * Review of #280: CLAUDE.md segmentation fact, one photo check for both gallery image routes, 422 test
    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
2026-10-23 Tray readings: plant area per tray from the full-size mask, segmenter recorded, areas in gallery Info (#75) (#281)
    * Tray readings: plant area per tray from the full-size mask, segmenter recorded, masks saved; areas in gallery Info (#75)
    * Gallery Info: plant areas as a table, tray, slot and area (#75)
    * Review of #281: unique temporary mask name, purge removes the experiment's masks, one photo copy
    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
2026-10-23 Test bench: a replay camera that takes saved photos as new stills (#279) (#284)
    * Camera: a replay camera takes saved photos as new stills, in name order (#279)
    * Camera: the replay camera's live view shows the photo the next still will be (#279)
    * Camera: a replay camera with no photos, or set with the synthetic camera, is unavailable (#279)
    * Deploy: systemd drop-in that sets the test bench Pi to replay saved photos (#279)
    * Review: replay skips hidden files, re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
    [camera.py, captures.py, validation.py]
2026-10-23 Deploy: the service restarts after any exit, so an experiment survives a reboot (#62, slice 1) (#285)
    * Deploy: service restarts after any exit and never gives up; install steps (#62)
    * Review: stop timeout covers the camera wait; install checks, cold start and branch tries in the README (#62)
    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
2026-10-25 Reprocess areas per experiment, raw pixel count and centre stored with each area, metrology log 17 (#75) (#287)
    * Reprocess: plant pixel count, centre and calibration stored with each area; Reprocess areas per experiment from saved masks and stored tags (#75)
    * Metrology log 17: plant area per tray on the potato run, observations so far and the review method (#75)
    * Metrology log 16.5, 17.2: benchmark put on tray 8 at 09:33 UTC on 22 October, review starts 09:34:53
    * Round 2 area review script (metrology log 17.2)
    Co-Au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
2026-10-26 Metrology log 18: tag edges read short against spacing, areas 1.1 to 4.1% high by slot; the green target reads 6.1% high (#286, step 1) (#290)
    * Metrology log 18: method for tag edges against tag spacing in the stored photos (#286)
    * Metrology log 18: tag edges against spacing in the stored photos, the green target over two days; measurement-trust note (#286, step 1)
    * Metrology log 18: final table and chart from the clean run (1,467 sheets in 119 photos)
    * Metrology log 18: area error per slot from the fitted scale fiel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
    [sheets-2026-10-25.csv, sheets-2026-10-26.csv, sheets.csv]
2026-10-26 Calibration squares: flat green targets of known area (#291) (#292)
    * Calibration squares: green flat squares of known size on one plate
    Four 10x10, four 20x20, two 40x40 and two 55x55 mm, 0.568 mm thick.
    Print in green filament.
    * Export calibration squares plate STL
    * Calibration squares: preview render, export path and measurement note in the docs
    render_images.sh now covers calibration_targets/. The hardware README table
    shows the render, the folder README names the STL in exports/ and says to
    write calliper readings up in docs/metrology-log.md, and hardware/CLAUDE.md
    lis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
    [calibration_squares.scad, calibration_squares.stl]
2026-10-26 Tray areas: lights-off photos marked, areas under the floor read "under 100" (#288, part 1) (#295)
    * Tray areas: dark photos marked from exposure and gain, the floor with each area (#288, part 1)
    A photo whose exposure times gain is at least 200,000 is marked "dark, no
    data" in its tray readings and the gallery; each tray's area carries the
    segmenter's floor, 100 mm2 for the green threshold. Both worked out when
    shown, so older photos are covered. Both values are decisions, checked in
    #293; metrology log 17.7.
    * Gallery Info: short text for lights-off photos, under 100 for areas at or below the floor (#288)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
    [tray_readings.py]
2026-10-26 Gallery Info: warning that plant areas read high, until #286 is closed (#289)
    * Gallery Info: warning that plant areas read high until #286 is closed (#286, step 2)
    A flat green square of 150 mm reads 6% high (metrology log 17.6); small plants may read
    higher. Shown as a banner above the plant area table.
    * Gallery warning: no direction claimed for small plants (edge error not measured on plants; red shapes read small, metrology log 15.5)
    * Gallery warning: the scale reads 1 to 5% high, the mask edge is not measured for plants, green test squares -27% to +41% at 10 mm (#286; w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
2026-10-26 Calibration and validation: the scale from tag spacing, with rebuilt twins for older calibrations (#286, step 4) (#294)
    * Calibration and validation take the scale from tag spacing, not tag edges (#286)
    Tag edges read 1 to 2.5% short of tag spacing (metrology log 18), so the
    scale came out low and areas read 1 to 5% high, and validation, checking
    the same edges, could not see it. The scale field is now fitted to pairs
    of tags of one tag sheet 30 to 90 mm apart as printed (the print layout
    files), each partner found where the layout puts it as seen from both
    tags, so copies of one page are not paired across. Validation scores
    each tag by its spacing scale against the calibration's. The cover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
    [squares-darklayer.csv, squares-open.csv, squares-paper.csv]
2026-10-27 Metrology log 18.7 to 18.9: the green mask edge on test squares, and the gallery warning after the scale fix (#286) (#298)
    * Metrology log 18.7: the squares split into scale and mask edge; the scale part agrees with validation, the mask edge is 6 to 30 times larger and follows the slot (#286)
    * Metrology log 18.7: the brightness comparison as measured, square by square (#286)
    * Metrology log 18.8: four published green thresholds on the squares; none removes the edge strip of about 0.6 to 1.0 mm, and areas below 10 mm squares are not measured (#286)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
    [edges.csv, methods.csv, squares-paper-long.csv]
2026-10-27 Light exclusions, stored and shown in Info: light changing, briefly changed, off its usual level (#288, part 2 PR 1) (#299)
    * Glossary: exclusion, the stored reason a photo's plant areas are left out (#288)
    * Metrology log 17.8: method for the light exclusions, before the data is read (#288)
    * Metrology log 17.8: results and the light exclusion decisions, review script and per-photo data (#288, #296)
    * Light exclusions, stored: norm and limit from the first day, light changing, briefly changed, off its usual level (#288,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
    [light-e16.csv, light-e18.csv]
2026-10-27 Visits: chamber activity marks the photo, a tray's area more than 250 mm2 and 2 times off its usual level; "not counted" for every exclusion (#288, part 2 PR 3) (#301)
    * Metrology log 17.9: method for visits, before the data is read (#288)
    * Metrology log 17.9: visits results and decisions, review script and per-photo data (#288)
    * Visits: a tray's area more than 250 mm2 and 2 times off its usual level marks the photo; chamber activity on the page, "not counted" for every exclusion (#288, part 2 PR 3)
    * Visits: only phot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
    [visits-e18.csv]
2026-10-27 Sheet-flat instructions on the validation and calibration pages and in the operator guide; the door tick also confirms the sheets are pressed flat (#149) (#305)
2026-10-27 Validation page: a round that is not counted shows a heading line, one sentence per reason, and a full-size Count it anyway button (#151, item 1) (#306)
2026-10-27 CLAUDE.md: issues not needed for the thesis get the Future development label, no Round (#309) (#310)
    Rounds hold only work that can cause harm, blocks the current round, or is
    needed for the thesis requirements. Every other issue gets the label
    Future development and no Round, and is not closed for that reason
    (Aaron, 2026-10-27, triage of Rounds 2 to 4).
2026-10-27 Touching trays: plant in the strip two tray outlines share counts once, for the nearer tray (#282, item 2) (#311)
    * Touching trays: plant in the strip two tray outlines share counts once, for the nearer tray (#282, item 2)
    segmentation.measure_trays measures all trays of a photo together. Where
    outlines overlap, a plant pixel counts only for the tray whose centre is
    nearer its pixel centre (Aaron, 2026-10-23); a pixel inside one outline
    only stays with that tray. tray_readings uses it, and no longer loads the
    photo's capture row a second time (#282, minor item).
    * Touching trays: a pixel midway counts once, work only where boxes over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
    [segmentation.py, tray_readings.py]
2026-10-27 Tray areas: "partly outside the photo" when a tray reaches more than 13 mm past the edge (#282, item 1) (#312)
    * Tray areas: "partly outside the photo" when a tray reaches more than 13 mm past the edge (#282, item 1)
    Each tray's reading stores how far its outline reaches past the photo edge,
    at its farthest corner, in mm (tray_reading.outside_mm, rig.db version 12).
    The gallery Info table says "partly outside the photo" beside the area when
    it is more than 13 mm, the widest measured outer wall (a decision, Aaron,
    2026-10-27). Metrology log 17.11 has the real-photo figures behind it.
    * Photo edge: worked out from the photo's own size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
2026-10-27 Validation page: discard a counted round with a reason, and in-page panels instead of browser pop-ups (#151) (#313)
    * Validation: discard a counted round with a reason from a fixed list; Count it anyway brings it back (#151, item 3)
    * Validation page: in-page panels in place of the browser's confirm() and alert() pop-ups (#151)
    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
    [validation.py]
2026-10-28 Two trays carrying the same tag each keep their own area, neither counted (#302) (#314)
    * Tray tags: two trays carrying the same tag each keep their own area, neither counted (#302)
    rig.db version 13 drops the one-row-per-tag rule on tray_reading, which made such a photo fail
    to save as read failed. Plant measures are kept per placed tray, not per tag. capture_readings
    marks both trays not_counted, "2 trays carry tag <n>"; the chamber activity check and the
    moved list leave the tag out. The gallery says so under the thumbnail and in Info.
    * Review of #314: Tags picture keeps both trays of a shared tag, migration copy names its column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
    [database.py, tray_readings.py]
2026-10-28 Two trays in one slot, both not counted with the reason (#315) (#316)
    * Tray areas: two trays in one slot, both not counted with the reason (#315)
    A loose tag on a tray gives a second outline over it, which takes part of the real tray's plant
    (metrology log 17.12). not_counted is now a list of reasons per tray: "N trays carry tag T"
    (#302) and "N trays in <slot>". experiment_tray_areas leaves both out of the chamber activity
    check. The gallery shows each reason once.
    * Review of #316: a photo with two trays in one slot is chamber activity, whole photo not counted
    Decision (Aaron, 2026-10-28): two outlines in one slot mean a tray car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
    [database.py, exclusions.py, tray_readings.py]
2026-10-28 Benchmark rosettes against a phone scan scaled by callipers (#228, metrology log 17.13) (#317)
    * Metrology log 17.13: method of the benchmark rosettes against a phone scan (#228)
    Written before the analysis.
    * Benchmark rosettes against a phone scan scaled by callipers: result (#228, metrology log 17.13)
    * Review of #317: merged pair found from the beads, checks on corners, beads and the square, raw packages kept, rig query filtered as the app counts; bead-height scale chosen as reference
    * Metrology log 17.13: what the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
    [results.csv, traits.csv]
2026-10-28 Gallery: a yellow row when a tray found earlier is not in its slot (#318) (#319)
    * Gallery: a yellow row when a tray found earlier is not in its slot (#318)
    database.tray_readings gives each not-found tray the slot it was last
    found in; the gallery's area table shows it as a yellow 'Empty' row with
    the warning icon, and the card says how many slots are empty.
    * Gallery empty slot: review fixes (#318)
    The card line rebuilt after Tags is set as HTML, not text. 'Empty' only
    when no tray found in the photo sits in that slot; otherwise 'Not found'.
    The card counts empty slots and trays not found apart, and also warns on
    photos with an ex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
    [database.py]
2026-10-29 CLAUDE.md: three devices, sessions run from the controller testpi-02 (#324) (#325)
    Agent sessions, worktrees, unit tests and ~/ansible-npec are on the
    controller testpi-02. The hardware label now locks the development rig
    npec-rig-01; no task uses the production camera or server, which is
    restarted only on a promotion Aaron approved.
2026-10-29 Segmentation methods on the potato plants, compared (#297, metrology log 19) (#330)
    * FastSAM and CLIP prompt experiments on plant stills; supervisor's Benchy areas (#297)
    experiments/round3-segmentation/fastsam_plants.py: FastSAM (Hailo-10H build, InferModel API) on
    whole stills against the green threshold, rows between the corner tags, green pieces joined by
    distance, trays placed with tray_placement.place_trays from copies of the rig's calibration.
    experiments/round3-segmentation/clip_prompts.py: each FastSAM object scored by CLIP ViT-B/32 on
    the Hailo-10H against "foliage", "leaves", "plants" and background words.
    docs/metrology-log.md 17.14: the supervisor's iPhonoType areas of the f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
    [per_slot.csv, per_tray.csv]
2026-11-02 Trays found from the photo, named by the tag inside them (#331) (#334)
    * Trays named by the tag inside their photo outline (#331)
    name_trays: a tray tag names the outline its centre lies inside, wherever
    it lies in the tray; no tag, two tags and partly outside the photo are
    warnings; a tag in no outline is placed from the tag as before.
    * rig.db version 14: trays found in the photo, with or without a tag (#331)
    tray_reading keeps how each tray was found, its warnings and its outline;
    tray ID, slot, A1 corner and margin may be unknown. A tray with no tag is
    never a tray not found or a tray moved, and never hides one.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
2026-11-02 Round 2: the shuffle plan against the rig's tray readings (#332, metrology log 22) (#335)
    * Round 2: the shuffle plan against the rig's tray readings, the collaborator's shuffle record, metrology log 22 (#332)
    The collaborator's shuffle record (shuffles 0 to 6), experiments/round2-run/movements.py, metrology
    log section 22 with its figures, one line in measurement-trust.md, and the glossary's Area and
    Table location. Split out of 332-tray-dwell (Aaron, 2026-11-02).
    * Round 2 check: review of #335 (shuffle 0 has no window, the trust line names what was read, column rule and photo counts in the limits, readings with no tag left out) (#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
    [shuffle-record-2026-10-22.csv]
2026-11-02 Time per table location, too long warning, hide trays (#332) (#336)
    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
    [database.py, dwell.py, exclusions.py, exports.py]
2026-11-02 Tray type for tag IDs 76 to 150 is 2x2 (4 plants), not 4x4 (#327) (#340)
    The trays called "4x4" have 2 x 2 cells and hold 4 plants (Aaron,
    2026-10-29). Renamed where the name means this tray: the Experiments
    page tray list, PLAN.md, CLAUDE.md, reference/trays.md (cells 16 -> 4),
    the UI mockup, round 1 tray notes and the round 3 segmentation
    comparison (expected plants 16 -> 4). The metrology log keeps the old
    name with dated correction notes. The OpenSCAD tag designs, tray_tags.py
    and the hardware READMEs are left for a separate issue, done on a device
    with OpenSCAD. No rig.db stores the label (checked read-only on both rigs).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
    [captures.py]
2026-11-02 Tray tag CAD: rename the 4x4 type to 2x2 and rebuild IDs 76 to 150 (#339) (#342)
    The trays for IDs 76-150 have 2 x 2 cells, 4 plants (#327). The engraved
    type label, tray_tags.py's TRAY_TYPES and DEFAULT_STYLE, the version 2
    design file (sq22, t22_*), both READMEs and the export folder now say
    2x2. Tray tag RV1.20, version 2 RV2.2. Tag IDs and geometry unchanged.
    The 2x2 exports are rebuilt and the lip style picture redone with the
    new label.
    [apriltag_tray_tag.scad, apriltag_tray_tag_2x2_100-111_lip.3mf, apriltag_tray_tag_2x2_112-123_lip.3mf, apriltag_tray_tag_2x2_124-135_lip.3mf, apriltag_tray_tag_2x2_136-147_lip.3mf, apriltag_tray_tag_2x2_148-150_lip.3mf, apriltag_tray_tag_2x2_76-87_lip.3mf, apriltag_tray_tag_2x2_88-99_lip.3mf]
2026-11-02 Reboots: missed photos by reason, downtime, network-time wait, photos marked when the clock is not set (#62 slice 2) (#344)
    * Scheduler: a missed slot says whether the app was down or a photo ran long (#62)
    Tests wait for each test's scheduler thread, which could carry a slow photo
    into the next test's database.
    * Scheduler: missed photos by reason, downtime and late photos; wait for network time (#62)
    The schedule in GET /api/experiments now reports:
    - missed_by_reason: app_down, photo_slow, photo_failed
    - downtime: each app start during the schedule, from the last photo taken before it
    - late_photos: photos due while the app was d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
    [captures.py, database.py, scheduler.py]
2026-11-02 Camera health: open a camera never opened, say when none is attached (#252) (#345)
    * Camera health: open a camera never opened, say when none is attached (#252)
    /camera/health answered "ok" before anything had opened the camera. Now it
    starts opening it in the background and answers "opening"; then "ok" with
    "Camera attached and working", "no_camera" when the camera software lists
    no camera, or "failed_to_reopen" for an attached camera that will not open.
    The status line shows the opening and no-camera states.
    * Status line: short words for no camera and opening; they sit in the side menu (#252)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
    [app.py, camera.py, camera_process.py, health.py]
2026-11-03 Hardware: Pi 5 case REV 16 (RV1.0): one port window, joined Ethernet/USB opening, deeper lid screw holes (#350)
    - Lid screw holes in the tub lugs 3.5 mm deeper: 7.5 mm below the nut
    pocket (lid_screw_past). M3 screws up to 16.9 mm now fit.
    - x = 85 wall: wall post between the Ethernet and USB-A openings removed,
    one opening (right_joined).
    - y = 0 wall: one window around USB-C and both micro-HDMI (front_window),
    z 3 to 13 mm (flush with the floor's top face, 10 mm tall), 3 mm past
    the USB-C body and the HDMI 1 body. Replaces the three openings and the
    recess. Labels keep vent_keep from it.
    - Default part is preview (tub and lid). Revision stamp RV1.0.
    - STLs regenerated: tub, tub_a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
    [pi5_case.scad, pi5_case_calibration.stl, pi5_case_tub.stl, pi5_case_tub_and_lid.stl]
2026-11-04 App memory: fits a 4 GB Pi 5, peak 4.55 GiB to 1.30 GiB, same results (#348) (#353)
    * App memory: allocator limits, strip grayscale, one full-size decode at a time (#348)
    - glibc malloc: 2 pools, fixed 1 MB mmap threshold, trim after each photo and each tray reading
    - detect_tags: grayscale worked out in 256-row strips, same values, no 1.5 GB float64 temporaries
    - decode_full closes the Pillow image before the work; segmentation shares the one-at-a-time slot
    - array_to_jpeg: no redundant convert("RGB") copy
    * Tag search: OpenCV on one thread, peak 3.0 GB to 1.2 GB for one photo, same tags (#348)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
    [app.py, camera.py, images.py, scheduler.py, tags.py, tray_readings.py]
2026-11-05 Randomize page: suggest a random tray layout and check the trays against it (#343) (#356)
    * Randomize page: suggest a random tray layout and check the trays against it (#343)
    A new page in the side bar. Suggest layout reads where each tray lies in the newest photo and
    draws a slot and heading (A1 at SW or NE) per tray by restricted randomization: no row or column
    of plants is on an outside edge of the table two rounds in a row. Check layout takes a new photo
    (purpose "layout check", a rig photo, never an experiment still), places each tray from its tag
    and compares it with the suggestion; the overlay shows an arrow to the right slot and a turning
    arrow where the heading is wrong. Suggestion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
    [app.py, captures.py, database.py, randomization.py]
2026-11-05 JPEG quality against tags and plant areas: metrology log 26 (#355) (#361)
    * JPEG quality against tags and plant areas on the development rig (#355, metrology log 26)
    * Side-by-side JPEG samples per tray (#355, metrology log 26)
    * Samples: centre each window on the largest plant (#355)
    * Measurement trust: how photos are saved, from metrology log 26.1 (#355)
    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
2026-11-05 Photo quality setting: JPEG quality and colour through the API, default 85 with full colour, recorded per photo (#359) (#362)
    * Photo quality setting: JPEG quality and colour resolution through the API, recorded per photo (#359)
    GET and POST /api/photo-quality; saved in camera_settings (PhotoQuality), every change in
    photo_quality_change, each photo's quality and colour in capture (migration 20) and its JSON
    record. Default 75 with 4:2:0, Pillow's defaults, so nothing changes until it is set.
    * Photo quality: default 85 with full colour (#359, Aaron 2026-11-05)
    * Photo quality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
2026-11-05 Plant area: hand outlines against colour rules (metrology log 24 to 24.8), Gallery warning says areas read low (#352) (#365)
    * Metrology log 24: hand outlines of the potato plants against the green threshold, method (#352)
    Written before pass 2 and before any rule is compared. Pass 1 was done
    the same morning; the entry says so.
    * Metrology log 24.1: one fixed cutoff on six days, method (#352)
    * Metrology log 24.2: leaf edges kept where they join a leaf core, method (#352)
    * Metrology log 24.3: grow from cores as a time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
    [24-iou_per_plant.csv, 24-per_plant.csv, 24.1-per_tray_day.csv, 24.2-crops_per_plant.csv, 24.2-per_tray_day.csv, 24.2-seq-1102_tray3.csv, 24.3-part0.csv, 24.3-part1.csv]
2026-11-06 Each tray area carries its validation slot's band: Gallery column, tray-readings.csv, coloured map (#76) (#370)
    * Each tray reading carries its nearest validation slot's band, shown in the Gallery (#76)
    A tray takes the band of the slot whose centre is nearest its own (Aaron, 2026-11-05). With no
    band the reading says why: not validated, validation not consistent, validation not found, slot
    not measured. The Gallery table heads it 'Scale error at tray top (±%)' and notes that plant
    height adds about 0.15% per mm.
    * Export: tray-readings.csv, each tray's plant area with its slot's validation band (#76)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
    [certainty_map.py, exports.py, tray_placement.py]
2026-11-06 Plant area per cell from tray geometry: cells placed, stored, in the Gallery and the export (#364) (#374)
    * Cells placed from the tray outline and tag, plant measured per cell (#364)
    place_cells: 4x5 cells from A1 at the tag's corner (opening 59.5 mm, pitch 69.7 mm);
    2x2 pots from Aaron's 2026-11-06 measurements, named from the photo's south-west.
    measure_cells: each plant piece counts wholly for the cell holding most of it; a piece
    on the walls only counts for none.
    * Cells: mark leaves over other cells, name 2x2 cells from the tray's first photo (#364)
    measure_cells returns CellMeasure with over_other_cells: a piece counted for on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
    [27.2-dev-blue.csv, 27.2-prod-blue.csv, 27.3-dev-rim.csv, 27.3-prod-rim.csv]
2026-11-06 Export asks what goes in it (data, photos or both), checks free space, describes every column in datapackage.json (#65, #368) (#376)
    * Export asks what goes in it: data, photos or both; datapackage.json and README from export_fields.yaml (#65, #368)
    The Export button opens the page's own dialog with two tick boxes. Only an
    export holding the photos counts as complete for Purge. Every CSV column is
    described in src/npec_rig/export_fields.yaml (Frictionless Data Package),
    read at each export: written into the export as datapackage.json and used
    for the README's file list and column meanings. Migration 21 records the
    choice on each export.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
2026-11-06 Export in parts of at most 1 GB, each zipped while it downloads, nothing stored on the rig (#368) (#378)
    choice on each export.
    * Export dialog: expecte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
2026-11-07 Tray readings: search only the last 48 h for trays not found, an hour in the Gallery 4.3 s to 0.8 s (#381) (#383)
    The last_seen query in database.tray_readings walked every tray reading of the experiment for
    each photo (about 85 ms a photo on production's 2-week experiment 18, 86 to 95% of a Gallery
    hour). A tray last found more than NOT_SEEN_FOR (48 h) ago was skipped afterwards anyway, so
    the query now searches only that window, from 1 s before it (isoformat leaves out zero
    microseconds).
    Checked on a copy of production's rig.db and on one with trays removed for 6 h and 84 h:
    outputs identical for the 13:00 hour, 60 photos spread over the experiment and 60 late
    photos; the hour's 60 photo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
    [database.py]
2026-11-07 Wall fringe in the cells: metrology log 28 (#375) (#387)
    The green threshold finds the blue tray plastic along cell walls: about a third of
    empty cells read "plant", but a plant cell gains at most about 0.1 mm2 (90th
    percentile, 3792 pictures, both rigs). Five rules tried and scored; no rule added,
    since researchers report plants, not empty cells (Aaron, 2026-11-07).
    [E_and_A.csv, E_and_C.csv, blue_share_by_day.csv, floor100.csv, labels.csv, now.csv, results.csv]
2026-11-09 Light exclusions follow the camera: ramps from N-pad, lights off from the auto-exposure state, no norm (#382) (#388)
    * Record whether the auto-exposure had settled with each photo; light ramp rules compared (#382)
    Slice 1 of #382. Each photo's row gets the camera's auto-exposure state (libcamera AeState:
    idle, searching, converged) in a new capture column, ae_state (migration 24), and its JSON
    record also keeps DigitalGain and Lux. The light exclusions are not changed yet: whether the
    state marks the dark and the ramps is checked over one night on the development rig first
    (metrology log 29.3).
    Metrology log 29: why the first-day light norm failed on production, the corner tags tried as a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
    [camera.py, captures.py, database.py, exclusions.py]
2026-11-09 2 x 2 trays: Randomize reads which way a tray faces from the cell names' A1; where a tag lies on its tray (#385) (#393)
    - randomization.photo_layout takes the experiment and places a 2 x 2 tray's cells as the tray
    readings do (database.first_a1_bearing): "as first" when A1 lies towards the photo's south-west,
    "turned" towards the north-east. The tag-angle references kept at the first Suggest are gone.
    - Suggest reads its photo for cells first when the tray reader has not, so both start from the
    same photo.
    - tray_placement.tag_on_tray: the tray's centre and long side in the tag's own frame, the same
    however the tray is turned while the tag stays put. For the "tag moved" label that fo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
2026-11-09 Shuffle record: shuffles 7 to 12, and the whole-run check of the shuffles in metrology log 22.1 (#223) (#392)
    The collaborator's record of shuffles 7 to 12 is appended to
    experiments/round2-run/sessions/shuffle-record-2026-10-22.csv, and its README notes the CET
    label, the early starts and the long shuffle 11.
    Metrology log 22.1 repeats section 22's plan-against-rig check over the whole potato run, from
    two read-only copies of production's rig.db: slots 156 of 156, 209,001 of 209,012 readings,
    no move outside the shuffles, A1 corner 34,101 of 34,101 for maps 11 and 12 (not stored
    before, #391). measurement-trust.md gets one added line.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
    [shuffle-record-2026-10-22.csv]
2026-11-09 Round 2 steadiness with area: whole-run results of metrology log 16.9, with scripts (#223) (#396)
    * Shuffle record: shuffles 7 to 12, and the whole-run check of the shuffles in metrology log 22.1 (#223)
    before, #391). mea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
2026-11-09 Calibration names a corner tag its photo misses, page shows the tags inside the table edge (#349) (#397)
    A calibration whose full-size photo finds fewer than 4 corner tags is still saved (areas do not
    use the corner tags), and its result says "Corner tag {ID} cannot be seen in the {corner} corner
    of the table. Check that it is not missing or covered." The tag and its corner come from the
    preview, or with the override from the calibration it replaces. Step 4 and the report show it
    as a warning. Step 1's text and drawing show the tags on the table, inside its edge.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
    [calibration.py, calibration_run.py, tags.py, tripwire.py]
2026-11-09 Docs: corner tags inside the table edge on development, metrology log 31 (#349, part 2) (#398)
    * Docs: corner tags inside the table edge on development, metrology log 31 (#349)
    Metrology log 31: the move (2026-11-03 09:22 UTC, development only), the covered-tag check of
    #397 on the rig, and the method for the tray-to-tag distance, not yet run. The operator guide adds
    moving a corner tag to the reasons to recalibrate and asks to keep the tags uncovered; trays.md
    adds a keep-out rule without a number; measurement-trust notes that the tripwire evidence is from
    the old position. PLAN.md, GLOSSARY, README, database.md, the hardware docs and CLAUDE.md describe
    both rigs' positions.
    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
    [apriltag_corner_mount.scad]
2026-11-09 2 x 2 trays: a tag turned on its tray marks the tray's cell names as maybe swapped from that photo on (#385, part 2) (#399)
    * 2 x 2 trays: a tag turned on its tray marks the tray's cell names as maybe swapped from that photo on (#385)
    - tray_readings: a 2 x 2 tray whose tag's angle on the tray differs by more than 10 degrees from
    the photo that set its A1 is stored with the warning "tag turned on tray" (angle only: the
    tray centre seen from the tag moves by up to 22 mm with the outline, metrology log 31.2).
    - Shown from that photo on, for the rest of the experiment, whatever order the photos were read
    in: "names may be swapped since <time> UTC" among the tray's warnings (Gallery), and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
    [database.py, exports.py, tray_readings.py]
2026-11-10 About page: version, focus lock, validation date, uptime, from an (i) button on the bar (#390) (#403)
    * About page: template, (i) icon and rail button (#390)
    The page draws sections handed to it; no route yet, so the button leads
    to a 404 until the route lands in the next commit.
    * About page: GET /about and /api/about, facts read when asked (#390)
    Version (commit, date, branches pointing at it), schema, rig name, camera,
    AI accelerator, free disk, app and Pi start, running experiment, focus
    lock, calibration and validation dates. Cards come from about.sections(),
    so manuals and links are added there later.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
2026-11-10 Docs: close #349 out, keep-out test dropped, health check OK after the move, metrology log 31.3 and 31.4 (#349) (#405)
    No tray-to-tag distance is set: a calibration names any hidden corner tag, and the health check
    names it during an experiment. Development's health check read OK on the untouched table against
    the post-move calibration (2026-11-10). The level readout, the north/south line, the validation
    comparison and tape distances were not tested, with the reasons in 31.4.
2026-11-10 Plant mask reference set: 60 cells from both rigs checked by Aaron; random forest stopped for speed (metrology log 33) (#402) (#407)
    * Metrology log 33: pixel classifier method, written before any draft or training (#402)
    * Round 3 classifier: mask to ImageJ ROI zip and back, exact round trip, tested against ImageJ's measured areas (#402)
    * Metrology log 33: selection amended before any outline or training (#402)
    * Round 3 classifier: rule H draft cells from both rigs, amended selection, ImageJ zips and check sheets (#40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
    [check_2026-11-10_aaron.csv, manifest.csv, photos_manifest.csv, truth_index.csv]
2026-11-11 Plant area by grow from leaf cores beside the fixed green cutoff, per tray and cell, with a Leaf area method list in the Gallery (#363, part 1) (#409)
    * Metrology log 34: tuning grow from leaf cores, method written before any setting is tried (#363)
    * Grow from leaf cores: the method on one tray box, beside the fixed green cutoff (#363)
    * Grow from leaf cores draws the reference drafts of 6 cells exactly (#363)
    * rig.db version 25: grow from leaf cores columns on tray_reading and cell_reading (#363)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
    [combo_groups.csv, combo_scores.csv, combo_summary.csv, manifest_train.csv, oat_groups.csv, oat_scores.csv, oat_summary.csv, outlines.csv]
2026-11-13 Export: plant area per cell and per tray by both methods side by side, named as in the Gallery (#363, part 2) (#415)
    * Export: tray and cell readings carry grow from leaf cores beside the fixed green cutoff, described in the data package (#363, part 2)
    * Export: soil level and lower cutoff of grow from leaf cores rounded to 3 decimals, no float noise (#363, part 2)
    * Export: both methods side by side, named as in the Gallery, per cell and per tray; segmenter and cell_rule dropped; areas and scale error rounded to 0.1 (Aaron, 2026-11-11, option 1) (#363, part 2)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
    [exports.py]
2026-11-13 Metrology log 35: method for plant area against a Helios scan (#411, part 1) (#422)
    * Metrology log 35: method for plant area against a Helios scan, written before the scan (#411)
    * Metrology log 35: Helios is not truth; hand outlines on both cameras as the known answer, removal time from the tray tag (#411)
    * Metrology log 35: outline plan decided, order of outlines before any result (#411)
    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
